rcldesign/ntp-server-stm32/docs/gnss_antenna_bias_supervisor.md

# GNSS Active-Antenna Feed, Current Limiter & Antenna Supervisor

**Design documentation — operation, control signals, and parameters**

| | |
|---|---|
| **Subsystem** | Active GNSS antenna feed (bias-T), current-limited supply, and antenna-fault supervisor |
| **Host receiver** | u-blox ZED-F9T-00B (multi-band timing receiver) |
| **Host MCU** | STM32H563ZIT6 (LQFP144, U12) |
| **Antenna rail** | 5 V, 150 mA maximum |
| **Logic domain** | 3V3_GPS (F9T VCC_IO); comparators powered from 5V_LDO |

---

## 1. Overview

This subsystem powers an active (LNA-equipped) GNSS antenna over the same coaxial line that carries the received RF, protects the system against antenna/cable faults, and reports antenna health to both the GNSS receiver and the host MCU.

It performs four functions on one signal path:

1. **RF/DC combining (bias-T):** delivers DC bias to the antenna while passing the received GNSS RF through to the receiver.
2. **Current-limited 5 V supply:** feeds the antenna LNA with a hard foldback current limit, protecting the rail and antenna against a short.
3. **Antenna supervision:** detects *open* (no antenna), *normal*, and *short* conditions and drives the ZED-F9T's antenna-supervisor inputs.
4. **Commanded shutdown:** allows the receiver (and, indirectly, firmware) to switch antenna power off.

The supervisor uses **two independent fault paths** for defense in depth: the analog supervisor described here drives the F9T's ANT_DETECT / ANT_SHORT_N pins (surfaced over UBX-MON-RF), while a separate antenna-rail INA228 read by the STM32 over I²C provides a precise, digital current measurement. Firmware fuses the two (§9).

---

## 2. System Block Diagram

```
                          GPS_RF_IN  ──►  ZED-F9T RF_IN (U21.2) + L10 ESD + J7 SMA
                              ▲
                              │  (RF received signal)
                             L1  47 nH  ← bias-T choke (DC pass / RF block); 47 nH intentional
                              │
   V_ANT ──FB4──┬──[ Q11 ]────┴───────────────►  node A ──► antenna (RF + 5 V DC)
   (5 V)        │   PNP pass        (antenna DC feed point / Q11 collector)
                ├──[ R77 ]───┐
                │   3.3 Ω    │  current-limit foldback:  Q12 (PNP) + R76
                │  (sense)   │
                │            └──► INA181 current sense ──► U25A ──► GPS_ANT_DETECT ──► F9T pin 4
                │                  (across R77)            comparator
                │
              node A ──► R80/R81 divider ──► U25B comparator ──► GPS_ANT_SHORT ──► F9T pin 6

   F9T ANT_OFF (pin 5) / GPS_ANT_OFF_MON ──► Q14 (NPN) ──► Q13 (PNP) ──► forces Q11 base to V_ANT (antenna off)
                                                  │
                                                  └──► observed by STM32 PD4 (EXTI4)
```

Two physical domains coexist on the line: a **DC path** (V_ANT → current limiter → node A → L1 → antenna) and an **RF path** (antenna → GPS_RF_IN → receiver). L1 and C52 separate them. There is **no series DC-block** between the bias node and `RF_IN` — see §3.1.

**RF-input ESD:** `GPS_RF_IN` at the SMA (J7) is protected by **L10 = PGB1010603MR** (PulseGuard polymer suppressor, Cj ≈ 0.05 pF, standoff ~20–24 V) to GND — the correct low-Cj / high-standoff class for a line carrying both 1.5 GHz RF (Cj ≤ ~0.3 pF) and 5 V DC bias (V_RWM ≥ ~6.5 V). Outdoor cable runs still need an external inline coaxial gas-discharge arrestor.

---

## 3. RF/DC Combining (Bias-T)

| Ref | Value | Function |
|-----|---|---|
| L1 | **47 nH (intentional)** | Bias-T choke. Passes DC bias to the antenna; presents high impedance to GNSS RF so the signal stays on the line to the receiver. |
| C52 | 1 µF | DC-feed-node bypass; provides an AC return so RF does not enter the bias network. |
| FB4 | 120 Ω @ 100 MHz | Conditions the incoming V_ANT rail (suppresses conducted noise). |
| C61 | 0.1 µF | V_ANT local decoupling. |

The choke is the only series element between the antenna DC feed (node A) and the receiver RF input. At the GPS L1 band (1.575 GHz) the choke presents:

```
Z(47 nH) = 2πfL ≈ 2π × 1.575e9 × 47e-9 ≈ 465 Ω   (as-built, intentional)
```

> **L1 = 47 nH.** At 465 Ω the choke passes the ≤182 mA foldback bias current (part rated
> ≥ 300 mA > 182 mA, with saturation margin) while the board relies on the active foldback
> limiter (§4) rather than a fixed series resistor for isolation. The 465 Ω isolation is an
> accepted deviation from the u-blox ">500 Ω" bias-T guideline for this design.

The choke's saturation rating must exceed the ~180 mA current limit, and its DCR adds only a fraction of a volt of drop at the limit current (this drop is downstream of node A, so it affects the voltage delivered to the antenna but not the supervisor thresholds).

### 3.1 No series DC-block on RF_IN — bias is injected directly, per the u-blox reference

The ~5 V antenna bias is injected by L1 straight onto `GPS_RF_IN`, which is the same node as the
ZED-F9T `RF_IN` (U21.2), the SMA centre (J7.1), and the L10 ESD suppressor. **There is no series
DC-block capacitor between the bias node and RF_IN, and none is required** — the u-blox ZED-F9T
active-antenna reference circuits (Integration Manual UBX-21040375) inject the bias on the RF trace
and rely on the receiver's **internal DC block**, including where the bias comes from an external
supply above VCC.

```
as-built:   node A ── L1 47 nH ──┬── J7 SMA (antenna, biased)
                                 ├── U21.2 RF_IN   (internal DC block)
                                 └── L10 ESD
```

> **History — a 47 pF part (`C204`) was briefly fitted here and has been removed.** It had been
> added on the strength of a claim, carried in this repo's own `CLAUDE.md` open-items list, that the
> u-blox reference "places a 47 pF C0G series DC-block between the bias-T node and RF_IN". **That
> attribution was wrong** — UBX-21040375 shows no such block, and this same section originally said
> the opposite (that u-blox injects directly and relies on the internal block). Worse, as drawn the
> part landed in the **bias** leg (`node A → L1 → C204 → GPS_RF_IN`), which would have DC-blocked the
> antenna itself and left the open/short supervisor reading permanent *open*. The part is deleted and
> the claim is retracted; do not re-introduce it.

---

## 4. Antenna Power Supply & Current Limiting

The antenna is fed from the 5 V rail through a high-side PNP pass transistor with a transistor-based foldback current limiter.

| Ref | Part | Value | Function |
|-----|---|---|---|
| Q11 | NSS40300MZ4T1G | PNP power | High-side pass element delivering 5 V to the antenna. V_CEO 40 V, I_C(max) 3 A, P_D(max) 2 W, V_CE(sat) ≤ 400 mV @ I_C = 3 A. |
| Q12 | BC857W | PNP | Current-limit sense transistor. |
| R77 | — | 3.3 Ω | Current-sense / limit resistor in series with the antenna current. |
| R76 | — | 220 Ω | Q12 base path. |
| R73 | — | 2.2 kΩ | Q11 base drive. |

### How the limit works

R77 carries the full antenna current and develops a voltage proportional to it. Q12's base–emitter junction sits across R77; when the current produces approximately one V_BE across R77, Q12 turns on, diverts Q11's base drive, and folds the pass current back to a fixed ceiling:

```
I_limit ≈ V_BE(Q12) / R77 ≈ 0.6 V / 3.3 Ω ≈ 180 mA
```

This is set ~20 % above the 150 mA antenna maximum, giving operating headroom while still clamping well below any level that would stress the rail or a shorted cable. **The limit point is defined solely by R77** — changing it requires re-checking the supervisor thresholds in §6 and §8, which reference the same resistor and feed node.

In normal operation Q11 stays in saturation, so the DC drop from V_ANT to the antenna is small (R77 + V_CE(sat) ≈ a few hundred mV at full load). At the ≤180 mA operating range Q11 runs far below its 3 A / 2 W ratings, so its actual V_CE(sat) is well under the 400 mV datasheet figure (specified at 3 A) and self-heating is negligible. On a short, the limiter holds the current at ~180 mA and Q11 comes out of saturation, collapsing the feed-node voltage — the signature the supervisor uses to flag a short (§6.2).

---

## 5. Antenna Supervisor — Detection Principle

The supervisor must distinguish three states: **open** (no antenna / no current), **normal**, and **short** (over-current). Because the supply uses an *active* foldback limiter rather than a large passive series resistor, the antenna feed-node voltage alone cannot separate open from normal:

- With Q11 saturated, the feed node (node A) sits near 5 V whether the antenna draws 0 mA (open) or only a few mA (light-normal).
- Therefore **open vs. present must be decided by measuring current**, while **short is decided by feed-node collapse**.

The supervisor is built as two independent legs accordingly:

| Leg | Senses | Drives | Decides |
|-----|---|---|---|
| DETECT | Antenna current via INA181 across R77 | GPS_ANT_DETECT (F9T pin 4, active-high = present) | Open vs. present |
| SHORT | Feed-node (node A) voltage via divider | GPS_ANT_SHORT (F9T pin 6, active-low = short) | Short vs. ok |

### State table

| Condition | I through R77 | Node A | INA181 out | GPS_ANT_DETECT | GPS_ANT_SHORT |
|---|---|---|---|---|---|
| **Open** | ~0 mA | ~5 V | ~0 V | **low** (absent) | high (ok) |
| **Normal** | 5–150 mA | 4.3–5 V | 0.33 V → rail | **high** (present) | high (ok) |
| **Short** | ~180 mA (clamped) | ~0 V | railed high | high (present) | **low** (short) |

In the short state the limiter holds ~180 mA, so the DETECT leg still reads "present." This is intentional and unambiguous: the SHORT leg's low output is the signal the receiver acts on, and open vs. short is fully captured by the SHORT leg.

---

## 6. Supervisor Circuit Detail

### 6.1 DETECT leg (current sense)

| Ref | Part | Value | Function |
|-----|---|---|---|
| U24 | INA181A1IDBVR | gain 20 | High-side current-sense amp across R77. V+ = 3V3_GPS; IN+ = V_ANT (upstream) side of R77; IN− = load side; REF = GND (unidirectional). |
| C28 | — | 0.1 µF | U24 decoupling. <!-- TODO verify designator: C28 — one of the three 3V3_GPS 0.1µF decouplers C54/C55/C56; flat netlist can't disambiguate role --> |
| U25A | ½ LMV393 | — | DETECT comparator: +in = U24 OUT, −in = reference. Open-collector output. |
| R85 / R86 | — | 100 k / 11 k | DETECT reference divider from 3V3_GPS → **0.327 V**. |
| C29 | — | 0.1 µF | Reference / supply decoupling. <!-- TODO verify designator: C29 — one of the three 3V3_GPS 0.1µF decouplers C54/C55/C56 --> |
| R87 | — | 10 kΩ | Open-collector pull-up to 3V3_GPS → GPS_ANT_DETECT. |

**Transfer function:** `V_out = gain × I × R77 = 20 × I × 3.3 = 66 V/A`.

- **Threshold:** 0.327 V ÷ 66 V/A ≈ **5 mA**. DETECT asserts (high) for any antenna drawing ≥ ~5 mA — above idle leakage, below any real active antenna's draw.
- **Linear range:** U24's output rails at ~3.0 V (≈ 45 mA); above this it simply stays high, which is fine because this leg only decides present/absent. Precision current is provided separately by the INA228 (§9).
- **Gain choice:** gain 20 (the INA181**A1**) keeps the threshold linear with margin; the gain-100 A3 variant would rail at ~9 mA, leaving no usable range.
- **Polarity:** present → U24 OUT > ref → output high-Z → R87 pulls to 3.3 V → DETECT high. Absent → output sinks → DETECT low. Matches the F9T (active-high = present).

### 6.2 SHORT leg (feed-node collapse)

| Ref | Part | Value | Function |
|-----|---|---|---|
| U25B | ½ LMV393 | — | SHORT comparator: +in = node A ÷ 2, −in = reference. Open-collector output. |
| R80 / R81 | — | 100 k / 100 k | Node-A divider → node A ÷ 2 (draws ~25 µA — negligible vs. antenna current). |
| R82 / R83 | — | 100 k / 30 k | SHORT reference divider from 3V3_GPS → **0.762 V**. |
| C30 | — | 0.1 µF | Reference / supply decoupling. <!-- TODO verify designator: C30 — one of the three 3V3_GPS 0.1µF decouplers C54/C55/C56 --> |
| R84 | — | 10 kΩ | Open-collector pull-up to 3V3_GPS → GPS_ANT_SHORT. |

**Threshold:** node A ÷ 2 is compared to 0.762 V, so SHORT asserts when **node A < ~1.52 V**. Normal node A is 4.3–5 V (÷2 = 2.1–2.5 V, above ref → released); a short pulls node A to ~0 V → asserted.

**Polarity:** +in = node A ÷ 2, −in = ref. Normal → +in > ref → high-Z → SHORT_N high (ok). Short → +in < ref → output sinks → SHORT_N low (fault). Matches the F9T (active-low = short).

### 6.3 Comparator supply & level shifting

| Ref | Part | Value | Function |
|-----|---|---|---|
| U25C | LMV393 (power-pin unit of the dual) | — | V+ = 5V_LDO, V− = GND. |
| C31 | — | 0.1 µF | LMV393 supply decoupling. <!-- TODO verify designator: C31 — one of the two 5V (U25C V+) 0.1µF decouplers C57/C58 --> |

The LMV393 is powered from **+5 V** (not 3.3 V) so its input common-mode range (0 to V+ − 1.5 V ≈ 0–3.5 V) spans every supervisor input: U24 OUT (0–3.0 V), node A ÷ 2 (0–2.5 V), and both references (≤0.76 V).

Both comparator outputs are **open-collector, pulled up to 3V3_GPS**. This pull-up is the level shift from the 5 V analog domain to the F9T 3.3 V logic domain. It is also inherently fail-safe: when 3V3_GPS is off, the lines are simply undriven, so the F9T's input pins are never back-driven from the 5 V side. This follows u-blox's guidance to use open-drain buffering whenever the antenna voltage (5 V) exceeds the receiver IO voltage (3.3 V).

---

## 7. Antenna-Disable Control (ANT_OFF)

The F9T's ANT_OFF pin (5) is an **output that goes high to command the antenna off**. Disabling a high-side PNP requires pulling Q11's base **up to V_ANT** (its emitter), so a two-stage inverting/high-side driver is used.

| Ref | Part | Value/role | Connection |
|-----|---|---|---|
| Q14 | BC847W (NPN) | Level shift / invert | E→GND; B← ANT_OFF via R79; C→ Q13 base via R75. |
| Q13 | BC857W (PNP) | High-side disable switch | E→V_ANT; C→ Q11 base node (where R73 lands); B← R75 and R74. |

> **Q13 orientation** (BC857W, SOT-323: 1=B, 2=E, 3=C): `Q13.2(E) → V_ANT`,
> `Q13.3(C) → Net-(Q11-B)`. On `ANT_OFF` high, Q14 pulls Q13's base low via R75 → the PNP
> (E = V_ANT) turns on → its collector sources into Q11's base, raising it to ~V_ANT → pass
> PNP Q11 turns off → antenna bias removed. Bench-verify: on assert of ANT_OFF, scope node A
> and confirm it collapses to ~0 V.
| R79 | 10 kΩ | ANT_OFF → Q14 base. |
| R75 | 4.7 kΩ | Q14 collector → Q13 base (drive limit). |
| R74 | 10 kΩ | Q13 base → V_ANT (holds Q13 off when Q14 is off). |
| R78 | 100 kΩ | Q14 base → GND — sets the default state when the ANT_OFF line is undriven (see below). |

**Behavior:**

- ANT_OFF **high** → Q14 on → Q13 base pulled low (~0.8 mA via R74) → Q13 on → Q11 base tied to V_ANT → **Q11 off, antenna unpowered.**
- ANT_OFF **low** → Q14 off → Q13 off (held by R74) → **Q11 runs normally.** Q13 easily overrides R73's 2.2 kΩ to hold Q11 off when commanded.
- ANT_OFF **undriven** (F9T unpowered / pin hi-Z) → R78 holds Q14 off → Q13 off → **antenna defaults on.** This matters because V_ANT can remain up while the F9T is power-cycled; defaulting the antenna *on* preserves a fast warm restart. (To default *off* instead, R78 would pull high — but that rail is also down during an F9T cycle, so the GND default is the practical choice.)

Because the only connection to the F9T pin is Q14's base through R79, the 5 V rail never reaches the receiver pin.

**Shared monitoring net:** the ANT_OFF line is also the `GPS_ANT_OFF_MON` net observed by the STM32 on **PD4 (EXTI4)**, letting firmware see when the antenna has been commanded off. PD4 is configured **input-only** (the F9T drives this net push-pull; an output on PD4 would contend with it).

---

## 8. Control & Status Signals + Operating Parameters

### 8.1 Signal interface

| Net | Direction | Domain | Meaning |
|-----|---|---|---|
| GPS_ANT_DETECT → F9T pin 4 | supervisor → F9T | 3.3 V, open-collector + pull-up | High = antenna present (I ≥ ~5 mA). |
| GPS_ANT_SHORT → F9T pin 6 | supervisor → F9T | 3.3 V, open-collector + pull-up | Low = antenna short (node A < ~1.5 V). |
| ANT_OFF / GPS_ANT_OFF_MON ← F9T pin 5 | F9T → supervisor; also → MCU PD4 | 3.3 V push-pull | High = command antenna off. |
| V_ANT | rail input | 5 V | Antenna supply rail. |
| GPS_RF_IN | RF | — | Combined RF to receiver. |

### 8.2 Operating parameters

| Parameter | Value | Set/limited by |
|---|---|---|
| Antenna supply voltage | 5 V | V_ANT rail |
| Antenna operating current (max) | 150 mA | Antenna spec |
| Current limit (foldback) | ~180 mA | R77 (3.3 Ω) + Q12 V_BE |
| DETECT (antenna-present) threshold | ~5 mA | R85/R86 → 0.327 V, ÷ 66 V/A |
| SHORT threshold | node A < ~1.5 V | R80/R81 ÷2 vs. R82/R83 → 0.762 V |
| Current-sense linear ceiling | ~45 mA | INA181A1 gain 20 on 3.3 V (present/absent only) |
| Bias-T choke impedance @ 1.575 GHz | ~465 Ω | L1 = 47 nH (intentional) |
| Supervisor logic level | 3.3 V | 3V3_GPS pull-ups |
| Comparator supply | 5 V | 5V_LDO |

Tolerance: the dividers are 1 % resistors feeding an LMV393 (few-mV offset) and an INA181A1 (low offset, ~±1 % gain error). The DETECT threshold (5 mA) has wide margin against any real antenna (≥ ~10 mA); the SHORT threshold (1.5 V) sits far from both normal (≥ 4.3 V) and fault (~0 V), so hysteresis is not required for clean switching.

---

## 9. ZED-F9T & STM32 Integration

### 9.1 Pin map

| F9T pin | Signal | Dir (F9T) | Net |
|---|---|---|-----|
| 4 | ANT_DETECT | input | GPS_ANT_DETECT (U25A) |
| 5 | ANT_OFF | output | ANT_OFF / GPS_ANT_OFF_MON |
| 6 | ANT_SHORT_N | input | GPS_ANT_SHORT (U25B) |

| STM32 pin | Net | Role |
|---|-----|---|
| PD4 (EXTI4) | GPS_ANT_OFF_MON | Observes LNA-disable / commanded-off state. Input-only. |
| PC9 | ANT_BIAS_EN | Antenna-bias enable (→ U27 RT9742 EN); dropped on persistent short. |
| PC8 | GPS_PWR_EN | Gates F9T VCC (→ U22 LT3045 EN). |
| PF15 | BKP_GPS_PG | Power-good of the GPS backup rail `GPS_VBAT` (U34 TPS61094 + supercap, feeds F9T V_BCKP). |
| I²C1 (PB8/PB9) | — | Antenna-rail INA228 **U26 @0x45** (precision V/I/P across **R89 150 mΩ**; ±273.1 mA FS, 520.833 nA/LSB). |

> **INA228 addresses:** the *antenna-bias* rail is monitored by **U26 @0x45** (precise
> antenna current, **R89 150 mΩ** shunt — the 182 mA foldback ceiling lands at 27.3 mV = 67 % of the
> ±40.96 mV ADCRANGE=1 full scale). The *GPS VCC* rail (3V3_GPS) is a **separate** INA228,
> **U23 @0x4A** (shunt across **R72 75 mΩ**). U23 is strapped 0x4A because **0x44 is owned by the
> SHT45 humidity sensor (U72)** on the same I²C1 bus; 0x4A avoids that collision.

### 9.2 Antenna-state fusion

Firmware determines antenna state by fusing three independent sources:

1. **UBX-MON-RF** from the F9T (driven by the analog supervisor in this document).
2. **GPS_ANT_OFF_MON (PD4)** — whether the antenna is currently commanded off.
3. **Antenna-rail INA228 U26 (0x45)** over I²C — precise current (**R89 150 mΩ**, 520.833 nA/LSB → ~0.3 % resolution at the 182 mA ceiling) → OK / open / short. Because the R77 foldback clamps at ≈182 mA *before* an over-current alert would be meaningful, use an INA228 **under**-current (`SUVL`) threshold to detect "open" and reserve `SOVL` (227 mA) as a foldback-failure backstop.

On a **persistent** short, firmware drops `ANT_BIAS_EN (PC9)` and raises an alarm (SNMP trap, log entry, GUI indication). The redundancy ensures a single-source transient does not by itself trigger a shutdown, and gives the operator a precise current reading for diagnostics.

### 9.3 Commanded-off fault masking (firmware requirement)

When ANT_OFF is asserted (by the F9T or by firmware via ANT_BIAS_EN), Q11 turns off, node A collapses, and antenna current goes to zero — so **the analog supervisor reports SHORT (low) and DETECT (absent) even though nothing is faulty.** The F9T masks its own internal flags while it holds ANT_OFF; the firmware fusion logic must likewise **gate the SHORT/OPEN flags on the commanded-off state (PD4 / ANT_BIAS_EN)** to avoid logging phantom shorts on every commanded antenna cycle.

### 9.4 Backup-domain interaction

V_BCKP (F9T pin 36) stays powered across GPS VCC power-cycles for warm start. V_ANT is on the STM32-gated antenna rail, independent of the F9T VCC switch, so the antenna can remain powered while the F9T is cycled — which is why the ANT_OFF stage defaults the antenna *on* when the receiver pin is undriven (§7).

---

## 10. Design Rationale & Constraints

**Why an active foldback limiter (Q12/Q11) rather than a passive series resistor.** Lower dropout and a well-defined current limit independent of antenna impedance. The trade-off is that the feed-node voltage no longer separates open from normal, which is why the DETECT decision is made by current sensing (§5).

**Why split detection (current for open, feed-node for short).** Each fault has a clean, well-separated signature in exactly one domain. A single window comparator on the feed node would fail to detect open, and a single current threshold cannot cleanly distinguish high-normal from the clamped short current.

**Why INA181A1 (gain 20).** It keeps the present/absent threshold in the amplifier's linear range with margin; the precise current measurement is delegated to the INA228, so this leg needs only coarse presence detection.

**Why open-collector outputs to 3.3 V.** A single-resistor level shift from the 5 V analog domain to F9T logic, inherently fail-safe (lines undriven when receiver IO is off), and aligned with u-blox's open-drain recommendation for antenna voltage > IO voltage.

**Why the LMV393 runs on 5 V.** To give input common-mode headroom across all supervisor signals; the open-collector outputs still serve the 3.3 V logic domain cleanly.

**Why a discrete ANT_OFF stage (BC847W + BC857W).** Keeps the F9T pin isolated from the 5 V rail, uses a small-signal transistor pair common across the board, and sets a defined default state with one resistor (R78).

**Why dual-path supervision (analog + INA228).** Defense in depth — no single glitch trips a shutdown — plus a precise digital current value for telemetry and diagnostics.

**Why the GPS-VCC INA228 (U23) is at 0x4A, not 0x44.** The SHT45 humidity sensor (U72)
occupies 0x44 on the same I²C1 bus; 0x4A keeps the GPS-VCC monitor collision-free.

### Engineering constraints to honor at layout/BOM

- **R77** dissipates ~130 mW at the ~180 mA limit; specify 0805, 1 %, ≥0.25 W.
- **INA181 input orientation** is critical: IN+ on the V_ANT/FB4 (upstream) side of R77, IN− on the load side, current flowing + → −. With REF = GND the device is unidirectional, so reversed inputs read zero.
- **PD4** must remain input-only in firmware (shared with the F9T's push-pull ANT_OFF driver).
- If a real short produces a slow node-A collapse, light hysteresis (a few-MΩ feedback resistor on U25B) can be added; with the limiter's fast action this is normally unnecessary.

---

## 11. Bill of Materials

**Bias-T & RF/DC combining**

| Ref | Part | Value |
|-----|---|---|
| L1 | RF choke | **47 nH (intentional — see §3); rated ≥ 300 mA > 182 mA foldback** |
| C52 | capacitor | 1 µF |
| FB4 | ferrite bead | 120 Ω @ 100 MHz |
| C61 | capacitor | 0.1 µF |
| L10 | PGB1010603MR | PulseGuard polymer ESD suppressor on `GPS_RF_IN` at J7 (low-Cj, high-standoff) |

**Antenna supply & current limit**

| Ref | Part | Value |
|-----|---|---|
| Q11 | NSS40300MZ4T1G | PNP power pass transistor (40 V, 3 A, 2 W) |
| Q12 | BC857W | PNP sense transistor |
| R77 | resistor | 3.3 Ω, 1 %, ≥0.25 W (0805) |
| R76 | resistor | 220 Ω |
| R73 | resistor | 2.2 kΩ |

**Supervisor**

| Ref | Part | Value |
|-----|---|---|
| U24 | INA181A1IDBVR | gain 20 current-sense amp |
| U25 | LMV393 | dual comparator (U25A DETECT, U25B SHORT, U25C power) |
| R85 / R86 | resistors | 100 k / 11 k (DETECT ref, 0.33 V) |
| R80 / R81 | resistors | 100 k / 100 k (node-A ÷2) |
| R82 / R83 | resistors | 100 k / 30 k (SHORT ref, 0.76 V) |
| R84 | resistor | 10 k (SHORT pull-up → 3V3_GPS) |
| R87 | resistor | 10 k (DETECT pull-up → 3V3_GPS) |
| C28–C31 | capacitors | 0.1 µF (decoupling) <!-- TODO verify designator: C28-C31 — bank is C54/C55/C56 on 3V3_GPS + C57/C58 on 5V (U25C V+); exact role-to-ref mapping not resolvable from flat netlist --> |

**Precision current monitoring (I²C)**

| Ref | Part | Value / note |
|-----|---|---|
| U26 | INA228 | Antenna-bias current/voltage monitor, **I²C1 @0x45**; shunt = R89. |
| R89 | resistor | **150 mΩ** antenna-current shunt, Vishay WSL1206R1500FEA 1 % 1206 (U26 IN+/IN−; **±273.1 mA FS**, 520.833 nA/LSB, 5.0 mW at foldback). |
| U23 | INA228 | GPS-VCC (3V3_GPS) monitor, **I²C1 @0x4A** (not 0x44 — SHT45 U72 owns 0x44); shunt = **R72 75 mΩ** (WSL1206R0750FEA), ±546.1 mA FS. |

**ANT_OFF disable stage**

| Ref | Part | Value |
|-----|---|---|
| Q14 | BC847W | NPN |
| Q13 | BC857W | PNP high-side disable (E=V_ANT, C=Q11 base node; see §7) |
| R79 | resistor | 10 k (ANT_OFF → Q14 base) |
| R75 | resistor | 4.7 k (Q14 collector → Q13 base) |
| R74 | resistor | 10 k (Q13 base → V_ANT) |
| R78 | resistor | 100 k (Q14 base → GND, default state) |
