rcldesign/ntp-server-stm32/docs/sts1000_layout_readiness_review.md

# STS1000 "Meridian" — Schematic-to-Layout Readiness Review

> ⚠️ **HISTORICAL SNAPSHOT (2026-06-21) — largely superseded.** This review predates the
> **STM32H563VIT6/LQFP100 → STM32H563ZIT6/LQFP144** migration, the 2026-07-05 overhaul, and the
> 2026-07-26 BOM/value pass. References here to U12 as VIT6/LQFP100, the MCP23017 expanders, GPS
> INA228 @0x44, 8× INA228, the board-wide INA228 SDA/SCL swap, and the BOOT0 1:1 divider describe
> the **June state** and are retained as a point-in-time record. **Do not "fix docs" against this
> file.**
>
> **Status of the 68 original blockers as of 2026-07-26:**
> - **RESOLVED:** board-wide INA228 SDA/SCL swap; U37/U44 address collision; BOOT0 (now a single
>   R50 10 k pull-down, no divider); GPS INA228 re-strapped to 0x4A; MCP23017 expanders deleted
>   (all aggregated inputs on direct GPIO); the ninth INA228 (U54, panel-LED @0x4C) added; **all
>   nine INA228 shunt values finalized**; every BOM line now carries an orderable manufacturer PN
>   *and* a DigiKey PN; capacitor package/dielectric selects closed (C98/C99/C101/C37 → C0G 1210,
>   C1/C42/C186 → 1812 2 kV, C125–C128 → 50 V); `3V0_RF_LDO_PG` pull-up R266 fitted; **footprints
>   *fields* populated board-wide — but with vendor package text, not land-pattern links (see below)**.
> - **STILL OPEN:** **`fp-lib-table` is missing** from the KiCad project (custom footprints in
>   `hardware/libraries/` are unreachable from the board editor — this still blocks opening the
>   PCB); and the **Footprint property is not a land-pattern link on most parts** — only 25 of 648
>   symbols carry a resolvable `library:footprint`, 587 hold vendor package text, 36 are empty.
> - **NEW since this review:** GPS RF DC-block **C204 is on the wrong side** (bias leg instead of
>   receiver leg); **R77** 0402/0.1 W dissipates 109 mW at the antenna foldback clamp; **R20/R2/R264**
>   0402 parts see 51–55 V against a 50 V element rating.
>
> For the current defect list see **`sts1000_schematic_design_review.md §1`**; for the current
> pin/net facts see **`ntp_server_peripheral_map.md`** and **`sts1000_firmware_hardware_interface.md`**;
> for shunt sizing and firmware constants see **`sts1000_hardware_design_reference.md §2.1`**.

_Multi-agent review. Goal: readiness for PCB layout handoff — NOT fabrication. Verify findings against datasheets/files before acting._

> Generated by 20 per-sheet agents + 5 cross-cutting agents. Confidence levels are per-finding; treat Low/Unknown items as requiring human confirmation.

## 1–2. Design intent & project inventory

## STS1000 "Meridian" — Design-Intent Summary & Project Inventory (pre-layout readiness, board-level)

Scope: whole-board design intent extracted from `/docs` + root/hardware `CLAUDE.md`, cross-checked against the KiCad project files present on disk. This is the orientation block for per-block reviews; it is NOT itself a netlist/datasheet verification of any part. Designators below are as the docs assign them; several still carry `<!-- TODO verify designator -->` markers in the docs (flagged).

---

### 1) Design-intent table

| Area | Intended behavior / requirement | Source doc | Evidence | Related blocks/nets | Status |
|---|---|---|---|---|---|
| Product purpose | GPS-disciplined Stratum-1 NTP/NTS/PTP grandmaster, single-board, PoE-powered | root `CLAUDE.md`; `software_spec §1` | "GPS-disciplined Stratum-1 NTP/NTS/PTP grandmaster clock" | whole board | PASS (intent) |
| Operating modes | Boot on OCXO (mux A); switch to Rb (mux B) only when EXTREF_MON in-band AND RB_LOCK asserted; revert fail-safe; holdover; warm-up gating before advertising S1 | `periph §2.1, §15.5`; `software_spec §3.4/§3.5` | "Switch OCXO→Rb only when both #2 and #3 hold"; firmware HSI-bridge + CSS | MUX_SEL PB6, EXTREF_MON PB14, RB_LOCK PB13, OSC_IN PH0 | PASS (intent) |
| Power input — PoE bt | 802.3bt-capable front end; classify Type 2 (at, ~25.5 W) min, Type 3 (bt) for margin; Rb is permanent and concurrent | `periph §6`; `hardware CLAUDE.md` | OCXO+Rb steady ~12–14 W, peak ~25–30 W; Class 3 (~13 W) insufficient | U7/U8 FDMQ8205A, U9 NCP1095, magjack J1 | PASS (intent); classification = config open item |
| Power rails | 3V3 main + 5V intermediate from bucks; OCXO fixed low-noise rail (always on); Rb adjustable buck (5–24 V, EN-gated); 5V_DISP gated; all housekeeping on always-on 3V3_STM (gated 3V3_P eliminated) | `periph §6`; `net_naming` | rename table; "3V3_P rail was removed" | U28/U29, U38/U39, U40A, U33, all I²C devices | PASS (intent) |
| Comms interfaces | Ethernet RMII (AF11) + 1588 HW timestamp; USART3 GPS; UART4 RTCM; UART7 Rb; SPI4 (NOR+TFT+digipot); I²C1 housekeeping; USB-FS CDC console | `periph §1,§3,§5,§10`; `software_spec §2` | pin tables per bus | U11, U21, U43/U62/TFT, I²C bus | PASS (intent) |
| Connectors | RJ45 magjack (J1), USB-FS (J5), DE-9 FE-5680A housekeeping (J6), 3× coax SMA (J7/J8/J9: 10 MHz-in, GPS-ant, 10 MHz bench-out), pin headers J2/J3/J4/J10/J11 | `bom §J`; BOM CSV L214–224 | CSV: J1 Bel 0826-1X1T, J5 USB4120-03-C, J6 DE9, J7/8/9 Conn_Coaxial | connectors.kicad_sch | WARNING — J2/J4/J7/8/9/J10/J11 footprints still generic/SELECT |
| Sensors | 8× INA228, 2× TMP117, IIS2MDC + LIS2DH12 e-compass, PIR (PaPIRs), FT6336U touch, fan tach | `periph §4,§8`; checklist §11–13 | INA map; e-compass note | I²C1 bus, U54/U55 | PASS (intent); LIS2DH12 SA0, PIR PN open |
| Timing ref — OCXO | OH300-61003CV-010.0M, 10 MHz, always on, DAC1_OUT1 (PA4)→loop filter→Vc center 1.65 V, Vc sense PA3; Vc caps C0G/film never X7R | `periph §2`; checklist §2 | "Vc must be biased to ~1.65 V"; "C0G/NP0 or film — never X7R" | Y3, U38/U39, R123 22Ω, U37 INA228#5 | PASS (intent) |
| Timing ref — Rb | External FE-5680A only (no onboard Rb); 10 MHz over coax→SMA front end; power/serial/lock/PPS on DE-9; adjustable buck, RB_PWR_EN gate | `periph §2.2,§15`; `vcc_rb_supply` | "There is no onboard Rb option"; "10 MHz does NOT enter this connector" | U40A, U43, U41A OV latch, J6, J7 SMA | PASS (intent); FE-5680A variant pinout open |
| Timing ref — GNSS | ZED-F9T-00B, USART3, TIMEPULSE→PA0/TIM2, TIMEPULSE2→PC6/TIM3, full reset/safeboot/dsel; V_BCKP held through VCC cycles | `periph §3`; checklist §6 | F9T pin table | U21, U22 LDO, U23 INA228#3 | PASS (intent) |
| Isolation / safety | Autonomous 26 V Rb OV latch (LMV393 + BJT, MCU-independent); POE_KILL board cold-cycle; external windowed WDT→POE_KILL; digital isolator on PoE status only-if isolated PD (open) | `periph §6,§9`; `vcc_rb_supply`; `external_wdt` | "trips at 26 V…no MCU action"; WDT→POE_KILL | U41A, U64 TPS3430, PE15 | PASS (intent); NCL/NCM/LCF isolation open |
| Environmental | −40/+85 °C MCU; consumer −40/+85 parts checked vs enclosure thermal; supercap ≤~75 °C placement; fan thermal loop fail-safe to full speed | root `CLAUDE.md`; `periph §8`; checklist §10 | "floating FAN_PWM defaults to maximum airflow" | DSF305Q3R0, TMP117 ×2, fan | PASS (intent); LIS2DH12/supercap thermal = layout-verify |
| Debug / programming / secure boot | SWD (PA13/14/PB3) + NRST; USB CDC-ACM driverless console + SMP recovery; STiRoT→MCUboot→app; ATECC608B (0x60) for keys/NTS | `periph §10`; `software_spec §1.1` | "STiRoT (immutable ST root)…ATECC608B" | U12, U60, J5 USB | PASS (intent) |
| Mechanical | Single board, enclosure deploy ("Observatory at Williams Manor"); e-compass at board edge/external puck; vertical display mount | root `CLAUDE.md`; `periph §4 note` | e-compass keep-out + mount note | IIS2MDC, MSP4030 | UNKNOWN — no mechanical/enclosure doc in /docs |
| Layout-sensitive circuits | OCXO Vc path, Rb FB node, IIS2MDC GND pour, GPS SMA ESD (RF+bias), source termination at driver, RF island | `hardware CLAUDE.md §Layout-critical` | full rule list | see §3 below | PASS (rules captured); execution = layout |
| Expected connector pinouts | FE-5680A DE-9 (J6) power/serial/lock/PPS only — varies by surplus variant, verify before layout; SMA = 10 MHz only | `periph §2.2,§14`; checklist §14 | "FE-5680A connector pinouts vary by variant" | J6, J7 | WARNING — variant pinout unresolved |
| Test points | ETH_PPS_OUT (PB5) scope tap; 10 MHz bench fanout SMA (J9); USB console | `periph §1,§2.1,§8`; checklist §16 | "PTP pulse output — verification/scope tap" | PB5, U53, J9 | PASS (intent) |
| Known risks | Back-power via I²C ESD clamps (fixed by 3V3_STM), glitch-free mux hang on dead Rb (fixed by selector+HSI bridge), Rb digipot in FB node, GPS SMA dual-duty ESD | root `CLAUDE.md §gotchas` | enumerated gotchas | I²C bus, U52, U43, GPS SMA | PASS (documented) |

---

### 2) Project inventory

#### ICs by subsystem (per checklist + hardware CLAUDE.md; designators as-doc, some TODO-flagged)

| Subsystem | Designators / parts |
|---|---|
| MCU & core | U12 STM32H563VIT6 (LQFP100); U64 TPS3430 window WDT; U13 LT3045 VDDA LDO; U14 MCP1502-33 ref; Y2 32.768 kHz LSE |
| OCXO + supply | Y3 OH300-61003CV-010.0M; U38 AP3441 buck; U39 TPS7A52 LDO; U36 OPA320 Vc buf; U37 INA228 #5 (0x46) |
| Clock mux | U52 74LVC1G157GW-Q100H; U53 74LVC1G34GW-Q100 buffer |
| RF front end | U49 TMUX1101; U50 LTC6752xS5 slicer; U51 LT3045 (3.0 V island) |
| Rb buck (VCC_RB) | U40A MIC28516; U43 MCP41U83T-503E/ST digipot; U42 OPA320; U45 MCP1502-40 (4.096 V); U41A LMV393 OV latch; U44 INA228 #6 (0x47) |
| FE-5680A serial | U46 SN65C3221E; K1 G6K-2F-Y DC3 relay; U48 APC-817C1 opto; U47 PESD15VL2BT |
| GNSS | U21 ZED-F9T-00B; U22 LT3045 GPS LDO; U23 INA228 #3 (0x44) |
| Antenna bias/supervisor | U24 INA181A1; U25 LMV393; Q11/Q12/Q14; U26 INA228 #4 (0x45) |
| Ethernet / PTP | U11 LAN8742AI-CZ-TR; Y1 25 MHz xtal; J1 magjack |
| PoE + power tree | U7/U8 FDMQ8205A bridge; U9 NCP1095 PD; U28 MIC28516 / U29 AP3441 (3V3); U10 INA228 #1 (0x40); U31 #2 (0x41); U30 #8 (0x43) |
| Supercap backup | U34/U35 TPS61094 ×2; DSF305Q3R0 supercaps |
| I²C housekeeping | U56 LTC4311ISC6; U57/U58 TMP117 ×2 (0x48/0x49); U60 ATECC608B (0x60); U61 IIS2MDC (0x1E); U59 LIS2DH12 (0x18/0x19) |
| Fault/UI aggregation | U55 MCP23017 (0x20, MIRROR=1); U54 MCP23017 (0x21, MIRROR=0) |
| Display/touch | LCDwiki MSP4030 (ST7796S + FT6336U 0x38); U33 RT9742; U63 PCA9306; U32 INA228 #7 (0x42); ESD: TPD4E05U06DQAR (U17/U18), TPD4E02B04 (U15/U16/U19/U20) |
| SPI4 | U62 SPI NOR (Macronix/Winbond/ISSI — NOT GigaDevice); ST7796 TFT; U43 digipot |

#### Connectors (BOM CSV L214–224)
J1 RJ45 PoE magjack (Bel 0826-1X1T-HS-F); J2 1×4 hdr (SELECT); J3 1×6 hdr (GCT BG055); J4 1×14 hdr (SELECT); J5 USB-FS (GCT USB4120-03-C); J6 DE-9 socket FE-5680A housekeeping (SELECT); J7/J8/J9 coaxial SMA — 10 MHz-in / GPS-ant / 10 MHz bench-out (SELECT); J10 1×2 (SELECT); J11 1×8 (SELECT).

#### Power rails (net_naming + periph §6)
3V3, 3V3_STM (always-on housekeeping), 3V3_STM_USB, 3V3_CLK, 3V3_GPS, 3V3_LAN, 3V0_RF (island), 5V (intermediate), 5V_DISP (gated, RT9742), VCC_RB (adjustable 5–24 V), V_ANT, V_POE, VDDA, VREF_4V096, GPS_VBAT, STM_VBAT, OCXO_V/OCXO_VC. Eliminated: 3V3_P.

#### Interfaces
RMII (AF11) + 1588; USART3 (GPS); UART4 (RTCM); UART7 (Rb, PB4/PE7); SPI4 (PE11–14 + PD2/PE9/PE10 CS/RST); I²C1 (PB8/PB9, 400 kHz, LTC4311); USB-FS CDC-ACM; SWD/SWO.

#### Critical nets
OSC_IN (PH0), OCXO_VC (PA4 DAC/PA3 sense), MUX_SEL (PB6), EXTREF_MON (PB14), RB_LOCK (PB13), RB_PWR_EN (PB7), GPS PPS (PA0/TIM2), TIMEPULSE2 (PC6/TIM3), ETH_PPS_OUT (PB5), INA_ALERT_INT_N (PC12), PG_INT_N (PA10), BTN_INT_N (PE0), EXP_RST_N (PC0), POE_KILL (PE15), RB_OV_DET (PE3)/RB_OV_RESET (PD3), 10MHz_RF_IN/RF_OUT.

#### Custom symbols (`hardware/libraries/*.kicad_sym`)
STM32H563VIT6, ZED-F9T-00B, LAN8742AI-CZ-TR, 74LVC1G157GW-Q100H, INA228AQDGSRQ1, INA181A1/A3IDBVR, IIS2MDCTR, LIS2DH12TR, LTC4311ISC6, OPA320AIDBVT, PCA9306DCTT, SN65C3221EPWR, TPD4E02B04DQAR, TPD4E05U06DQAR, TPS61094DSSR, TPS7A5201QRGRRQ1, AD5270/AD5292 (digipots — note doc says MCP41U83), ADCLK925BCPZ, ARJ-199, PGB1010603MR (new, untracked), ntp-server-stm32 (project sym).

#### Custom footprints (`hardware/libraries/*.kicad_mod`)
LQFP-100_STM, MODULE_ZED-F9T-00B, LGA-12_STM family (e-compass), QFN50P400X400X100-25N, VSSOP10_DGS_TEX (INA228), SC-74/SOT-6/DBV/DCT8/DQA0010A (small logic/ESD), CP_16_3_ADI / RM_10_ADI / RU-14_ADI (digipot/ADI), RGR20_TEX, SON50P/SOP65P, GCT_USB4120-03-C, ABRACON_ARJ-199, IND_PGB_0603_LTF family (new, untracked).

#### /docs files
ntp_server_peripheral_map.md (authoritative), ntp_server_software_spec.md (authoritative), sts1000_schematic_implementation_checklist.md, sts1000_net_naming.md, sts1000_bom.md, sts1000_clock_mux.md, ntp_server_rf_frontend.md, gnss_antenna_bias_supervisor.md, sts1000_vcc_rb_supply.md, rb_rs232_interface.md, sts1000_fault_aggregation.md, sts1000_3v3p_i2c_peripherals.md, sts1000_external_wdt.md, sts1000_poe_kill.md, sts1000_power_fail_input.md, sts1000_panel_switch_inputs.md, sts1000_panel_ui_inputs_esd.md, sts1000_rgb_indicator.md, usb_console_interface.md, sts1000_schematic_design_review.md, sts1000_product_page.html.

#### KiCad schematic sheets (21)
ntp-server-stm32 (root), stm32, ocxo, clock-mux, refclock-input, rb, rb-io, gps, gps-antenna, ethernet-input, ethernet-phy, PoE, 3v3-main-power, batt-supplies, i2c-buffer, i2c-gpio, i2c-peripherals, spi-peripherals, led, wdt, connectors.

---

### 3) Top layout-readiness risks (board-level)

1. **OCXO Vc / loop-filter path** — phase-noise-critical; Vc caps must be C0G/NP0 or film (X7R microphonics FM the carrier), keep DAC/digital noise off the high-impedance Vc node, R123 22 Ω source term at the OCXO output only. Highest single timing-quality risk.
2. **Rb adjustable-buck FB node (VCC_RB)** — digipot wiper/SPI noise on a high-Z FB node can destabilize/over-volt a multi-thousand-dollar Rb; fixed bounding resistors (not the digipot) must set absolute min/max for every wiper code incl. POR/mid-scale/SPI-fault; autonomous 26 V OV latch placement near the buck output. Highest part-damage risk.
3. **IIS2MDC e-compass placement/return path** — needs continuous current-free GND pour, max distance from Rb physics package / OCXO oven / bucks / PoE magnetics / fan motor / DC-rail currents (board edge or external puck). Likely the hardest placement constraint to satisfy on a dense single board.
4. **GPS SMA ESD/surge** — single coax carries 1.5 GHz RF (needs Cj ≤ 0.2–0.3 pF) AND 5 V antenna bias (needs V_RWM ≥ ~6.5 V); requires polymer suppressor + separate coaxial GDT for outdoor run. No single standard ESD part meets both.
5. **PoE / high-voltage power section** — FDMQ8205A bridge, NCP1095, MIC28516 bucks, VOUT_N primary return with HV caps (REVIEW-HV), 25–30 W peak; creepage/clearance, thermal copper, and shunt-current width must be sized before layout. INA228 shunt values still TBD per rail.
6. **RF island (3V0_RF) + clock-mux/fanout integrity** — controlled-impedance 10 MHz routing, island partition for U50 LTC6752xS5 slicer + U51 LDO, 50 Ω term switching (U49), source-match at U53 fanout; keep the ext-ref path isolated from RMII 50 MHz domain.
7. **Supercap thermal derating** — DSF305Q3R0 must sit ≤ ~75 °C (2.55 V peak at 2.5 V/85 °C rating); placement away from Rb/OCXO/buck heat.

#### Notable doc-vs-state mismatches to resolve before per-block review (not yet datasheet-verified here)
- **Digipot identity:** docs specify MCP41U83T-503E/ST (U43), but custom libs contain AD5270/AD5292 symbols and ADI footprints (CP_16/RM_10/RU-14) — confirm which symbol U43 actually uses.
- **Software spec §2.1/§2.2 is STALE vs peripheral map §2.2/§13:** it still lists `REF_SRC_SEL (PA10)` and `REF_SLICER_SEL (PC0)` and a DB9 clock source, all of which the pin map says were deleted (PA10→PG_INT_N, PC0→EXP_RST_N). Software spec also lists V_BCKP backup on PD2/PD3 — now SPI_DPOT_CS / RB_OV_RESET. Authority rule: pin map wins; software_spec needs propagation.
- **Standing KiCad actions unverified:** drop legacy R44 at PC12; rename `PG_IN_N`→`PG_INT_N`; confirm INT/EXP_RST_N land on PA10/PE0/PC12/PC0. Doc TODO comments suggest R44 may already be repurposed as a 49.9 Ω PHY term — must be checked in the actual schematic.
- **Many designators in checklist/hardware CLAUDE.md carry `<!-- TODO verify designator -->`** (C/D/Q/FB references on clock-mux, RF, antenna, Rb-RS232, display ESD sheets) — designator stability must be confirmed against the re-annotated schematic before any per-block sign-off.
- **Untracked new custom libs** (PGB1010603MR.kicad_sym, IND_PGB_0603_LTF*.kicad_mod) added on this branch but not yet referenced in the docs/checklist — confirm where the PGB1010603MR ESD/PTC part is used.
- **No enclosure/mechanical doc** exists in /docs; mechanical intent (mounting, panel cutouts, antenna/coax egress, vertical display mount) is only implied. Layout will need this.

## 3. Layout-readiness executive summary

- ICs reviewed (approx): **76**
- Footprints checked (approx): **136**
- BOM lines: **535** (see §7 per-subsystem + §8)
- Subsystems reviewed: **20/20**
- **Blockers: 68**
- **High-risk items: 59**

**Overall status: NEEDS SCHEMATIC/LIBRARY CORRECTIONS BEFORE LAYOUT**

Top layout-readiness risks:
- **[PoE front end + power tree input (sheet PoE.kicad_sch)] POE_KILL net / R21 / Q3 / KILL_N** — KILL_N net = {Q1.C(C_3), Q5.C(C_3), R22.2} only — it has NO pull-up. Canonical sts1000_poe_kill.md requires R21 100k from V_KBIAS to KILL_N so KILL_N defaults HIGH=RUN. As wired, R21.1=V_KBIAS, R21.2=Net-(Q3-C); R21 is in Q3's collector, not on KILL_N. Q3 (BC857W PNP) is also reversed vs doc: doc wants E=V_KBIAS, C=HOLD; as built E=HOLD node (C9/R25/R27), C=via R21 to V_KBIAS, B=via R22 to KILL_N. A PNP sustain switch with its emitter on the floating HOLD node and no KILL_N pull-up cannot implement the documented default-RUN / self-sustaining-kill behavior. The whole AUX kill actuator is non-functional / indeterminate at power-up.
- **[PoE front end + power tree input (sheet PoE.kicad_sch)] D1 / missing input TVS across VOUT_P-VOUT_N** — No high-voltage surge TVS clamps the rectified PD bus (VOUT_P->VOUT_N = NCP1095 VPP->VPN). Canonical doc mandates D1=SMBJ58A TVS VPP->VPN (doc lines 78,125). In the schematic D1 is a BAV70LT1G small-signal array used for GBR steering, and no SMBJ58A/SMAJ/1.5SMC part exists on VOUT_P. D2/D3 are only 6.8V SOT-363 arrays in the gate-drive net, not a bus clamp. PD input has no avalanche surge protection for IEEE 802.3bt / IEC 61000-4-5 transients; only bulk C10 10uF/100V + C8 0.1uF/100V are present.
- **[PoE front end + power tree input (sheet PoE.kicad_sch)] U10 (and all INA228) SDA/SCL swap** — Net 'I2C_SCL' (carries MCU PB8=I2C1_SCL clock, U12.95) lands on U10 pin4 = SDA; net 'I2C_SDA' (PB9, U12.96) lands on U10 pin5 = SCL. INA228 DGS pinout is pin4=SDA, pin5=SCL (TI datasheet, verified) and the embedded symbol is correct. So the bus is crossed: the I2C clock physically reaches the INA228 data pin and vice-versa. Same crossover appears on U10,U23,U26,U30,U31,U32,U37,U44 — board-wide; it surfaces on this sheet at U10 (#1, 0x40). I2C to all power monitors will not enumerate.
- **[5V/3V3 main power supply (sheet 3v3-main-power.kicad_sch)] U29 AP3441 (CM5IO:AP3441SHE-7B symbol)** — Custom symbol pin map is scrambled vs datasheet DS39754. Datasheet pins: 1=FB,2=PG,3=VIN,4=SGND,5=EN,6=LX,7=PGND,8=NC. Symbol has 4=PGND,5=nc,6=LX,7=EN,8=SGND. Net result as wired: the real EN pin (datasheet pin5) is tied to the symbol's no-connect -> the regulator can never be enabled; real PGND (pin7) is driven by 5V_PSU_PG (EN net) -> power ground forced to 5V; real SGND (pin4) goes to PGND net; real NC (pin8) goes to SGND net. Board-killing. Same wrong symbol is used for U38 (OCXO buck) elsewhere -> propagates.
- **[5V/3V3 main power supply (sheet 3v3-main-power.kicad_sch)] U30/U31/U32 INA228 (and ALL eight INA228 board-wide)** — I2C SDA/SCL swapped between master and every slave. STM32 PB8(pin95)->net I2C_SCL, PB9(pin96)->net I2C_SDA (correct: PB8=I2C1_SCL, PB9=I2C1_SDA on STM32H5). But every INA228 has SDA(pin4) on net I2C_SCL and SCL(pin5) on net I2C_SDA. Master clock line lands on slave data pins and vice-versa -> bus non-functional. Confirmed identical on U10/U23/U26/U37/U44 too.
- **[Supercap backup supplies (U34/U35 TPS61094 ×2 + DSF305Q3R0 3F supercaps)] C90 / C91 (DSF305Q3R0)** — Footprint is the placeholder string "Radial", not a real KiCad footprint. The DSF305Q3R0 is a specific radial can (3.5 mm pin pitch, defined diameter/height). Cannot be laid out as-is.
- **[Supercap backup supplies (U34/U35 TPS61094 ×2 + DSF305Q3R0 3F supercaps)] fp-lib-table (project)** — fp-lib-table is EMPTY, but U34/U35 reference footprint via library nickname "TPS61094DSSR:SON50P300X200X80-13N". The .kicad_mod exists in hardware/libraries/ as a loose file, not in a TPS61094DSSR.pretty library, so the nickname will not resolve at layout/PCB-update.
- **[Ethernet magnetics/input (sheet: ethernet-input.kicad_sch)] J1** — Magjack 0826-1X1T-HS-F has NO footprint assigned (Footprint field empty in symbol and netlist; fp-lib-table is empty; no in-repo land pattern). Cannot place/route this part — hard blocker for layout.
- **[Ethernet magnetics/input (sheet: ethernet-input.kicad_sch)] J1** — Symbol is instantiated from the `0826-1X1T-GH-F` library but Value/MPN/datasheet = `0826-1X1T-HS-F` (a different gigabit variant). Pin NAMES match the HS-F drawing, but the footprint/land pattern must be the HS-F's, not GH-F's.
- **[Ethernet magnetics/input (sheet: ethernet-input.kicad_sch)] U1** — TPD4EUSB30 footprint is the bare string "10-USON" with no library prefix and no fp-lib-table — unresolved, cannot place.
- **[MCU core (STM32H563VIT6, U12)] U12 pin94 BOOT0 (R49/R50)** — BOOT0 is tied to a resistive divider: R49 10k to 3V3 + R50 10k to GND, so BOOT0 idles at ~1.65 V. That is an indeterminate logic level for the boot-mode strap (must be a hard 0 or 1). With the project no-DNP policy both resistors are populated, so the part may boot to bootloader or flash unpredictably and is noise-sensitive.
- **[MCU core (STM32H563VIT6, U12)] U12 footprint assignment** — The placed U12 instance has Footprint = "100-LQFP" (no library prefix) which does NOT exist in the repo; only LQFP-100_STM.kicad_mod (+ -L/-M) exist, and the symbol's own default is "LQFP-100_STM" (also unprefixed). There is no fp-lib-table anywhere in the project. The footprint will not resolve for layout.

## 4. Blockers before layout

| # | Where | Ref | Issue | Recommended fix | Confidence |
|---|---|---|---|---|---|
| 1 | PoE front end + power tree input (sheet PoE.kicad_sch) | POE_KILL net / R21 / Q3 / KILL_N | KILL_N net = {Q1.C(C_3), Q5.C(C_3), R22.2} only — it has NO pull-up. Canonical sts1000_poe_kill.md requires R21 100k from V_KBIAS to KILL_N so KILL_N defaults HIGH=RUN. As wired, R21.1=V_KBIAS, R21.2=Net-(Q3-C); R21 is in Q3's collector, not on KILL_N. Q3 (BC857W PNP) is also reversed vs doc: doc wants E=V_KBIAS, C=HOLD; as built E=HOLD node (C9/R25/R27), C=via R21 to V_KBIAS, B=via R22 to KILL_N. A PNP sustain switch with its emitter on the floating HOLD node and no KILL_N pull-up cannot implement the documented default-RUN / self-sustaining-kill behavior. The whole AUX kill actuator is non-functional / indeterminate at power-up. | Rewire to doc: R21 100k pull-up KILL_N->V_KBIAS (default RUN). Q3 PNP: E=V_KBIAS, B=via R22 from KILL_N, C=HOLD node (C9\|\|R25 to VOUT_N, R27 divider top). Then HOLD->R27/R29->VAUX. Re-verify on netlist that KILL_N has exactly one pull-up and both Q1.C and Q5.C pull it low. | High |
| 2 | PoE front end + power tree input (sheet PoE.kicad_sch) | D1 / missing input TVS across VOUT_P-VOUT_N | No high-voltage surge TVS clamps the rectified PD bus (VOUT_P->VOUT_N = NCP1095 VPP->VPN). Canonical doc mandates D1=SMBJ58A TVS VPP->VPN (doc lines 78,125). In the schematic D1 is a BAV70LT1G small-signal array used for GBR steering, and no SMBJ58A/SMAJ/1.5SMC part exists on VOUT_P. D2/D3 are only 6.8V SOT-363 arrays in the gate-drive net, not a bus clamp. PD input has no avalanche surge protection for IEEE 802.3bt / IEC 61000-4-5 transients; only bulk C10 10uF/100V + C8 0.1uF/100V are present. | Add an SMBJ58A (or SMCJ58A for energy margin) TVS from VOUT_P to VOUT_N at the bridge output, placed at the PD input. Confirm standoff (>57V port) and clamp below NCP1095 VPP abs-max and FET VDS 100V. | High |
| 3 | PoE front end + power tree input (sheet PoE.kicad_sch) | U10 (and all INA228) SDA/SCL swap | Net 'I2C_SCL' (carries MCU PB8=I2C1_SCL clock, U12.95) lands on U10 pin4 = SDA; net 'I2C_SDA' (PB9, U12.96) lands on U10 pin5 = SCL. INA228 DGS pinout is pin4=SDA, pin5=SCL (TI datasheet, verified) and the embedded symbol is correct. So the bus is crossed: the I2C clock physically reaches the INA228 data pin and vice-versa. Same crossover appears on U10,U23,U26,U30,U31,U32,U37,U44 — board-wide; it surfaces on this sheet at U10 (#1, 0x40). I2C to all power monitors will not enumerate. | Swap the two net labels at the INA228 bank (or re-route): I2C_SCL must reach pin5(SCL), I2C_SDA must reach pin4(SDA). Re-run ERC/netlist and confirm PB8->pin5, PB9->pin4 on every INA228. | High |
| 4 | 5V/3V3 main power supply (sheet 3v3-main-power.kicad_sch) | U29 AP3441 (CM5IO:AP3441SHE-7B symbol) | Custom symbol pin map is scrambled vs datasheet DS39754. Datasheet pins: 1=FB,2=PG,3=VIN,4=SGND,5=EN,6=LX,7=PGND,8=NC. Symbol has 4=PGND,5=nc,6=LX,7=EN,8=SGND. Net result as wired: the real EN pin (datasheet pin5) is tied to the symbol's no-connect -> the regulator can never be enabled; real PGND (pin7) is driven by 5V_PSU_PG (EN net) -> power ground forced to 5V; real SGND (pin4) goes to PGND net; real NC (pin8) goes to SGND net. Board-killing. Same wrong symbol is used for U38 (OCXO buck) elsewhere -> propagates. | Re-author CM5IO:AP3441SHE-7B with datasheet pin order (1 FB,2 PG,3 VIN,4 SGND,5 EN,6 LX,7 PGND,8 NC,9/EP=PGND), verify the assigned 8-UFDFN footprint pad numbers match 1:1, then re-net. Re-verify U38 too. | High |
| 5 | 5V/3V3 main power supply (sheet 3v3-main-power.kicad_sch) | U30/U31/U32 INA228 (and ALL eight INA228 board-wide) | I2C SDA/SCL swapped between master and every slave. STM32 PB8(pin95)->net I2C_SCL, PB9(pin96)->net I2C_SDA (correct: PB8=I2C1_SCL, PB9=I2C1_SDA on STM32H5). But every INA228 has SDA(pin4) on net I2C_SCL and SCL(pin5) on net I2C_SDA. Master clock line lands on slave data pins and vice-versa -> bus non-functional. Confirmed identical on U10/U23/U26/U37/U44 too. | Swap the I2C_SDA/I2C_SCL connections at the INA228 pins (or globally fix whichever symbol/label introduced the swap). Address straps happen to resolve correctly only because the swap is consistent, but the physical bus will not communicate. | High |
| 6 | Supercap backup supplies (U34/U35 TPS61094 ×2 + DSF305Q3R0 3F supercaps) | C90 / C91 (DSF305Q3R0) | Footprint is the placeholder string "Radial", not a real KiCad footprint. The DSF305Q3R0 is a specific radial can (3.5 mm pin pitch, defined diameter/height). Cannot be laid out as-is. | Assign/create a proper through-hole radial footprint matching the DSF305Q3R0 mechanical drawing (3.5 mm lead spacing, can dia/height per CDE datasheet) and verify polarity pad-1. | High |
| 7 | Supercap backup supplies (U34/U35 TPS61094 ×2 + DSF305Q3R0 3F supercaps) | fp-lib-table (project) | fp-lib-table is EMPTY, but U34/U35 reference footprint via library nickname "TPS61094DSSR:SON50P300X200X80-13N". The .kicad_mod exists in hardware/libraries/ as a loose file, not in a TPS61094DSSR.pretty library, so the nickname will not resolve at layout/PCB-update. | Add an fp-lib-table entry (e.g. point a nickname at hardware/libraries as a .pretty, or re-home the .kicad_mod into a .pretty folder) so all referenced footprint nicknames resolve. | High |
| 8 | Ethernet magnetics/input (sheet: ethernet-input.kicad_sch) | J1 | Magjack 0826-1X1T-HS-F has NO footprint assigned (Footprint field empty in symbol and netlist; fp-lib-table is empty; no in-repo land pattern). Cannot place/route this part — hard blocker for layout. | Add the Bel 0826-1X1T-HS-F recommended PCB footprint (drawing pg 4: 16× Ø0.89mm sig + 4× Ø1.02mm + 2× Ø1.57 + 2× Ø3.25 mount holes) to an in-repo footprint library and assign it; add the lib to fp-lib-table. | High |
| 9 | Ethernet magnetics/input (sheet: ethernet-input.kicad_sch) | J1 | Symbol is instantiated from the `0826-1X1T-GH-F` library but Value/MPN/datasheet = `0826-1X1T-HS-F` (a different gigabit variant). Pin NAMES match the HS-F drawing, but the footprint/land pattern must be the HS-F's, not GH-F's. | Confirm HS-F mechanical/footprint vs GH-F; assign HS-F land pattern. If pinout differs, re-draw symbol from HS-F drawing. | High |
| 10 | Ethernet magnetics/input (sheet: ethernet-input.kicad_sch) | U1 | TPD4EUSB30 footprint is the bare string "10-USON" with no library prefix and no fp-lib-table — unresolved, cannot place. | Assign `Package_SON:USON-10_2.5x1.0mm_P0.5mm` (matches DQA package) or an in-repo equivalent. | High |
| 11 | MCU core (STM32H563VIT6, U12) | U12 pin94 BOOT0 (R49/R50) | BOOT0 is tied to a resistive divider: R49 10k to 3V3 + R50 10k to GND, so BOOT0 idles at ~1.65 V. That is an indeterminate logic level for the boot-mode strap (must be a hard 0 or 1). With the project no-DNP policy both resistors are populated, so the part may boot to bootloader or flash unpredictably and is noise-sensitive. | Drive BOOT0 to a defined level. For boot-from-flash, remove R49 (keep only R50 10k pull-down to GND), or change R49/R50 so the divider is unambiguous (e.g. BOOT0 hard low). If field-selectable boot is wanted, route BOOT0 to a GPIO/header with a single 10k pulldown, not a 1:1 divider. | High |
| 12 | MCU core (STM32H563VIT6, U12) | U12 footprint assignment | The placed U12 instance has Footprint = "100-LQFP" (no library prefix) which does NOT exist in the repo; only LQFP-100_STM.kicad_mod (+ -L/-M) exist, and the symbol's own default is "LQFP-100_STM" (also unprefixed). There is no fp-lib-table anywhere in the project. The footprint will not resolve for layout. | Create a project fp-lib-table pointing at hardware/libraries, then reassign U12 to the real footprint Lib:LQFP-100_STM (verified 14x14 mm, 0.5 mm pitch, 100 pads, pin1 top-left, no exposed pad - matches ST LQFP100). Confirm all schematic instances (3 found) use the same resolvable name. | High |
| 13 | GNSS receiver (ZED-F9T) — U21 ZED-F9T-00B, U22 LT3045 LDO, U23 INA228 @0x44 | U22 pin 6 (PGFB) / net Net-(U22-PGFB) | LT3045 PGFB (pin 6) is shorted to the LDO input: net Net-(U22-PGFB) contains U22 pin1(IN), pin2(IN), pin6(PGFB), FB3, C46, fed from 5V via FB3. PGFB is the power-good comparator feedback input (PG asserts when PGFB>0.3V, 7mV hyst). Tying it to VIN makes PG report 'good' off the 5V input regardless of whether VOUT(3.3V) is actually present, so the 3V3_GPS_LDO_PG flag to U55 GPA0 is meaningless. Datasheet requires an OUT->PGFB->GND resistor divider: V_PGtrip=0.3V*(1+Rpg2/Rpg1). | Break PGFB off the IN net. Add a divider from Net-(U22-OUT) to GND with the tap to U22 pin6; e.g. for PG trip ~3.0V use Rpg1=10k, Rpg2=90.9k (keep Rpg1<30k so IPGFB negligible). Keep IN(1,2)+FB3+C46 on the 5V input net only. | High |
| 14 | GNSS receiver (ZED-F9T) — U21 ZED-F9T-00B, U22 LT3045 LDO, U23 INA228 @0x44 | U22 pin 4 (PG) / net 3V3_GPS_LDO_PG | LT3045 PG is an open-collector/open-drain output. Net 3V3_GPS_LDO_PG connects only U22 pin4 to U55 (MCP23017) GPA0 with NO external pull-up. The pin can pull low but never high, so power-good can never read asserted at the expander unless the MCP23017 internal pull-up (GPPU) is enabled in firmware — which is fragile and not a hardware guarantee. | Add a pull-up (e.g. 100k-1M to 3V3_STM, the always-on expander rail) on 3V3_GPS_LDO_PG. Do not pull to 3V3_GPS (that rail is the very thing being monitored). | High |
| 15 | GNSS antenna bias + supervisor (gps-antenna.kicad_sch) | U27 | BOM MPN RT9742VGJ5 (M/V-variant) does not match the schematic symbol pinout. Symbol used is the standard RT9742GGJ5 (pin1=OUT,2=GND,3=nFLG,4=EN,5=IN). Per Richtek DS9742-10, the M/V variant uses the 'For RT9742M/V only' pinout (pin5=EN,4=VOUT,3=VIN,2=GND) and HAS NO FLG PIN — yet the schematic wires pin3=nFLG to V_ANT_EN_FAULT→U55.25. Pins will land on the wrong silicon functions. | Decide the part: (a) order RT9742GGJ5 (1A, std pinout, has FLG) to match the existing symbol — but verify 1A limit covers 180mA load + cap inrush; or (b) keep RT9742VGJ5 (2A, active-high EN) and rebuild a correct symbol + custom .kicad_mod for the M/V pinout, and delete the nFLG/V_ANT_EN_FAULT connection (no FLG exists). Also note no custom footprint exists for U27 — assign/verify the TSOT-23-5 land pattern. | High |
| 16 | OCXO + steering supply (Y3 OH300, U39 TPS7A52 LDO, U38 AP3441 buck, U36 OPA320 Vc buffer, U37 INA228 #5) | U37 (INA228 OCXO) | Address straps wired A1=VS(3V3), A0=I2C_SCL which per TI INA228 Table 7-2 decodes to 0x47 (1000111), not the required 0x46. 0x47 is already assigned to the Rb-rail INA228 (U44) -> I2C address collision; OCXO power monitor unreachable. | Move U37 pin2 (A0) from net I2C_SCL to net I2C_SDA (A1=VS,A0=SDA = 0x46). Note INA228 ds requires +100ns MSB hold when an address pin ties to SDA. | High |
| 17 | OCXO + steering supply (Y3 OH300, U39 TPS7A52 LDO, U38 AP3441 buck, U36 OPA320 Vc buffer, U37 INA228 #5) | U38 (AP3441 buck) PG / U39 EN chain | AP3441 PG (U38.2, open-drain) sits on Net-(U38-PG) with NO pull-up to any rail. Its only path is R125(6.81k) -> OCXO_PSU_PG -> R124(10k) -> GND, which also drives U39 (TPS7A52 LDO) EN pin (U39.14). An open-drain output with no pull-up cannot present a valid logic-high, so OCXO_PSU_PG cannot reach the LDO EN threshold -> OCXO LDO never enables -> OCXO unpowered. | Add a pull-up (e.g. 10k to 3V3) on Net-(U38-PG); re-derive R124/R125 so OCXO_PSU_PG >= TPS7A52 EN VIH. Resolve only after confirming AP3441 PG is open-drain and on the correct pin. | Medium |
| 18 | OCXO + steering supply (Y3 OH300, U39 TPS7A52 LDO, U38 AP3441 buck, U36 OPA320 Vc buffer, U37 INA228 #5) | U38 (AP3441SHE-7B) | Custom CM5IO schematic symbol pinout (FB=1,PG=2,VIN=3,PGND=4,NC=5,LX=6,EN=7,SGND=8,PAD=9) cannot be reconciled with the LCSC-published pin table (EN=1,FB=2,GND=3,LX=4/5,VIN=6,PG=7,NC=8,EP=PGND). Official Diodes PDF could not be fetched to adjudicate. If the symbol is wrong, EN/PG/VIN/LX are mis-mapped -> buck non-functional / shorted at power-up. | Obtain the official AP3441SHE-7B (AP3441-L DS39754) package drawing; correct the custom symbol and verify the DFN-8-1EP_2x2 footprint pad-to-pin map and EP size before layout. | Low |
| 19 | Clock mux (OCXO/ext-ref -> PH0) | U52 | Footprint mismatch. MPN 74LVC1G157GW-Q100H is the GW suffix = SOT363-2 / TSSOP6 (body width 1.25 mm, 0.65 mm lead pitch, per Nexperia DS 74LVC1G157_Q100 Rev.6 2025-09-09, ordering/package section). Assigned footprint SC-74_TSOP6_SOT457_NEX is SOT457 / SC-74 / TSOP6 (0.95 mm pitch, pads at x=+/-1.35255, y=-0.95/0/+0.95 in the .kicad_mod). That is the GS-suffix package, not GW. Footprint will not solder to the ordered part. | Either assign a correct SOT363-2/TSSOP6 (0.65 mm pitch) footprint, or change the MPN to the SOT457 variant (74LVC1G157GS-Q100) so MPN and footprint agree. Pick one per the intended package, then re-verify pin1 orientation. | High |
| 20 | Clock mux (OCXO/ext-ref -> PH0) | U53 | No footprint assigned. Symbol Footprint property is empty (clock-mux.kicad_sch), BOM footprint column blank (sts1000_bom.csv line 522), and netlist comp has no footprint. Cannot be placed/routed. | Assign the SOT353-1 (TSSOP5) footprint matching the ordered 74LVC1G34GW-Q100 (5-lead, 0.65 mm pitch). Verify pad numbering against pinout 1=NC,2=A,3=GND,4=Y,5=VCC. | High |
| 21 | External 10 MHz RF front end (refclock-input.kicad_sch) | U51 PGFB (pin 6) | PGFB is tied to VIN (net Net-(U51-PGFB) = U51.1/IN, U51.2/IN, U51.6/PGFB, FB9.1, C154.1) instead of to a resistor divider OUT(3V0_RF)->PGFB->GND. LT3045 PG asserts when PGFB>300 mV (datasheet: PG=0.3V*(1+RPG2/RPG1)); with PGFB at ~5 V it is permanently above threshold, so PG (pin4) always reads GOOD regardless of whether the 3.0 V island is actually in regulation. PG is wired to MCP23017 U55 GPA2 (net 3V0_RF_LDO_PG) and consumed as a fault/status input, so firmware will see a false always-good. Power-good monitoring of the RF island is non-functional. | Add a divider from OUT(3V0_RF) to GND with the tap to PGFB. For ~90% threshold on a 3.0 V rail: e.g. RPG1=10k (PGFB->GND), RPG2=90.9k (OUT->PGFB) -> PG trips at ~0.3*(1+9.09)=3.03 V. Keep RPG1<30k so IPGFB is negligible. Remove the PGFB-to-VIN connection. | High |
| 22 | External 10 MHz RF front end (refclock-input.kicad_sch) | D20, D21 (3V3 zeners) | Both island/VCC clamp diodes are generic Device:D_Zener valued '3V3' with NO footprint assigned and NO MPN (BOM Status=SELECT, Footprint/Mfr/MPN all blank). Cannot be placed in layout (no footprint) and cannot be ordered. D20 = doc's D13 island shunt clamp (doc wants TVS >=1 W); D21 = doc's D14 VCC abs-max guard (doc wants >=0.5 W). | Commit MPNs and footprints. Per peripheral_map line 403, STN061033B101 (3.3 V) is conditionally accepted; pick a defined SOD-323/SOD-523 TVS for D20 (>=1 W) and a 0.5 W TVS/zener for D21, assign footprints, set V_RWM>=3.0 V and clamp <=4.5 V. | High |
| 23 | External 10 MHz RF front end (refclock-input.kicad_sch) | REF_VMID node (Net-(U50--)) | Missing 0.1 uF bypass on REF_VMID. The -IN/VMID node = R179(10k->3V0_RF), R180(10k->GND), R182(100k), U50.4(-IN) only -- no capacitor. Doc §4.6/§9 require '0.1 uF bypass' on REF_VMID and §5.4 settling math assumes 5k*0.1uF=0.5 ms. Without it the comparator threshold reference is unbypassed (noisy threshold -> jitter, false edges) and the documented settling budget is invalid. | Add a 0.1 uF C0G/X7R 0402 from REF_VMID (U50 -IN node) to GND, placed close to U50. | High |
| 24 | External 10 MHz RF front end (refclock-input.kicad_sch) | U49 VDD (pin 5) | Missing local 0.1 uF decoupling on the TMUX1101 VDD. U49.5 is on 3V0_RF, whose only nearby cap is C156 (10 uF Cout at the LDO). Doc §4.4 and BOM line ('— 0.1 uF U49 VDD decoupling') require a dedicated 0.1 uF at U49 VDD. Absent in schematic and BOM. | Add 0.1 uF C0G/X7R 0402 from U49 pin5 (3V0_RF) to GND adjacent to U49. | High |
| 25 | Rb buck supply (VCC_RB) | U44 (INA228) pins 4/5 | I2C bus SWAPPED: pin4 SDA -> net I2C_SCL, pin5 SCL -> net I2C_SDA. INA228 will not communicate. | Swap so U44.4(SDA)->I2C_SDA and U44.5(SCL)->I2C_SCL. | High |
| 26 | Rb buck supply (VCC_RB) | U44 (INA228) pins 1/2 address straps | A1->VS(3V3), A0->I2C_SDA yields 0x46, which COLLIDES with the OCXO INA228 (#5 = 0x46). Peripheral map requires Rb INA228 = 0x47. | Strap for 0x47: A1=VS, A0=SCL (A0 to the SCL line). Re-verify after the bus-swap fix so A0 lands on real SCL. | High |
| 27 | Rb buck supply (VCC_RB) | C126/C127/C128 (COUT 47uF 16V X6S) | Output bulk caps on VCC_RB rated only 16V, but VCC_RB DC max = 24.35V and TVS clamp ~45V. Caps will fail short. Canonical doc itself specifies >=63V. | Change to >=63V (preferably 100V) X7R/X7T; recompute effective C after DC-bias derating at 24V for loop stability. | High |
| 28 | Rb buck supply (VCC_RB) | U43 (MCP41U83) VDD vs P0B | VDD pin1 = 3V3 but terminal P0B pin8 = VREF_4V096 (4.096V). Pot terminal exceeds VDD by ~0.8V -> internal switch/ESD diode conducts, clamps/corrupts VREF and can damage the part. (When buck enabled, VREF is live.) | Either raise U43 VDD to +5V (then address 3V3 SPI VIH=0.7*VDD=3.5V margin) OR lower VREF below VDD and rescale Rctrl/divider. Resolve the VDD/terminal/SPI-level tradeoff before layout. | High |
| 29 | Rb buck supply (VCC_RB) | L7 | No footprint assigned (fp=NONE) -> cannot lay out. Also value/MPN conflict: schematic+doc say 40uH; BOM MPN SRP1265A-6R8M is 6.8uH/11.5A. Inductance drives ripple/stability/Isat. | Decide true L (recompute for MIC28516 adaptive-on-time at 5-24V/1.5A), pick matching MPN, and assign a footprint. | High |
| 30 | Rb buck supply (VCC_RB) | U41 (LMV393) | No footprint assigned (fp=NONE) and BOM MPN unresolved (status MPN-FROM-VALUE, generic 'LMV393'). Blocks layout. | Commit a specific LMV393 MPN (open-drain, AEC-Q100 if required) and assign SOIC-8/VSSOP-8 footprint. | High |
| 31 | Rb buck supply (VCC_RB) | C182 | VREF_4V096 reference output cap C182 (1uF 0402) is in the schematic/netlist but has NO BOM line -> BOM incomplete; part won't be ordered. | Add C182 to BOM. Reconcile with doc which lists the VREF cap as C115 2.2uF (wrong designator/value). | High |
| 32 | FE-5680A RS-232 interface (rb-io sheet) | (project) fp-lib-table | No fp-lib-table exists in the project. Custom-library footprint references in this block (U46 'SN65C3221EPWR:SOP65P640X120-16N', U47 'SOT23_NXP') cannot resolve in the PCB editor. The SOP65P640X120-16N.kicad_mod exists only as a loose file in hardware/libraries with no library nickname registered. | Create hardware/.../fp-lib-table registering the custom footprint libraries (and convert loose .kicad_mod files into a .pretty dir or register them), then re-point U46/U47 footprints to resolvable nicknames. | High |
| 33 | FE-5680A RS-232 interface (rb-io sheet) | K1 | G6K-2F-Y DC3 relay has NO footprint assigned in either the schematic or the BOM. Cannot place/route the mode-select relay. | Assign the Omron G6K-2F-Y SMD footprint (verify coil pins 1/8 and the DPDT throw pads 2/3/4/5/6/7 against Omron terminal-arrangement bottom view). | High |
| 34 | FE-5680A RS-232 interface (rb-io sheet) | L8, L9 | 600Ω@100MHz line ferrites have NO footprint assigned (BOM/sym empty). MPN Fair-Rite 2508056017Y2 is an 0805 body. | Assign an 0805 ferrite-bead footprint (e.g. L_0805_2012Metric) to L8/L9. | High |
| 35 | FE-5680A RS-232 interface (rb-io sheet) | D16 | Lock-input 3V3 zener has NO footprint and NO MPN (BOM status SELECT, value just '3V3'). | Pick a specific 3.3V zener MPN (e.g. BZT52C3V3 SOD-123) and assign its footprint; verify the zener's V_Z/I_Z over the residual current D16 sinks (~0.4mA at 24V). | High |
| 36 | FE-5680A RS-232 interface (rb-io sheet) | U48 | APC-817C1 footprint field is the placeholder string '4-SMD', not a valid library:footprint, so it will not resolve for layout. | Assign a real 4-pin SMD optocoupler footprint matching the APC-817C1-SL (SL = surface-mount lead form); verify pad 1=Anode,2=Cathode,3=Emitter,4=Collector. | High |
| 37 | SPI peripherals (NOR flash, U62) | U62 (MX25L25645GM2I-08G) | VCC pin in the custom symbol ntp-server-stm32:MX25L25645GM2I-08G has NO pin number (pin ""). Netlist shows VCC on 3V3_STM via pin "", so it will not map to footprint pad 8 — VCC pad floats in PCB with no ERC/DRC catch. Board would be unpowered. | Edit the symbol: assign the VCC pin number 8 (8-SOP serial-NOR pinout: 1=CS#,2=SO,3=WP#,4=GND,5=SI,6=SCLK,7=RESET#,8=VCC). Re-export netlist and confirm U62 pin 8 lands on 3V3_STM. | High |
| 38 | SPI peripherals (NOR flash, U62) | U62 (MX25L25645GM2I-08G) | No footprint assigned (Footprint field empty in schematic, netlist, and BOM). Cannot be placed/routed. | Assign an 8-SOP 208mil footprint (e.g. KiCad Package_SO:SOIC-8 / SO8-208mil) verified against the Macronix SOP body dimensions; populate BOM Footprint/Package/Datasheet fields. | High |
| 39 | I2C peripherals + display power | U33 pin3 (nFLG) / R105 | RT9742 FLG is an open-drain active-low fault output but R105 (10k) is wired as a pull-DOWN to GND (R105.1→GND, R105.2→V_DISP_EN_FAULT). An OD output with a pull-down sits permanently LOW; U55 GPB1 cannot distinguish fault from no-fault, and the open-drain transistor fights the pull-down with no defined high level. | Re-tie R105 to 3V3_STM so it pulls the FLG line high (idle = no fault); RT9742 sinks it low on fault. Keep value ~10k-100k. | High |
| 40 | I2C peripherals + display power | U63 (PCA9306) SCL2/SDA2 — nets I2C_DISP_SCL / I2C_DISP_SDA | No pull-up resistors on the 5V_DISP (VREF2/high-voltage) side of the PCA9306. The PCA9306 only provides a weak gate-bias device; per TI/NXP datasheet each side of the translator MUST have its own bus pull-ups. The low side has R202/R203 (4.7k to 3V3_STM), but the display side has none in the schematic. | Add 2 pull-ups (2.2k-4.7k) from SCL2 and SDA2 to 5V_DISP, OR positively confirm the LCDwiki MSP4030 module populates touch-bus pull-ups and document that dependency. | High |
| 41 | Fault/UI aggregation (MCP23017 ×2: U55 @0x20, U54 @0x21) | U54 GPA7 (pin 24) = DISP_TOUCH_INT | Input signal mapped to MCP23017 GPA7, which Microchip (DS20001952 Rev D, June 2022, and the article cited in this part's own symbol Description) states must NOT be used as an input on the I2C MCP23017: an input transition coincident with an I2C read can corrupt SDA and hang the bus. This is the shared housekeeping I2C bus (~21 nodes incl. all 8 INA228, TMP117, ATECC608B), so a hang takes down all power/thermal monitoring. | Reassign DISP_TOUCH_INT off GPA7 to any GPA0-6 / GPB0-6 pin (U54 is 16/16 full, so move one of the other inputs to U55's spare GPB2-7, or route DISP_TOUCH_INT directly to a spare MCU EXTI). Keep GPA7/GPB7 as outputs or NC only. | High |
| 42 | Fault/UI aggregation (MCP23017 ×2: U55 @0x20, U54 @0x21) | U54 GPB7 (pin 4) = INA_ALERT_VCC_RB | Input on GPB7 (output-only restricted pin) — same SDA-corruption/bus-hang hazard. This carries the Rb-rail INA228 #6 ALERT. | Move INA_ALERT_VCC_RB to a non-bit-7 GPIO (rebalance U54/U55 bit map; U55 GPB2-7 are spare). | High |
| 43 | Fault/UI aggregation (MCP23017 ×2: U55 @0x20, U54 @0x21) | U55 GPA7 (pin 24) = POE_PG | Input on GPA7 (output-only restricted pin) — same hazard. Carries PoE power-good. | Move POE_PG to one of U55's spare GPB2-7 inputs (GPB7 must stay output/NC). | High |
| 44 | Connectors, USB-C console, panel UI, display IF (connectors.kicad_sch) | D7 | TVS on VCC_RB is an uncommitted placeholder value '1.5SMCxxA'. VCC_RB spans 5-24 V with an autonomous 26 V OV latch; an unselected standoff voltage is a hard pre-layout/BOM gap and a safety-coordination item. | Commit to 1.5SMCJ28A (VRWM 28 V) per sts1000_vcc_rb_supply.md so standoff sits above the 26 V OV latch and below the FE-5680A abs-max. Update BOM line and value field. | High |
| 45 | Connectors, USB-C console, panel UI, display IF (connectors.kicad_sch) | D8, D9 | SZESD7410MXWT5G (10 MHz ref IN/OUT ESD) have NO footprint assigned in the schematic/netlist. | Assign the onsemi X2DFNW2 footprint to D8 and D9 before layout. | High |
| 46 | Connectors, USB-C console, panel UI, display IF (connectors.kicad_sch) | J2,J4,J6,J7,J8,J9,J10,J11 | Eight connectors have empty Footprint fields (fan, display flex, FE-5680A DE9, GPS SMA, 2x 10 MHz SMA, tamper, 7-button header). Cannot lay out without footprints. | Assign correct footprints: 1x04 (J2), MSP4030 1x14 flex (J4), DE9 socket (J6), edge/PCB SMA (J7/J8/J9), 1x02 (J10), 1x08 (J11). | High |
| 47 | Connectors, USB-C console, panel UI, display IF (connectors.kicad_sch) | TP1 | Test point on ETH_PPS_OUT has footprint DQA0010A (a 10-pad USON ESD land) — a gross footprint mismatch that would place 10 pads for a single test node. | Reassign a single-pad TestPoint footprint. | High |
| 48 | Connectors, USB-C console, panel UI, display IF (connectors.kicad_sch) | J4 pin 11 | J4.11 is tied to DISP_RST (LCD controller reset), but on the MSP4030/LCDwiki 14-pin module pin 11 is CTP_RST (capacitive-touch-panel reset), not LCD_RST (pin 4). As drawn the touch-panel reset and display reset are commoned, OR the touch reset is misrouted. | Confirm the as-ordered MSP4030 pinout. If sharing LCD_RST and CTP_RST onto DISP_RST is intended, document it (both reset together affects touch bring-up sequencing); otherwise route J4.11 to a dedicated CTP_RST control or leave per module spec. | High |
| 49 | RGB status indicator (D5) | D5 | Assigned footprint 'Library:LED_IN-P55TATRGB' does not exist: there is no fp-lib-table in the project at all, and no matching .kicad_mod in hardware/libraries. The symbol's default footprint is the KiCad-standard 'LED_SMD:LED_Inolux_IN-P55TATRGB_PLCC6_5.0x5.5mm_P1.8mm', but the D5 instance overrides it to a non-resolvable library. Layout cannot place D5 and the symbol-pin to footprint-pad mapping (load-bearing for correct R/G/B color routing) cannot be verified. | Either (a) revert D5's Footprint to the symbol default LED_SMD:LED_Inolux_IN-P55TATRGB_PLCC6_5.0x5.5mm_P1.8mm and verify its pad numbering equals 1=CathB,2=CathR,3=CathG,4=AnG,5=AnR,6=AnB against the IN-P55TATRGB datasheet, or (b) add a custom IN-P55TATRGB .kicad_mod to hardware/libraries with a 'Library' fp-lib-table entry. Then confirm pad#=pin# mapping and pin-1 orientation. | High |
| 50 | netlist | INA228 group (U10,U23,U26,U30,U31,U32,U37,U44) pins 4 & 5 | Board-wide SDA/SCL pin swap: every INA228 wires pin 4 (SDA per TI datasheet) to net I2C_SCL and pin 5 (SCL) to net I2C_SDA. Symbol pinfunctions are correct and the MCU/MCP23017/TMP117/ATECC are all wired correctly, so the INA228 wiring is the defect. All 8 power monitors would be non-functional (clock on the data pin), breaking the entire monitoring and fault-aggregation subsystem. | Rework the INA228 sub-sheet wiring so pin 4 -> I2C_SDA and pin 5 -> I2C_SCL on all eight parts. | High |
| 51 | netlist | INA_ALERT_3V3, _3V3_GPS, _3V3_STM, _5V_DISP, _OCXO, _VCC_RB, _V_ANT, _V_POE | All 8 INA228 ALERT pins (pin 3, open-drain per datasheet) drive MCP23017 U54 Port B with no external pull-up. Without a pull-up (or firmware enabling MCP23017 GPPU), the de-asserted ALERT line floats and cannot be read. | Fit 8x ~10k pull-ups to 3V3_STM on the ALERT nets, OR mandate and document MCP23017 U54 GPPU=1 on GPB0-7 in the software spec. | High |
| 52 | library | U43 MCP41U83 symbol (hardware/libraries/ntp-server-stm32.kicad_sym, symbol "MCP41U83", pins 1-7) | Symbol pin-number-to-function map disagrees with Microchip DS20007000 TSSOP-14 pinout for pins 1-7. Symbol: 1=VDD,2=SDO/A1,3=SCK/SCL,4=SDI/SDA,5=nCS/A0,6=SPI2C,7=DGND. Datasheet order: 1=CS/A0,2=SDI/SDA,3=DGND,4=SPI2C,5=VDD,6=SDO/A1,7=SCK/SCL. Wrong pad mapping mis-wires VDD/VSS/SPI/wiper-config on the part that sets VCC_RB; risks driving the Rb out of its safe rail. | Re-draw the MCP41U83 symbol pin numbers to match the datasheet Pin Function Table figure (verify CS/A0=1, SDI/SDA=2, DGND=3, SPI2C/CFG=4, VDD=5, SDO/A1=6, SCK/SCL=7, P0B=8, P0W=9, P0A=10, VSS=11, NC=12-14). Then re-net U43 and re-run ERC. | High |
| 53 | library | U62 MX25L25645GM2I-08G symbol (hardware/libraries/ntp-server-stm32.kicad_sym) | VCC pin is defined with an empty pin number (number ""). A pin with no number will not map to any footprint pad; U62 also has no footprint assigned in sts1000_bom.csv. | Assign the correct VCC pad number per the chosen MX25L25645 package (8-SOP/WSON-8: VCC=pin 8) and assign a footprint. | High |
| 54 | library | U59 LIS2DH12 (LGA-12_STM) and U61 IIS2MDC (LGA-12_2X2X0P7_STM) footprints | Pad numbering is internally self-consistent (1-4 left, 5-6 bottom, 7-10 right, 11-12 top) and matches the symbols, but pin-1 corner orientation and exact pad x/y vs the ST recommended land pattern were not confirmed against the datasheet package figure (datasheet PDFs could not be machine-read in this environment). The pin-1 silk marker location appears inconsistent with pad-1 placement in LGA-12_STM. | Open both footprints over the ST datasheet land-pattern figure; confirm pin-1 corner, pad pitch/size, and silk pin-1 marker before placement. Commit LIS2DH12 SA0 (0x18/0x19) per the standing open item. | Medium |
| 55 | power | L7 (Rb buck inductor, Rb Power sheet / sts1000_bom.csv) | Value column says 40uH but assigned MPN is SRP1265A-6R8M which is a 6.8uH part (identical MPN to L2). MIC28516 adaptive-on-time Rb buck stepping VOUT_P (37-57V) down to ~15V at 6-10W needs a deliberately chosen inductor; 6.8uH vs 40uH changes ripple/saturation/CCM by ~6x. | Recompute the Rb buck inductor for the actual VCC_RB set-point, ripple and peak current, then assign a real MPN whose inductance matches the Value (and satisfies Isat at the 15-20W warm-up surge). Update docs §5 and BOM together. | High |
| 56 | power | R106 + 3V3_STM net | 3V3_STM (the 'always-on housekeeping' rail powering STM32 VDD x5 and all I2C peripherals) is connected to 3V3 ONLY through R106 = 0.5 ohm sense shunt (INA228 U31 0x41 across it). It is NOT a separately-regulated rail, so it cannot be 'always-on independent of the main 3V3'; both collapse together. A 0.5 ohm shunt on the full STM rail also drops ~250mV at 0.5A into the STM32 VDD and burns ~125mW. | Resize the shunt to ~10-25 mohm (matching the rail current for the chosen INA228 ADCRANGE). Separately, correct the docs: 3V3_STM is downstream of 3V3, not independent. If genuine always-on independence (survive 3V3 gating) is required, add a dedicated LDO. The back-power-safety argument in peripheral_map only holds because 3V3 itself is always-on (U29), not because 3V3_STM is separate. | High |
| 57 | power | D7 (VCC_RB TVS, Connectors/Rb) | TVS on the Rb rail is a placeholder MPN '1.5SMCxxA' with no chosen clamp/standoff voltage. The Rb buck has an autonomous 26V OV latch and VCC_RB can be set 5-24V; the TVS standoff must sit above max VCC_RB but below the 26V trip and the FE-5680A abs-max. | Select the 1.5SMCJ series standoff (e.g. relative to +15V/+24V Rb variants and the 26V latch) and assign the concrete PN. This is the autonomous clamp backstop so it cannot stay TBD. | High |
| 58 | interfaces | B1: I2C1 / LTC4311 U56 EN + PA9 | U56 ENABLE (pin 3) is hard-tied to 3V3_STM (always enabled). PA9 — which the peripheral map §4/§8 designates as I2C_BUF_EN to drive the accelerator EN for firmware bus-recovery — is instead wired to WDT_EN (U64.SET1). Net 'WDT_EN' = U12.68(PA9), U64.6, R213. Result: the documented firmware I2C stuck-bus recovery via the accelerator is not implementable, and docs disagree with the schematic. | Decide intent: (a) accept PA9=WDT_EN and update peripheral_map §4/§8 to drop I2C_BUF_EN (LTC4311 permanently on is electrically valid per datasheet), or (b) reclaim a GPIO for I2C_BUF_EN→U56.EN. Update docs either way. | High |
| 59 | interfaces | B2: RMII / LAN8742 U11 config straps | U11 MODE0 (pin8), MODE1 (pin7), MODE2 (pin11=CRS_DV), PHYAD0/RXER (pin10) have NO pull resistor at the PHY pin — they connect only through R31-34 (100 ohm) to the MCU RMII pins, which are high-Z at power-on reset. The PHY's RMII-vs-MII mode, 10/100 advertisement, and PHY address are therefore undefined at reset. nINTSEL (pin2) / REGOFF (pin3) strap via LED resistors R39/R38 must also be confirmed to latch nINTSEL low for REF_CLK-OUT mode. | Add dedicated strap pulls (typ. 1k-10k to VDD/GND per the Microchip LAN8742A checklist) at U11 pins 7/8/10/11 to set RMII + auto-neg + PHYAD; verify the LED-shared nINTSEL/REGOFF straps resolve to REF_CLK-OUT mode at reset. | High |
| 60 | interfaces | B3: Missing footprints on connectors and NOR | J1 (magjack 0826-1X1T-HS-F), J5 USB-C has a footprint but J7/J8/J9 (SMA coax, generic 'Conn_Coaxial'), J6 (FE-5680A housekeeping) and U62 (MX25L25645G NOR) have no assigned footprint. Layout cannot proceed without them. | Assign verified footprints: real SMA PNs for J7/J8/J9, the Halo magjack land pattern for J1, NOR SOP-8 (208mil) for U62, and a connector for J6 matching the chosen FE-5680A variant pinout. | High |
| 61 | interfaces | B5: GPS SMA surge protection | GPS_RF_IN (J7) has a polymer ESD suppressor (L10 = PGB1010603MR, Cj~0.3pF) and bias-T (L1 47nH), but no on-board coaxial gas-discharge arrestor. The peripheral map / CLAUDE.md require a polymer ESD + separate coaxial GDT for outdoor antenna runs (RF needs Cj<=0.3pF AND 5V bias needs V_RWM>=6.5V). | Confirm the GDT is provided inline at the antenna entry (off-board is acceptable) and document it; verify PGB1010603MR V_RWM tolerates the 5V active-antenna bias. | Medium |
| 62 | interfaces | B6: Net-name / doc drift (non-blocking but fix before layout-freeze) | PB14 net is 'CLK_OUT'-style misnamed '10MHz_CLK_OUT' though it is the EXTREF_MON capture of mux input B; PH0 net is named 'CLK_OUT' for an oscillator input; PE4 net 'RB_RS232_CMOS_SW' vs doc 'RB_SER_MODE'. Connectivity is correct in all three; only names drift from the canonical peripheral-map names, which hardware/CLAUDE.md treats as a defect. | Rename to EXT_REF_IN/EXTREF_MON, OSC_IN, RB_SER_MODE respectively to match the peripheral map. | High |
| 63 | constraints | PoE_HV / PoE_ISO net classes | HV clearance/creepage and magjack isolation gap cannot be finalized without knowing the PD-side voltage class and whether the NCP1095 PD front end is isolated (digital isolator on NCL/NCM/LCF). peripheral_map §14 leaves this open. | Decide isolated vs non-isolated PD front end; set creepage per the resulting voltage class (≥0.5 mm air, ≥1.0 mm to SELV as a starting point) and the magjack isolation barrier. | High |
| 64 | constraints | All impedance + current-width rules | Stackup and copper weight are TBD, so every Z target (50 Ω RF, 90 Ω USB, 100 Ω MDI) and every current-driven width (PoE_HV, buck SW/rails) is a placeholder. | Commit a layer stackup, run a field-solver / board-house impedance calc, and an IPC-2152 width calc at the chosen Cu weight and 10–20 °C rise. | High |
| 65 | constraints | L1 bias-T choke value | antenna_supervisor §3 body uses 56 nH (gives the cited 554 Ω @ 1.575 GHz); checklist §7 and hardware/CLAUDE.md say 47 nH. The two values give different RF isolation. | Resolve to one value against the schematic and the >500 Ω @ GNSS-band requirement before the RF region is laid out. | High |
| 66 | constraints | INA228 / INA181 shunt values | All sense-shunt values are still SHUNT-REVIEW (TBD) in sts1000_bom.md — Kelvin routing constraints are defined but the resistor footprints/power ratings are not finalized. | Fix per-rail full-scale current and ADCRANGE per INA228, choose 0.5% 0805 (or 4-terminal) shunts, then the Kelvin pad geometry can be locked. | High |
| 67 | constraints | INA_ALERT_N dangling net | net_naming.md flags INA_ALERT_N as a 1-pin dangling net on the MCU — a missing connection, not just a naming issue. | Merge INA_ALERT_N into INA_ALERT_INT_N (PC12) and re-net before layout. | Medium |
| 68 | constraints | OCXO source-term designator (R98 vs R123) | clock_mux.md references R98 (and R123) for the OCXO 22 Ω source term; checklist/hardware CLAUDE say R123. Unresolved refdes. | Confirm the actual refdes in the OCXO sheet so the source-term resistor is placed at the driver, not duplicated. | Medium |

### High-risk items (layout may begin only if accepted as risk)

| # | Where | Ref | Issue | Fix | Confidence |
|---|---|---|---|---|---|
| 1 | PoE front end + power tree input (sheet PoE.kicad_sch) | C6,C7,C9,C11 (PoE HV caps) | BOM marks C6 (1nF), C7 (1uF), C9 (1uF), C11 (47pF) as '100V?' with status REVIEW-HV and no MPN. C7/C9 are 0603 X7R 1uF rated only '100V?'; these sit on V_KBIAS/HOLD (VOUT_N+12V) so 100V is likely fine, but C6 is on COSC (NCP1095 osc, low V) yet marked 100V?. Voltage ratings and dielectrics are unconfirmed and parts unsourced. | Pin exact MPN+voltage: COSC C6 can be 16-50V C0G; AUX filter C11 47pF needs >=50V C0G; bias C7/C9 1uF >=50V (16V if truly on +12V bias is marginal-use 50V). Resolve REVIEW-HV before layout. | Medium |
| 2 | PoE front end + power tree input (sheet PoE.kicad_sch) | C8 reference (VPP decouple) | Doc specifies C8 100nF VPP->VPN. Netlist has C8.1=VOUT_P, C8.2=GND(=RTN). RTN!=VPN in the pass-switch-off state (RTN rises to VPP). For the NCP1095 VPP local decouple the RTN(GND) reference is acceptable, but it differs from the documented VPP->VPN. Minor, but confirm intended reference for the input decoupling vs surge return. | Confirm C8 reference: VPP->RTN is the conventional decouple; update doc if RTN is intended, else move to VPN. | Medium |
| 3 | PoE front end + power tree input (sheet PoE.kicad_sch) | R16 / R30 shunts (25m, 150m) | R16 (RSNS 25m, NCP1095 PSNS overcurrent sense) and R30 (150m, INA228 #1 V_POE shunt) are BOM status SHUNT-REVIEW with no MPN and '0.5% per rail TBD'. R16 footprint listed 1206 in BOM but doc/RSNS practice expects a tight-tolerance sense part; R16 value sets NCP1095 ILIM (VOC 1.2V/IOC 6.4A). 25m -> hard-limit ~48A, soft ~6.4A: confirm R16 actually targets the intended current limit for ~30W cold-start. | Select R16 with math: VOC 1.2V/R16 = hard ILIM; size for cold-start inrush+Rb. Select R30 for INA228 full-scale at max PoE input current (Class6 ~1.1A @48V). Assign sense-grade MPN + footprint (2010/1206 Kelvin). | Medium |
| 4 | PoE front end + power tree input (sheet PoE.kicad_sch) | GBR / FDMQ8205A body-diode reversion (doc open item 1) | NCP1095 GBR(11) drives only D1(BAV70 common-cathode), whose anodes steer the U3-U6 N-FET gate-drive bias (via D2/D3). During AUX kill, GBR low must force the FDMQ8205A array (U7/U8) to body-diode rectification so VOUT_P (and V_KBIAS) survives. This is an unverified dynamic behavior of a custom discrete ideal-diode gate-drive; if GBR-low instead collapses the active gates incorrectly it could oscillate offline<->reset. FDMQ8205A is a passive quad-MOSFET array (2x P-ch + 2x N-ch), so correct external gate commutation is essential and must be bench-validated. | Bench-verify GBR-low reverts U7/U8 to body-diode mode with VOUT_P maintained; confirm U3-U6 (BC846BPDW) drive polarity and D2/D3 clamp on the N-FET gates. Document the ideal-diode gate-drive theory of operation. | Low |
| 5 | PoE front end + power tree input (sheet PoE.kicad_sch) | D4 Zener (12V) unsourced | D4 sets V_KBIAS = VOUT_N+12V (bias rail for the kill driver). BOM status SELECT, no MPN, no footprint, value just '12V'. Power dissipation ~ (VOUT_P-12V)/R18 * 12V; at 57V port, ~1.8mA*12V=22mW - OK in SOD-123 but part must be chosen. | Assign a 12V Zener MPN (e.g. SOD-123, >=200mW, +/-5%) and footprint; verify R18 >=1/4W (doc open item 6). | Medium |
| 6 | PoE front end + power tree input (sheet PoE.kicad_sch) | R18 power rating | R18 24.9k drops ~38V at ~1.8mA -> ~81mW at 57V port (doc). BOM assigns R18 = ERJ-2RKF2492X, an 0402 rated 1/10W (100mW). Headroom is only ~1.2x at max port voltage and worse under surge; doc explicitly flags 'R18 rated >=1/4W' as an open item. | Use a 1/4W (0805/1206) 24.9k for R18, or split into two series 0402. Re-verify dissipation incl. surge. | High |
| 7 | PoE front end + power tree input (sheet PoE.kicad_sch) | Q2 FDMC8622 pass FET — Net-(Q2-S) multi-pad | PSNS(U9.9) and R16 top tie to Q2 pins 1,2,3 (S_1,2,3) and PGATE(U9.10) to Q2 pin4(G); Q2 pins5,6,7,8 (D) to GND/RTN. This matches an 8-PowerWDFN where source is pins1-3 and drain is the pad/pins5-8. Confirm the FDMC8622 footprint pin-1/source mapping matches the symbol (custom/generic '8-PowerWDFN'); a source/drain swap here is catastrophic (pass FET in backwards). | Verify FDMC8622 datasheet pinout vs assigned footprint pads: S=1/2/3, G=4, D=5/6/7/8+pad. Confirm orientation and Kelvin sense to R16. | Medium |
| 8 | 5V/3V3 main power supply (sheet 3v3-main-power.kicad_sch) | U29 PG / net 3V3_PSU_PG (R94 2.2k, R92 10k) | 3V3 buck Power-Good is unreadable: U29 PG (open-drain, pin2) -> R94 (2.2k) -> 3V3_PSU_PG node -> R92 (10k) -> GND, with MCP23017 U55 GPA4 sensing the node. There is NO pull-up to any rail. The node can only ever sit near GND, so PG always reads 'fail/low'. Contrast U28 5V_PSU_PG which has R95 properly pulled to 5V. | Make R94 (or R92) a pull-up to 3V3 or 3V3_STM on the open-drain PG net so the expander can read a real high. Pick one pull-up resistor to a rail; remove the GND series/pull-down that kills the high state. | High |
| 9 | 5V/3V3 main power supply (sheet 3v3-main-power.kicad_sch) | R96 (24.9k) + C67 (0.1uF) from U28 SW node to FB (Net-(U28A-FB)) | A series R96-C67 couples the U28 switch node (Net-(C68-Pad2)) directly into the FB pin. If intended as Hyper-Speed-Control ripple injection it may be legitimate, but the values/topology are unverified and as drawn this injects large switching ripple into the high-impedance FB node. Net-(C67-Pad1) is an internal 2-node net (R96<->C67) only. | Confirm against MIC28516 datasheet ripple-injection / external-ripple guidance (all-ceramic Cout case). If not required, delete R96/C67. If required, verify R/C values per datasheet equation and keep the injection trace short at the IC. | Medium |
| 10 | 5V/3V3 main power supply (sheet 3v3-main-power.kicad_sch) | L2 (SRP1265A-6R8M) / L3 (DR73-2R2-R) | Both inductors have NO footprint assigned in the netlist/schematic (empty footprint field) even though MPNs and current ratings exist in the BOM (L2 6.8uH 11.5A, L3 2.2uH 4.15A). Cannot lay out without footprints. Also verify saturation/Irms margin vs the per-rail current estimates below. | Assign correct footprints (Bourns SRP1265A 12.5x12.5mm; Eaton DR73). Verify Isat > peak inductor current incl. ripple and cold-start surge. | High |
| 11 | Supercap backup supplies (U34/U35 TPS61094 ×2 + DSF305Q3R0 3F supercaps) | PA6 (BKP_GPS_SOC_V) / PB1 (BKP_STM_SOC_V) | peripheral_map §lines 265-266 specify a /2 divider on each SOC sense; the schematic connects PA6/PB1 directly to the SUP node with no divider. If firmware applies the documented /2 scale it will report 2x the true supercap voltage. | Reconcile doc and schematic: direct sense is electrically fine (VCHG=2.5V < 3.3V VREF), so update peripheral_map to remove the /2 divider and set ADC scale = 1:1; or add the divider if headroom margin is wanted. | High |
| 12 | Supercap backup supplies (U34/U35 TPS61094 ×2 + DSF305Q3R0 3F supercaps) | U34/U35 VOUT (C92/C94/C96 and C93/C95/C97) | 3x22uF = 66uF nominal on each VOUT vs TI recommended COUT 20-30uF effective (NOM 20, MAX 30). Even after X7R DC-bias derate (~45-50uF eff) this exceeds the recommended max; over-capacitance can lengthen boost soft-start and reduce loop margin. | Reduce VOUT ceramic to ~22-33uF effective per converter (e.g. 1-2x22uF), or validate the 66uF case with TI's reference/loop tools before committing. | Medium |
| 13 | Supercap backup supplies (U34/U35 TPS61094 ×2 + DSF305Q3R0 3F supercaps) | L4 / L5 | Inductor value 2.2uH is correct per datasheet but the BOM line has no MPN, no footprint, no saturation/DCR selection (status SELECT). | Select a 2.2uH inductor from TI's recommended list (e.g. Coilcraft XGL4020-222, Cyntec VCHA042A-2R2) with Isat >> peak (>0.5A is trivial here), assign footprint. | High |
| 14 | Supercap backup supplies (U34/U35 TPS61094 ×2 + DSF305Q3R0 3F supercaps) | U34/U35 EN, MODE | EN and MODE are pulled high to VOUT (100k) rather than to VIN. At cold start VOUT=0 -> EN=MODE=low -> Forced bypass (VOUT=VIN via bypass FET) -> VOUT rises -> EN/MODE pull up -> Auto buck/boost. Self-bootstrapping works, but pulling enable from the rail the part is generating is non-obvious and depends on the bypass-mode cold-start path; also 100k vs the internal 800k pulldown gives only ~0.89xVOUT at the pin. | Verify VIH against the cold-start sequence in SPICE/bench; consider referencing EN/MODE pull-ups to VIN (3V3, always present when board is powered) for an unambiguous enable, or confirm TI's recommended autonomous strap. Confirm 100k meets >800k pull-strength requirement (it does) and VIH at 0.89xVOUT. | Medium |
| 15 | Ethernet magnetics/input (sheet: ethernet-input.kicad_sch) | C1 | SHIELD-to-digital-GND chassis-coupling cap is rated only 16V (4.7nF X7R 0402). This node bridges chassis/cable-shield to board ground and will see ESD/surge/common-mode HV in field use; 16V is grossly under-rated. | Use a high-voltage cap (≥1kV, preferably 2kV like the LAN8742 checklist Cmagterm) in a larger case; keep R1 1M bleed. | High |
| 16 | Ethernet magnetics/input (sheet: ethernet-input.kicad_sch) | U1 | TPD4EUSB30 is a USB-3.0-targeted ESD array (not Ethernet/MDI-qualified, not AEC-Q101). Project policy requires AEC-Q100/Q101 where available. Working voltage 5.5V and 0.7pF are electrically adequate for 3.3V-biased 100M MDI, but the part class is mismatched to an industrial PoE product. | Consider an AEC-Q101 MDI/Ethernet ESD array (e.g. TPD4E1U06/equivalent) qualified for the bias and surge; confirm Cio compatible with 100M. | Medium |
| 17 | Ethernet magnetics/input (sheet: ethernet-input.kicad_sch) | ETH_LEDY / ETH_LEDG | Magjack LED anode/cathode orientation (Bel table: PIN17=−,PIN18=+ yellow; PIN19/20 green/orange bi-color) must agree with LAN8742 LED-pin strap polarity (the same pins set REGOFF/nINTSEL straps). A polarity/strap conflict can either invert the LEDs or mis-strap REGOFF/nINTSEL at POR. | Cross-verify Bel LED polarity table vs LAN8742 checklist Fig 7/8 strap resistors (332Ω series, 10k strap) on the PHY sheet; confirm nINTSEL strap = correct level for chosen 50MHz/REFCLK clocking mode. | Medium |
| 18 | Ethernet PHY (LAN8742AI-CZ-TR) — sheet ethernet-phy.kicad_sch | Y1 | 25 MHz crystal has NO footprint assigned in the schematic (Footprint field empty) — layout cannot place it. BOM specifies CTS 445I23E25M00000 (25.000 MHz, CL=20 pF SMD), so a footprint (CTS 445I 3.2x2.5 mm 4-pad SMD) must be assigned and reconciled with the BOM line. | Assign the CTS 445I 4-pad SMD crystal footprint to Y1 and verify pad-1 orientation; confirm against the committed CTS 445I23E25M00000 package drawing. | High |
| 19 | Ethernet PHY (LAN8742AI-CZ-TR) — sheet ethernet-phy.kicad_sch | J1 | Magjack (Bel Fuse 0826-1X1T-HS-F integrated-magnetics RJ45) has NO footprint assigned in the schematic — layout blocker. Also BOM 'Spec' column lists 0826-1X1T-GH-F while MPN is 0826-1X1T-HS-F (suffix mismatch). | Assign the Bel Fuse 0826 series PCB footprint, verify the 1G ICM pinout (TRD1/2/3/4, center taps, LED pins 18/20) against the datasheet, and resolve the GH-F vs HS-F suffix. | High |
| 20 | Ethernet PHY (LAN8742AI-CZ-TR) — sheet ethernet-phy.kicad_sch | U1 | TPD4EUSB30 ESD array sits on the PHY-side MDI (U11 pins 20-23, between PHY and magjack J1), i.e. on the transformer-isolated side. ESD/surge from the RJ45 cable enters on the CABLE side; protection placed PHY-side of the magnetics provides little real surge/ESD benefit. Pinout itself is correct (D1+=1,D1-=2,GND=3/8,D2+=4,D2-=5; NC 6,7,9,10 tied to lines harmlessly). | Either delete U1 (rely on the magjack's internal cable-side protection) or move equivalent ESD/surge protection to the RJ45 cable side. If kept PHY-side, document it as intentional; it is electrically benign (VRWM 5.5 V > 4.3 V worst-case MDI peak, 0.8 pF OK for 100 M). | Medium |
| 21 | Ethernet PHY (LAN8742AI-CZ-TR) — sheet ethernet-phy.kicad_sch | J1 | A GIGABIT (1000BASE-T, 4-pair) integrated-magnetics jack is used with a 10/100 (2-pair) PHY. Only TRD1/TRD2 are driven; pairs 3 & 4 (and their center taps) are unused and must be properly terminated (Bob-Smith/75R + 1nF to chassis) to avoid radiated emissions / floating windings. | Confirm the 0826 internal termination of unused pairs, or add external 75 R + 1 nF/2 kV chassis termination on the unused pair pins; otherwise consider a 10/100 2-pair jack. | Medium |
| 22 | MCU core (STM32H563VIT6, U12) | U12 pin14 NRST | NRST connects only to the SWD header J3.5. No external reset capacitor (ST AN5711 recommends ~100 nF NRST->GND for noise/reset-glitch immunity) and no external pull-up (relies on internal ~40k). For a grandmaster that must not glitch-reset, the missing NRST cap is a reliability gap. | Add 100 nF (0402) from NRST to GND close to the pin. Internal pull-up is adequate; do not add a strong external pull-up that fights the SWD debugger reset. | High |
| 23 | MCU core (STM32H563VIT6, U12) | U12 pin21 VREF+ / U14 MCP1502T-33 / R48 / C37 / C38 | VREF+ decoupling at the MCU pin is only C37 1nF; the 2.2 uF reservoir C38 sits on the far side of series R48 50 ohm (on the MCP1502 OUT). ST recommends 1 uF + 100 nF directly at VREF+. The MCP1502 has a small max direct CL, so the 50 ohm + 2.2 uF is the reference-stability network - but it isolates the bulk charge from the pin. During ADC SAR sampling VREF+ will droop/settle through 50 ohm into 1 nF, degrading ADC accuracy (this MCU steers the OCXO via ADC-sensed Vc, so VREF integrity is timing-critical). | Put the SAR charge-reservoir AT the VREF+ pin: e.g. reference OUT -> small cap -> series R -> 1 uF + 100 nF at VREF+/pin21. Re-verify the network against MCP1502 datasheet 5.1.2 (Load Capacitor) max-CL/series-R rule. Confirm firmware keeps the internal VREFBUF disabled when driving VREF+ externally. | Medium |
| 24 | External watchdog (U64 TPS3430, WDT sheet) | WDT_KICK / U64 pin 7 (WDI) | No external pull resistor on the WDI net. TI SBVS366 pin-function (p.5): 'If the watchdog is disabled, then WDI cannot be left unconnected and must be driven to either VDD or GND.' WDI has no internal pull. PB2 is push-pull so WDI is driven once GPIO is configured, but during the pre-config boot instant PB2 is Hi-Z and WDI floats. The doc's claimed pulldown R169 is actually a 10k resistor in the Rb-IO circuit (pin2 on Net-(Q21-B)), not on WDT_KICK. | Add a 100k (10k-100k acceptable) pulldown from WDT_KICK to GND placed near U64 pin 7, with a NEW unused refdes (R169 is occupied). Update doc §3/§5/§10 to the real designator/value. | High |
| 25 | GNSS receiver (ZED-F9T) — U21 ZED-F9T-00B, U22 LT3045 LDO, U23 INA228 @0x44 | U23 pin 1 (A1) | INA228 address pin A1 is strapped to bare net '3V3', but the device VS/VBUS (pins 6,8) are on '3V3_GPS'. A0 (pin2)=GND. A1=VS/A0=GND decodes to 0x44 (correct per doc), but the strap references a DIFFERENT rail than the part's own supply. If 3V3 and 3V3_GPS sequence differently, the address pin level is momentarily ambiguous relative to VS. | Tie A1 (pin1) to 3V3_GPS (same rail as U23 VS) rather than the global 3V3 net. | High |
| 26 | GNSS receiver (ZED-F9T) — U21 ZED-F9T-00B, U22 LT3045 LDO, U23 INA228 @0x44 | U21 pin 47 (D_SEL) / GPS_DSEL = PD7 | D_SEL (interface select: high/open=UART+I2C, low=SPI) is driven only by STM32 PD7. At POR the MCU GPIO is high-Z until firmware configures it; the module latches D_SEL at boot. F9 series has an internal pull-up on D_SEL (defaults to UART/I2C) so this is likely safe, but there is no board-level guarantee of the POR level. | Confirm ZED-F9T-00B internal D_SEL pull-up in the integration manual; if relying on UART, optionally add a weak external pull-up to 3V3_GPS so the power-up interface is deterministic before PD7 is driven. | Medium |
| 27 | GNSS receiver (ZED-F9T) — U21 ZED-F9T-00B, U22 LT3045 LDO, U23 INA228 @0x44 | L1 bias-T inductor (gps-antenna sheet, feeds GPS_RF_IN) | Cross-sheet: the antenna bias is injected onto GPS_RF_IN via L1. CLAUDE.md lists L1=47nH, but the ZED-F9T integration manual recommends a multi-band bias-T inductor of ~120nH (Murata) for L1/L2/L5 coverage; 47nH may not present adequate RF isolation across all bands and can load the L5/L2 RF. | Verify L1 value against u-blox ZED-F9T integration manual antenna bias section (multi-band requires ~120nH per the recommended Murata part); confirm series current-limit resistor (R77 3.3R) protects the bias-T inductor on antenna short. | Medium |
| 28 | GNSS antenna bias + supervisor (gps-antenna.kicad_sch) | L1 | Schematic/BOM value is 47nH (LQG15HS47NJ02D) but the canonical doc §3/§8/§11 state 56nH. At 47nH the bias-T choke impedance at 1.575GHz is ~465Ω, which is BELOW u-blox's >500Ω guideline the doc relies on (56nH gives 554Ω). | Resolve the value: if 47nH is intended, update the doc and re-justify the <500Ω choke impedance (or add a second series choke/larger value); if 56nH is intended, change the BOM/schematic part. | High |
| 29 | GNSS antenna bias + supervisor (gps-antenna.kicad_sch) | U26.3 (INA_ALERT_V_ANT) | INA228 ALERT is open-drain and has no discrete pull-up; net only connects U26.3 to MCP23017 U54.2. Valid high relies on MCP23017 internal ~100k weak pull-up (firmware-enabled, GPPU). | Add a ~10k pull-up to 3V3 on INA_ALERT_V_ANT, matching the other INA228 ALERT nets, so the line is defined independent of firmware. | High |
| 30 | GNSS antenna bias + supervisor (gps-antenna.kicad_sch) | U27 EN / ANT_BIAS_EN / R88 | R88 10k pulls U27 EN low; RT9742 V-variant EN is active-high, so V_ANT defaults OFF at power-up. This contradicts doc §7's stated intent that the antenna default ON (via Q14/R78) for fast warm restart when the F9T pin is undriven — the upstream U27 now overrides that. | Decide intended POR antenna state with U27 present. If default-on is required, change EN default (and document); if default-off is intended, update doc §7/§9.4 to reflect that firmware must assert PC9 to power the antenna. | High |
| 31 | GNSS antenna bias + supervisor (gps-antenna.kicad_sch) | R89 | BOM value field reads '100m' (0.1Ω) but the assigned MPN KDV08DR150ET is 0.15Ω. The INA228 shunt-cal and overflow range depend on the true value. | Correct the value field to match the part (0.15Ω) or change the part to a true 0.1Ω, and set INA228 SHUNT_CAL/ADCRANGE accordingly. | High |
| 32 | OCXO + steering supply (Y3 OH300, U39 TPS7A52 LDO, U38 AP3441 buck, U36 OPA320 Vc buffer, U37 INA228 #5) | C98, C99, C101 | All three Vc-path / loop-filter capacitors are GRM155R71C104KA88J = X7R dielectric. The Vc node is FM-sensitive; X7R microphonics/piezoelectric effect modulate the carrier. Direct violation of project hard rule 'OCXO Vc-path caps: C0G/NP0 or film, NEVER X7R'. C101 (0.1uF directly on OCXO Vcontrol) is the worst offender. | Change C98/C99/C101 (and any cap on OCXO_V / U36 +IN / C99 filter node) to C0G/NP0 (or film). 0.1uF C0G in 0402 is unavailable; expect to up-size footprint (0805/1206) or re-scale the filter to a C0G-realizable value. | High |
| 33 | OCXO + steering supply (Y3 OH300, U39 TPS7A52 LDO, U38 AP3441 buck, U36 OPA320 Vc buffer, U37 INA228 #5) | Loop filter (R120/R121/R118/R119/C98/C99 + U36) | OPA320 is a unity-gain buffer, so Vc = +IN voltage = essentially full DAC 0-3.3V range (R121 10M bias contributes ~1%). No attenuator implements the peripheral_map target of scaling DAC 0-3.3V to +/-0.4 ppm; OCXO sees full pulling range, degrading steering resolution and disciplining/holdover stability. | Confirm intended APR window; if +/-0.4 ppm is required, add gain<1 / divider so Vc spans only the needed Vcontrol sub-range centered at 1.65V. Currently flagged open in peripheral_map §14 but unaddressed in schematic. | Medium |
| 34 | Clock mux (OCXO/ext-ref -> PH0) | U53 | MPN/grade not pinned. Symbol Value=74LVC1G34 (generic) with TI datasheet link (sn74lvc1g34.pdf); BOM MPN=74LVC1G34, flagged MPN-FROM-VALUE. Canonical doc (sts1000_clock_mux.md sec5/A) requires Nexperia 74LVC1G34GW-Q100 (AEC-Q100 Grade 1, -40/+125 C) to match U52 grade. As-entered, no automotive grade is enforced and vendor is ambiguous. | Set MPN to 74LVC1G34GW-Q100H (or chosen vendor equivalent), update datasheet link, confirm AEC-Q100 per project automotive-grade rule. | High |
| 35 | Clock mux (OCXO/ext-ref -> PH0) | U52 | MPN entered via MPN-FROM-VALUE (BOM line 521); MANUFACTURER field blank. Vendor/orderable PN not pinned, and the package descriptor in the footprint name is self-contradictory (SC-74 + TSOP6 + SOT457 are three different package families). | Pin manufacturer + orderable MPN; resolve package naming once the footprint blocker is fixed. | High |
| 36 | External 10 MHz RF front end (refclock-input.kicad_sch) | U51 PG (pin 4) / net 3V0_RF_LDO_PG | PG is open-collector (datasheet) and the net has only U51.4 and U55(MCP23017) GPA2 -- no external pull-up. It relies entirely on the MCP23017 internal weak pull-up (GPPU) being enabled by firmware; if GPPU is off the line floats and the status read is indeterminate. | Add an explicit ~100k pull-up on 3V0_RF_LDO_PG to 3V3_STM (the MCP23017 rail) or document a firmware MUST-enable-GPPU contract. (Also fix the PGFB blocker first, else PG is meaningless.) | High |
| 37 | External 10 MHz RF front end (refclock-input.kicad_sch) | U49 / U50 / U51 MPN | Placeholder MPNs not orderable and ambiguous on grade: U49='TMUX1101DCK' (needs reel suffix, e.g. DCKR), U50='LTC6752xS5' (the 'x' is a temp-grade placeholder: must commit LTC6752IS5 or HS5, base/non-latching -- NOT -2/-3 which are 5.25 V separate-supply), U51='LT3045xDD' (must commit E/I/H/MP grade). Project rule requires AEC/automotive -40/+85 where available -> choose I or H grades. BOM Status=MPN-FROM-VALUE, no Mfr/Digikey. | Commit exact ordering PNs and confirm temp grade meets enclosure environment; for U50 confirm S5 base single-supply (3.5 V op / ~3.6 V abs-max) which the R183+D21 guard depends on. | High |
| 38 | External 10 MHz RF front end (refclock-input.kicad_sch) | U50 VCC margin (R183 33R + D21) | VCC guard holds U50 VCC at ~2.85 V nominal (3.0 V island - Iq*33R, Iq~4.5 mA). LTC6752 S5 single-supply min operating ~2.45 V. With island tolerance (LDO set by 1%-grade R186) + D21 leakage + Iq spread, the 2.85 V sits ~0.4 V above min -- adequate but not generous, and a 3.3 V zener (soft knee) on D21 can leak near 3.0-3.3 V. | Per doc open item 3, verify VCC>2.45 V over temp/Iq; prefer a precise low-leakage 3.3 V TVS for D21; if marginal reduce R183. Confirmed against datasheet operating range. | Medium |
| 39 | Rb buck supply (VCC_RB) | U45 (MCP1502) nSHDN pin4 | Reference is GATED by RB_PWR_EN (nSHDN <- Net-(Q19-C) via Q19/Q20), not always-on. VREF_4V096 feeds BOTH the digipot terminal AND the OV-latch comparator reference. On RB_PWR_EN assertion, VREF ramps from 0 concurrently with the buck soft-start (SS cap C119=10nF, fast) -> startup race: FB injection setpoint and OV trip threshold are briefly undefined; rail could overshoot or OV could false-trip before VREF settles. | Sequence: ensure VREF (MCP1502 enable + settle) is established before/with buck SS; consider slowing SS or gating EN until VREF good. Confirm MCP1502 turn-on time vs SS ramp. (Note: doc says ref is 'always-on' - see docMismatch.) | Medium |
| 40 | Rb buck supply (VCC_RB) | U40 (MIC28516) SVIN/PVIN on VOUT_P | VOUT_P is the PoE/PD bridge rail, up to ~57V (per poe_kill doc, R18 sized at VOUT_P=57V). MIC28516 abs-max VIN=70V -> only ~13V headroom; surge/ringing on a 57V PoE rail could approach the limit. | Confirm worst-case VOUT_P (transients/PD turn-on) stays well under 70V; add input snubber/clamp if needed. Verify SVIN R162 2.2ohm + C135 1uF RC filter adequate. | Medium |
| 41 | Rb buck supply (VCC_RB) | R159 (shunt) | Shunt value unresolved (BOM status SHUNT-REVIEW, 20m placeholder). Doc notes 100m drops 150mV/225mW at 1.5A (too large); ~20m with ADCRANGE=1 gives +/-2A FS. Affects INA228 scaling and power dissipation. | Finalize shunt value+rating (>=0.5W if 20m at 1.5A=45mW ok; verify) and set INA228 ADCRANGE/CAL accordingly. | Medium |
| 42 | Rb buck supply (VCC_RB) | D7 (1.5SMCxxA TVS) | MPN unfinalized (value '1.5SMCxxA', BOM status SELECT). Doc requires 28V standoff (1.5SMCJ28A): 24.35V max < 28V standoff < ~31V VBR < ~45V clamp. Must be 28V variant to not clip normal operation yet protect below TVS. | Commit 1.5SMCJ28A (or eqv 28V uni TVS); confirm clamp <= COUT rating. | High |
| 43 | Rb buck supply (VCC_RB) | R144 (RINJ 10.7k) | Ripple-injection value is a bench-trim starting point; FB AC load R2\|\|Rctrl ~505 ohm attenuates injected ripple. Adaptive-on-time MIC28516 needs adequate FB ripple for stable operation across 5-24V. | Bench-trim R144 for 20-100mV pp at FB across the full output range before fixing for layout; budget a 0402 you can re-stuff. | Medium |
| 44 | FE-5680A RS-232 interface (rb-io sheet) | K1 | 3 VDC coil (G6K-2F-Y DC3, 91Ω) driven from the 3.3 V rail = 110% rated coil voltage → ~36 mA, ~120 mW vs 100 mW nominal. Within the relay's continuous-voltage limit at 23°C but runs hot; at an 85°C enclosure the coil temperature-rise margin should be checked. | Confirm G6K DC3 max continuous coil voltage at expected ambient; if tight, add a small series coil resistor or choose a 3.6V/5V-coil variant. Otherwise document as acceptable. | Medium |
| 45 | FE-5680A RS-232 interface (rb-io sheet) | U47 | Footprint inconsistency: schematic symbol default FP = 'SOT23_NXP' (custom) but BOM FP = 'TO-236AB'. Combined with the missing fp-lib-table, the PESD15VL2BT footprint is unresolved. | Pick one resolvable SOT-23 footprint for U47 and register it; confirm pad order 1=I/O,2=I/O,3=GND. | High |
| 46 | FE-5680A RS-232 interface (rb-io sheet) | K1 throws | Relay NC/NO throw assignment (pins 2/3/4/5/6/7) is correct in the netlist topology but the de-energized=NC=RS-232 default must be confirmed against the Omron terminal-arrangement diagram once a footprint is assigned (pad-to-throw mapping). | Cross-check pad numbers vs Omron G6K bottom-view terminal map; confirm de-energized contacts select the RS-232 path. | Medium |
| 47 | SPI peripherals (NOR flash, U62) | U62 VCC decoupling | Because the VCC pin is unmapped, presence/placement of a dedicated 100 nF bypass cap on U62 pin 8 cannot be verified. 3V3_STM has many bulk/bypass caps but none provably adjacent to U62. | After fixing the VCC pin number, add/confirm a 100 nF MLCC tied between U62 pin 8 and GND, placed within ~1–2 mm at layout. | Medium |
| 48 | I2C peripherals + display power | sts1000_3v3p_i2c_peripherals.md (canonical doc) | Doc still specifies a gated 3V3_P / PERIPH_EN=PC11 rail with PCA9517/TCA4311 back-power-isolation buffer for these peripherals, but the schematic + root CLAUDE.md have eliminated 3V3_P and put all peripherals on always-on 3V3_STM. The doc's entire bus-topology section (§2/D7) and rail enumeration (§6) are stale. | Rewrite the canonical doc to reflect always-on 3V3_STM (no PERIPH_EN gating, no segmenting buffer needed); propagate to peripheral_map §4/§6. | High |
| 49 | I2C peripherals + display power | U63 pin8 (EN) / DISP_EN | PCA9306 EN is driven by a 3V3 push-pull GPIO (via R104). Datasheet wants EN biased to the high side (VREF2=5V) and >=1V above VREF1 for best translation; here EN(high)=3V3=VREF1, giving zero headroom over VREF1. | Pull EN to VREF2 (5V_DISP) via ~200k (GPIO can still sink to disable), or verify VIH(EN) is met at 3V3 against the specific PCA9306DCTT spec and document the deviation. | Medium |
| 50 | I2C peripherals + display power | U33 RT9742VGJ5 current-limit tier vs display inrush + R107 0.1Ohm drop | RT9742 'V' suffix selects one ILIM tier (family is 0.5/1/1.5/2/2.5/3A). Open item: confirm the V-tier ILIM exceeds the LCD module backlight-full + Cin inrush, and that the 0.1Ohm series shunt (R107) plus switch RDS(on) leave enough rail headroom at 5V. | Pull exact ILIM(min) for the V option from DS9742-10 ordering table; measure/estimate module inrush and steady backlight current; verify ILIM>peak and 5V - I*(RDSon+0.1) within module Vmin. | Medium |
| 51 | Fault/UI aggregation (MCP23017 ×2: U55 @0x20, U54 @0x21) | U54/U55 footprint EP | Assigned KiCad std-lib footprint QFN-28-1EP_6x6mm_P0.65mm_EP4.25x4.25mm specifies a 4.25x4.25mm exposed pad; Microchip MCP23017 ML package drawing nominal EP is ~4.45mm. Body 6x6 and 0.65mm pitch are correct, but EP land should be confirmed against the exact /ML package drawing before layout. | At layout, verify EP land + paste mask against DS20001952 ML package drawing; adjust if Microchip EP nominal differs. | Medium |
| 52 | Fault/UI aggregation (MCP23017 ×2: U55 @0x20, U54 @0x21) | U55 GPB2-7 (pins 27,28,3,4) spare inputs | Six spare expander I/O left unconnected/floating. Floating CMOS inputs raise quiescent current and can produce spurious INT/INTCAP reads. | In firmware enable internal pull-ups (GPPU) on unused bits or configure them as outputs driven low; document in the init sequence. | High |
| 53 | I2C1 bus + rise-time accelerator (U56 LTC4311) | I2C_SCL / I2C_SDA bus | A single 4.7k pull-up pair (R202/R203) serves an I2C1 bus carrying ~16 device loads (U10,U12,U23,U26,U30,U31,U32,U37,U44,U54,U55,U56,U57,U58,U59,U60,U61,U63) routed across ~10 schematic sheets. The LTC4311 (U56) is present precisely because bus capacitance is high, but C_bus is not yet budgeted against the LTC4311's supported load or the target SCL frequency. If total C_bus or rise time is out of range the bus is marginal even with the accelerator. | Before layout, sum all device SDA/SCL pin capacitances + estimated trace capacitance; confirm total C_bus is within LTC4311 capability at the target SCL (e.g. 100/400 kHz). Keep R202/R203 = 4.7k as the static pull-up (good: ~0.7 mA sink, comfortably within I2C 3 mA). Plan U56 placement at the high-C end of the bus, not at the MCU. Confirm target I2C clock rate in software_spec. | Medium |
| 54 | Connectors, USB-C console, panel UI, display IF (connectors.kicad_sch) | D6 | SMF5V0A (VRWM 5.0 V) sits on the 5V_DISP rail. A 5.0 V standoff on a nominal 5 V rail leaves ~0 V margin; at the rail's upper tolerance (e.g. 5.25 V) the TVS leaks/clamps, causing standby current and possible nuisance regulation interaction. | Confirm 5V_DISP regulation window. If it can exceed ~5.0 V, move to SMF5.5A/SMF6.0A (VRWM 5.5/6.0 V). | High |
| 55 | Connectors, USB-C console, panel UI, display IF (connectors.kicad_sch) | RTC_TAMPER / C44 / TAMP | Tamper relies on the STM32 TAMP internal precharge pull-up (no external PU) with C44=1 nF. Correctness depends on RM0481 TAMP config (TAMPPRCH/TAMPFLT) and the actual internal R_PU charging 1 nF inside the precharge window; unverified against datasheet. | Confirm STM32H563 TAMP internal pull-up value and set TAMPPRCH so 1 nF reaches VIH; this is firmware-config but gates the no-external-PU choice. | Medium |
| 56 | Connectors, USB-C console, panel UI, display IF (connectors.kicad_sch) | L10 (GPS SMA ESD) | Single polymer suppressor (PGB, 0.06 pF, 150 V) protects the GPS SMA. Capacitance and bias-voltage requirements are met, but per project rule an outdoor antenna run also needs a separate coaxial gas-discharge arrestor — not present on-board. | For outdoor deployments, add an inline coax GDT at the bulkhead (deployment/mechanical, not necessarily on this PCB). Document the in-vs-outdoor boundary. | High |
| 57 | Connectors, USB-C console, panel UI, display IF (connectors.kicad_sch) | D8/D9 SZESD7410 | Distributor listing flags SZESD7410MXWT5G as 'Active Obsolete' at one source — possible lifecycle/sourcing risk for a long-life instrument. | Verify lifecycle status with onsemi/authorized distis; identify a pin/spec-compatible second source (ultra-low-C bidir ESD ~1 pF) before fab. | Low |
| 58 | RGB status indicator (D5) | R59/R60/R61 | Ballast resistors are 0402 in the schematic, but doc §4 and §10 explicitly require 0603 ('do not use 0402 on red/blue'). Dissipations (B 37 mW, R 48 mW, G 16 mW) are within a 0402's ~63-100 mW rating, so this is not an immediate thermal failure, but it directly contradicts the canonical design and removes the intended margin. | Decide and reconcile: either change R59/R60/R61 footprints to 0603 to match the doc, or update doc §4/§10 to ratify 0402 with the derating math. Keep schematic and doc consistent. | High |
| 59 | RGB status indicator (D5) | D5 | Blue design point is 24.8 mA = the 25 C absolute-max DC forward current; I_F derates to 0 at 80 C T_OP. If the front-panel local ambient is warm, the blue die is over-driven. Doc §7 flags this but it is unverified. | Bench-confirm LED local ambient under worst-case enclosure load; if warm, drop I_blue to ~20 mA and re-derive R59/R60/R61 via the 3:2:1 ratio. | Medium |

## 5. Board-wide netlist findings

## Board-wide Netlist Review — STS1000 "Meridian"

Source: `hardware/ntp-server-stm32/ntp-server-stm32.net` (442 nets, Eeschema 10.0.1 export 2026-06-21T16:28:44). Parsed programmatically (regex extraction of every `(node …)`); no net was skipped. Cross-checked against `docs/ntp_server_peripheral_map.md`, `docs/sts1000_net_naming.md`, `CLAUDE.md` INA map, and TI INA228 datasheet (SLYS178/SBOS… Table 7-2, pinout table).

### Headline result
The four standing actions are essentially DONE/verified, the back-powering hazard is genuinely resolved, **but two real wiring defects survive**: (1) a board-wide INA228 SDA/SCL pin swap (8 parts), and (2) eight INA228 open-drain ALERT lines with no pull-up. Plus three doc-vs-as-built mismatches that will mislead firmware (INA228 address map, U55 Port-B map, missing PIR proximity-wake).

### Standing-action verification
| Action | Result | Evidence |
|---|---|---|
| Drop legacy **R44** at PC12 | DONE — R44 is now a LAN PHY term (3V3_LAN↔TRD0_N), not on PC12. `INA_ALERT_INT_N` has a single pull-up **R199→3V3_STM** on U12.80 (PC12). | netlist R44, R199 |
| **`PG_IN_N`→`PG_INT_N`** rename | DONE — no `PG_IN_N` net exists; `PG_INT_N` = R200.2, U12.69(PA10), U55.15/16. | netlist search |
| INT nets + EXP_RST_N on PA10/PE0/PC12/PC0 | VERIFIED all four: PG_INT_N→**U12.69 PA10**; BTN_INT_N→**U12.97 PE0**; INA_ALERT_INT_N→**U12.80 PC12**; EXP_RST_N→**U12.15 PC0**. | netlist |
| Stale `INA_ALERT_N` 1-pin defect (naming doc §55) | GONE. | netlist search |

### Net-findings table
| Net | Connected pins | Expected | Observed issue | Risk | Fix | Status |
|---|---|---|---|---|---|---|
| `I2C_SCL` / `I2C_SDA` (INA228 group) | **All 8 INA228** wire pin 4 (=SDA per datasheet) → `I2C_SCL` and pin 5 (=SCL) → `I2C_SDA`. e.g. U10.4 SDA→I2C_SCL, U10.5 SCL→I2C_SDA; same on U23/U26/U30/U31/U32/U37/U44 | INA228 pin4=SDA→I2C_SDA, pin5=SCL→I2C_SCL (TI datasheet pinout) | **SDA/SCL crossed on every INA228** (symbol pinfunctions are correct, so wiring is wrong). MCU PB9=SDA→I2C_SDA, PB8=SCL→I2C_SCL and MCP23017/TMP117/ATECC are all correct → only the INAs are flipped | **BLOCKER** — all 8 power monitors non-responsive (clock on data pin); breaks the entire monitoring/fault-tree subsystem | Swap the two pins on the INA228 symbol's wiring (or rebuild the INA228 sub-sheet) so pin4→I2C_SDA, pin5→I2C_SCL | FAIL |
| `INA_ALERT_<rail>` ×8 | INA228 pin3 ALERT (open-drain, per datasheet) → MCP23017 U54 Port B only; **no pull-up resistor on any of the 8** | Open-drain ALERT needs a pull-up to be readable | Lines float when de-asserted unless MCP23017 GPPU weak (~100k) pull-ups are enabled in firmware | **WARNING** — works only if firmware sets U54 GPPU on GPB0–7; weak 100k is adequate for static latched flags but undocumented dependency, and ERC-fragile | Either fit 8× ~10k pull-ups to 3V3_STM, or document the mandatory GPPU=1 config in software_spec | WARNING |
| INA228 address straps | U10=GND,GND(0x40) U31=GND,VS(0x41) **U30=GND,SDA(0x42) U32=GND,SCL(0x43)** U23=VS,GND(0x44) U26=VS,VS(0x45) **U37=VS,SCL(0x47) U44=VS,SDA(0x46)** | Doc/CLAUDE map: U30=0x43, U32=0x42, U37=0x46, U44=0x47 | **4 of 8 addresses disagree with docs** (U30↔U32 and U37↔U44 swapped). All 16 unique → no bus collision | **WARNING (doc/FW)** — firmware using the doc map reads 5V_DISP when it expects main-3V3, and OCXO↔Rb swapped | Re-decode against TI Table 7-2; fix either straps or the doc/firmware map so they agree | WARNING |
| `unconnected-(U55-GPB2-Pad27)` | U55.27 GPB2, pintype `bidirectional`, **no `no_connect` flag** (unlike GPB3–7 which carry the flag) | Spare pin should carry a no-connect flag | Inconsistent ERC handling; will throw "input not driven" ERC | **LOW** | Add a no-connect flag on U55 GPB2 | WARNING |
| `INA_ALERT_VCC_RB` | U44.3 ALERT (OD) + **U54.4 GPB7 typed `output`** | MCP23017 GPB7 read as input | Symbol pintype `output` (other ALERT bits are `bidirectional`); KiCad sees two drivers | **LOW** (cosmetic; firmware sets DDR=input) | Set GPB7 symbol pin to bidirectional/input | WARNING |
| `POE_PG` | U9.14 PGO (OD, NCP1095) + U28.24 EN + U55.24 GPA7 (`output`) + **R20 pull-up** | PGO gates buck EN + read by expander | GPA7 typed `output` (cosmetic). PGO pulls buck EN — verify R20 rail/value gives valid EN high | **LOW** | Confirm R20 → correct rail/value; set GPA7 symbol to input | PASS* |
| `3V3` ↔ `3V3_STM` (back-power check) | **R106 is the sense shunt: pin1=`3V3`, pin2=`3V3_STM`**; U31 (INA #2, 0x41) Kelvin-senses across it | All I2C devices on one always-on domain | `3V3_STM` is derived from `3V3` through R106 only — **same always-on rail, not independently gated.** I2C pull-ups (R202/R203) on 3V3_STM; INA228 VS on 3V3 → no gated/always-on split → **no back-power path** | none — claim holds | I2C pull-ups, MCP23017/TMP117/ATECC/e-compass/ADC/NOR/WDT all VDD=3V3_STM; INAs VS=3V3 | PASS |
| Single-pin nets | All 100 single-pin nets are KiCad `unconnected-(…)` no-connect flags; **zero named one-pin-net defects** | No dangling named nets | None | none | — | PASS |
| Exposed pads | EPAD/EP detected: U39.21, U54.29, U55.29 → all **GND**. Bucks U28/U40 use pin33 PGND→GND as pad | EP→GND/thermal | OK at netlist level; physical EP presence on U28/U40 (MIC28516) is a footprint-review item | none | verify EP pads in footprints | PASS |
| Outputs shorted | `VOUT_P`/`VOUT_N` (U7/U8 parallel FDMQ8205A bridges), `GPS_VBAT`/`STM_VBAT` (U34/U35 dual VOUT pins) — all intentional parallels | — | No genuine output-output conflicts | none | — | PASS |

\*PASS pending R20 rail/value confirmation.

### Design-intent mismatches
| Ref | Doc says | Schematic says | Severity |
|---|---|---|---|
| peripheral_map §159 (U55 PortB) | [0]V_ANT_EN_FAULT, [1]freed, [2]V_DISP_EN_FAULT, [3]**PROX_WAKE (PIR)**, [4–7] spare | GPB0=V_ANT_EN_FAULT, **GPB1=V_DISP_EN_FAULT** (doc says [1] freed/[2] V_DISP), GPB2=unconnected, **GPB3=unconnected** | Medium — bit map shifted; firmware bit definitions wrong |
| peripheral_map §159/§411, §287 | PIR **proximity wake** on U55 PortB[3] = secondary wake source | **No PROX_WAKE / PIR / WAKE net exists anywhere**; GPB3 unconnected | Medium — documented feature not implemented in schematic |
| CLAUDE INA map / peripheral_map §157 | U30=0x43 main3V3, U32=0x42 5V_DISP, U37=0x46 OCXO, U44=0x47 Rb | straps decode U30=0x42, U32=0x43, U37=0x47, U44=0x46 | Medium — FW addresses wrong rail |

### Items confirmed clean (no action)
- No `3V3_P` rail remnant (only `3V3_PSU_PG`, a power-good signal name — fine).
- Net naming consistent with `sts1000_net_naming.md`: `INA_ALERT_<rail>` intentionally has no `_N` (doc §18); `MCU_NRST` intentionally ST-named (§15); `GPS_EXTINT` is active-high so no `_N`.
- ATECC608B U56 BUS1=SCL→I2C_SCL, BUS2=SDA→I2C_SDA (correct). MCP23017 U54/U55 SCK→I2C_SCL, SDA→I2C_SDA (correct). TMP117 U57/U58 correct. The INA228 group is the *only* device family with swapped I2C.
- INA228 addresses, even after the swaps, are all unique (0x40,0x41,0x42,0x43,0x44,0x45,0x46,0x47) — no bus collision.

### Open verification I could not close from the netlist
- TI INA228 **Table 7-2** address decode confirmed by family convention (base 0x40; A1/A0 ∈ GND/VS/SDA/SCL) but the PDF table could not be rendered in this environment (no `pdftoppm`). The 0x40/0x41/0x44/0x45 rows match both straps and doc, anchoring the decode; the 0x42/0x43/0x46/0x47 swap conclusion follows. Confirm against datasheet page 19 before edits.
- R20 value/rail on `POE_PG` (EN pull-up for buck U28) not value-verified here.

Sources: [TI INA228 datasheet](https://www.ti.com/lit/ds/symlink/ina228.pdf) (pinout: pin4=SDA, pin5=SCL, pin3=ALERT open-drain; Table 7-2 address map).

## 6. Design-intent mismatches (schematic vs /docs)

| Where | Ref | Doc says | Schematic says | Severity |
|---|---|---|---|---|
| PoE front end + power tree input (sheet PoE.kicad_sch) | D1 | D1 = SMBJ58A TVS, VPP->VPN (bus surge clamp) | D1 = BAV70LT1G small-signal common-cathode array on GBR; no SMBJ58A anywhere | High |
| PoE front end + power tree input (sheet PoE.kicad_sch) | R21 / KILL_N | R21 100k pull-up from V_KBIAS to KILL_N (KILL_N high = RUN) | R21 connects V_KBIAS to Q3 collector; KILL_N has no pull-up | High |
| PoE front end + power tree input (sheet PoE.kicad_sch) | Q3 | Q3 BC857W: E=V_KBIAS, B=via R22, C=HOLD | Q3: E=HOLD node (C9/R25/R27), C=via R21 to V_KBIAS, B=via R22 | High |
| PoE front end + power tree input (sheet PoE.kicad_sch) | GBR routing | GBR -> FDMQ8205A GDC (GreenBridge gate-drive control) | GBR -> D1 BAV70 -> steers D2/D3 + U3-U6 discrete N-FET gate bias | Medium |
| PoE front end + power tree input (sheet PoE.kicad_sch) | C8 | C8 100nF VPP->VPN | C8 100nF VPP->GND(RTN) | Low |
| PoE front end + power tree input (sheet PoE.kicad_sch) | INA228 #1 (U10) I2C | INA228 on I2C1 (PB8=SCL, PB9=SDA) | I2C_SCL net (PB8) lands on U10 SDA pin4; I2C_SDA (PB9) on SCL pin5 (crossed) | High |
| 5V/3V3 main power supply (sheet 3v3-main-power.kicad_sch) | INA228 #8 0x43 (U30) vs #2 0x41 (U31) | peripheral_map: #8/0x43 = main/general 3.3V (3V3_STM); #2/0x41 = STM32 3.3V rail | U30 (0x43) senses across R102 75m at the general 3V3 buck output (3V3 rail); U31 (0x41) senses across R106 500m on the 3V3->3V3_STM segment. Which INA watches '3V3_STM' vs 'general 3V3' is inverted/ambiguous vs the doc wording. | Low |
| 5V/3V3 main power supply (sheet 3v3-main-power.kicad_sch) | U33 / U27 RT9742 variant | checklist/CLAUDE.md: RT9742 (generic) load switch | BOM+instance Value = RT9742VGJ5 (2A) but embedded symbol = CM5IO:RT9742GGJ5 (1A). Pinout identical so electrically harmless, but symbol/value/MPN disagree. | Low |
| 5V/3V3 main power supply (sheet 3v3-main-power.kicad_sch) | 3V3_PSU_PG availability | peripheral_map: MCP23017 PortA = 8x PG, expects readable PG for each rail | 3V3 buck PG net has no pull-up (see high-risk) so PortA bit reads stuck-low | Medium |
| Supercap backup supplies (U34/U35 TPS61094 ×2 + DSF305Q3R0 3F supercaps) | PA6 / PB1 | peripheral_map lines 265-266: GPS/STM supercap voltage via /2 divider | PA6/PB1 wired directly to SUP node (no divider) | Medium |
| Supercap backup supplies (U34/U35 TPS61094 ×2 + DSF305Q3R0 3F supercaps) | TPS61094 EN/MODE behavior | peripheral_map §14 open item: MODE/EN truth table & auto-backup behavior to be verified | EN=MODE=high (to VOUT) -> Auto buck/boost; verified against DS Table 7-4 (close the open item) | Low |
| Supercap backup supplies (U34/U35 TPS61094 ×2 + DSF305Q3R0 3F supercaps) | Backup output voltage | masters describe TPS61094 backup generically (no explicit OSEL value) | OSEL=3.09k -> VOUT_REG = 3.0 V (3.3 V via bypass when 3V3 present) | Low |
| Ethernet magnetics/input (sheet: ethernet-input.kicad_sch) | J1 | hardware checklist / prompt: "ARJ-199 integrated magjack" | Bel Fuse 0826-1X1T-HS-F | Low |
| Ethernet magnetics/input (sheet: ethernet-input.kicad_sch) | C1 | chassis HV coupling (implied 1nF/2kV class per LAN8742 checklist) | 4.7nF 16V X7R 0402 | Medium |
| Ethernet magnetics/input (sheet: ethernet-input.kicad_sch) | 3V3_LAN | net-naming doc mandates plain `3V3` rail names | `3V3_LAN` (separate ferrite-isolated PHY analog rail) | Low |
| Ethernet magnetics/input (sheet: ethernet-input.kicad_sch) | J1 symbol | part = 0826-1X1T-HS-F | symbol body sourced from 0826-1X1T-GH-F library | Low |
| Ethernet magnetics/input (sheet: ethernet-input.kicad_sch) | Bob-Smith termination | prompt lists external Bob-Smith + 75R/1nF-2kV as a verify item | termination is INTERNAL to the magjack (4×75Ω+1000pF/2kV); none external — correct, risk cleared | Info |
| Ethernet PHY (LAN8742AI-CZ-TR) — sheet ethernet-phy.kicad_sch | Y1 | BOM sts1000_bom.csv: Y1 = CTS 445I23E25M00000, 25.0000 MHz, 20 pF, SMD with package/datasheet | Y1 symbol Value='25MHz', Footprint empty, no MPN property | Medium |
| Ethernet PHY (LAN8742AI-CZ-TR) — sheet ethernet-phy.kicad_sch | J1 | BOM MPN 0826-1X1T-HS-F; Spec field 0826-1X1T-GH-F | J1 Value='0826-1X1T-HS-F', no footprint | Low |
| Ethernet PHY (LAN8742AI-CZ-TR) — sheet ethernet-phy.kicad_sch | R36/PA2 | peripheral_map §1: ETH_MDIO 1.5 kOhm pull-up to VDDIO | R36 1.5k pulls MDIO to 3V3_LAN (filtered analog rail), while VDDIO (U11 pin9) is on the main 3V3 net — pull-up rail differs from VDDIO rail (same 3.3 V nominal, electrically OK) | Low |
| Ethernet PHY (LAN8742AI-CZ-TR) — sheet ethernet-phy.kicad_sch | nINTSEL strap | peripheral_map §1: 'strap LAN8742 nINTSEL low at reset' for REF_CLK-Out mode; CLAUDE open item 'LAN8742 nINTSEL/REGOFF straps + LED polarity' | nINTSEL (pin2) is pulled low via R39 330R -> LED node -> R41 4.75k to GND, against the ~66k internal pull-up: Vpin ~0.24 V < VIL, so nINTSEL=0 (REF_CLK Out) latches correctly. Datasheet Fig 3.15 shows the pull-down directly on the pin; here it is after the 330R LED resistor — works, but deviates from the reference figure. | Low |
| MCU core (STM32H563VIT6, U12) | U12 symbol Datasheet property | Part is STM32H563VIT6 | Datasheet URL points to stm32h562ag.pdf (H562, not H563) | Low |
| MCU core (STM32H563VIT6, U12) | PH0 net name (U12 pin12) | peripheral_map canonical net OSC_IN (PH0 HSE-bypass from clock mux) | net labelled CLK_OUT (PH0-OSC_IN -> R187 22ohm -> mux U52.4/U53.2) | Low |
| MCU core (STM32H563VIT6, U12) | U12 footprint name | hardware/CLAUDE.md expects in-repo custom LQFP-100_STM | instance uses bare "100-LQFP" (nonexistent / unresolved) | High |
| External watchdog (U64 TPS3430, WDT sheet) | R169 (WDI pulldown) | R169 = 100 k�014 pulldown on WDT_KICK/WDI | R169 = 10k, in Rb-IO block; pin1 on R161/R164 divider net, pin2 on Net-(Q21-B); WDT_KICK has no pulldown | High |
| External watchdog (U64 TPS3430, WDT sheet) | U64 MPN | orderable TPS3430WDRCR (tape/reel) | value/MPN TPS3430WDRC, MANUFACTURER blank, flag MPN-FROM-VALUE | Low |
| External watchdog (U64 TPS3430, WDT sheet) | Fallback U62/D17/C145 | fallback inverter U62 74LVC1G04, OR-diode D17 BAT54, bypass C145 | U62=MX25L25645 SPI-NOR, D17=BAT54J (Rb IO), C145 not a WDT part | Low |
| GNSS receiver (ZED-F9T) — U21 ZED-F9T-00B, U22 LT3045 LDO, U23 INA228 @0x44 | GPS UART | peripheral_map L137: 'Firmware upgrade path: UART1 (PD8/PD9)' | PD8/PD9 = USART3 (peripheral_map L123/124 and CLAUDE.md both say USART3); STM32H5 PD8/PD9 are USART3_TX/RX | Low (doc-internal typo; schematic net mapping is correct) |
| GNSS receiver (ZED-F9T) — U21 ZED-F9T-00B, U22 LT3045 LDO, U23 INA228 @0x44 | U21 pin 19 GEOFENCE_STAT | PD5 = GPS_TXRDY / GEOFENCE_STAT (uses pin as TX_READY) | Net named GPS_TXRDY on symbol pin 19 whose default function is GEOFENCE_STAT; TX_READY on pin 19 requires UBX PIO reconfiguration in firmware | Low (intent matches; note firmware must remap PIO19 to TX_READY) |
| GNSS receiver (ZED-F9T) — U21 ZED-F9T-00B, U22 LT3045 LDO, U23 INA228 @0x44 | GPS SMA ESD | CLAUDE.md layout note: polymer ESD suppressor PLUS a separate coaxial gas-discharge arrestor for outdoor antenna runs | L10 = PGB1010603MR polymer ESD suppressor present on GPS_RF_IN; no coaxial GDT arrestor in the netlist | Medium (GDT is an outdoor-run/BOM open item, not on-board) |
| GNSS antenna bias + supervisor (gps-antenna.kicad_sch) | U27 | No load switch on the antenna feed; V_ANT goes directly to the Q11/Q12 foldback limiter | RT9742 load switch U27 gates V_ANT upstream (5V→U27→R89/U26→V_ANT→limiter) | High |
| GNSS antenna bias + supervisor (gps-antenna.kicad_sch) | L1 | 56 nH, Z≈554Ω @1.575GHz | 47 nH (LQG15HS47NJ02D), Z≈465Ω | Medium |
| GNSS antenna bias + supervisor (gps-antenna.kicad_sch) | R89/U26 | antenna-rail INA228 #4 measures V/I/P; current limit set by R77 only | second shunt R89 0.15Ω on U27 output feeds U26 INA228; adds an upstream sense point not in doc | Medium |
| GNSS antenna bias + supervisor (gps-antenna.kicad_sch) | Antenna POR state | antenna defaults ON when F9T ANT_OFF pin undriven (R78/Q14 path) | U27 EN pulled low (R88) → antenna defaults OFF until PC9 driven high | Medium |
| GNSS antenna bias + supervisor (gps-antenna.kicad_sch) | U25 footprint | LMV393 dual comparator | no footprint assigned to U25 in symbol/netlist | Medium |
| GNSS antenna bias + supervisor (gps-antenna.kicad_sch) | FB5/FB6/Q13/R74/R75/R88 | not all enumerated in §11 BOM | present (FB5 U25 5V, FB6 V_ANT, Q13 disable PNP, R88 EN pull-down) | Low |
| OCXO + steering supply (Y3 OH300, U39 TPS7A52 LDO, U38 AP3441 buck, U36 OPA320 Vc buffer, U37 INA228 #5) | U37 INA228 address | OCXO INA228 = 0x46 | Strapped to 0x47 (A1=VS, A0=SCL); collides with Rb U44 | High |
| OCXO + steering supply (Y3 OH300, U39 TPS7A52 LDO, U38 AP3441 buck, U36 OPA320 Vc buffer, U37 INA228 #5) | Vc-path capacitor dielectric | C0G/NP0 or film only, never X7R | C98/C99/C101 are X7R (GRM155R71C104) | High |
| OCXO + steering supply (Y3 OH300, U39 TPS7A52 LDO, U38 AP3441 buck, U36 OPA320 Vc buffer, U37 INA228 #5) | OCXO loop-filter scaling | scale DAC 0-3.3V to +/-0.4 ppm, set loop tau | unity buffer, Vc = full 0-3.3V, no scaling network | Medium |
| OCXO + steering supply (Y3 OH300, U39 TPS7A52 LDO, U38 AP3441 buck, U36 OPA320 Vc buffer, U37 INA228 #5) | Y3 symbol datasheet/description | OH300-61003CV-010.0M, 10 MHz, 3.3V CMOS | Symbol Datasheet=cx282.pdf, Description='100MHz Sinewave OCXO' | Low |
| Clock mux (OCXO/ext-ref -> PH0) | U52 | TSSOP6 (SOT363-2) package (sec 3.1, 5, A) | Footprint SC-74_TSOP6_SOT457_NEX = SOT457/SC-74 (0.95 mm pitch) | High |
| Clock mux (OCXO/ext-ref -> PH0) | FB10 | ferrite ~600 ohm @100 MHz, 0603 (sec 3.5, 5) | Footprint 1206; MPN Murata BLM31KN601SN1L (1206) | Low |
| Clock mux (OCXO/ext-ref -> PH0) | C160 | 100 nF C0G/X7R, 50 V (sec 3.3, 5) | 0.1uF X7R 16V (GRM155R71C104KA88J, 0402) | Low |
| Clock mux (OCXO/ext-ref -> PH0) | U53 | 74LVC1G34GW-Q100, Q100 grade, Nexperia (sec 5, A) | Value 74LVC1G34, TI datasheet, no grade, no footprint | Medium |
| External 10 MHz RF front end (refclock-input.kicad_sch) | U49 package | TMUX1101DCK SPST, SC70-6 (doc §4.4, §8, §2.1, and 'U49 pin 2' framing) | DCK = 5-pin SC70 (footprint SOT-353_SC-70-5). Verified TI pinout: 1=D,2=S,3=GND,4=SEL,5=VDD. Symbol+footprint are CORRECT (5-lead); the DOC's 'SC70-6' is wrong. | Low (doc error; hardware correct) |
| External 10 MHz RF front end (refclock-input.kicad_sch) | U51 PG (pin 4) | rf_frontend.md §4.7: 'PG (4) float; unused.' | PG is wired to MCP23017 U55 GPA2 via net 3V0_RF_LDO_PG (used as status). Doc is internally contradictory (same §4.7 also says 'PGFB connected to set the PG threshold'). Hardware intends PG used -> update doc and fix PGFB divider. | Medium |
| External 10 MHz RF front end (refclock-input.kicad_sch) | R177 (50 ohm termination) | 49.9 ohm 0.1% thin-film (RL>30 dB target) | BOM = ERJ-2RKF49R9X, 49.9 ohm 1% thick-film | Low (1% ~ 0.5 ohm error; RL still high, but grade/tech differs from doc) |
| External 10 MHz RF front end (refclock-input.kicad_sch) | R186 (LT3045 SET) | 30.1 kohm 0.1% (sets Vout=3.01 V; tight tolerance for Voh match + VCC-guard margin) | BOM = ERJ-2RKF3012X, 30.1 kohm 1% thick-film | Low-Medium (1% -> +/-30 mV on 3.0 V; affects U50 VCC margin slightly) |
| External 10 MHz RF front end (refclock-input.kicad_sch) | Designator renames vs doc body | Doc body still uses old refs D11/D12/D13/D14/D15, R134/R135/R140-R147, C133-C137 in places (TODO block at top acknowledges) | As-built: D8(SMA ESD), D18(=D15 switch clamp), D19(=D12 N2 clamp), D20(=D13 island), D21(=D14 VCC); R174/R175(N1 bias), R179/R180(VMID), R182(+IN bias), R183(VCC iso), R184(out damp), R176(term pull-up); C150(term blk), C151(AC-couple), C152/C153(VCC byp), C154/C156(Cin/Cout), C155(Cset) | Low (traceability; finish the doc re-annotation) |
| External 10 MHz RF front end (refclock-input.kicad_sch) | 3V0_RF / 5V power-symbol graphics | 3V0_RF is a 3.0 V island; 5V is the island input | Both nets use the power:+3.3V symbol GRAPHIC with overridden Value text ('3V0_RF', '5V'). Net names are correct; only the schematic glyph is misleading. | Low (cosmetic) |
| Rb buck supply (VCC_RB) | U43 VDD | sts1000_vcc_rb_supply.md §3: VDD -> +5V (C121 bypass) | U43.1 VDD -> 3V3 (C121 on 3V3) | High |
| Rb buck supply (VCC_RB) | U45 nSHDN | §3: 'shutdown pin tied for always-on' | U45.4 nSHDN -> Net-(Q19-C), gated by RB_PWR_EN via Q19/Q20 | High |
| Rb buck supply (VCC_RB) | VREF cap | §2: C115 = 2.2uF reference output cap on VREF_4V096 | Actual cap on VREF_4V096 is C182 = 1uF 0402 (C115 is a 10uF cap on the OCXO sheet); C182 missing from BOM | Medium |
| Rb buck supply (VCC_RB) | L7 value | §2: 40uH, Isat>=3A | BOM MPN SRP1265A-6R8M = 6.8uH/11.5A (Value field still '40uH'); footprint unassigned | High |
| Rb buck supply (VCC_RB) | C126/127/128 rating | §2/§6: COUT >=63V X7R | 47uF 16V X6S 1210 | High |
| Rb buck supply (VCC_RB) | INA228 #6 address | peripheral_map §4: Rb INA228 = 0x47 | Strap A1=VS,A0=SDA -> 0x46 (collides with OCXO 0x46); plus SDA/SCL swapped | High |
| Rb buck supply (VCC_RB) | FB reference | §5: V_FB = 0.600V | Consistent with MIC28516 datasheet FB=0.6V; transfer-function math verified (24.35V max, 4.46V min) - OK | Low |
| FE-5680A RS-232 interface (rb-io sheet) | RB_RS232_CMOS_SW / RB_SER_MODE | peripheral_map names the PE4 relay-mode net 'RB_SER_MODE'; subsystem doc names it 'RB_RS232_CMOS_SW' | net 'RB_RS232_CMOS_SW' on PE4 (U12 pin 3) | Medium |
| FE-5680A RS-232 interface (rb-io sheet) | U48 CTR | APC-817C1 CTR = 200–400% | part APC-817C1-SL; datasheet C1 = 200–260% (200–400% is C1+D1) | Medium |
| FE-5680A RS-232 interface (rb-io sheet) | R171 rating | R171 = 4.7k, 0.25W (0805/1206), ~91mW worst case at 24V | BOM R171 = 0402 (1/10W = 0.1W) | Medium |
| FE-5680A RS-232 interface (rb-io sheet) | Board connector ref | FE port pins referenced as J1-3/J1-8/J1-9 | board connector designator is J6 (J6-3/8/9) | Low |
| FE-5680A RS-232 interface (rb-io sheet) | D12 description | BAT54S (SOT-23 dual series) | FP SOT-23 correct, but Description text reads 'SOT-323' | Low |
| SPI peripherals (NOR flash, U62) | U62 footprint | Datasheet-verified, layout-ready parts | Footprint field empty in schematic/netlist/BOM | High |
| SPI peripherals (NOR flash, U62) | U62 VCC pin | NOR powered from always-on 3V3_STM | VCC pin has no pin number; not mappable to a pad | High |
| SPI peripherals (NOR flash, U62) | NOR WP net | Net names must match canonical naming (_N for active-low, e.g. NOR_RST_N) | Auto-named Net-(U62-nWP{slash}SIO2) | Low |
| I2C peripherals + display power | I²C peripheral rail | Gated 3V3_P (PERIPH_EN=PC11); back-power via PCA9517/TCA4311 buffer with far-side pull-ups on 3V3_P | All on always-on 3V3_STM; no gating, no buffer | High |
| I2C peripherals + display power | IIS2MDC C1 capacitor | 100nF on Vdd/Vdd_IO + 10µF bulk near supply | C176=220nF on C1 pin; no dedicated 10µF at U61 | Medium |
| I2C peripherals + display power | LIS2DH12 SA0 address | Open item: commit 0x18 vs 0x19 | Committed 0x19 (SA0→3V3_STM) | Low |
| I2C peripherals + display power | TMP117 designator-to-address | #1(osc)=0x48 ADD0→GND, #2(ambient)=0x49 ADD0→V+ | U57 ADD0→V+ (0x49), U58 ADD0→GND (0x48) | Low |
| Fault/UI aggregation (MCP23017 ×2: U55 @0x20, U54 @0x21) | GPA7/GPB7 input restriction (U54 GPA7, U54 GPB7, U55 GPA7) | sts1000_fault_aggregation.md maps DISP_TOUCH_INT, INA_ALERT_VCC_RB, POE_PG as readable inputs on bit-7 pins and nowhere notes the MCP23017 GPA7/GPB7 input prohibition | Same bit-7 input mapping in the netlist — violates the Microchip restriction the part's own symbol Description cites | High |
| Fault/UI aggregation (MCP23017 ×2: U55 @0x20, U54 @0x21) | R44 / INA_ALERT_INT_N pull-up | Open item §10/CLAUDE.md: 'Drop legacy R44 at PC12 (else 10k\|\|10k=5k)' | R44 is 3V3_LAN<->TRD0_N (Ethernet PHY 49.9-ohm-class term), NOT on INA_ALERT_INT_N; only R199 pulls up the net (single 10k) | Low |
| Fault/UI aggregation (MCP23017 ×2: U55 @0x20, U54 @0x21) | U55 GPB2-7 spare | §1 lists GPB2-7 as '6 spare (NC)' | Pins 27,28,3,4 unconnected (floating, no GPPU strap) | Low |
| I2C1 bus + rise-time accelerator (U56 LTC4311) | I2C1 net naming | I2C1 (PB8/PB9) per peripheral_map; naming convention doc implies bus-indexed names | Global labels I2C_SCL / I2C_SDA (no bus index) | Low |
| I2C1 bus + rise-time accelerator (U56 LTC4311) | U56 BOM line 525 | BOM standardization expects populated Footprint / package / pinout-match fields | Footprint column blank; status MPN-FROM-VALUE | Low |
| Connectors, USB-C console, panel UI, display IF (connectors.kicad_sch) | U65 / USB CC | usb_console_interface.md §6.1: CC1/CC2 are unprotected | U65 (TPD4E05U06DQAR) protects both CC1 and CC2 | Low |
| Connectors, USB-C console, panel UI, display IF (connectors.kicad_sch) | R67 | usb_console_interface.md §8.1 TODO: netlist wires R67 USB_VBUS->GND (suspected bug) | R67 is USB_VBUS_SENSE->GND (correct divider bottom leg) | Low |
| Connectors, USB-C console, panel UI, display IF (connectors.kicad_sch) | J4 pin 11 | display reset on PA8/DISP_RST; module pin 11 (per LCDwiki MSP4030) = CTP_RST | J4.11 connected to DISP_RST (LCD reset) | High |
| Connectors, USB-C console, panel UI, display IF (connectors.kicad_sch) | D7 | sts1000_vcc_rb_supply.md: 1.5SMCJ28A TVS on VCC_RB | D7 = 1.5SMCxxA (placeholder) | High |
| Connectors, USB-C console, panel UI, display IF (connectors.kicad_sch) | RTC net name | RTC_TAMP | RTC_TAMPER | Low |
| Connectors, USB-C console, panel UI, display IF (connectors.kicad_sch) | PG_INT_N | checklist open item: fix PG_IN_N -> PG_INT_N | net already named PG_INT_N (fix applied) | Low |
| RGB status indicator (D5) | D5 | Footprint = symbol default LED_SMD:...PLCC6_5.0x5.5mm_P1.8mm; verify pin#-to-pad# vs PLCC-6 datasheet (1 CathB/2 CathR/3 CathG/4 AnG/5 AnR/6 AnB) | Footprint overridden to 'Library:LED_IN-P55TATRGB' which does not exist (no fp-lib-table, no .kicad_mod) | Blocker |
| RGB status indicator (D5) | R59/R60/R61 | 0603 (100 mW) on all ballasts; do not use 0402 on red/blue | all three ballasts are R_0402_1005Metric | Medium |
| RGB status indicator (D5) | 5V rail | 5V = MIC28516 5 V intermediate (CLAUDE.md) | net '5V' sourced by U29 (AP3441) per netlist; still always-on and gates 5V_DISP via U33 RT9742 | Low |

## 7. IC-by-IC review (grouped by subsystem)

### PoE front end + power tree input (sheet PoE.kicad_sch)  —  _verdict: Blocked_

## PoE Front End + Power Tree Input — Pre-Layout Review (sheet `PoE.kicad_sch`)

**Verdict: BLOCKED.** Three blockers: (1) the documented POE_KILL self-sustaining kill network is miswired — `KILL_N` has no pull-up and Q3/R21 are connected differently from the canonical design, so default-RUN and the AUX-actuated cold-cycle are indeterminate; (2) the mandated input surge TVS (SMBJ58A across VPP→VPN) is absent — D1 is a BAV70 used for GBR steering, not the bus clamp; (3) the INA228 I2C bus is crossed (clock on SDA pin, data on SCL pin) on U10 and every other INA228.

Architecture confirmed correct in principle: FDMQ8205A (U7/U8) is a **passive quad-MOSFET array** (2× P-ch + 2× N-ch), so the discrete ideal-diode gate-drive (U3–U6 BC846BPDW + D2/D3 6.8V arrays) is legitimate; NCP1095 (U9) drives an **external** pass FET (Q2 FDMC8622) via PGATE/PSNS; RDET 26.1k (R15) and Class 6 (RCLASSA 232 R13 / RCLASSB 909 R14) match the datasheet-cited doc and satisfy the "Type 2 min / Type 3 margin" requirement.

#### IC / active-device-by-IC
| RefDes | MPN | Function | Datasheet | Package | Symbol pinout verified | Footprint verified | Power/Gnd pins | Strap/EN/RST pins | Required passives | Layout-critical notes | Status | Conf |
|---|---|---|---|---|---|---|---|---|---|---|---|---|
| U7 | FDMQ8205A | Ideal-diode bridge #1 (pairs VC1/VC2) | onsemi fdmq8205a-d | 12-MLP (16-pad array; embedded sym `FDMQ8205A_1`) | Yes — INPUT1=13/14, INPUT2=15/16, OUTP=5-8, OUTN=2/3/10/11, G1=1,G2=4,G3=9,G4=12 | Footprint prop="12-MLP" (generic string, not a lib path) — must confirm exact onsemi 12-MLP land + exposed pad | OUTP→VOUT_P, OUTN→VOUT_N | Gates externally driven (U3/U4) | U3,U4 (BC846 drivers), TR0/TR1 taps | High AC current; place at magjack; gate-drive loops short; 100V VDS | WARNING | High |
| U8 | FDMQ8205A | Ideal-diode bridge #2 (pairs VC3/VC4) | same | 12-MLP | Yes (same as U7) | Same caveat as U7 | OUTP→VOUT_P, OUTN→VOUT_N | Gates ext (U5/U6) | U5,U6, TR2/TR3 taps | Same | WARNING | High |
| U9 | NCP1095DBR2 | 802.3bt PD interface controller, external FET | onsemi ncp1095-d (Rev2) | 16-TSSOP | Yes — VPP1,CLA2,CLB3,AUX4,COSC5,ACS6,DET7,VPN8,PSNS9,PGATE10,GBR11,RTN12,LCF13,PGO14,NCM15,NCL16 (matches web) | TSSOP-16 generic — confirm | VPP→VOUT_P, VPN/RTN | AUX(kill), PGO(buck EN), ACS→VPN (autoclass off) | R13/R14/R15, Q2, R16, C6 | RTN floats to VPP off-state; keep PSNS Kelvin to R16 | WARNING (kill net miswire upstream) | High |
| U10 | INA228AQDGSRQ1 | PoE-input power monitor #1 (0x40) | TI ina228-q1 | VSSOP-10 DGS (lib `INA228AQDGSRQ1`) | Yes — A1=1,A0=2,ALERT=3,SDA=4,SCL=5,VS=6,GND=7,VBUS=8,IN-=9,IN+=10 | DGS-10 | VS→3V3, GND→GND | A0,A1→GND (=0x40); ALERT→GPB0 | R30 shunt (VOUT_P→V_POE) | I2C crossed (see below); shunt Kelvin | FAIL (SDA/SCL swap) | High |

#### Netlist findings
| Net | Connected pins | Expected | Observed issue | Risk | Fix | Status |
|---|---|---|---|---|---|---|
| KILL_N | Q1.C, Q5.C, R22.2 | Pull-up (R21→V_KBIAS) + Q3 base drive; default HIGH=RUN | No pull-up at all; R21 not here; only open-collector pulldowns + R22 base series | Kill logic floating/indeterminate; default-RUN broken | Add R21 100k KILL_N→V_KBIAS; route Q3.B from KILL_N via R22 | FAIL |
| Net-(Q3-C) / Net-(Q3-E) | R21.2+Q3.C ; Q3.E+C9.2+R25.1+R27.1 | Q3 E=V_KBIAS, C=HOLD | Q3 reversed: E=HOLD, C→R21→V_KBIAS | Sustain switch non-functional | Swap Q3 E/C per doc | FAIL |
| VOUT_P | C8,C10,C75/77/80/133/134/136, R18/R20/R30/R2/R90/R101/R132/R162, U7/U8 OUTP, U9 VPP, U28/U40 PVIN, U10 IN+ | Bridge DC+; bulk + TVS clamp | No TVS to VOUT_N | Unclamped PD surge | Add SMBJ58A VPP→VPN | FAIL |
| GBR | U9.11, D1.3 (K) | GreenBridge disable to bridge gate-drive | Goes only to BAV70 D1 (steers D2/D3, U3-U6 N-FET bias) — body-diode reversion unverified | Possible offline↔reset oscillation if reversion fails | Bench-verify VOUT_P survives GBR-low | WARNING |
| I2C_SCL / I2C_SDA | I2C_SCL→PB8 & U10.4(SDA)…; I2C_SDA→PB9 & U10.5(SCL)… | SCL→pin5, SDA→pin4 | Crossed at every INA228 | I2C bus dead | Swap labels at INA228 bank | FAIL |
| Net-(U9-DET)/COSC | DET7→R15→COSC5→C6 | RDET 26.1k DET-COSC + Cosc | Correct (R15=26.1k) | — | — | PASS |
| Net-(U9-CLA)/CLB | CLA2→R13(232)→VPN; CLB3→R14(909)→VPN | Class 6 | Correct | — | — | PASS |
| POE_PG | PGO14, R20→VOUT_P, U28.EN, GPA7 | PGO open-drain gates buck EN, pull-up to VPP | Correct (resolves doc open item 4) | — | — | PASS |
| VAUX | AUX4, R27.2, R29.1, C11.2 | HOLD÷(R27/R29) filtered by C11 | Correct divider/filter | depends on HOLD fix | fix Q3 first | WARNING |
| Net-(Q2-S) | PSNS9, R16.1side, Q2 S(1/2/3) | RSNS Kelvin | Correct topology | confirm FET footprint | verify FDMC8622 pads | WARNING |

#### BOM validation (PoE sheet, selected)
| RefDes | MPN | Datasheet found | Package | Footprint | Pkg-FP match | Pinout match | Rating match | Status | Notes |
|---|---|---|---|---|---|---|---|---|---|
| U7/U8 | FDMQ8205A | Yes | 12-MLP array | "12-MLP" string | Verify | Yes | 100V VDS OK | WARNING | Footprint is a bare string, not lib path |
| U9 | NCP1095DBR2 | Yes | TSSOP-16 | 16-TSSOP | OK | Yes | OK | PASS | — |
| U10 | INA228AQDGSRQ1 | Yes | VSSOP-10 DGS | DGS lib | OK | Yes (sym), but bus crossed | 85V OK | FAIL | I2C swap |
| U3-U6 | BC846BPDW1T1G | Yes | SOT-363 | SOT-363 | OK | n/a | 65V | PASS | gate drivers |
| D1 | BAV70LT1G | Yes | SOT-23-3 | SOT-23-3 | OK | Yes | 100V | WARNING | Doc expected SMBJ58A TVS here — role mismatch |
| D2/D3 | DF6A6.8FUT1G | Yes | SOT-363 | SOT-363 | OK | Yes | 6.8V WM | WARNING | BOM value string "DFA6A6.8FUT" malformed |
| D4 | 12V Zener | No (SELECT) | — | none | — | — | TBD | FAIL | unsourced |
| Q2 | FDMC8622 | Yes | 8-PowerWDFN | 8-PowerWDFN | Verify | Verify S/G/D | 100V/40mΩ | WARNING | confirm pad map |
| R13/R14/R15 | 232/909/26.1k | Yes | 0402/0402/0402 | OK | OK | n/a | OK | PASS | Class6+RDET |
| R16 | 25m sense | No MPN | 1206 | 1206 | — | n/a | TBD | WARNING | SHUNT-REVIEW; sets ILIM |
| R30 | 150m sense | No MPN | 0805 | 0805 | — | n/a | TBD | WARNING | INA228 #1 shunt |
| R18 | 24.9k ERJ-2RKF2492X | Yes | 0402 1/10W | 0402 | OK | n/a | ~81mW vs 100mW | WARNING | uprate to ≥1/4W |
| C6/C7/C9/C11 | unsourced | partial | 0402/0603 | OK | — | n/a | "100V?" | WARNING | REVIEW-HV |
| C8 | 0.1µF 100V | partial | 0402 | OK | OK | n/a | 100V OK | WARNING | ref VPP→RTN vs doc VPP→VPN |
| C10 | 10µF 100V | partial | 0805 | OK | OK | n/a | 100V | PASS | this is CPD bulk (resolves doc open item 3) |

#### Symbol / footprint
| RefDes | MPN | Datasheet package | Symbol pin#s match | Assigned footprint | Pad#s match | Pin-1/orientation | Status |
|---|---|---|---|---|---|---|---|
| U7/U8 | FDMQ8205A | 12-MLP 16-pad | Yes (embedded) | "12-MLP" (string only) | Unverified — no lib_mod found in /libraries | Unverified | WARNING |
| U9 | NCP1095 | 16-TSSOP | Yes | 16-TSSOP | Likely std | Std | PASS |
| U10 | INA228 | DGS-10 | Yes | DGS | Std | Std | PASS |
| Q2 | FDMC8622 | 8-PowerWDFN | n/a generic | 8-PowerWDFN | Verify S=1-3/G=4/D=5-8+pad | Verify | WARNING |

#### Layout-critical constraints
| Net/class | Current est | Width/impedance | Placement / return path | Evidence |
|---|---|---|---|---|
| VOUT_P/VOUT_N bus | ~1.1A @48V (Class6 51W) | Wide pour, short loop bridge→Q2→bulk | TVS+bulk at PD input; tie surge return to RTN | doc; netlist |
| RSNS R16 (PSNS) | full load + inrush | Kelvin sense to PSNS/PGATE | sense traces away from power loop | netlist Net-(Q2-S) |
| Magjack taps TR0-3 | per-pair | balanced; bridge near connector | minimize tap-to-bridge length | TR*_TAP nets |
| 3V3 / I2C | mA | std | INA228 pull-ups on 3V3 | nets 3V3,I2C |
| V_KBIAS / R18 | ~1.8mA, 81mW | n/a | R18 ≥1/4W package | doc line 145 |

### 5V/3V3 main power supply (sheet 3v3-main-power.kicad_sch)  —  _verdict: Blocked_

## 5V / 3V3 Main Power Supply — Pre-Layout Review

Sheet: `hardware/ntp-server-stm32/3v3-main-power.kicad_sch`. Two switchers: **U28 MIC28516T-E/PHA** (PoE/VOUT_P → 5V, 8A) and **U29 AP3441SHE-7B** (5V → 3V3, 3A). Three **INA228** rail monitors (U30/U31/U32) and one **RT9742** display load switch (U33). FB output-voltage math is **correct** (MIC28516/AP3441 Vref = 0.6 V, verified). Two board-killing defects block layout: a scrambled AP3441 symbol pin map and a board-wide I²C SDA/SCL swap.

### IC-by-IC

| RefDes | MPN | Function | Datasheet | Package | Symbol pinout verified | Footprint verified | Power/Gnd pins | Strap/EN/RST pins | Required passives | Layout-critical notes | Status | Conf |
|---|---|---|---|---|---|---|---|---|---|---|---|---|
| U28 | MIC28516T-E/PHA | 70V/8A sync buck → 5V | DS20006315 | 32-VQFN 6×6 EP | Yes (1:1 vs ds) | name `32-PowerVQFN` (verify EP/pad map) | PVIN 5-11=VOUT_P; PGND 2,16-19,22,29,33+EP=GND; AGND 28=GND; VDD30,PVDD21,SVIN31,EXTVDD23 | EN24=POE_PG; FREQ25=R90/R91; ILIM1=R93→SW; SS26=C63; PG32=5V_PSU_PG | BST C68 0.1µF; R101 2.2Ω SVIN; R103 2.2Ω PVDD; C79/C81/C82 bias; FB R97 15k/R98 2.05k; C69 4.7nF ff | High di/dt SW node (C68-Pad2); EP thermal; keep FB/ILIM short; EXTVDD→GND | WARNING | High |
| U29 | AP3441SHE-7B | 2.7-5.5V/3A sync buck → 3V3 | DS39754 | DFN2020-8 EP | **NO — pins 4/5/7/8 scrambled** | `8-UFDFN (Exposed Pad)` (must re-verify) | VIN3=5V; PGND7(ds)/SGND4(ds); EP=PGND | EN5(ds)=stranded on symbol nc → **never enables**; PG2 | FB R99 10k/R100 2.2k; C70 4.7nF ff; Cin C71/C72; Cout on U30-IN+ | Symbol fix mandatory before any layout | FAIL | High |
| U30 | INA228AQDGSRQ1 | Rail monitor #8 0x43 (general 3V3) | TI INA228-Q1 | VSSOP-10 DGS | Yes (pin fn match ds) | `VSSOP10_DGS_TEX` | VS6=3V3, VBUS8=3V3, GND7 | A1=GND, A0=I2C_SDA-net | shunt R102 75mΩ; C73/74/76/78 Cout; C83/86/87 | **SDA/SCL swapped** (see netlist) | FAIL | High |
| U31 | INA228AQDGSRQ1 | Rail monitor #2 0x41 (STM 3V3) | TI INA228-Q1 | VSSOP-10 DGS | Yes | `VSSOP10_DGS_TEX` | VS6=3V3, VBUS8=3V3_STM, GND7 | A1=GND, A0=3V3(VS)→0x41 ✓ | shunt R106 500mΩ (3V3↔3V3_STM) | **SDA/SCL swapped** | FAIL | High |
| U32 | INA228AQDGSRQ1 | Rail monitor #7 0x42 (5V_DISP) | TI INA228-Q1 | VSSOP-10 DGS | Yes | `VSSOP10_DGS_TEX` | VS6=3V3, VBUS8=U32-IN-, GND7 | A1=GND, A0=I2C_SCL-net→0x42 ✓ | shunt R107 100mΩ; C85 | **SDA/SCL swapped**; senses RT9742 output side | FAIL | High |
| U33 | RT9742VGJ5 (sym says GGJ5) | 5V→5V_DISP load switch | RT9742 DS9742 | TSOT-23-5 | Yes | `TSOT-23-5` | IN5=5V, GND2 | EN4=DISP_EN (PC11); nFLG3=V_DISP_EN_FAULT | R104 10k EN pulldown; R105 10k nFLG pull-up to 3V3_STM; C84 Cin | Variant VGJ5(2A) vs symbol GGJ5(1A): pinout same | WARNING | High |

### Netlist findings

| Net | Connected pins | Expected | Observed issue | Risk | Fix | Status |
|---|---|---|---|---|---|---|
| I2C_SCL / I2C_SDA | U12 PB8(95)→I2C_SCL, PB9(96)→I2C_SDA; all INA228 SDA(p4)→I2C_SCL, SCL(p5)→I2C_SDA | Slave SDA↔master SDA, SCL↔SCL | **Clock/data swapped at every slave** | Bus dead | Swap SDA/SCL at INA228 pins (global) | FAIL |
| AP3441 EN (ds pin5) | wired to symbol "nc" pin5 | EN ← 5V_PSU_PG | Real EN stranded; PGND(ds7) driven to 5V | Buck never runs | Fix symbol pin order | FAIL |
| 3V3_PSU_PG | U29 PG(OD) –R94 2.2k– node –R92 10k– GND, U55 GPA4 | OD PG with pull-up to rail | **No pull-up; reads stuck low** | PG unusable | Pull-up R94/R92 to 3V3(_STM) | FAIL |
| Net-(C67-Pad1) | C67p1, R96p2 (R96p1 on SW) | (ripple-inject?) | SW coupled into FB via R96+C67 | FB noise / unverified | Verify vs ds ripple-injection or delete | WARNING |
| 5V_PSU_PG | U28 PG(OD)+R95→5V; →EN of U29/U38/U13/U51; U55 GPA3 | OD PG w/ pull-up, sequences downstream | OK; EN=5V within AP3441 limit | — | — | PASS |
| Net-(U28A-BST) | C68p1, U28 BST(4) | BST cap to SW | OK (C68 BST↔SW) | — | — | PASS |
| L2/L3 footprints | empty | assigned FP | No footprint on either inductor | Cannot route | Assign SRP1265A / DR73 FPs | FAIL |

### FB / output-voltage math (verified)

| Rail | IC | Vref | Top R | Bot R | Computed Vout | Target | Status |
|---|---|---|---|---|---|---|---|
| 5V | U28 MIC28516 | 0.6 V | R97 15k | R98 2.05k | 0.6×(1+15/2.05)=**4.99 V** | 5.0 V | PASS |
| 3V3 | U29 AP3441 | 0.6 V | R99 10k | R100 2.2k | 0.6×(1+10/2.2)=**3.33 V** | 3.3 V | PASS |

### BOM validation (key lines)

| RefDes | MPN | DS found | Package | Footprint | Pkg-FP match | Pinout match | Rating match | Status | Notes |
|---|---|---|---|---|---|---|---|---|---|
| U28 | MIC28516T-E/PHA | Yes | VQFN-32 EP | 32-PowerVQFN | Yes | Yes | 70V/8A ≫ 5V load | PASS | EXTVDD→GND, verify EP |
| U29 | AP3441SHE-7B | Yes | DFN2020-8 EP | 8-UFDFN(EP) | needs check | **No (symbol scrambled)** | 5.5V/3A ≥ 3V3 load | FAIL | symbol fix |
| U30/31/32 | INA228AQDGSRQ1 | Yes | VSSOP-10 | VSSOP10_DGS_TEX | Yes | Yes | 85V/AEC-Q100 | WARNING | bus swap (wiring) |
| U33 | RT9742VGJ5 | Yes | TSOT-23-5 | TSOT-23-5 | Yes | Yes | 2A | WARNING | symbol=GGJ5 (1A) mismatch |
| L2 | SRP1265A-6R8M | Yes | 12.5×12.5 | **(none)** | — | — | 6.8µH/11.5A | FAIL | assign FP |
| L3 | DR73-2R2-R | Yes | DR73 | **(none)** | — | — | 2.2µH/4.15A | FAIL | assign FP + verify Isat |

### Symbol / footprint

| RefDes | MPN | DS package | Symbol pin#s match | Assigned footprint | Pad#s match | Pin-1/orient verified | Status |
|---|---|---|---|---|---|---|---|
| U29/U38 | AP3441SHE-7B | DFN2020-8 (1FB 2PG 3VIN 4SGND 5EN 6LX 7PGND 8NC) | **No (4,5,7,8 wrong)** | 8-UFDFN(EP) | unknown — re-verify after symbol fix | No | FAIL |
| U28/U40 | MIC28516 | VQFN-32 EP | Yes | 32-PowerVQFN | likely (re-verify EP=PGND) | — | WARNING |
| U30/31/32 | INA228 | VSSOP-10 DGS | Yes | VSSOP10_DGS_TEX | Yes | — | PASS |
| U33 | RT9742VGJ5 | TSOT-23-5 | Yes (symbol labeled GGJ5) | TSOT-23-5 | Yes | — | WARNING |

### Layout-critical constraints for this block

| Net/class | Current est. | Width/impedance | Placement / return path | Evidence |
|---|---|---|---|---|
| VOUT_P (PoE/PD bus → U28 PVIN, also U40 Rb buck) | up to ~5-6A peak (5V buck input + Rb cold-start share) | wide pour/plane; tight Cin (C64/65/66/71/72) loop | Cin caps hugging U28 PVIN/PGND; minimize hot loop | peripheral_map §6 (~25-30W cold-start) |
| 5V rail (U28 out, L2 → 5V) | ~1.5-2.5A (3V3 buck draw ÷η + 5V_DISP ~0.5A) | plane/wide trace; Cout C64/65/66 near L2 | L2 close to SW; SW node (C68-Pad2) small/quiet | INA228 #8/#2 loads, display |
| SW node U28 (Net-(C68-Pad2)) | switched, high di/dt | minimal copper area, keep BST C68 + ILIM R93 adjacent | shield from FB & FREQ | MIC28516 ds |
| 3V3 rail (U29 out, L3 → 3V3 → 3V3_STM) | ~1.5-2.5A (MCU+PHY+all housekeeping + GPS share) | plane; Cout C73/74/76/78 at L3; star to 3V3_STM via R106 | L3 close to U29 LX; SGND/PGND split per ds | peripheral_map §6 |
| INA228 shunts R102(75mΩ)/R106(500mΩ)/R107(100mΩ) | Kelvin sense | 4-wire/Kelvin to IN+/IN−; symmetric | sense traces routed as differential pair from pads | INA228 ds (Kelvin) |
| Thermal | U28 EP (8A class) + L2 | large EP pad + vias to inner GND | EP thermal vias array; keep from OCXO/Rb | ds thermal |

### Design-intent mismatches

| Ref | Doc says | Schematic says | Severity |
|---|---|---|---|
| INA228 0x43 vs 0x41 | #8/0x43=3V3_STM, #2/0x41=STM 3.3V | U30/0x43 senses general 3V3 output; U31/0x41 senses 3V3→3V3_STM segment (inverted vs wording) | Low |
| RT9742 variant | RT9742 generic | Value/BOM=VGJ5(2A), symbol=GGJ5(1A) | Low |
| 3V3 PG readable | PortA = 8× PG (all readable) | 3V3_PSU_PG has no pull-up → stuck low | Medium |

**Sources:** MIC28516 DS20006315 (Microchip; FB 0.6V, EXTVDD/PVDD/SVIN/FREQ/ILIM pin functions); MIC28516/517 training (Microchip, 0.6V ref confirmed); AP3441 DS39754 (Diodes; pinout 1FB-2PG-3VIN-4SGND-5EN-6LX-7PGND-8NC, FB 0.6V, EN>1.5V, Vin 2.7-5.5V, 3A, 1MHz); INA228/INA228-Q1 (TI SLYS228; DGS pinout, addr table); RT9742 DS9742-10 (Richtek; VGJ5=2A vs GGJ5=1A); netlist `ntp-server-stm32.net`; sheet `3v3-main-power.kicad_sch`; `docs/ntp_server_peripheral_map.md`.

### Supercap backup supplies (U34/U35 TPS61094 ×2 + DSF305Q3R0 3F supercaps)  —  _verdict: Needs corrections_

## Supercap backup supplies — pre-layout review

Two independent TPS61094 bi-directional buck/boost supercap managers: **U34** backs up the ZED-F9T `V_BCKP` (GPS ephemeris/RTC), **U35** backs up the STM32H563 `VBAT`. Each is fed from main **3V3** (VIN), charges a **3F DSF305Q3R0** supercap on its SUP pin through a 2.2 µH inductor, and holds its VOUT during a 3V3 loss. Config is fully strapped/autonomous (no MCU control lines), exactly as the masters intend. The topology is sound and self-bootstrapping, but several items must be fixed before layout.

Datasheet: TI **TPS61094** SLVSFH6C (Dec 2021), https://www.ti.com/lit/ds/symlink/tps61094.pdf. Supercap: Cornell Dubilier **DSF305Q3R0**, 3 F / **3.0 V**, radial, 3.5 mm pin pitch, https://www.cde.com/resources/catalogs/DSF.pdf.

#### Strap decode (verified vs datasheet Tables 7-1/7-2/7-3/7-4)
| Pin | Strap (U34 / U35) | Net | Decode | Result | Status |
|---|---|---|---|---|---|
| OSEL (1) | R116 / R117 = 3.09 k → GND | Net-(U34/35-OSEL) | Table 7-1: 3.09 k | **VOUT_REG = 3.0 V** | PASS |
| VCHG (12) | R112 / R113 = 6.65 k → GND | Net-(U34/35-VCHG) | Table 7-2: 6.65 k | **Charge term = 2.5 V** | PASS (safe for 3.0 V cap) |
| ICHG (11) | R114 / R115 = 9.53 k → GND | Net-(U34/35-ICHG) | Table 7-3: 9.53 k | **Charge I = 25 mA** | PASS |
| EN (3) | R108 / R109 = 100 k → **VOUT** | Net-(U34/35-EN) | high | enabled | WARNING (see note) |
| MODE (2) | R110 / R111 = 100 k → **VOUT** | Net-(U34/35-MODE) | high | Auto buck/boost | WARNING (see note) |

EN/MODE both high ⇒ **Auto buck/boost** (Table 7-4): when VIN(3.3 V) > VOUT_target(3.0 V)+100 mV the buck charges the supercap and VOUT≈VIN via bypass; when VIN fails the boost holds VOUT=3.0 V from the supercap. Normal `V_BCKP`/`VBAT` ≈ 3.3 V (bypass), backup ≈ 3.0 V — inside STM32H5 VBAT (1.65–3.6 V) and ZED-F9T V_BCKP (1.4–3.6 V) ranges.

#### IC-by-IC
| RefDes | MPN | Function | Datasheet | Package | Symbol pinout | Footprint | Pwr/Gnd | Strap/EN/RST | Required passives | Layout-critical | Status | Conf |
|---|---|---|---|---|---|---|---|---|---|---|---|---|
| U34 | TPS61094DSSR | GPS V_BCKP supercap mgr | SLVSFH6C | WSON-12 DSS 3.0×2.0×0.8 + EP | PASS (1 OSEL…13 EP match Table 5-1) | `SON50P300X200X80-13N` in libraries/ — **fp-lib-table empty, nickname won't resolve** | VIN=3V3(4); PGND7/AGND8/EP13=GND ✓ | EN/MODE→VOUT 100k; OSEL/VCHG/ICHG 1% to GND ✓ | L4 2.2µH (SW–SUP); C90 3F (SUP); C92/C94/C96 3×22µF VOUT | EP thermal vias; keep SW loop tight; supercap thermal ≤75 °C | WARNING | High |
| U35 | TPS61094DSSR | STM32 VBAT supercap mgr | SLVSFH6C | same | PASS | same fp issue | VIN=3V3(4); GND ✓ | EN/MODE→VOUT 100k; OSEL/VCHG/ICHG 1% to GND ✓ | L5 2.2µH; C91 3F; C93/C95/C97 3×22µF VOUT | same | WARNING | High |

#### Passive / value validation vs datasheet recommended operating conditions
| Item | Schematic | DS requirement | Verdict |
|---|---|---|---|
| Inductor L4/L5 | 2.2 µH | 1 or 2.2 µH (eff 0.7–2.86 µH) | Value PASS; **no MPN/footprint selected** (BOM "SELECT") |
| COUT (VOUT) | 3×22 µF X7R 0805 = 66 µF nom | **20–30 µF effective (NOM 20, MAX 30)** | **WARNING: exceeds recommended max even after DC-bias derate (~45–50 µF eff)** |
| CIN (VIN) | none local; shares 3V3 plane bulk | ≥2.2 µF effective at VIN pin | WARNING: add local VIN cap at each IC for layout |
| CSUP | DSF305Q3R0 3 F (the supercap) | ≥2.2 µF | PASS (supercap is the SUP cap) |
| Config R accuracy | ERJ-2RKF = 1% | 1% required, <10 pF parasitic | PASS |

#### Netlist findings
| Net | Connected pins | Expected | Observed issue | Risk | Fix | Status |
|---|---|---|---|---|---|---|
| BKP_GPS_SOC_V | C90.1, L4.2, U12 PA6, U34 SUP(6) | SUP = supercap + inductor + SOC sense | PA6 senses SUP **directly, no /2 divider** (doc says /2) | Firmware mis-scales SOC ×2 if it assumes divider | Reconcile: remove "/2" from doc OR add divider; VCHG=2.5V<3.3V so direct sense is fine | WARNING |
| BKP_STM_SOC_V | C91.1, L5.2, U12 PB1, U35 SUP(6) | same | same — no divider | same | same | WARNING |
| code60 (U34 VOUT) | U34 VOUT9/10, U21 V_BCKP(36), R108.1, R110.1, C92/C94/C96 | boosted backup rail | 66 µF > DS COUT max 30 µF | possible slow soft-start / loop margin | reduce to ~22–33 µF eff or confirm via TI sim | WARNING |
| code309 (U35 VOUT) | U35 VOUT9/10, U12 VBAT(6), R109.1, R111.1, C93/C95/C97 | backup VBAT rail | same | same | same | WARNING |
| Net-(U34-EN/MODE/OSEL/VCHG/ICHG) etc. | strap R + IC pin (2-node) | named per convention | auto-named; not canonical | cosmetic | name nets per sts1000_net_naming | INFO |

#### Symbol / footprint
| RefDes | MPN | DS package | Symbol pin#s | Footprint | Pad#s | Pin-1/orient | Status |
|---|---|---|---|---|---|---|---|
| U34/U35 | TPS61094DSSR | WSON-12 0.5 mm, 3.0×2.0 mm + EP | 13 pins, 1=OSEL…12=VCHG,13=EP — matches Table 5-1 | SON50P300X200X80-13N | 12 perimeter (0.5 mm pitch) + pad13 EP (1.0×2.65) | pin-1 circle at pad1 ✓ | PASS (lib-table resolution must be fixed) |
| C90/C91 | DSF305Q3R0 | radial can, 3.5 mm pitch | n/a (Device:C_Polarized? uses Device:C) | **"Radial" (placeholder, not a real footprint)** | — | — | FAIL |

#### Layout-critical constraints
| Net/class | Current est | Width/notes | Placement / return | Evidence |
|---|---|---|---|---|
| SW (U34/35 ↔ L4/L5) | peak ~0.3–0.5 A (pre-charge 300 mA) | short, wide; minimize loop area | keep SW–L–SUP–IC loop tight; EP thermal vias | DS §10 layout, §7.3.2 |
| Supercap (SUP, C90/C91) | 25 mA charge, backup boost current | radial can, 3.5 mm pitch | **place ≤75 °C** away from OCXO oven/Rb/bucks/PoE mag | CLAUDE.md; DSF datasheet 3.0V/65–85°C life |
| VOUT → V_BCKP / VBAT | µA backup, ~mA charge bypass | moderate | local 22–33µF near IC | DS COUT 20–30µF |
| VIN (3V3) | shared plane | add local ≥2.2µF | — | DS CIN 2.2µF |

#### Design-intent mismatches
| Ref | Doc says | Schematic says | Severity |
|---|---|---|---|
| PA6 / PB1 SOC sense | peripheral_map §lines 265–266: "/2 divider" on both | Direct connection to SUP node, **no divider** | Medium (firmware scaling) |
| peripheral_map §14 open item L398 | "TPS61094 MODE/EN truth table & auto-backup behavior (TI datasheet)" — unverified | Verified: EN/MODE→VOUT = Auto buck/boost, self-bootstrapping | Low (close the open item) |
| Backup output level | CLAUDE.md elsewhere frames TPS61094 generically; this block gives 3.0 V boost target / 3.3 V bypass | OSEL=3.0 V confirmed | Low (document the 3.0 V value) |

#### Backup hold-time vs ephemeris window (requested)
Usable energy per 3 F cap from 2.5 V (VCHG) to ~1.4 V (F9T V_BCKP floor): E≈½·3·(2.5²−1.4²)=**6.4 J**. At V_BCKP ~45 µA (25 °C) → hold ≈ tens of hours; even with temperature-elevated leakage and the 3.0 V boost floor, well beyond the ZED-F9T **~4 h ephemeris validity**. **Hold time is adequate** (supercap is, if anything, generously sized). Confidence Medium (V_BCKP current at max enclosure temp still an open datasheet item per CLAUDE.md).

#### Balancing / charge
Single cell per converter (not a series stack) → **no cell balancing required**; VCHG=2.5 V is the hard charge ceiling and is below the 3.0 V cap rating. Charge current 25 mA → 0→2.5 V on 3 F ≈ 5–6 min after the pre-charge phase. OK.

### Ethernet magnetics/input (sheet: ethernet-input.kicad_sch)  —  _verdict: Needs corrections_

## Ethernet magnetics / input — pre-layout review

Sheet `ethernet-input.kicad_sch`. Devices of significance: **J1** Bel 0826-1X1T-HS-F integrated MagJack, **U1** TI TPD4EUSB30 4-ch ESD array, plus passives R1/C1/C2. (R42–R45 49.9Ω MDI pull-ups, FB1, and U11 LAN8742 itself live on the *Ethernet PHY* sheet but terminate on this sheet's nets, so they are cross-checked here.)

### Headline result
The MDI termination topology is **correct** and matches the Microchip LAN8742A schematic checklist (SC471240) Figures 1/2 and the integrated-magnetics notes. The chosen magjack (0826-1X1T-HS-F) has the **Bob-Smith termination built in** (internal 4×75Ω + 1000pF/2kV to SHIELD — confirmed on the Bel drawing schematic page), so no external 75Ω/1nF-2kV network is needed and its absence on this sheet is *not* a defect. The real blockers are **missing footprints** (J1, U1) and a **symbol-library-variant mismatch** for J1, plus an ESD-part-suitability and a chassis-cap-rating concern.

### IC / active-device-by-IC
| RefDes | MPN | Function | Datasheet | Package | Symbol pinout verified | Footprint verified | Power/Gnd pins | Strap/EN/RST | Required passives | Layout-critical notes | Status | Confidence |
|---|---|---|---|---|---|---|---|---|---|---|---|---|
| J1 | Bel **0826-1X1T-HS-F** (gigabit MagJack, PoEp/100W, ext-temp) | Integrated RJ45 + 4× 1CT:1CT magnetics + internal Bob-Smith (4×75Ω + 1000pF/2kV) + 2 LEDs | Bel dr-mag-0826-1x1t-hs-f.pdf (PN 08261X1THS-F, schematic pg "PAGE 2") | THT magjack, 20 sig pins + S1/S2 shield (drawing pg 4 footprint) | YES — symbol pin **names** match datasheet (TRD1±/TRCT1 …, VC1–4, LEDs 17–20, SHIELD S1/S2) | **NO — Footprint field is empty** (symbol default `0826-1X1T-GH-F:BEL_0826-1X1T-GH-F` is overridden blank; no fp-lib-table entry) | Pin 6/12 TRCT1/2→3V3_LAN; pin13–16 VC1–4 = PoE taps | none (auto-MDIX magjack) | internal term; ext R1/C1 chassis-couple, C2 0.022µF CT bypass | Place at board edge; chassis (S1/S2) to chassis-GND island; route MDI 100Ω diff under the part with plane clear-out ~half-way through magnetics; HIPOT 2250VDC isolation barrier keep-out under part | **FAIL** (no footprint) | High |
| U1 | TI **TPD4EUSB30DQAR** | 4-channel ESD diode array on MDI (TRD0±, TRD1±) | ti.com/lit/gpn/tpd4eusb30 | **USON-10 DQA 2.5×1.0mm 0.5mm** | YES — pin1 D1+, 2 D1-, 3 GND, 4 D2+, 5 D2-, 8 GND, 6/7/9/10 NC; D1↔TRD0, D2↔TRD1, pin3+8→GND | **NO — Footprint = bare "10-USON"** (no lib prefix; not resolvable). Symbol default is `Package_SON:USON-10_2.5x1.0mm_P0.5mm` | pin3, pin8 = GND (both tied) | none | none | Place ESD diodes between magjack chip-side and PHY, short ground return to chassis/0V; keep stubs <2mm off MDI | **WARNING** (footprint unresolved; part is USB3-targeted, not AEC-Q101 / not MDI-qualified) | Med |

### Netlist findings
| Net | Connected pins | Expected | Observed issue | Risk | Fix | Status |
|---|---|---|---|---|---|---|
| TRD0_P / TRD0_N | J1-11/10, U1-1/U1-10 & U1-2/U1-9, R45/R44-pin2, U11-21(TXP)/20(TXN) | TX pair: magjack CT-side ↔ 49.9Ω→VDDA ↔ ESD ↔ PHY | OK — matches LAN8742 Fig 1 | none | — | PASS |
| TRD1_P / TRD1_N | J1-4/5, U1-4/U1-7 & U1-5/U1-6, R43/R42-pin2, U11-23(RXP)/22(RXN) | RX pair per Fig 2 | OK | none | — | PASS |
| 3V3_LAN | J1-6,J1-12 (TRCT1/2), R42–R45-pin1, C2-pin1, FB1-pin1, C13/C19/C20, U11-1/19 (VDD1A/2A) | CT→VDDA + 49.9Ω pull-ups + 0.022µF CT bypass + ferrite-isolated analog 3V3 | Topology correct (Fig 2, Magnetics §2). **Net name `3V3_LAN` deviates from canonical `3V3` naming** | low (cosmetic/traceability) | Confirm intentional separate ferrite-isolated PHY analog rail; document name in net-naming doc | WARNING |
| Net-(J1-SHIELD) | J1-S1, J1-S2, C1-1 (4.7nF/**16V**), R1-1 (1M) | Chassis tie: R1 1M bleed + C1 HV cap to digital GND (checklist §17.5: 0Ω / HV-cap / ferrite option) | **C1 rated 16V** — a chassis-to-signal-GND coupling cap can see ESD/surge/common-mode HV; 16V part is under-rated | Med (cap failure / no isolation under surge) | Use ≥2kV (≥1kV min) HV cap for C1; keep 1M R1 | WARNING |
| TR0/1/2/3_TAP | J1-13/14/15/16 (VC1–4) → U7/U8 (FDMQ8205A) + U3–U6 (BC846BPDW) | PoE Mode A+B center-tap extraction (all 4 pairs) | OK — matches peripheral_map §6 | none | (verify on PoE sheet) | PASS |
| J1 pins 1,2,3 (TRP3 CT/±), 7,8,9 (TRP4 CT/±) | unconnected | chip-side of the two PoE-only pairs | Left floating | none (internal Bob-Smith terminates RJ45 side; chip-side unused on 10/100) | acceptable; KiCad shows `unconnected-` (no DRC error) | PASS |
| ETH_LEDY / ETH_LEDG | J1-18 / J1-20 + R39/R38 (PHY LED) + R41/R40 | bi-color/yellow LED drive from PHY LED1/LED2 with strap pull-downs | LED anodes (J1-17 yellow-anode, J1-19 green/orange common) tied to **GND**, cathode side driven — implies **active-high** LED drive; LAN8742 LED polarity is set by the strap on the same LED pin | Med — verify LED polarity strap vs magjack LED anode/cathode orientation (J1 LED1 PIN17=−/PIN18=+ per Bel table) | Cross-check Bel LED-polarity table (PIN17 −, PIN18 + = yellow) against PHY LED strap & series-R placement | WARNING |

### BOM validation
| RefDes | MPN | Datasheet found | Package | Footprint | Pkg-FP match | Pinout match | Rating match | Status | Notes |
|---|---|---|---|---|---|---|---|---|---|
| J1 | 0826-1X1T-HS-F | YES (Bel) | THT magjack 20+2 | **(blank)** | N/A | YES (names) | 57VDC line, 2250VDC HIPOT, −40/+85, 1A/pair — OK for 802.3bt | **FAIL** | No footprint; **symbol drawn from `0826-1X1T-GH-F` library while Value/MPN = HS-F** — confirm HS-F footprint/pinout identical and assign HS-F land pattern |
| U1 | TPD4EUSB30DQAR | YES (TI) | USON-10 DQA 2.5×1.0 | "10-USON" | unresolved | YES | VRWM 5.5V ≥ 3.3V MDI bias OK; ~0.7pF/ch OK for 100M | **WARNING** | Assign real lib footprint; consider AEC-Q101 MDI-rated ESD array for industrial/PoE product |
| C1 | (no MPN) 4.7nF 16V X7R 0402 | n/a | 0402 | C_0402 | OK | n/a | **16V under-rated for chassis-couple** | **WARNING** | Spec ≥1–2kV HV cap |
| C2 | 0.022µF 50V X7R 0402 | Murata | 0402 | C_0402 | OK | n/a | OK (CT bypass, Fig 2 value exact) | PASS | matches checklist 0.022µF |
| R1 | ERJ-2RKF1004X 1M 0402 | Panasonic | 0402 | R_0402 | OK | n/a | OK | PASS | chassis bleed |
| R42–R45 | ERJ-2RKF49R9X 49.9 1% 0402 | Panasonic | 0402 | R_0402 | OK | n/a | 1% per checklist (49.9Ω) | PASS | on PHY sheet; MDI pull-ups to VDDA — correct |

### Symbol / footprint
| RefDes | MPN | Datasheet package | Symbol pin#s match | Assigned footprint | Pad#s match | Pin-1/orientation verified | Status |
|---|---|---|---|---|---|---|---|
| J1 | 0826-1X1T-HS-F | 20 sig + S1/S2 | YES (1–20,S1,S2) | none | — | NO | FAIL |
| U1 | TPD4EUSB30DQAR | USON-10 (pads 1–10 + thermal) | YES | "10-USON" (unresolved) | UNKNOWN | UNKNOWN | WARNING |

### Layout-critical constraints
| Net/class | Current est | Width/impedance | Placement / return path | Evidence |
|---|---|---|---|---|
| MDI TRD0/TRD1 (diff) | signal | **100Ω differential**, length-matched intra-pair, short | Route J1↔U1↔R-term↔U11 tight; plane clear-out ~½ into magnetics; no GND under isolated/RJ45 side | LAN8742 checklist pg 3 (Figs 1/2), Bel isolation barrier |
| PoE center-tap TR0–3_TAP | up to ~1A/pair (802.3bt) | wide power traces to U7/U8 bridges | treat as power; J1 VC1–4 carry PoE | peripheral_map §6; Bel "1A max @57VDC continuous" |
| SHIELD / chassis | ESD/surge | HV creepage to digital GND across C1/R1 | chassis-GND island under RJ45 shell; S1/S2 to chassis; single HV-cap couple | LAN8742 checklist pg 5 §3 / pg 17 §5 |
| LED ETH_LEDY/G | mA | n/a | route to front-panel light pipe | Bel LED table |

### Design-intent mismatches
| Ref | Doc says | Schematic says | Severity |
|---|---|---|---|
| J1 | hardware/CLAUDE.md & checklist call this "magjack" / "ARJ-199 integrated magjack" (prompt) | Part is **Bel 0826-1X1T-HS-F** (not Amphenol ARJ-199) | Low — both are integrated gigabit magjacks; update docs to as-built MPN |
| C1 (SHIELD) | net-naming/checklist imply HV chassis coupling | 4.7nF **16V** | Med — under-rated |
| 3V3_LAN | net-naming doc mandates plain `3V3` rails | `3V3_LAN` separate rail name | Low — legitimate ferrite-isolated PHY rail; add to naming doc |
| J1 symbol src | should be HS-F | symbol body = `0826-1X1T-GH-F` library | Low/Med — verify land pattern is HS-F |
| Bob-Smith term | prompt flagged "Bob-Smith + 75R/1nF-2kV" as a risk area to verify | **Internal to magjack** (4×75Ω+1000pF/2kV) — none external (correct) | Info — no action; risk cleared

### Ethernet PHY (LAN8742AI-CZ-TR) — sheet ethernet-phy.kicad_sch  —  _verdict: Needs corrections_

## Ethernet PHY (U11 LAN8742AI-CZ-TR) — Pre-Layout Review

**Verdict: Needs corrections.** Core RMII wiring, strap configuration (REF_CLK-Out mode), supply split, terminations, and decoupling are all correct and datasheet-verified. Two layout blockers (Y1 and J1 have no footprint), one questionable ESD placement (U1), and minor doc/rail nits. No electrical blockers.

#### IC-by-IC

| RefDes | MPN | Function | Datasheet | Package | Symbol pinout verified | Footprint verified | Power/Gnd pins | Strap/EN/RST pins | Required passives | Layout-critical notes | Status | Conf |
|---|---|---|---|---|---|---|---|---|---|---|---|---|
| U11 | LAN8742AI-CZ-TR | RMII 10/100 PHY | Microchip DS Rev 1.1 (8742a.pdf) | 24-SQFN 4×4 mm, 0.5 mm, EP=VSS | Yes — all 25 pins match (pin14 nINT/REFCLKO, 24 RBIAS, 25 EP=VSS) | Yes — QFN50P400X400X100-25N.kicad_mod: 24 pads + 2.5×2.5 EP, pin-1 marker at lower-left | VDD1A=19, VDD2A=1 → 3V3_LAN; VDDIO=9 → 3V3; VDDCR=6 (int reg out); VSS=25(EP) → GND | nINTSEL(2), REGOFF(3), MODE0(8)/MODE1(7)/MODE2(11), PHYAD0(10), nRST(15) | RBIAS 12.1k 1% (R37); VDDCR 1µF+470pF (C18/C17); VDDIO 0.1µF (C15); VDD1A/2A 0.1µF (C19/C20)+4.7µF (C13); FB1 600Ω isolating 3V3_LAN | XTAL traces short/guarded; 3V3_LAN island under PHY; MDI pairs length-matched 100Ω diff; RBIAS away from noise | PASS | High |
| U1 | TPD4EUSB30DQAR | 4-ch ESD array on MDI pairs | TI SLVSAC2G | USON-10 (DQA) 2.5×1.0 | Yes — D1±=1/2, D2±=4/5, GND=3/8, NC=6,7,9,10 | BOM fp "10-USON" (verify exact DQA land) | GND=3,8 | n/a | none | On PHY side of magnetics — limited real ESD/surge benefit; electrically benign (VRWM 5.5V, 0.8pF) | WARNING | Medium |

#### Netlist findings

| Net | Connected pins | Expected | Observed issue | Risk | Fix | Status |
|---|---|---|---|---|---|---|
| RMII_REF_CLK | U11.14 (REFCLKO), U12.24 (PA1) | 50 MHz REFCLKO → MCU RMII REF_CLK (PA1) | OK — REF_CLK-Out mode | none | — | PASS |
| Net-(U11-LED2/nINTSEL) | U11.2, R39(330)→ETH_LEDY→{J1.18, R41 4.75k→GND} | nINTSEL pulled LOW for REF_CLK-Out | Pull-down is at LED node (after 330R), not directly on pin (datasheet Fig 3.15) | Low — Vpin≈0.24 V < VIL with ~66k int PU; latches 0 with margin | Document; optionally move 10k pulldown directly to pin 2 | PASS |
| Net-(U11-LED1/REGOFF) | U11.3, R38(330)→ETH_LEDG→{J1.20, R40 4.75k→GND} | REGOFF LOW → internal reg ON | OK (reinforces internal PD) | none | — | PASS |
| MODE0/1/2 + PHYAD0 | U11.8/7/11/10 via R31-R34 (100R) → MCU RMII | Internal PU(MODE)/PD(PHYAD) set MODE=111 (all-cap autoneg), PHYAD=0; 100R isolates MCU load | Straps rely on internal pulls; 100R series = required strap-augment R | none | — | PASS |
| LAN_RST_N | U11.15, R35 10k→GND, U12.57 (PD10) | nRST default-asserted, MCU-released | No RC; firmware must hold ≥100µs (trstia) & meet tcss 200ns | Low | Firmware reset sequencing | PASS |
| Net-(U11-RBIAS) | U11.24, R37 12.1k→GND | 12.1k 1% to GND | OK | none | — | PASS |
| Net-(U11-VDDCR) | U11.6, C17 470pF, C18 1µF | int-reg 1.2V output decouple | OK | none | — | PASS |
| XTAL1/XTAL2 | U11.5/4, Y1.2/.1, C16/C14 27pF→GND | 25 MHz parallel, CL=20pF | 27pF gives CL≈19pF (slightly low) | Low | Fine-trim after Y1 stray known | PASS |
| TRD0_P/N, TRD1_P/N | U11.20-23, J1 TRD pairs, R42-45 49.9→3V3_LAN, U1 ESD | MDI to integrated magjack, single-supply term | Direct PHY→jack (1G jack on 100M PHY) | Med — unused pairs term | Verify jack internal term | WARNING |
| MDIO | U11.12, U12.25(PA2), R36 1.5k→3V3_LAN | pull-up to VDDIO | Pulled to 3V3_LAN, VDDIO on 3V3 (same V) | Low | accept or move to 3V3 | PASS |

#### Symbol / footprint

| RefDes | MPN | Datasheet package | Symbol pin#s match | Assigned footprint | Pad#s match | Pin-1/orientation | Status |
|---|---|---|---|---|---|---|---|
| U11 | LAN8742AI-CZ-TR | 24-SQFN 4×4/0.5, EP | Yes (25 incl EP) | QFN50P400X400X100-25N (in-repo) | Yes (24+EP, EP=pad25=VSS) | Pin-1 marker present (-2.985,-1.25) | PASS |
| U1 | TPD4EUSB30DQAR | USON-10 DQA 2.5×1.0 | Yes | "10-USON" (BOM) | Verify exact DQA | Verify | UNKNOWN |
| Y1 | CTS 445I23E25M00000 | SMD 3.2×2.5 4-pad | n/a (Device:Crystal 2-pin) | **EMPTY** | — | — | FAIL |
| J1 | Bel 0826-1X1T-HS-F | RJ45 ICM (1G, PoE) | per symbol | **EMPTY** | — | — | FAIL |

#### Layout-critical constraints

| Net/class | Current est | Width/impedance | Placement/return | Evidence |
|---|---|---|---|---|
| TRD0/TRD1 MDI pairs | signal | 100Ω diff, length-matched, intra-pair skew min | PHY pins 20-23 close to J1; solid ref under pairs; minimize stubs at R42-45/U1 | LAN8742 DS §MDI; 100BASE-TX |
| XTAL1/XTAL2 (25 MHz) | signal | short, symmetric, guard | C14/C16 tight to Y1; ground guard ring; keep RMII/MDI clear | DS §5.7 Table 5.16 (CL 20pF, ±50ppm) |
| 3V3_LAN island | VDD1A+VDD2A (~part of ~0.3W PHY) | local pour, single-point tie via FB1 | FB1 600Ω + C13 4.7µF bulk at entry; C19/C20 at pins 1/19 | DS power; FB1 BLM31KN601 |
| RBIAS (R37) | ~1mW | high-impedance, keep short | R37 adjacent pin 24, away from clocks/MDI | DS: 12.1k 1% nominal 1.2V |
| REFCLKO→PA1 | 50 MHz | controlled length to MCU; matched-ish to RMII data | route as RMII clock; ref plane | DS REF_CLK-Out |

#### Design-intent mismatches
See docMismatches array — Y1/J1 BOM-vs-schematic footprint gaps, MDIO pull-up rail (3V3_LAN vs VDDIO/3V3), and the nINTSEL pulldown topology deviation from datasheet Fig 3.15 (functionally correct).

**Sources:** [LAN8742A DS Rev 1.1](https://ww1.microchip.com/downloads/en/DeviceDoc/8742a.pdf) (pin tables p.10-13, straps §3.7 p.35-38, MODE[2:0] Table 3.4, LED/nINTSEL polarity Fig 3.15 p.46, nRST timing Table 5.11 p.121, Crystal Table 5.16 p.127); [TPD4EUSB30 DS SLVSAC2G](https://www.ti.com/lit/ds/symlink/tpd4eusb30.pdf) (pinout Table 5-1); [Bel 0826 ICM brochure](https://www.belfuse.com/resources/brochures/magneticsolutions/br-mag-1g_2gbase-t-100w-poe-icms.pdf); in-repo: QFN50P400X400X100-25N.kicad_mod, LAN8742AI-CZ-TR.kicad_sym, ntp-server-stm32.net, sts1000_bom.csv, docs/ntp_server_peripheral_map.md §1.

### MCU core (STM32H563VIT6, U12)  —  _verdict: Needs corrections_

## MCU Core Review — U12 STM32H563VIT6 (LQFP-100), sheet `stm32.kicad_sch`

Connectivity verified from the netlist (`ntp-server-stm32.net`), values/footprints from the netlist + `sts1000_bom.csv`, symbol/footprint from `hardware/libraries/STM32H563VIT6.kicad_sym` and `LQFP-100_STM.kicad_mod`. External truth from ST AN5711 / STM32H562/563 datasheet.

**Verdict: Needs corrections.** Power architecture, decoupling, oscillator, VCAP, and all documented signal-pin mappings are correct. Two layout-blocking items (BOOT0 divider, unresolved footprint) and two reliability items (no NRST cap, weak VREF+ reservoir) must be fixed.

#### IC-by-IC

| RefDes | MPN | Function | Datasheet | Package | Symbol pinout verified | Footprint verified | Power/Gnd pins | Strap/EN/RST pins | Required passives | Layout-critical notes | Status | Conf |
|---|---|---|---|---|---|---|---|---|---|---|---|---|
| U12 | STM32H563VIT6 | Cortex-M33 MCU | ST DS (sym links H562 in error) | LQFP-100 14×14 0.5mm, no EP | Yes — 100 pins, no PE1/PB11 (correctly absent) | Footprint geometry OK but **instance name "100-LQFP" does not resolve** | VDD ×5 (11/28/50/75/100)→3V3_STM; VSS ×5 (10/27/49/74/99)+VSSA(19)+VREF-(20)→GND; VDDA(22)←U13 LDO; VREF+(21)←U14; VBAT(6)←backup; VDDUSB(73)←3V3_STM_USB; VCAP(48,98) | NRST(14), BOOT0(94), no other straps | VCAP 2.2µF×2 (C34/C36) ✓; VDDA 10µF+0.1µF (C32/C100) ✓; per-VDD 0.1µF ×12 (C168-C181) + 220nF C176 + 1µF C182 ✓; OSC32 12pF×2 ✓; BOOT0 R49/R50 ✗; VREF+ C37 1nF ⚠; NRST cap missing ⚠ | Place decoupling at pins; VCAP caps must be ceramic w/ correct ESR; VREF+ low-Z to pin | **WARNING** | High |
| U14 | MCP1502T-33E/CHY | 3.3 V series VREF for ADC | Microchip DS20006593 | SOT-23-6 | OUT1/GND2/GND3/EN4/GND5/VDD6 per BOM | SOT-23-6 (KiCad std) | VDD(6)←5V, GND(2/3/5) | EN(4)←Q6 collector (enabled by 5V_PSU good) | OUT→C37/R48/C38; in-path R48 50Ω + C38 2.2µF | Max direct CL limited; series-R reservoir rule (DS §5.1.2) — reservoir is on wrong side of R48 | WARNING | Medium |
| U13 | LT3045 (VDDA LDO) | Low-noise VDDA supply | ADI 3045fa | DFN-10 1EP | (own block) | — | IN/OUT/GND | EN/UV | C27, FB2, C32/C100 at MCU | VDDA noise floor sets ADC/DAC perf for OCXO steering | N/A (cross-block) | Medium |

#### Power / decoupling validation (U12)

| Pin(s) | Rail | Caps observed | ST recommendation | Status |
|---|---|---|---|---|
| 11/28/50/75/100 VDD | 3V3_STM | 12×0.1µF (C168-C181) + 220nF (C176) + 1µF (C182) | 1×0.1µF per VDD + bulk | PASS |
| 22 VDDA | VDDA (U13) | 10µF (C32) + 0.1µF (C100) | 1µF + 10nF (+10µF if shared) | PASS |
| 21 VREF+ | U14 3.3V ref | 1nF (C37) local; 2.2µF (C38) behind R48 50Ω | 1µF + 100nF **at the pin** | **WARNING** |
| 48 & 98 VCAP | internal LDO | 2.2µF each (C34/C36) | 2.2µF each for 2-VCAP pkg | PASS |
| 6 VBAT | backup (U35 TPS61094) | 100nF+bulk (C33/C35/C93/C95/C97) | 100nF | PASS (confirm topology) |
| 73 VDDUSB | 3V3_STM_USB | 0.1µF (C26) + 1µF (C28) | 1µF + 100nF | PASS |
| 14 NRST | internal pull-up | **none** | ~100nF to GND recommended | **WARNING** |
| 94 BOOT0 | — | 10k↑(R49)+10k↓(R50) divider → ~1.65V | hard 0/1 | **FAIL** |
| 12/13 PH0/PH1 | HSE bypass | PH0←R187 22Ω from mux; PH1 NC | OSC_IN only in bypass | PASS |
| 8/9 OSC32 | 32.768kHz Y2 | 12pF (C29/C31) | per crystal CL | PASS |

#### Netlist findings

| Net | Connected pins | Expected | Observed issue | Risk | Fix | Status |
|---|---|---|---|---|---|---|
| Net-(U12B-BOOT0) | U12.94, R49.2(→3V3), R50.1(→GND) | hard strap | 1:1 divider → indeterminate ~1.65V | Random boot mode / glitch | Single pulldown or header | FAIL |
| MCU_NRST | U12.14, J3.5 | NRST + 100nF | no reset cap | Reset glitch | Add 100nF | WARNING |
| Net-(U12C-VREF+) | U12.21, U14.1, C37(1nF), R48(50Ω)→C38(2.2µF) | 1µF+100nF at pin | reservoir behind 50Ω | ADC droop | Move reservoir to pin | WARNING |
| PG_INT_N | U12.69(PA10), U55.15/16, R200 10k↑ | PA10 (doc) | matches doc | — | — | PASS |
| BTN_INT_N | U12.97(PE0), U54.16, R201 10k↑ | PE0 (doc) | matches | — | — | PASS |
| INA_ALERT_INT_N | U12.80(PC12), U54.15, R199 10k↑ | PC12; R44 removed | only R199 present (no R44) | — | standing action satisfied | PASS |
| EXP_RST_N | U12.15(PC0), U54.14, U55.14, R198 10k↑ | PC0 (doc) | matches | — | — | PASS |
| unconnected PH1-OSC_OUT | U12.13 only | NC in HSE-bypass | intentional | none | — | PASS |
| I2C_SCL/SDA | PB8/PB9 + 4.7k↑ (R202/R203) to 3V3_STM | always-on rail | correct (back-power fix) | — | — | PASS |

#### Symbol / footprint

| RefDes | MPN | DS package | Symbol pin#s match | Assigned footprint | Pad#s match | Pin-1/orientation | Status |
|---|---|---|---|---|---|---|---|
| U12 | STM32H563VIT6 | LQFP-100 14×14 0.5mm | Yes (100 pins, PE1/PB11 absent — correct, not bonded) | instance="100-LQFP" (unresolved); should be LQFP-100_STM | LQFP-100_STM has 100 pads ✓ pin1 −7.72,−6.0 ✓ 0.5mm pitch ✓ | Verified on real footprint; instance link broken | FAIL (link), symbol/fp PASS |

#### Layout-critical constraints

| Net/class | Est | Constraint | Evidence |
|---|---|---|---|
| VDD decoupling | dynamic | 0.1µF per VDD pin within ~2mm; bulk (C182 1µF) close | AN5711 |
| VDDA / VREF+ | ADC ref | low-Z, star to VSSA; reference & reservoir near pin21; keep digital noise off | AN5711, MCP1502 DS |
| VCAP (48,98) | LDO loop | 2.2µF each, minimal loop to nearest VSS | AN5711 |
| PH0 (HSE bypass) | 10MHz | R187 22Ω source term at mux driver (not at MCU); controlled-Z short run | clock_mux doc |
| OSC32 (Y2) | 32.768kHz | guard ring, short, away from switchers | std |
| SWD (PA13/14/PB3→J3) | — | standard; no issue | netlist |
| NRST | — | 100nF at pin (to add) | AN5711 |

#### Design-intent mismatches

| Ref | Doc says | Schematic says | Severity |
|---|---|---|---|
| U12 footprint | custom LQFP-100_STM in-repo | bare "100-LQFP" (no lib, nonexistent); no fp-lib-table | High |
| U12 datasheet prop | STM32H563VIT6 | links stm32h562ag.pdf | Low |
| PH0 net | OSC_IN (peripheral_map) | CLK_OUT | Low |

### External watchdog (U64 TPS3430, WDT sheet)  —  _verdict: Needs corrections_

## External Watchdog — Pre-Layout Review (U64 TPS3430WDRC)

Schematic sheet: `hardware/ntp-server-stm32/wdt.kicad_sch`. Canonical doc: `docs/sts1000_external_wdt.md`. Datasheet: TI TPS3430 SBVS366 (extracted full text from `ti.com/lit/ds/symlink/tps3430.pdf`).

**Headline:** Core watchdog wiring is correct and matches the datasheet (pinout, VDD1=VDD2 tie, SET0 high, SET1=WDT_EN with R213 boot-disable pulldown, WDO open-drain with R23 10k pull-up, CWD/CRST floated for the 920–1360 ms factory window, tRST 200 ms). Two real defects: (1) **WDI/WDT_KICK has no external pull resistor** — the datasheet explicitly forbids floating WDI in the disabled state; the doc's claimed pulldown "R169" belongs to a different circuit (Rb IO transistor base) and has the wrong value. (2) Several doc designator claims (R169 WDI pulldown; fallback U62/D17/C145) are stale and contradict the netlist. No layout blockers; the WDI pulldown should be added before layout so a pad exists.

#### IC-by-IC

| RefDes | MPN | Function | Datasheet | Package | Symbol pinout verified | Footprint verified | Power/Gnd pins | Strap/EN/RST pins | Required passives | Layout-critical notes | Status | Confidence |
|---|---|---|---|---|---|---|---|---|---|---|---|---|
| U64 | TPS3430WDRC (orderable TPS3430WDRCR) | Standalone window watchdog → POE_KILL cold-cycle | TI SBVS366 | VSON-10 DRC 3×3 mm, EP internally GND | YES — symbol pins 1..11 = VDD1/CWD/SET0/CRST/GND/SET1/WDI/WDO/NC/VDD2/GND match DS §Pin Functions (p.5, lines 135–208) | Footprint `Package_SON:VSON-10-1EP_3x3mm_P0.5mm_EP1.65x2.4mm` = standard KiCad lib; DRC EP nominal ~1.65×2.4 mm matches DS land pattern | VDD1(1)+VDD2(10)→3V3_STM (net code 9, with C180/C181); GND(5)+GND(11)/EP→GND | SET0(3)=3V3_STM tied high; SET1(6)=WDT_EN(PA9) + R213 100k pulldown; CWD(2)=NC float; CRST(4)=NC float; NC(9)=no_connect | C180/C181 0.1µF VDD bypass; R23 10k WDO pull-up; R213 100k SET1 pulldown; **MISSING WDI pulldown** | EP to large GND plane (DS p.6); no copper fill under CWD/CRST (preset eval); R23 close to pin 8; C180 close to VDD1 | WARNING | High |

#### Netlist findings

| Net | Connected pins | Expected | Observed issue | Risk | Fix | Status |
|---|---|---|---|---|---|---|
| WDT_KICK (code 339) | U12 PB2(37), U64 WDI(7) | WDI driven + defined-level pull (doc §3/§5: R169 100k pulldown) | **No pull resistor present.** WDI relies solely on PB2. DS pin-fn (line 195): "If the watchdog is disabled, then WDI cannot be left unconnected and must be driven to either VDD or GND." No internal pull on WDI. | Low–Med: during the pre-GPIO-config boot instant PB2 is Hi-Z → WDI floats. WDT is also disabled then (SET1 low via R213), and DS says WDI is ignored while disabled, so functional risk is small — but it violates DS guidance and leaves an undefined node. | Add a pulldown (100k per doc, or any 10k–100k) from WDT_KICK to GND near U64 pin 7. Assign it a real refdes (NOT R169 — that's taken). | FAIL |
| WDT_EN (code 338) | U12 PA9(68), U64 SET1(6), R213 pin1 (pin2→GND) | PA9 push-pull + 100k pulldown → boots disabled | None — correct | — | — | PASS |
| WDO_N (code 337) | U64 WDO(8), R23 pin1 (pin2→3V3) + thermal/OV-latch wire-OR | open-drain + pull-up to 3V3 | None — R23 10k in DS 1k–100k range (line 197/278). Verify the other two open-collector sources actually land on this net on their sheets (out of scope here). | — | Confirm thermal-cutoff + Rb-OV-latch O-C outputs join WDO_N (doc §6) | PASS |
| 3V3_STM (code 9) | U64 VDD1(1), VDD2(10), SET0(3) + many | VDD1=VDD2 tied; SET0 high | None — DS line 205/604: VDD1/VDD2 not internally connected, must be tied; both on 3V3_STM. SET0 high = correct for enable mode. | — | — | PASS |
| unconnected-(U64-CWD-Pad2) (code 434) | U64 CWD(2) | NC float → factory window | Correct (float). | — | Keep-out, no fill under pin 2 | PASS |
| unconnected-(U64-CRST-Pad4) (code 433) | U64 CRST(4) | NC float → tRST 200 ms | Correct (float). | — | Keep-out, no fill under pin 4 | PASS |
| unconnected-(U64-NC-Pad9) (code 435) | U64 NC(9) | float | Correct (DS line 203: must float). | — | — | PASS |

#### Window/timing verification vs datasheet

| Param | Doc §4 | DS (CWD=NC, SET0=1, SET1=1) | Match |
|---|---|---|---|
| tWDL (min/typ/max) | 680/800/920 ms | 680/800/920 ms (DS line 398) | YES |
| tWDU (min/typ/max) | 1360/1600/1840 ms | 1360/1600/1840 ms (DS line 414) | YES |
| tRST (CRST=NC) | 170/200/230 ms | 170/200/230 ms (DS line 380) | YES |
| Valid kick window | 920–1360 ms | derived = (tWDL max, tWDU min) | YES |
| Disable strap | SET0=1, SET1=0 | "Watchdog disabled" (DS lines 396/412/419) | YES |

#### BOM validation

| RefDes | MPN | Datasheet found | Package | Footprint | Pkg-FP match | Pinout match | Rating match | Status | Notes |
|---|---|---|---|---|---|---|---|---|---|
| U64 | TPS3430WDRC | YES (SBVS366) | VSON-10 DRC | VSON-10-1EP_3x3mm | YES | YES | VDD 1.6–6.5 V ✓ (3V3 in range) | WARNING | MPN is the value-derived `TPS3430WDRC`, not the orderable tape-reel `TPS3430WDRCR` (doc §10). MANUFACTURER field blank. BOM status flag `MPN-FROM-VALUE` = not curated. Fix MPN→TPS3430WDRCR, mfr=Texas Instruments. |
| C180 | GRM155R71C104KA88J 0.1µF 16V X7R 0402 | YES | 0402 | C_0402 | YES | n/a | 16V ≫ 3.3V ✓ | PASS | VDD1 bypass. |
| C181 | GRM155R71C104KA88J 0.1µF 16V X7R 0402 | YES | 0402 | C_0402 | YES | n/a | ✓ | PASS | VDD2 bypass. |
| R23 | ERJ-2RKF1002X 10k 0402 | YES | 0402 | R_0402 | YES | n/a | ✓ | PASS | WDO_N pull-up; BOM block-tagged "PoE" but net is WDO_N (cosmetic tag only). |
| R213 | ERJ-2RKF1003X 100k 0402 | YES | 0402 | R_0402 | YES | n/a | ✓ | PASS | SET1 boot-disable pulldown. |
| R169 | ERJ-2RKF1002X 10k 0402 | YES | 0402 | R_0402 | YES | n/a | ✓ | FAIL (mis-cited) | Doc §3/§5/§10 claims R169 = WDT_KICK/WDI 100k pulldown. Netlist: R169 pin1 on a divider net (w/ R161/R164), pin2 on `Net-(Q21-B)` — it is an **Rb-IO transistor-base resistor, 10k**, unrelated to the WDT. The WDI pulldown does not exist. |

#### Symbol/footprint

| RefDes | MPN | Datasheet package | Symbol pin#s match | Assigned footprint | Pad#s match | Pin-1/orientation verified | Status |
|---|---|---|---|---|---|---|---|
| U64 | TPS3430WDRC | VSON-10 DRC, EP=pin 11 | YES (1–10 signals, 11=GND/EP) | Package_SON:VSON-10-1EP_3x3mm_P0.5mm_EP1.65x2.4mm | Symbol exposes pin 11 as GND; standard footprint maps EP→pad 11 — consistent | Pin 1 = VDD1 (DS p.5 pinout, top-left); WDO pin 8 typed `open_collector` (correct) | PASS (verify EP↔pad-11 mapping in footprint editor during layout) |

#### Layout-critical constraints for this block

| Net/class | Current est | Width/impedance | Placement / return path | Evidence |
|---|---|---|---|---|
| VDD1/VDD2 (3V3_STM) | IDD ~10 µA + caps | std signal | C180 at pin1, C181 at pin10, short low-Z to rail | DS p.5 pin-fn (bypass 0.1µF); doc §9 |
| CWD(2), CRST(4) | high-Z preset-detect (ICWD ~0.8 nA, ICRST ~375 nA) | minimize parasitic C | NO plane fill under pins, short stubs — parasitic C corrupts the float/cap auto-detect (tINIT 381 µs state machine) | DS lines 615–618, 862; doc §9 |
| WDO/WDO_N | sink to GND when asserted | std | R23 close to pin 8; wire-OR node kept short | DS line 197; doc §9 |
| EP / thermal pad | — | large GND copper | EP→ground plane vias; internally GND | DS p.6 line 208; doc §9 |
| WDI (WDT_KICK) | edge input | std | add pulldown near pin 7 | DS line 195 |

#### Design-intent mismatches (doc vs schematic/netlist)

| Ref | Doc says | Schematic/netlist says | Severity |
|---|---|---|---|
| WDI pulldown | §3/§5/§10: "R169 = 100 kΩ pulldown on WDT_KICK/WDI for a defined level" (already flagged with inline TODO) | No pulldown on WDT_KICK net. R169 = 10k, in Rb-IO circuit (pin2 → Net-(Q21-B)). | High (real missing part + wrong designator + wrong value) |
| U64 MPN | §10: orderable TPS3430WDRCR | BOM/netlist value `TPS3430WDRC`, mfr blank, `MPN-FROM-VALUE` | Low (procurement) |
| Fallback parts U62/D17/C145 | §6/§10 reference fallback inverter U62 (74LVC1G04), OR-diode D17 (BAT54), bypass C145 | U62 = MX25L25645 SPI-NOR; D17 = BAT54J in Rb IO; C145 not a WDT part (doc already TODO-flags these) | Low (doc hygiene — italic/conditional rows; clarify they have no refdes) |
| R23 / R213 / C180 / C181 / U64 designators | §11 asks to reconcile | All present and correctly wired in netlist | Resolved — doc open-item §11 can be checked off for these five |

### GNSS receiver (ZED-F9T) — U21 ZED-F9T-00B, U22 LT3045 LDO, U23 INA228 @0x44  —  _verdict: Needs corrections_

## GNSS Receiver (ZED-F9T) — Pre-Layout Review

Scope: `gps.kicad_sch` (U21 ZED-F9T-00B, U22 LT3045 GPS LDO, U23 INA228 @0x44) + cross-sheet RF/backup nets. Connectivity taken from `ntp-server-stm32.net`; values/footprints from the sheet; pins/nets cross-checked against `docs/ntp_server_peripheral_map.md`.

**Verdict: Needs corrections.** Two blockers on the U22 LT3045 power-good circuit; one high-risk INA228 address-strap rail mismatch; pin mapping to the STM32 is otherwise correct and matches the peripheral map.

#### IC-by-IC

| RefDes | MPN | Function | Datasheet | Package | Symbol pinout verified | Footprint verified | Power/Gnd pins | Strap/EN/RST pins | Required passives | Layout-critical notes | Status | Confidence |
|---|---|---|---|---|---|---|---|---|---|---|---|---|
| U21 | ZED-F9T-00B | GNSS timing receiver | u-blox ZED-F9T-00B IntMan UBX-19005590 / DS UBX-18053713 | LGA module (custom) | Yes — 102-pin symbol, pins 1-54 signal, 55-102 GND, RF_IN=2, VCC=33/34, V_BCKP=36, TIMEPULSE=53, TIMEPULSE2=54, RST=49, SAFEBOOT=50, EXTINT=51, D_SEL=47, TXD=42/RXD=43, RXD2/TXD2=26/27, GEOFENCE=19 | Yes — `MODULE_ZED-F9T-00B.kicad_mod` has 102 pads (1-102) matching symbol; pin-1/orientation not yet visually checked | VCC 33/34 (3V3_GPS); ~48 GND pads → GND; V_BCKP 36 → GPS_VBAT | RESET_N 49 (int. pull-up, driven by PD11); SAFEBOOT_N 50 (PD15, host I/O — OK); D_SEL 47 (PD7, POR level TBD); EXTINT 51 (PD6) | C45 1u + C47 1u on VCC (3V3_GPS); V_BCKP: C48 0.1u + C92/94/96 22u (=66.1u, >2u rec); no ferrite on VCC (correct) | VCC must be low-Z LDO, NO ferrite/inductor between LDO and VCC (satisfied — FB3 is on LDO input only). RF_IN internally DC-blocked; external bias-T via L1. Keep magnetometer far from module. | WARNING | High |
| U22 | LT3045 (LT3045xDD) | Ultralow-noise LDO, 5V→3V3_GPS | AD LT3045 Rev D (3045fa.pdf) | DFN-10 3x3 EP | Yes (Regulator_Linear:LT3045xDD) | Yes — DFN-10-1EP_3x3mm_P0.5mm_EP1.65x2.38mm | IN 1/2 (5V via FB3); GND 8/11(EP) | EN/UV 3 = GPS_PWR_EN (PC8) with R69 100k; **PGFB 6 mis-wired**; **PG 4 no pull-up** | SET: R71 33.2k→3.32V ✓, C49 0.47u; ILIM: R70 374R→401mA ✓; OUT: C50 10u + R72 0.5R shunt | EP to GND copper for thermal; ~1.7V headroom at 5V→3.3V OK; output cap 10u OK | FAIL | High |
| U23 | INA228AQDGSRQ1 | Current/voltage monitor, GPS rail | TI INA228-Q1 | VSSOP-10 (DGS) | Yes (custom INA228AQDGSRQ1 sym) | Yes — VSSOP10_DGS_TEX | VS 6 (3V3_GPS), VBUS 8 (3V3_GPS), GND 2/7 | A1 1=**3V3 (wrong rail)**, A0 2=GND → 0x44 ✓; ALERT 3 = INA_ALERT_3V3_GPS | C51 0.1u decoupling; shunt R72 0.5R across IN+/IN- | Kelvin-sense across R72; place at LDO output | WARNING | High |

#### Netlist findings

| Net | Connected pins | Expected | Observed issue | Risk | Fix | Status |
|---|---|---|---|---|---|---|
| Net-(U22-PGFB) | U22 1(IN),2(IN),6(PGFB), FB3.1, C46.1 (←5V) | PGFB driven by OUT→PGFB→GND divider; IN on input rail only | PGFB shorted to VIN; PG monitors 5V input, not 3.3V output | PG/LDO power-good is false-positive; firmware can't detect GPS-rail loss via this flag | Separate PGFB from IN; add OUT divider to pin 6 | FAIL |
| 3V3_GPS_LDO_PG | U22 4(PG, open-drain), U55 GPA0 | Open-drain PG + pull-up to logic rail | No pull-up; PG can only pull low | Power-good never reads high (HW); depends on MCP23017 GPPU firmware | Add pull-up (100k–1M) to 3V3_STM | FAIL |
| 3V3_GPS | U21 33/34, U23 6/8/9, U24 6, caps, R72.2 | Module VCC + INA sense, no ferrite | OK (no ferrite on VCC — meets u-blox rule) | — | — | PASS |
| Net-(U22-OUT) | U22 9(OUTS)/10(OUT), C50, R72.1, U23 10(IN+) | OUT→shunt→3V3_GPS, OUTS sensed at OUT | OK (OUTS tied at OUT/shunt-high side) | Low | — | PASS |
| GPS_RF_IN | U21 2, J7.1(SMA), L1.1(bias-T), L10.1(ESD) | RF in + bias-T + ESD on antenna node | L10="PGB1010603MR" polymer ESD suppressor (mislabeled as inductor L); bias via L1 from Q11. RF_IN internally DC-blocked → OK | Low (RF) | Rename L10→ESD designator (cosmetic); confirm L1 value | PASS |
| GPS_VBAT (V_BCKP) | U21 36, U34 9/10 (TPS61094 OUT), C48 0.1u, C92/94/96 22u, R108/R110 | Backup supply, ≥2u cap | 66.1u total, fed from supercap backup — OK | Low | Verify V_BCKP current @ max temp vs hold time | PASS |
| GPS_PWR_EN | U22 3 (EN/UV), U12 65 (PC8), R69 100k | MCU-gated LDO enable | OK (R69 to GND = default-off) | Low | — | PASS |
| U21 pin 7 (VCC_RF) | unconnected | NC when external antenna bias used | OK — external bias-T topology | Low | — | PASS |
| U21 pin 52 (EXTINT2) | unconnected | NC acceptable | OK | Low | — | PASS |

#### Design-intent mismatches

| Ref | Doc says | Schematic says | Severity |
|---|---|---|---|
| GPS UART | peripheral_map L137 "UART1 (PD8/PD9)" | PD8/PD9 = USART3 (L123/124, CLAUDE.md) — STM32H5 PD8/9 are USART3 | Low (doc typo; schematic correct) |
| U21 pin 19 | PD5 = GPS_TXRDY/GEOFENCE_STAT | Net GPS_TXRDY on pin whose default fn is GEOFENCE_STAT (TX_READY needs UBX PIO config) | Low |
| GPS SMA ESD | polymer suppressor + separate coaxial GDT arrestor (outdoor) | L10 polymer suppressor present; no GDT | Medium (outdoor/BOM item) |

#### STM32 pin mapping (all verified vs peripheral_map §3)

| Signal | STM32 | F9T pin | Match |
|---|---|---|---|
| USART3_TX→RXD | PD8 (U12.55) | 43 | ✓ |
| USART3_RX←TXD | PD9 (U12.56) | 42 | ✓ |
| TIMEPULSE(PPS) | PA0/TIM2 (U12.23) | 53 | ✓ |
| TIMEPULSE2 | PC6/TIM3 (U12.63) | 54 | ✓ |
| RESET_N | PD11 (U12.58) | 49 | ✓ |
| SAFEBOOT_N | PD15 (U12.62) | 50 | ✓ |
| EXTINT | PD6 (U12.87) | 51 | ✓ |
| D_SEL | PD7 (U12.88) | 47 | ✓ |
| TXRDY/GEOFENCE | PD5 (U12.86) | 19 | ✓ |
| ANT_OFF_MON | PD4 (U12.85) | 5 | ✓ |
| RXD2/TXD2 | PD1/PD0 | 26/27 | ✓ |

#### Layout-critical constraints for this block

| Net/class | Est. | Width/impedance | Placement / return path | Evidence |
|---|---|---|---|---|
| GPS_RF_IN (1.2/1.5 GHz) | RF | 50Ω CPWG/microstrip | Short SMA→bias-T(L1)→U21 pin2; ESD L10 shunt at connector; continuous GND under trace; bias-T inductor + series current-limit R near injection | u-blox IntMan antenna bias; CLAUDE.md RF notes |
| 3V3_GPS to U21 VCC | ~70–120 mA | wide, low-Z | NO ferrite between LDO and VCC; bulk+0.1u close to pins 33/34 | u-blox: "no inductors/ferrite from LDO to VCC" |
| U22 EP / DFN-10 | thermal | EP via field | EP to GND plane vias; LDO drop (5→3.3)×~0.1A≈0.17W | LT3045 DS |
| V_BCKP | µA-class | thin OK | Cap ≥2u (have 66u); from supercap node | u-blox V_BCKP |
| R72 shunt sense | 70–120 mA | Kelvin | INA228 IN+/IN- as differential pair to shunt pads | INA228 DS |

Sources: [LT3045 datasheet](https://www.analog.com/media/en/technical-documentation/data-sheets/lt3045.pdf), [ZED-F9T Integration Manual](https://www.mouser.com/pdfDocs/ZED-F9T-00B_IntegrationManual_UBX-19005590.pdf), [ZED-F9T-00B Data sheet](https://content.u-blox.com/sites/default/files/ZED-F9T-00B_DataSheet_UBX-18053713.pdf).

### GNSS antenna bias + supervisor (gps-antenna.kicad_sch)  —  _verdict: Needs corrections_

## GNSS Antenna Bias + Supervisor — Pre-Layout Review

Scope: `gps-antenna.kicad_sch` (sheet `/GPS Antenna/`, UUID c4e88dde…). Verified against netlist `ntp-server-stm32.net`, doc `gnss_antenna_bias_supervisor.md`, masters, and external datasheets. Reference-by-designator/pin throughout.

### Headline findings
1. **U27 RT9742 load switch is undocumented and the ordered MPN (RT9742VGJ5) does NOT match the schematic symbol pinout** — the canonical doc describes no such device; the symbol is the standard-pinout `RT9742GGJ5` but the BOM part is the M/V-variant which has a different pin map and **no FLG pin**. This is a layout blocker.
2. **L1 value disagreement:** schematic/BOM = **47 nH** (LQG15HS47NJ02D); doc body §3/§8 say **56 nH**. CLAUDE.md says 47 nH. Affects bias-T choke impedance math.
3. **R89 shunt value/MPN mismatch:** value field `100m` vs MPN `KDV08DR150ET` = **0.15 Ω**.
4. **U26 INA228 ALERT (INA_ALERT_V_ANT) has no discrete pull-up** — relies on MCP23017 weak internal pull-up.
5. **Default-state conflict:** new U27 EN (ANT_BIAS_EN, R88 10k pull-down) defaults the antenna **OFF** at power-up, contradicting doc §7's "antenna defaults ON when F9T pin undriven" rationale (which only governs the downstream Q13/Q14 stage).

### Actual as-built topology (from netlist)
`5V → U27 (RT9742 load switch, EN=ANT_BIAS_EN/PC9) → R89 0.15Ω shunt (sensed by U26 INA228 #4 @0x45) → FB6 → V_ANT rail`. V_ANT then feeds: (a) FB4 → R77 3.3Ω → Q11 E→C (PNP pass + Q12 foldback) → L1 → node A → antenna; (b) the Q13/Q14 ANT_OFF disable stage. INA181 U24 senses across R77 (DETECT leg, U25A); node-A÷2 divider → U25B (SHORT leg). This is materially different from the doc, which shows V_ANT going straight into the Q11/Q12 limiter with no upstream load switch or second shunt.

#### IC-by-IC
| RefDes | MPN | Function | Datasheet | Package | Symbol pinout verified | Footprint verified | Power/Gnd | Strap/EN/RST | Required passives | Layout-critical | Status | Conf |
|---|---|---|---|---|---|---|---|---|---|---|---|---|
| U24 | INA181A1IDBVR | Current-sense amp, gain 20 (DETECT) | TI INA181 | SOT-23-6 (DBV0006A_N) | YES — 1=OUT,2=GND,3=IN+,4=IN−,5=REF,6=V+ matches DS | YES — custom DBV0006A_N pads 1-6 = SOT-23-6 | V+(6)=3V3_GPS, GND(2)=GND, REF(5)=GND | none | C53/C54-56 0.1µF decouple; gain fixed | IN+ (pin3) on V_ANT/FB4 side of R77, IN− (pin4) on Q11.E side — verified correct orientation; Vcm 5V on 3.3V VS OK (Vcm range −0.2…+26V) | PASS | High |
| U25 | LMV393 | Dual comparator (A=DETECT, B=SHORT, C=power unit) | TI/ST LMV393 | SOIC/TSSOP/VSSOP-8 (footprint UNSET) | YES — A:1/2/3, B:5/6/7, V+8/V−4 | **NO — no footprint assigned in symbol/netlist** | V+(8)=5V via FB5 (+C57 1µF/C58 0.1µF), V−(4)=GND | OC outputs pull up to 3V3_GPS (R87,R84) | R85/R86, R80-R83 dividers; pull-ups | V+=5V gives Vicr 0…~4.2V (DS: V−−0.1 to V+−0.8), spans all inputs (max ~3V). OC level-shift to 3V3 is fail-safe | WARNING | High |
| U26 | INA228AQDGSRQ1 | Precision V/I/P on V_ANT rail (#4 @0x45) | TI INA228-Q1 | VSSOP-10 (VSSOP10_DGS_TEX) | YES — 10-pin map matches DS | YES — custom pads 1-10 | VS(6)=3V3, GND(7)=GND, VBUS(8)=V_ANT(IN−) | A1(1)=3V3,A0(2)=3V3 → 0x45 (matches map) | R89 shunt; ALERT pull-up MISSING | ALERT(3) open-drain, no discrete pull-up on INA_ALERT_V_ANT | WARNING | High |
| U27 | RT9742VGJ5 (sym=RT9742GGJ5) | High-side load switch gating V_ANT, EN=ANT_BIAS_EN | Richtek DS9742-10 | TSOT-23-5 | **NO — symbol is std-variant (1=OUT,2=GND,3=nFLG,4=EN,5=IN); ordered V-variant has M/V-only pinout 5=EN,4=VOUT,3=VIN,2=GND, NO FLG** | **NO custom .kicad_mod; footprint string "TSOT-23-5" + pinout wrong** | IN(5)=5V, GND(2)=GND | EN(4)=ANT_BIAS_EN (active-high for V variant, 2A limit) | C? input/output caps; nFLG pull-up | nFLG(3)→V_ANT_EN_FAULT→U55.25, but **V variant has no FLG** | FAIL | High |

#### Netlist findings
| Net | Connected pins | Expected | Observed issue | Risk | Fix | Status |
|---|---|---|---|---|---|---|
| Net-(U26-IN+) / V_ANT_EN_FAULT / U27 EN | U27.1/2/4/5, R89.1, C59.1, U26.10; U27.3→U55.25; U27.4=ANT_BIAS_EN+R88 | Load switch wired per RT9742 pinout | Symbol = std-variant pinout; ordered RT9742**V**GJ5 uses M/V pin map (no FLG, VIN/VOUT/GND/EN reordered). Pins land on wrong silicon function | Antenna rail never enables / IC mis-wired; nFLG net is a dead pin | Either order RT9742GGJ5 (matches symbol, 1A, has FLG) or rebuild symbol+footprint for the V pinout and delete V_ANT_EN_FAULT(nFLG) usage. Confirm 1A vs 2A limit suits 180mA load+inrush | FAIL |
| INA_ALERT_V_ANT | U26.3 (ALERT, OD), U54.2 (MCP23017) | OD ALERT with pull-up to 3V3 | No discrete pull-up resistor; only MCP23017 internal weak (~100k) pull-up if GPPU set | ALERT may not reach valid high; depends on firmware enabling internal PU | Add ~10k pull-up to 3V3 on INA_ALERT_V_ANT (consistent with other INA ALERT nets) | WARNING |
| GPS_ANT_DETECT | U25.1 (OC), R87.1 (10k→3V3_GPS), U21.4 (F9T) | OC + pull-up to F9T | OK | low | none | PASS |
| GPS_ANT_SHORT | U25.7 (OC), R84.1 (10k→3V3_GPS), U21.6 (F9T) | OC + pull-up | OK | low | none | PASS |
| GPS_ANT_OFF_MON | U21.5 (F9T ANT_OFF, push-pull), R79.1, U12.85=PD4 | F9T→Q14 + MCU observe, input-only | OK; PD4 must be input-only (FW). R78 100k→GND default | contention if PD4 set output | Keep PD4 input-only per doc §7 | PASS |
| ANT_BIAS_EN | U12.66=PC9, U27.4 (EN), R88.1 (10k→GND) | MCU enable for bias | OK wiring; but default-OFF (pull-down) vs doc "default-on" intent for the antenna | warm-restart antenna stays off until FW drives PC9 | Reconcile doc §7 with U27 default-off; decide intended POR behavior | WARNING |
| Net-(Q11-E) | Q11.3(E), Q12.1(E), R77.1, U24.4(IN−) | Sense node | OK; Q11 SOT-223 pin3=E verified (NSS40300) | low | none | PASS |
| Net-(Q11-C) | Q11.2(C/tab), L1.2, C52.1, R80.1 | Node A (antenna feed) | OK; tab=collector=node A (thermal OK) | low | none | PASS |
| GPS_RF_IN | J7.1(SMA), L1.1, L10.1, U21.2 (F9T RF_IN) | RF + bias-T junction | No on-sheet RF/bias ESD device (no polymer ESD + coax GDT here) | ESD/surge on antenna line | Confirm SMA ESD scheme (polymer Cj≤0.3pF + coax GDT) is on the connector sheet | WARNING |

#### BOM validation (key lines)
| RefDes | MPN | DS found | Package | Footprint | Pkg-FP match | Pinout match | Rating match | Status | Notes |
|---|---|---|---|---|---|---|---|---|---|
| U27 | RT9742VGJ5 | Yes (DS9742-10) | TSOT-23-5 | "TSOT-23-5" (no custom mod) | unverified | NO | 2A limit, EN act-high (V variant) | FAIL | MPN↔symbol pinout mismatch; V variant has no FLG; 2A limit >> 180mA load |
| U24 | INA181A1IDBVR | Yes | SOT-23-6 | DBV0006A_N | Yes | Yes | Vcm 26V, VS 2.7-5.5V | PASS | gain 20 correct for ~5mA threshold |
| U26 | INA228AQDGSRQ1 | Yes | VSSOP-10 | VSSOP10_DGS_TEX | Yes | Yes | AEC-Q100 | PASS | 0x45 straps correct |
| U25 | LMV393 | Yes | SOIC-8 (default) | UNSET | n/a | Yes | 2.7-5.5V | WARNING | assign explicit footprint before layout |
| Q11 | NSS40300MZ4T1G | Yes (onsemi) | SOT-223 | SOT-223-3_TabPin2 | Yes | Yes (1=B,2=C,3=E,tab=C) | 40V/3A/2W vs 5V/180mA | PASS | symbol=BCP51 (same B/C/E order) |
| Q12,Q13 | BC857W | Yes | SOT-323 | SOT-323_SC-70 | Yes | 1=B,2=E,3=C | 45V/100mA | PASS | doc Q12 OK; Q13 added (disable PNP) |
| Q14 | BC847W | Yes | SOT-323 | SOT-323_SC-70 | Yes | NPN | 45V/100mA | PASS | — |
| L1 | LQG15HS47NJ02D | Yes | 0402 | 0402 | Yes | 2-term | **47nH** (doc says 56nH) | WARNING | doc mismatch; Z@1.575GHz=465Ω (>u-blox 500Ω guide is now marginal) |
| R77 | 3.3 1% 0.25W | n/a | 0805 (per doc) | (value-only, FP TBD) | — | — | 130mW @180mA | WARNING | confirm 0805 ≥0.25W footprint assigned |
| R89 | KDV08DR150ET | Yes | 0805 | "0805" | Yes | 2-term | 0.15Ω | WARNING | value field "100m" ≠ part 150mΩ |
| FB4 | BLM15HB121SH1D | Yes | 0402 | 0402 | Yes | — | 120Ω@100MHz | PASS | doc-listed |
| FB5/FB6 | BLM31KN601SN1L | Yes | 1206 | 1206 | Yes | — | 600Ω | WARNING | FB5(U25 5V) & FB6(V_ANT to INA228 IN−) not in doc BOM |
| R73-R88 | ERJ-2RKF… | std | 0402 | R_0402 | Yes | — | values match doc | PASS | R88 (10k EN pull-down) not in doc |

#### Symbol / footprint
| RefDes | MPN | DS package | Symbol pin#s match | Assigned FP | Pad#s match | Pin-1/orient verified | Status |
|---|---|---|---|---|---|---|---|
| U27 | RT9742VGJ5 | TSOT-23-5 (M/V map) | NO | TSOT-23-5 | unknown source lib | NO | FAIL |
| U24 | INA181A1 | SOT-23-6 | YES | DBV0006A_N (custom) | YES (1-6) | rect, pin1 top-L | PASS |
| U26 | INA228 | VSSOP-10 | YES | VSSOP10_DGS_TEX (custom) | YES (1-10) | YES | PASS |
| U25 | LMV393 | SOIC-8 | YES | none | n/a | n/a | WARNING |
| Q11 | NSS40300MZ4 | SOT-223 | YES (B/C/E) | SOT-223-3_TabPin2 | tab=pin2=C | YES | PASS |

#### Layout-critical constraints for this block
| Net/class | Current est | Width/impedance | Placement/return | Evidence |
|---|---|---|---|---|
| GPS_RF_IN (antenna RF) | RF only | 50Ω controlled, short to F9T RF_IN(pin2) | bias-T (L1/C52) at antenna node; keep stub short | u-blox >500Ω choke guide; L1=47nH→Z≈465Ω @1.575GHz (was 554Ω @56nH) |
| V_ANT feed (5V→U27→R89→FB6→FB4→R77→Q11→L1) | ≤180 mA, ~25-30mA inrush | wide DC trace; Kelvin sense at R89 and R77 | R89/U26 and R77/U24 Kelvin pairs; Q11 SOT-223 tab=collector heatsink copper | INA181/INA228 Kelvin requirement; R77 130mW |
| R77 3.3Ω | 180 mA | 0805 ≥0.25W | adjacent to Q11.E and U24 IN+/IN− | doc §10 |
| SMA ESD (RF+5V bias) | — | Cj≤0.2-0.3pF AND V_RWM≥6.5V | polymer ESD + coax GDT at connector | CLAUDE.md / doc; not on this sheet — verify connector sheet |
| 3V3_GPS pull-ups (R84/R87) | µA | — | near F9T | fail-safe when 3V3_GPS off |

#### Design-intent mismatches
| Ref | Doc says | Schematic says | Severity |
|---|---|---|---|
| U27 | (absent) | RT9742VGJ5 load switch gates V_ANT upstream of limiter, EN=PC9, nFLG→U55 | High |
| L1 | 56 nH (§3,§8,§11) | 47 nH (LQG15HS47NJ02D) | Medium |
| Topology | V_ANT direct to Q11/Q12 limiter | 5V→U27→R89/U26→V_ANT→limiter (extra switch + 2nd shunt) | High |
| R89 / U26 second shunt | not described in current-limit section | 0.15Ω shunt + INA228 on switch output | Medium |
| INA228 # | doc table "#4 @0x45"; hardware/CLAUDE.md "U26 @0x45"; master "INA228 #4 @0x45" | U26 @0x45 ✓ | Low (consistent) |
| Q13/R74/R78 default | antenna defaults ON when F9T pin undriven (§7) | U27 EN default-OFF via R88 overrides → antenna OFF at POR | Medium |
| FB5/FB6/R88/Q13 | partially/not in doc §11 BOM | present | Low |

#### Notes / verified-OK
- Q11 (NSS40300MZ4) SOT-223 pin order **1=B,2=C,3=E,tab=C** confirmed (onsemi DS) and matches the BCP51 symbol used + netlist; tab on collector (node A) is acceptable thermally.
- INA181 input orientation correct (IN+ on V_ANT/upstream side of R77), REF=GND unidirectional.
- LMV393 on 5V gives Vicr 0…~4.2V — spans all supervisor inputs; OC outputs to 3V3_GPS are fail-safe.
- I²C SCL/SDA, address straps, supervisor pull-ups, PD4/PC9 mapping all verified against masters.

### OCXO + steering supply (Y3 OH300, U39 TPS7A52 LDO, U38 AP3441 buck, U36 OPA320 Vc buffer, U37 INA228 #5)  —  _verdict: Blocked_

## OCXO + Steering Supply — Pre-Layout Review

Signal chain reconstructed from netlist: **5V → U38 AP3441 buck (≈3.70 V, Net-(D10-K)) → D10 BAT54J → U39 TPS7A52 LDO (≈3.33 V, Net-(D10-A)) → R126 25 mΩ shunt (U37 INA228 high-side) → Y3 OH300 VCC (3.3 V)**. Steering: **PA4/DAC1_OUT1 (OCXO_VC) → R120 100k → U36 OPA320 +IN (loop filter w/ C98, R121 10M, R118/R119/C99 1.65 V bias) → unity buffer → R122 1k → C101 → Y3 Vcontrol (OCXO_V) → PA3 sense (U12.26)**. OCXO output Y3.4 → R123 22Ω → OCXO_CLK_OUT → U52.3 (clock mux I0).

Two functional blockers found (INA228 wrong address strap; AP3441 PG enable chain with no pull-up), plus a project-rule violation (every Vc-path cap is X7R, not C0G/NP0) and an unverifiable custom AP3441 symbol pinout.

#### IC-by-IC

| RefDes | MPN | Function | Datasheet | Package | Symbol pinout verified | Footprint verified | Power/Gnd pins | Strap/EN/RST pins | Required passives | Layout-critical notes | Status | Confidence |
|---|---|---|---|---|---|---|---|---|---|---|---|---|
| Y3 | OH300-61003CV-010.0M | 10 MHz 3.3 V CMOS VCOCXO | conwin cx210 (symbol points to wrong cx282/100 MHz sine) | 7-pad SMD (Oscillator_SMD_OCXO_ConnorWinfield_OH300) | Yes — p1 Vcontrol, p3 VCC, p4 OUT, p7 GND; p2/5/6 NC | Lib FP name matches; pad map not opened | VCC=p3 (Net-(U37-IN-)), GND=p7 | n/a | C105 10µF+C106 10nF on VCC; C101 0.1µF on Vc | Oven draws high warmup current; place INA shunt R126 in VCC; keep Vc trace short/guarded | WARNING | Medium |
| U36 | OPA320AIDBVT | Vc unity buffer (RRIO) | ti.com/lit/ds/symlink/opa320.pdf | SOT-23-5 (DBV) | Yes — 1=OUT,2=V-,3=+IN,4=-IN,5=V+ (matches TI DBV) | FP SOT95P280X145-5N = 5-pad 0.95mm, name OK; .kicad_mod pads not opened | V+=p5→VDDA, V-=p2→GND | n/a (config: OUT tied -IN via R122) | C100 0.1µF on VDDA | Single 3.3 V supply, RRIO within 10 mV of rails — OK for 0–3.3 V Vc; keep on quiet VDDA island | PASS | High |
| U37 | INA228AQDGSRQ1 | OCXO-rail power monitor (target 0x46) | ti.com/lit/ds/symlink/ina228.pdf | VSSOP-10 (DGS) | Yes — p1 A1, p2 A0, p6 VS, p8 VBUS, p9 IN-, p10 IN+ | VSSOP10_DGS_TEX custom; pads not opened | VS=p6→3V3, GND=p7 | **A1=VS, A0=SCL → decodes 0x47, NOT 0x46** | R126 25mΩ shunt; C107 0.1µF on VS | High-side sense: IN+ on LDO out, IN-/VBUS on OCXO side — correct | **FAIL** | High |
| U38 | AP3441SHE-7B | 5 V→~3.70 V pre-reg buck | diodes.com/assets/Datasheets/AP3441-L.pdf | U-DFN2020-8 +EP | **No — custom CM5IO symbol pinout conflicts with LCSC pin table (EN/PG/VIN/LX positions differ); official PDF unfetchable** | DFN-8-1EP_2x2_P0.5_EP1.05x1.75 std KiCad; EP size unverified vs datasheet | VIN=p3→5V, PGND=p4/p8/p9→GND, EP | EN(p7)←5V_PSU_PG; PG(p2)→Net-(U38-PG) **open-drain, no pull-up** | L6 2.2µH, C111/112/114 10µF out, C108 4.7nF FF, R127/R128 FB | Hot loop VIN→LX→L→Cout; CM5IO sym not in sym-lib-table (embedded) | **FAIL** | Low |
| U39 | TPS7A5201QRGRRQ1 | Low-noise LDO ~3.33 V OCXO VCC | ti.com/lit/ds/symlink/tps7a52.pdf | VQFN-20 (RGR) | Yes — FB=3, EN=14, IN=15-17, OUT=19/20, NR/SS=13, BIAS=12, GND=8/18/21(EP) | RGR20_2P05X2P05_TEX custom; pads not opened | IN=p15-17, GND=p8/18/EP21 | EN(p14)←OCXO_PSU_PG (driven from U38 PG chain — see blocker) | C116 10nF NR/SS, R129/R130 0.1% FB, C113/115/117/118 out | 65 mV dropout; 3.70→3.33 has margin; NR/SS sets noise/softstart | WARNING | High |

#### Netlist findings

| Net | Connected pins | Expected | Observed issue | Risk | Fix | Status |
|---|---|---|---|---|---|---|
| U37 A0/A1 straps | U37.1=3V3(VS), U37.2=I2C_SCL | A1=VS, A0=SDA → 0x46 (OCXO) | A1=VS, A0=SCL → **0x47** (collides with Rb U44=0x47) | Two devices at 0x47; OCXO monitor unreachable / bus conflict | Move U37.2 (A0) from I2C_SCL to **I2C_SDA** (datasheet: add 100 ns MSB hold for SDA-strap) | FAIL |
| Net-(U38-PG) | U38.2 (AP3441 PG, open-drain), R125.1 | Open-drain PG + pull-up to logic rail | **No pull-up anywhere**; node + OCXO_PSU_PG only see R125(6.81k)→R124(10k)→GND | PG can only pull low/float → OCXO_PSU_PG never reaches valid high → **U39 LDO EN never asserts → OCXO unpowered** | Add pull-up (e.g. 10k to 3V3) on Net-(U38-PG); re-evaluate R124/R125 divider (also blocked on confirming AP3441 PG structure/pinout) | FAIL |
| OCXO_V (Vc) | Y3.1, C101, R122(→U36 buffer), U12.26(PA3) | Vc buffered, defined, never floating | OK — OPA320 drives via R122; 1.65 V via R118/R119/R121(10M) holds +IN if PA4 hi-Z; C101 0.1µF post-filter | Low (but cap dielectric — see below) | None (topology sound) | PASS |
| OCXO_VC (DAC) | U12.29(PA4), R120(100k→+IN) | DAC drives loop filter | OK | Low | None | PASS |
| OCXO_CLK_OUT | Y3.4→R123(22Ω)→U52.3 | Source term at OCXO driver into mux | Correct — series R at driver, no receiver-end dup | Low | None | PASS |
| Net-(U37-IN-) | U37.8(VBUS),U37.9(IN-),R126.1,C105,C106,Y3.3 | OCXO VCC = INA low side, VBUS senses it | Correct high-side shunt orientation | Low | None | PASS |

#### BOM validation (key lines)

| RefDes | MPN | Datasheet found | Package | Footprint | Pkg-FP match | Pinout match | Rating match | Status | Notes |
|---|---|---|---|---|---|---|---|---|---|
| Y3 | OH300-61003CV-010.0M | Yes (cx210) | 7-SMD | Oscillator_SMD_OCXO_ConnorWinfield_OH300 | Yes | Yes | 3.3 V 10 MHz CMOS | PASS | Symbol Datasheet prop = cx282/100 MHz sine — WRONG link; fix to cx210 |
| U36 | OPA320AIDBVT | Yes | SOT-23-5 | SOT95P280X145-5N | Yes | Yes | 1.8–5.5 V | PASS | — |
| U37 | INA228AQDGSRQ1 | Yes | VSSOP-10 | VSSOP10_DGS_TEX | Yes | Yes | 85 V | PASS (part) | Address strap wrong (see netlist) |
| U38 | AP3441SHE-7B | PDF 403; LCSC partial | DFN2020-8-EP | DFN-8-1EP_2x2mm_P0.5mm_EP1.05x1.75mm | Unverified (EP) | **Conflict** | 2.7–5.5 Vin/3A | FAIL | Custom CM5IO symbol; verify pinout + EP vs official drawing |
| U39 | TPS7A5201QRGRRQ1 | Yes | VQFN-20 RGR | RGR20_2P05X2P05_TEX | Yes | Yes | 1.1–6.5 Vin, 2A | PASS | — |
| R126 | (TBD) 25mΩ | Ohmite KDV | 0805 | 0805 | Yes | n/a | SHUNT-REVIEW | WARNING | Value TBD per OCXO oven current (open item) |
| R129/R130 | RQ73C 12.1k/3.83k 0.1% | Yes (TE) | 0603 | 0603 | Yes | n/a | 0.1% | PASS | Sets LDO 3.328 V |
| R127/R128 | 12.4k/2.4k 1% | Yes | 0402 | R_0402 | Yes | n/a | 1% | PASS | Sets buck 3.70 V |
| C98/C99/C101 | GRM155R71C104 (X7R) | Yes | 0402 | C_0402 | Yes | n/a | **X7R on Vc path** | FAIL | Must be C0G/NP0 or film (project hard rule) |
| C109/C117 | 22µF (no MPN) | partial | 0805 | C_0805 | — | n/a | SELECT OCXO-C0G? | WARNING | On buck-out rail, not Vc; status open in BOM |

#### Symbol / footprint

| RefDes | MPN | Datasheet package | Symbol pin#s match | Assigned footprint | Pad#s match | Pin-1/orientation verified | Status |
|---|---|---|---|---|---|---|---|
| U36 | OPA320AIDBVT | SOT-23-5 DBV | Yes (1 OUT…5 V+) | OPA320AIDBVT:SOT95P280X145-5N | Implied 5; .kicad_mod not opened | Not opened | WARNING |
| U37 | INA228 | VSSOP-10 DGS | Yes | VSSOP10_DGS_TEX | Not opened | Not opened | WARNING |
| U38 | AP3441SHE-7B | DFN2020-8 EP | **No (conflict)** | DFN-8-1EP_2x2mm_P0.5mm_EP1.05x1.75mm | Unverified | Unverified | FAIL |
| U39 | TPS7A52 | VQFN-20 RGR | Yes | RGR20_2P05X2P05_TEX | Not opened | Not opened | WARNING |
| Y3 | OH300 | 7-pad OCXO | Yes | Oscillator_SMD_OCXO_ConnorWinfield_OH300 | Not opened | Not opened | WARNING |

#### Layout-critical constraints for this block

| Net/class | Current est | Width/impedance | Placement/return-path | Evidence |
|---|---|---|---|---|
| OCXO VCC (Net-(D10-A)/U37-IN-/Y3.3) | OCXO oven warmup high (OH300 warmup ~ up to ~1 A region, steady hundreds mA) | Wide pour; Kelvin across R126 shunt | INA228 R126 directly in series; keep shunt-sense traces Kelvin/differential | OH300 oven, INA228 datasheet sense layout |
| Vc / OCXO_V (Y3.1) | µA | High-Z node; guard ring | Short trace OPA320→R122→Y3.1; keep away from switching nodes; C0G/film caps only | CLAUDE.md hard rule; OPA320 ds |
| U38 buck hot loop VIN-LX-L6-Cout | ≤3 A pulsed | Minimize loop area; star PGND to EP | C102-104 in at U38; L6/Cout tight; switching noise away from Vc/OCXO | AP3441 ds layout |
| OCXO_CLK_OUT (Y3.4→R123→U52.3) | CMOS 10 MHz | 50Ω-ish controlled; R123 at driver | Series term at OCXO; route to mux as quiet clock; reference GND | sts1000_clock_mux.md |
| EP thermals U38/U39 | — | Multiple thermal vias under EP | U39 LDO dissipates (3.70−3.33)×I; U38 buck losses | TPS7A52 / AP3441 ds |

#### Design-intent mismatches

| Ref | Doc says | Schematic says | Severity |
|---|---|---|---|
| U37 INA228 | OCXO INA228 = 0x46 (peripheral_map, CLAUDE.md INA map) | Strapped A1=VS/A0=SCL = 0x47 (= Rb U44) | High (blocker) |
| Vc-path caps | "C0G/NP0 or film — NEVER X7R" (CLAUDE.md, hardware/CLAUDE.md) | C98, C99, C101 all GRM155R71C104 = X7R | High |
| Loop-filter scaling | "scale DAC 0–3.3 V to ±0.4 ppm, set loop τ" (peripheral_map §14) | Unity buffer → Vc = full 0–3.3 V (R121 10M bias negligible); no ±0.4 ppm attenuator | Medium (open item, but resolution/holdover impact) |
| Y3 symbol datasheet | OH300-61003CV 10 MHz CMOS (cx210) | Symbol Datasheet = cx282.pdf / "100 MHz Sinewave OCXO"; Description says 100 MHz sine | Low (doc hygiene; BOM/MPN correct) |
| AP3441 symbol | (no doc pinout) | Custom CM5IO pinout conflicts with LCSC pin table | High (must verify before layout) |

### Clock mux (OCXO/ext-ref -> PH0)  —  _verdict: Needs corrections_

## Clock mux (OCXO/ext-ref -> PH0) - Pre-layout review

Scope: `clock-mux.kicad_sch` (U52 74LVC1G157GW-Q100H selector, U53 74LVC1G34 fanout buffer, R187/R188/R189, C157/C158/C159/C160, FB10). Connectivity verified against `ntp-server-stm32.net`; values/PNs against `sts1000_bom.csv`; intent against `sts1000_clock_mux.md`.

**Bottom line:** Electrical design and connectivity are correct and match the canonical doc (select polarity, R188 default-OCXO pulldown, source-termination at drivers only, Y-node fanout tap before R187, per-pin decoupling, GND on U52 pin 2 only, U53 NC properly unconnected). **Two hard blockers stop layout:** U52 footprint is the wrong package for the GW MPN, and U53 has no footprint at all. Plus several MPN/grade/doc deltas.

#### IC-by-IC

| RefDes | MPN | Function | Datasheet | Package (DS) | Symbol pinout verified | Footprint verified | Power/Gnd | Strap/EN/RST | Required passives | Layout-critical notes | Status | Conf |
|---|---|---|---|---|---|---|---|---|---|---|---|---|
| U52 | 74LVC1G157GW-Q100H | 2:1 clock selector (Schmitt in, IOFF, AEC-Q100) | Nexperia 74LVC1G157_Q100 Rev.6 2025-09-09 | **SOT363-2 / TSSOP6, 1.25 mm body, 0.65 mm pitch** | YES: 1=I1,2=GND,3=I0,4=Y,5=VCC,6=S matches DS | **FAIL - SOT457 fp (0.95 mm pitch) on a SOT363 part** | VCC=5 (3V3_CLK), GND=2 | S=6 (MUX_SEL/PB6), R188 100k pulldown -> default I0/OCXO | C158 0.1uF at pin5; series R187 22R at Y | Place adjacent to PH0; keep Y->R187->CLK_OUT short over continuous GND | **FAIL** | High |
| U53 | 74LVC1G34 (doc: 74LVC1G34GW-Q100) | Bench-fanout buffer (non-inverting) | TI sn74lvc1g34 (symbol) / Nexperia 74LVC1G34_Q100 (doc) | SOT353-1 / TSSOP5, 0.65 mm pitch | YES: 1=NC,2=A,3=GND,4=Y,5=VCC = std 1G34 | **FAIL - no footprint assigned** | VCC=5 (3V3_CLK), GND=3 | none | C159 0.1uF at pin5; R189 22R + C160 at Y | Place next to U52; input (pin2) taps Y node before R187 | **FAIL** | High |

#### Netlist findings

| Net | Connected pins | Expected | Observed | Risk | Fix | Status |
|---|---|---|---|---|---|---|
| OCXO_CLK_OUT | R123.2, U52.3 (I0) | OCXO buf (src-term R123 22R upstream) -> I0, no rx-end R | Exactly that; no receiver series R | none | - | PASS |
| 10MHz_CLK_OUT | R184.1, U12.53 (PB14), U52.1 (I1) | ext-ref (src-term R184 33R) -> I1, also EXTREF_MON | Exactly that | none | - | PASS |
| Net-(U52-Y) | U52.4 (Y), R187.2, U53.2 (A) | Y -> R187 -> PH0, fanout tap at Y before R187 | Exactly that | none | - | PASS |
| CLK_OUT | R187.1, PH0 (other sheet) | R187 -> PH0 OSC_IN | Present | none | keep short/over GND | PASS |
| MUX_SEL | U52.6 (S), R188.1, PB6 (other sheet) | S with 100k pulldown to GND | R188.1 on net, R188.2 to GND, S=PB6 | none | - | PASS |
| 3V3_CLK | FB10.1, C157.1, C158.1, C159.1, U52.5, U53.5 | FB10 out feeds both VCC + 3 caps | Exactly that | none | C157 bulk at FB10, C158/C159 at pins | PASS |
| 10MHz_RF_OUT | C160.2 -> SMA/D16 (off-page) | U53.Y -> R189 -> C160 -> SMA, ESD at connector | C160.2 = RF_OUT; D16 off-page on Connectors sheet | verify D16 ref exists | confirm D16 placed at SMA | PASS (off-page ESD unverified here) |
| unconnected-(U53-NC-Pad1) | U53.1 (NC) | NC, no-connect flagged | Flagged unconnected | none | - | PASS |
| GND | U52.2, U53.3, R188.2, caps.2 | single GND on U52 pin2 only | Confirmed (no I0/GND tie) | none | - | PASS |

#### BOM validation

| RefDes | MPN | DS found | Package | Footprint | Pkg-FP match | Pinout match | Rating | Status | Notes |
|---|---|---|---|---|---|---|---|---|---|
| U52 | 74LVC1G157GW-Q100H | Yes | SOT363-2/TSSOP6 | SC-74_TSOP6_SOT457_NEX (SOT457) | **NO** | Yes | VCC 1.65-5.5 V, Q100, ok | **FAIL** | GW pitch 0.65 vs fp 0.95; MANUFACTURER blank, MPN-FROM-VALUE |
| U53 | 74LVC1G34 | TI generic | SOT353-1 (doc) | **(blank)** | **N/A** | Yes (std) | grade not pinned | **FAIL** | No footprint; doc wants Nexperia GW-Q100 |
| R187 | ERJ-2RKF22R0X 22R 0402 | Yes | 0402 | R_0402_1005Metric | Yes | n/a | 1% 1/10W ok | PASS | Y->PH0 damp |
| R188 | ERJ-2RKF1003X 100k 0402 | Yes | 0402 | R_0402_1005Metric | Yes | n/a | ok | PASS | SEL default pulldown |
| R189 | ERJ-2RKF22R0X 22R 0402 | Yes | 0402 | R_0402_1005Metric | Yes | n/a | ok | PASS | fanout src-match (trim 22-33) |
| C157 | C2012X7R1E475K 1uF 25V 0603 | Yes | 0603 | C_0603_1608Metric | Yes | n/a | 25V X7R ok | PASS | 3V3_CLK bulk |
| C158 | GRM155R71C104KA88J 0.1uF 16V 0402 | Yes | 0402 | C_0402_1005Metric | Yes | n/a | 16V ok | PASS | U52 VCC decap |
| C159 | GRM155R71C104KA88J 0.1uF 16V 0402 | Yes | 0402 | C_0402_1005Metric | Yes | n/a | 16V ok | PASS | U53 VCC decap |
| C160 | GRM155R71C104KA88J 0.1uF 16V 0402 | Yes | 0402 | C_0402_1005Metric | Yes | n/a | **16V (doc says 50V)** | WARNING | fanout DC block; X7R ok here, rating below doc |
| FB10 | BLM31KN601SN1L 600R 1206 | Yes | 1206 | 1206 | Yes | n/a | ok | WARNING | doc says 0603 |

#### Symbol/footprint

| RefDes | MPN | DS package | Symbol pin#s match | Assigned footprint | Pad#s match | Pin-1/orient verified | Status |
|---|---|---|---|---|---|---|---|
| U52 | 74LVC1G157GW-Q100H | SOT363-2 (0.65 mm) | Yes (1/2/3/4/5/6 = I1/GND/I0/Y/VCC/S) | SOT457 0.95 mm pitch | pad count ok, **pitch/body wrong** | n/a until fp fixed | **FAIL** |
| U53 | 74LVC1G34GW-Q100 | SOT353-1 (0.65 mm) | Yes (1/2/3/4/5 = NC/A/GND/Y/VCC) | **none** | **N/A** | **N/A** | **FAIL** |

#### Layout-critical constraints

| Net/class | Est | Width/Z | Placement / return | Evidence |
|---|---|---|---|---|
| CLK_OUT (Y->R187->PH0) | 10 MHz CMOS, ~3.3 Vpp | short, controlled, continuous GND ref | U52 adjacent to PH0; do not exceed VDD at PH0 (abs-max VDD+0.3) | doc sec 0/3.2/7; on-sheet note "keep trace short over continuous ground to STM32" |
| OCXO_CLK_OUT / 10MHz_CLK_OUT input stubs | 10 MHz CMOS | short stubs, src-term at driver (R123 22R, R184 33R) | continuous GND under both | doc sec 7; netlist confirms no rx-end R |
| 10MHz_RF_OUT | 10 MHz, ~1.6 Vpp into 50 ohm | 50 ohm controlled, AC-coupled (C160), ESD (D16) at SMA | steer away from PH0, return on same plane | doc sec 3.3/7 |
| 3V3_CLK rail | low mA | FB10 (600R@100MHz) + C157 1uF at entry; C158/C159 at each VCC pin | VDD-domain (<= VDD so PH0 not over-driven) | doc sec 0/3.5; netlist net 4 |

#### Design-intent mismatches
See docMismatches array: U52 package (High), U53 vendor/grade/footprint (Medium), FB10 0603-vs-1206 (Low), C160 50V-vs-16V (Low). Electrical intent otherwise matches doc.

### External 10 MHz RF front end (refclock-input.kicad_sch)  —  _verdict: Needs corrections_

## External 10 MHz RF Front End — Pre-Layout Review (`refclock-input.kicad_sch`)

Reviewed against `docs/ntp_server_rf_frontend.md`, `peripheral_map`, netlist `ntp-server-stm32.net`, and `sts1000_bom.csv`. Topology, symbol pinouts, and footprints for the three ICs are correct; the blockers are **a mis-wired LT3045 PGFB (PG non-functional), two unselected clamp diodes (no footprint/MPN), and two missing bypass/decoupling caps required by the doc.**

**Designator map (doc → as-built):** D11→D8(SMA ESD), D12→D19(N2 clamp), D13→D20(island), D14→D21(VCC), D15→D18(switch clamp); R134/R135→R174/R175, R140/R141→R179/R180, R142→R182, R143→R183, R144→R184, R147→R176, R177/R178/R181/R185/R186 unchanged; C133→C150, C134/C137→C154/C156, C135→C155, C136→C151, +VCC byp C152(1µF)/C153(0.1µF); FB9, U49/U50/U51 unchanged.

#### IC-by-IC
| RefDes | MPN (as-built) | Function | Datasheet | Package | Symbol pinout verified | Footprint verified | Power/Gnd pins | Strap/EN/RST pins | Required passives | Layout-critical notes | Status | Conf |
|---|---|---|---|---|---|---|---|---|---|---|---|---|
| U49 | TMUX1101DCK (placeholder) | Switched 50 Ω term (SEL=REF_TERM_EN, active-high=ON) | ti.com/lit/ds/symlink/tmux1101.pdf | SC70-5 (DCK) | YES — 1=D,2=S,3=GND,4=SEL,5=VDD matches symbol | YES — SOT-353_SC-70-5 = DCK 5-lead | GND=3, VDD=5 (3V0_RF) | SEL(4)=PC10, fail-safe/OV-tolerant; default-term via R176 100k→3V3 | **0.1 µF VDD decoupler MISSING**; D18 pin-2 clamp present | VDD+GND+term return kept in island/analog GND; grounded-end placement | WARNING | High |
| U50 | LTC6752xS5 (commit I/H, base) | 10 MHz comparator/squarer | analog.com/.../6752fc.pdf | TSOT-23-5 | YES — 1=Q,2=VEE,3=+IN,4=−IN,5=VCC matches symbol | YES — TSOT-23-5 | VEE=2(GND), VCC=5 (via R183, D21 clamp, 0.1+1µF) | none (S5 has no LE/HYST) | **REF_VMID 0.1 µF MISSING**; R181 1k +IN limiter, R182 100k self-bias, C151 10nF AC-couple, R184 33Ω out | S5 single-supply abs-max ~3.6 V → R183+D21 hold VCC≈2.85 V; tight VMID/VCC bypass | WARNING | High |
| U51 | LT3045xDD (commit grade) | 3.0 V ultralow-noise island LDO | analog.com/.../lt3045.pdf | DFN-10 3×3 (EP) | YES — 1/2=IN,3=EN/UV,4=PG,5=ILIM,6=PGFB,7=SET,8/11=GND,9=OUTS,10=OUT matches symbol | YES — DFN-10-1EP_3x3 | IN=1/2(5V via FB9), GND=8/11(EP) | EN/UV(3)=5V_PSU_PG | R186 30.1k SET, R185 1.5k ILIM, C154/C156 10µF, C155 10nF Cset, FB9 600Ω | EP→GND; Kelvin SET/ILIM grounds to pin8; **PGFB mis-wired to VIN** | FAIL | High |

#### Netlist findings
| Net | Connected pins | Expected | Observed issue | Risk | Fix | Status |
|---|---|---|---|---|---|---|
| Net-(U51-PGFB) | U51.1/2(IN), U51.6(PGFB), FB9.1, C154.1 | PGFB on OUT→PGFB→GND divider | PGFB tied to VIN → PG always "good" | High (false power-good to U55 GPA2) | Add OUT/GND divider to PGFB; remove PGFB-VIN tie | FAIL |
| 3V0_RF_LDO_PG | U51.4(PG), U55.19(GPA2) | OC PG with pull-up | No external pull-up (relies on MCP23017 GPPU) | Med | Add ~100k pull-up to 3V3_STM or doc GPPU contract | WARNING |
| Net-(U50--) (REF_VMID) | R179.1,R180.2,R182.1,U50.4 | + 0.1 µF to GND | No bypass cap | High (noisy threshold/jitter; §5.4 math void) | Add 0.1 µF to GND at U50 −IN | FAIL |
| 3V0_RF (U49 VDD) | U49.5 + island (only C156 nearby) | local 0.1 µF at U49 | No dedicated decoupler | Low-Med | Add 0.1 µF at U49 pin5 | WARNING |
| Net-(C149-Pad2)=N1 | C149.2,R174.1,R175.2,R177.2,R178.2 | 1.5 V bias, no clamp/bypass | OK (matches doc) | — | — | PASS |
| Net-(D19-COM)=N2 | R178.1,D19.COM,C151.1 | clamped via D19 to island, R178 limit | OK | — | — | PASS |
| Net-(D21-K)=U50 VCC | R183.1,D21.K,C152.1,C153.1,U50.5 | VCC guard node | OK (R183 33Ω + D21 + 0.1+1µF) | — | — | PASS |
| 10MHz_CLK_OUT | R184.1,U12.PB14,U52.I1 | Q→33Ω→{mux B, EXTREF_MON} | Branched net off single series R | Low | Keep PB14 a short stub | PASS |
| REF_TERM_EN | R176.1,U12.PC10,U49.4 | SEL + 100k→3V3 pull-up | OK (default terminated) | — | — | PASS |

#### BOM validation (selected)
| RefDes | MPN | Datasheet found | Pkg | Footprint | Pkg-FP match | Pinout match | Rating match | Status | Notes |
|---|---|---|---|---|---|---|---|---|---|
| U49 | TMUX1101DCK | Yes | SC70-5 | SOT-353_SC-70-5 | Yes | Yes | 1.08–5.5 V VDD ok @3.0 V | WARNING | Needs orderable PN (DCKR); doc says SC70-6 (wrong) |
| U50 | LTC6752xS5 | Yes | TSOT-23-5 | TSOT-23-5 | Yes | Yes | base S5 3.5 V op / ~3.6 V abs-max → guarded | WARNING | Commit I/HS5 (temp grade); confirm NOT −2/−3 |
| U51 | LT3045xDD | Yes | DFN-10 | DFN-10-1EP_3x3 | Yes | Yes | 20 V in, 5 V in ok | WARNING | Commit E/I/H/MP grade |
| D18,D19 | BAT54S | Yes | SOT-23 | SOT-23 (3-lead) | Yes | Yes (A/K/COM) | 30 V/200 mA ok | PASS | symbol desc wrongly says "SOT-323" but FP=SOT-23 |
| D20,D21 | (none) "3V3" zener | No | — | **none** | — | — | unselected | FAIL | No footprint, no MPN — blocker |
| R177 | ERJ-2RKF49R9X | Yes | 0402 | 0402 | Yes | n/a | 49.9 Ω **1%** | WARNING | doc wants 0.1% thin-film |
| R186 | ERJ-2RKF3012X | Yes | 0402 | 0402 | Yes | n/a | 30.1 kΩ **1%** | WARNING | doc wants 0.1% (±30 mV on Vout) |
| C152 | (none) 1µF | partial | 0603 | 0603 | Yes | n/a | 16 V X7R | WARNING | Status SELECT, commit MPN |
| C149/150/151/153/154/155/156, R174/175/176/178–185, FB9 | Murata/Panasonic | Yes | 0402/0603/0805/1206 | matched | Yes | n/a | ok | PASS | values match doc |
| (missing) REF_VMID 0.1µF | — | — | — | — | — | — | — | FAIL | required by doc, absent |
| (missing) U49 VDD 0.1µF | — | — | — | — | — | — | — | FAIL | required by doc, absent |

#### Symbol/footprint
| RefDes | Datasheet package | Symbol pin#s match | Assigned footprint | Pad#s match | Pin-1/orientation | Status |
|---|---|---|---|---|---|---|
| U49 | SC70-5 DCK (1=D,2=S,3=GND,4=SEL,5=VDD) | Yes | SOT-353_SC-70-5 | Yes (5) | std SC70 pin1 | PASS |
| U50 | TSOT-23-5 (1=Q,2=VEE,3=+IN,4=−IN,5=VCC) | Yes | TSOT-23-5 | Yes (5) | std | PASS |
| U51 | DFN-10 3×3 1EP | Yes | DFN-10-1EP_3x3mm_P0.5mm | Yes (10+EP) | std | PASS |
| D20,D21 | TBD (TVS/zener SOD) | n/a | none | — | — | FAIL (assign) |

#### Layout-critical constraints for this block
| Net/class | Current est | Width/impedance | Placement/return-path | Evidence |
|---|---|---|---|---|
| 10MHz_RF_IN (SMA→N1) | mW-level RF | 50 Ω controlled-Z, continuous GND under trace | D8 at SMA pads, C149 immediately after, R177 close to N1; no plane split, stitch vias along trace | doc §7; sheet text "50-ohm trace all the way through" |
| 3V0_RF island | ≈5 mA + clamp surges (≤~27 mA @ +20 dBm) | wide pour, LDO out caps tight | FB9+LT3045 isolate on supply, NOT on return; common continuous GND | doc §2, §6.2, §7 |
| U51 SET/ILIM grounds | µA Kelvin | thin Kelvin traces | route R185/R186 grounds directly to U51 pin8 on same plane | doc §7; LT3045 datasheet Kelvin req |
| U50 VCC / +IN / VMID | switching transients | short, low-loop | R183+D21+0.1+1µF tight to pin5; R181+C151 tight to +IN; (add) VMID 0.1µF close to −IN | doc §7 |
| 10MHz_CLK_OUT | CMOS edge ~1.2 ns | series-at-driver R184; short PB14 stub | route as ordinary signal over same plane, away from RF node | doc §7, §13 |
| ESD/over-power | ±8 kV / +20 dBm cont. | — | D8 at connector; D19/D18 clamps with minimal loop to plane; D20 adjacent U51 out | doc §3, §6 |

#### Design-intent mismatches
See docMismatches array: U49 package (doc SC70-6 vs actual SC70-5), U51 PG (doc "float/unused" vs wired to U55 GPA2), R177/R186 precision grade (0.1% doc vs 1% BOM), incomplete designator re-annotation in doc body, and cosmetic +3.3V power-symbol glyphs on 3V0_RF/5V nets.

### Rb buck supply (VCC_RB)  —  _verdict: Blocked_

## Rb buck supply (VCC_RB) — pre-layout review

Status: **Blocked.** Core regulation topology, the fixed-resistor safety bound, and the autonomous OV latch are sound and math-verified, but there are multiple hard defects that prevent layout/operation: an INA228 I2C bus swap + address collision, undersized output caps, a digipot VDD-vs-terminal abs-max violation, and two parts with no footprint (L7, U41).

### Verified-correct highlights
- **Fixed-resistor safety bound (critical requirement) PASSES.** FB=0.6V, R147=20k, R148=576, R134(Rctrl)=4.12k. VOUT = 0.6·(1+R1/R2+R1/Rctrl) − (R1/Rctrl)·VCTRL = 24.35 − 4.854·VCTRL. With VCTRL hard-limited 0…VREF(4.096V), VOUT is bounded **4.46V (D=0, wiper at B) … 24.35V (D=1023, wiper at A)** for *every* possible wiper code (POR/mid-scale/SPI-fault). No code exits the bound. Confirmed by independent calc.
- **Autonomous 26V OV latch PASSES (firmware-independent).** Sense R138(120k)/R139(10k)=0.0769 → 26.0V trips. Ref R136(10.5k)/R137(10k) off VREF → 1.998V. Regenerative Q16(NPN)/Q17(PNP) hold via R151(4.7k) off always-on +5V; Q18 clamps RB_PSU_PWR_EN < 0.6V; D11 isolates the comparator so a VCC_RB collapse cannot re-arm. Latches off (not hiccup). Reset via Q15 from RB_OV_RESET (PD3). RB_OV_DET → PE3 (polled). Trip ladder 24.35 < 26 < 28 (TVS standoff) < ~31 (VBR) < ~45 (clamp) is consistent — latch fires before the TVS conducts. (Caveat: OV reference is gated with the buck — see High Risk.)
- **MIC28516 (U40) bias network PASSES.** SVIN←VOUT_P via R162 2.2Ω + C135 1µF; VDD (internal LDO out) bypass C138 2.2µF; PVDD←VDD via R163 2.2Ω + C137 4.7µF; EXTVDD→GND (unused, allowed). Matches Microchip datasheet recommended connection. EN=RB_PSU_PWR_EN, FB net, SS=C119 10nF, ILIM=R140 2.21k, FREQ=R132/R133 divider, BST=C124 0.1µF, PG=RB_PSU_PG (R143 10k→3V3, also to U55).
- **OPA320 (U42)** unity follower correct: +IN←U43 wiper, −IN↔OUT, OUT→R134; V+ = 5V (C122), V−=GND. Pinout matches TI SOT-23-5.
- **MCP1502 (U45)** pinout correct (1=OUT,2/3/5=GND,4=nSHDN,6=VDD=5V).

#### IC-by-IC
| RefDes | MPN | Function | Datasheet | Package | Symbol pinout verified | Footprint verified | Power/Gnd | Strap/EN/RST | Required passives | Layout-critical | Status | Conf |
|---|---|---|---|---|---|---|---|---|---|---|---|---|
| U40 | MIC28516T-E/PHA | 70V/8A sync buck (VCC_RB) | DS20006315 | 32-PowerVQFN (33 incl. EP) | Yes | Yes (32-PowerVQFN) | PVIN×7→VOUT_P, PGND/EP→GND, SVIN/VDD/PVDD biased | EN=RB_PSU_PWR_EN, PG=RB_PSU_PG | C119 SS,C124 BST,R140 ILIM,R132/3 FREQ,R162/3 2.2Ω,C135/7/8 | EP thermal; SW node loop; FB Kelvin; VIN headroom to 70V | WARNING | High |
| U43 | MCP41U83T-503E/ST | 10-bit SPI digipot (FB setpoint) | DS20007000 | TSSOP-14 | Medium (functions self-consistent; PDF not OCR-able) | Yes (TSSOP-14) | VDD=3V3(!), VSS/DGND=GND | SPI2C→GND (SPI mode); CS=PD2; A0/A1 are CS/SDO in SPI | C121 0.1µF | **VDD<P0B(4.096V) abs-max violation**; keep wiper/pot trace short | FAIL | High |
| U44 | INA228AQDGSRQ1 | V/I monitor (0x47 target) | INA228-Q1 | VSSOP-10 DGS | Yes (TI table) | Yes (VSSOP10_DGS) | VS=3V3, GND | A1=VS,A0=SDA→**0x46 collision**; **SDA/SCL swapped** | C131 0.1µF | Kelvin across R159; bus swap | FAIL | High |
| U45 | MCP1502T-40E/CHY | 4.096V series ref (VREF_4V096) | DS20006593 | SOT-23-6 | Yes | Yes (SOT-23-6) | VDD=5V, GND | nSHDN **gated by RB_PWR_EN** (doc says always-on) | C182 1µF (missing from BOM) | ref noise; settle vs SS | WARNING | High |
| U42 | OPA320AIDBVT | Wiper buffer → VCTRL | OPA320 | SOT-23-5 | Yes | Yes | V+=5V, V−=GND | — | C122 0.1µF | — | PASS | High |
| U41 | LMV393 (½) | 26V OV comparator | LMV393 (TI) | SOIC/VSSOP-8 | Yes (TI pinout) | **NONE assigned** | V+=5V via FB8, V−=GND; unused half +5V/GND | open-drain OUT, R142 47k pull-up | R136-139, R141 hyst | assign footprint | FAIL | High |

#### Netlist findings
| Net | Connected pins | Expected | Observed issue | Risk | Fix | Status |
|---|---|---|---|---|---|---|
| I2C_SCL / I2C_SDA at U44 | U44.4(SDA)→I2C_SCL, U44.5(SCL)→I2C_SDA | SDA→SDA, SCL→SCL | **Swapped** | No comms | Swap nets | FAIL |
| U44 addr | A1→VS(3V3), A0→I2C_SDA → 0x46 | 0x47 | Collides with OCXO INA (0x46) | Bus address conflict | A1=VS, A0=SCL → 0x47 | FAIL |
| Net-(U44-IN+) (=VCC_RB out) | C126/127/128 47µF **16V**, L7.2, R147, R159 | COUT ≥63V | 16V caps on 24.35V/45V-clamp rail | Cap short failure | ≥63V X7R/X7T | FAIL |
| U43 P0B vs VDD | P0B=VREF 4.096V, VDD=3V3 | terminal ≤ VDD | abs-max violation | Clamp/damage | Raise VDD to 5V or lower VREF | FAIL |
| L7 | fp=NONE; val 40µH vs MPN 6.8µH | defined L + footprint | unassigned/conflict | Layout blocked | Resolve L, assign FP | FAIL |
| VREF_4V096 | U45.1, U43.8(P0B), R136, C182 | ref + bypass | C182 not in BOM | Not ordered | Add to BOM | FAIL |
| Net-(Q19-C) | U45.nSHDN, Q19.C, R157→5V | nSHDN always high | gated by RB_PWR_EN | startup race / doc mismatch | sequence or tie always-on | WARNING |
| RB_PSU_PWR_EN | U40.EN, R156(→PB7), Q18.C | EN drive + OV clamp | OK | — | — | PASS |
| Net-(U40A-FB) | R147,R148,R134,C123,C125,U40.27 | 5-way FB node | OK (matches doc) | — | — | PASS |
| D11.2 | unconnected-(D11-NC-Pad2) | NC | OK (SOT-323 center is NC on BAS16W) | none | — | PASS |
| U43.12-14 | NC | NC pins | OK left open | none | — | PASS |

#### BOM validation (key lines)
| RefDes | MPN | DS found | Package | Footprint | Pkg-FP match | Pinout match | Rating match | Status | Notes |
|---|---|---|---|---|---|---|---|---|---|
| U40 | MIC28516T-E/PHA | Yes | 32-PowerVQFN | 32-PowerVQFN | Yes | Yes | 70V VIN ok | PASS | — |
| U41 | LMV393 (generic) | Yes | SOIC/VSSOP-8 | NONE | — | Yes | — | FAIL | commit MPN+FP |
| U43 | MCP41U83T-503E/ST | Yes | TSSOP-14 | TSSOP-14 | Yes | Medium | term>VDD | FAIL | VDD/VREF conflict |
| U44 | INA228AQDGSRQ1 | Yes | VSSOP-10 | VSSOP10_DGS | Yes | Yes | ok | WARNING | addr/bus fix |
| U45 | MCP1502T-40E/CHY | Yes (note BOM desc wrongly says 3.3V; -40 = 4.096V) | SOT-23-6 | SOT-23-6 | Yes | Yes | ok | PASS | fix BOM desc text |
| L7 | SRP1265A-6R8M | Yes | SMD power ind | NONE | — | n/a | 6.8µH≠40µH | FAIL | value+FP |
| C126/127/128 | 47µF 16V X6S 1210 | Yes | 1210 | C_1210 | Yes | n/a | **16V « 24.35V** | FAIL | ≥63V |
| C133/134/136 | 2.2µF 100V X7T 0805 | Yes | 0805 | C_0805 | Yes | n/a | 100V vs 57V ok | PASS | input caps |
| C182 | 1µF (VREF cap) | — | 0402 | C_0402 | — | n/a | — | FAIL | missing BOM line |
| D7 | 1.5SMCxxA (→J28A) | Yes | SMC | D_SMC | Yes | n/a | 28V standoff ok | WARNING | finalize MPN |
| R159 | 20mΩ shunt (TBD) | Yes | 0805 | — | — | n/a | TBD | WARNING | size for load |

#### Symbol/footprint
| RefDes | MPN | DS package | Sym pin#s match | Footprint | Pad#s match | Pin-1/orient verified | Status |
|---|---|---|---|---|---|---|---|
| U40 | MIC28516 | 32-VQFN+EP | Yes | 32-PowerVQFN | Yes (33-pin incl EP) | n/v | PASS |
| U43 | MCP41U83 | TSSOP-14 | Medium | TSSOP-14_4.4x5 | n/v | n/v | WARNING |
| U44 | INA228 | VSSOP-10 DGS | Yes | VSSOP10_DGS_TEX | n/v | n/v | PASS |
| U42 | OPA320 | SOT-23-5 | Yes | SOT95P280X145-5N | n/v | n/v | PASS |
| U45 | MCP1502 | SOT-23-6 | Yes | SOT-23-6 | n/v | n/v | PASS |
| U41 | LMV393 | SOIC/VSSOP-8 | Yes | NONE | — | — | FAIL |
| L7 | SRP1265A | SMD | n/a | NONE | — | — | FAIL |
| Q15-20 | BC847/857W | SOT-323 | Yes | SOT-323_SC-70 | Yes | n/v | PASS |
| D11 | BAS16W | SOT-323 | Yes | SOT-323_SC-70 | Yes (pin2 NC) | n/v | PASS |

#### Layout-critical constraints
| Net/class | Current est | Width/impedance | Placement / return path | Evidence |
|---|---|---|---|---|
| VOUT_P→PVIN, SW, PGND (power loop) | up to ~3A pk (1.5A DC) | wide pour, minimize SW-node area | input caps C133/134/136 tight to PVIN/PGND; EP = primary thermal+GND; short hot loop | MIC28516 DS layout sec |
| L7 / VCC_RB | 1.5A nom | wide; keep SW–L–COUT compact | COUT bank (≥63V) close to load; INA228 Kelvin sense across R159 | DS; doc §2 |
| FB node (U40.27) | µA | short, shielded from SW | 5-way node (R147/R148/R134/C123/C125) kept tight; route away from SW; Cff C125 across R147 | doc §5 |
| R159 shunt sense | 1.5A | Kelvin (4-wire) to U44 IN+/IN− | symmetric short traces; matched | INA228 DS |
| VREF_4V096 | ~82µA string | quiet | C182 close to U45; keep off SW return | doc §6 |
| OV sense R138/R139 | µA | — | tap VCC_RB at cap bank; latch on +5V island | doc §4 |
| D7 TVS | surge | short, wide to connector + GND | at J6/clock connector, lowest-inductance to GND | doc §6 |
| Thermal | R162/R163 2.2Ω dissipate little; U40 EP main | — | EP vias to internal GND/plane; 57V→24V drop at 1.5A ≈ 50W throughput buck, manage U40 temp | DS |

#### Design-intent mismatches
| Ref | Doc says | Schematic says | Severity |
|---|---|---|---|
| U43 VDD | +5V | 3V3 | High |
| U45 nSHDN | always-on | gated by RB_PWR_EN | High |
| VREF cap | C115 2.2µF | C182 1µF (no BOM line) | Medium |
| L7 | 40µH | 6.8µH MPN, no FP | High |
| COUT | ≥63V | 16V | High |
| INA228 addr | 0x47 | 0x46 + bus swap | High |

### FE-5680A RS-232 interface (rb-io sheet)  —  _verdict: Needs corrections_

## FE-5680A RS-232 / Control Interface — Pre-Layout Review (`rb-io.kicad_sch`)

Net-level connectivity is clean and matches the canonical `rb_rs232_interface.md` design intent almost exactly: the SN65C3221E strapping, charge-pump/reservoir cap topology, dual-mode DPDT routing, the opto lock chain, and the DB9 ESD front end all wire as documented. The transceiver symbol pinout is datasheet-correct. The blockers are **layout-infrastructure**: several devices in this block have **no footprint assigned** (K1, L8, L9, D16) and there is **no `fp-lib-table` in the project**, so the custom-lib footprints (U46, U47) will not resolve in the PCB editor. A handful of doc/BOM accuracy items round out the list.

#### IC / active-device-by-IC

| RefDes | MPN | Function | Datasheet | Package | Symbol pinout verified | Footprint verified | Power/Gnd pins | Strap/EN/RST pins | Required passives | Layout-critical notes | Status | Conf |
|---|---|---|---|---|---|---|---|---|---|---|---|---|
| U46 | SN65C3221EPWR | 1-ch RS-232 xcvr, ±15kV IEC ESD | TI SN65C3221E | TSSOP-16 (PW) | YES — custom sym 1=EN̄,16=FORCEOFF̄,11=DIN,13=DOUT,8=RIN,9=ROUT,12=FORCEON,10=INVALID̄,3=V+,7=V−,15=VCC,14=GND,2/4=C1±,5/6=C2± = TI PW pinout | FP string `SN65C3221EPWR:SOP65P640X120-16N`; `.kicad_mod` exists as loose file but **no fp-lib-table** → nickname won't resolve | 15=VCC→+3V3 (C143 1µF+C145), 14=GND→GND | EN̄(1)→GND ✓, FORCEOFF̄(16)→RB_PWR_EN w/R164 100k pulldown ✓, FORCEON(12)→+3V3 ✓ (auto-pwrdn off), INVALID̄(10)=NC ✓ | C139/C140 0.1µF flying; C144 V−, C145 V+ (V+ reaches rail only via C145 ✓); **C143 1µF on VCC mandatory for PW IEC-ESD** ✓ | Keep flying/reservoir caps tight to pins; line pins (DOUT/RIN) toward connector | WARNING (FP lib unresolved) | High |
| U47 | PESD15VL2BT,215 | 2-line bidir ESD array, transceiver side | Nexperia PESD15VL2BT | SOT-23 (TO-236AB) | YES — pin1/2 = protected I/O, pin3 = GND | Sym FP=`SOT23_NXP` (custom); BOM FP=`TO-236AB`; **mismatch + no fp-lib-table** | pin3→GND ✓ | n/a | n/a | Place at transceiver-side line node; pin1=TX_P, pin2=RX_P | WARNING | High |
| U48 | APC-817C1-SL | Opto-isolated lock-status input | American Bright APC-817 | SOP-4 SMD (4-SMD) | YES — 1=Anode,2=Cathode,3=Emitter,4=Collector (DS confirmed) | FP string `4-SMD` is **not a valid lib:fp** | LED_C(2)→GND, E(3)→GND ✓ | n/a | R172 470Ω LED series, D17 BAT54J LED reverse catch (V_R=6V → required ✓), R173 22k pull-up, C148 10nF | Galvanic break — keep isolation gap under body; C(4)→RB_LOCK/PB13 | WARNING (FP) | High |
| K1 | G6K-2F-Y DC3 | DPDT RS-232/CMOS mode relay | Omron G6K | SMD DPDT | Symbol throws map to design (see netlist table) | **FOOTPRINT EMPTY** in both schematic and BOM | coil pin1→+3V3, pin8→Q21 C / D15 A | driven by Q21; D15 flyback | Q21 BC847W, R169 10k base pulldown, R170 470Ω base series, D15 BAT54J flyback | **3V coil on 3.3V rail = 110% rated** (91Ω→36mA, 120mW vs 100mW); verify coil temp at 85°C enclosure | FAIL (no FP) | High |
| Q21 | BC847W | Relay coil driver NPN | Infineon BC847 | SOT-323 | Generic NPN sym | `Package_TO_SOT_SMD:SOT-323_SC-70` ✓ | E(2)→GND ✓ | B(1)←R169/R170 | R169/R170 | Ic≈36mA ≪ 100mA max — OK | PASS | High |
| D12 | BAT54S | PE7/RB_TX rail clamp | Diodes ds11005 | SOT-23 | YES — A(1)→GND, K(2)→+3V3, COM(3)→RB_TX | `Package_TO_SOT_SMD:SOT-23` ✓ (desc text wrongly says SOT-323) | — | — | — | Clamp at the MCU pin; short to PE7 | PASS | High |
| D13,D14 | SMAJ15CA | Primary line TVS at DB9 | Littelfuse/Würth SMAJ | DO-214AC (SMA) | YES — A1(1)→GND, A2(2)→line | `DO-214AC` ✓ | A1→GND | — | — | At connector; 15V standoff passes ±5.4V RS-232 ✓ | PASS | High |
| D15 | BAT54J | Relay coil flyback | Nexperia BAT54J | SOD-323F | YES — K(1)→+3V3, A(2)→coil/Q21 C | `Diode_SMD:D_SOD-323F` ✓ | — | — | — | Across coil, cathode to rail ✓ | PASS | High |
| D16 | 3V3 Zener | Lock-input clamp | (unspecified MPN) | — | Generic D_Zener; A(2)→GND, K(1)→R171/R172 node | **FOOTPRINT EMPTY**; MPN unspecified (BOM `SELECT`) | — | — | — | Clamp node ≤~1.3mW worst case | FAIL (no FP/MPN) | High |
| D17 | BAT54J | Lock LED reverse protect | Nexperia BAT54J | SOD-323F | YES — A(2)→GND, K(1)→LED_A | `Diode_SMD:D_SOD-323F` ✓ | — | — | — | APC-817 V_R=6V confirmed → D17 mandatory ✓ | PASS | High |
| L8,L9 | 600Ω@100MHz (Fair-Rite 2508056017Y2) | Line EMI ferrite | Fair-Rite | 0805 | Generic L | **FOOTPRINT EMPTY** (BOM desc says 0805) | — | — | — | In line between connector-side and transceiver-side filter | FAIL (no FP) | High |

#### Netlist findings

| Net | Connected pins | Expected | Observed issue | Risk | Fix | Status |
|---|---|---|---|---|---|---|
| +3V3 | U46-15(VCC),U46-12(FORCEON),K1-1(coil),D12-2(K),D15-1(K),R173-1 | all on always-on 3V3 | none | — | — | PASS |
| GND | U46-1(EN̄),U46-14,U47-3,U48-2,U48-3,D12-1,D13/14-1,D16-2,D17-2,Q21-2,R169-1 | clean ground | none | — | — | PASS |
| RB_PWR_EN | U12-PB7(93), U46-16(FORCEOFF̄), R156, R160, R164(100k pulldown) | EN gates rail + xcvr; default-off | none — xcvr only powered with Rb rail (doc §7.4) ✓ | — | — | PASS |
| Net-(U46-V+) | C145-1, U46-3 only | V+ to rail only thru cap | correct (never shorted to VCC) | — | — | PASS |
| unconnected-(U46-INVALID-Pad10) | U46-10 only | NC | correctly flagged no_connect | — | — | PASS |
| DOUT | U46-13, K1-2 | Pole A:NC = RS-232 driver→FE | matches doc | — | — | PASS |
| ROUT | U46-9, K1-7 | Pole B:NC = receiver→MCU | matches doc | — | — | PASS |
| RB_RX | U12-PB4(90), U46-11(DIN), R167-2 | MCU TX→DIN + CMOS branch | matches doc | — | — | PASS |
| RB_TX | U12-PE7(38), K1-6(PoleB COM), D12-3(COM) | MCU RX, clamped, no series R | matches doc §5.3 | — | — | PASS |
| RB_RS232_RX_P | U47-2, K1-3(PoleA COM), R166-1, C142-1 | FE-input drive node | matches doc | — | — | PASS |
| RB_RS232_TX_P | U46-8(RIN), U47-1, R165-1, R168-2, C141-1 | FE-output receive node | matches doc | — | — | PASS |
| RB_RS232_CMOS_SW | U12-PE4(3), R170-1 | relay mode-select (PE4) | pin OK; **net name ≠ canonical `RB_SER_MODE`** (peripheral_map) | doc/code net drift | rename net `RB_RS232_CMOS_SW`→`RB_SER_MODE` OR fix peripheral_map | WARNING |
| RB_LOCK | U12-PB13(52), U48-4(C), R173-2, C148-1 | EXTI13 lock status | matches doc | — | — | PASS |
| RB_LOCK_IN | J6-3, R171-2 | FE J1-3 lock line | board connector is **J6** (doc text says "J1-3", FE-relative) | cosmetic | note J6 = board ref | PASS |
| RB_RS232_TX / _RX | J6-8 / J6-9 | FE J1-8 (out) / J1-9 (in) | DOUT→J1-9, RIN←J1-8 direction as doc §3 | — | bench-verify per unit | PASS |
| K1 coil | pin1→+3V3, pin8→Q21-C/D15-A | single 3V coil | OK; relay throws: 2=DOUT,3=RX_P(A-COM),4=R167(A-NO),5=R168(B-NO),6=RB_TX(B-COM),7=ROUT(B-NC) | confirm NC/NO vs Omron terminal map at FP assignment | confirm de-energized=RS-232 throws | WARNING |

#### BOM validation

| RefDes | MPN | DS found | Package | Footprint | Pkg-FP match | Pinout match | Rating match | Status | Notes |
|---|---|---|---|---|---|---|---|---|---|
| U46 | SN65C3221EPWR | Yes | TSSOP-16 | SOP65P640X120-16N (loose .kicad_mod) | YES | YES | 3.3V, 1Mb/s, ±15kV IEC | WARNING | no fp-lib-table nickname |
| U47 | PESD15VL2BT,215 | Yes | SOT-23 | TO-236AB (BOM) / SOT23_NXP (sym) | mismatch text | YES | 15V standoff, 44V clamp | WARNING | reconcile FP, add fp-lib-table |
| U48 | APC-817C1-SL | Yes | SOP-4 SMD | `4-SMD` (invalid lib:fp) | NO | YES | V_R=6V, VCEO=35V, CTR rank C1 | WARNING | assign real 4-pin SMD opto FP |
| K1 | G6K-2F-Y DC3 | Yes | DPDT SMD | EMPTY | NO | n/a | 3VDC/91Ω coil, 1A contacts | FAIL | assign G6K SMD FP |
| Q21 | BC847W | Yes | SOT-323 | SOT-323_SC-70 | YES | YES | 45V/100mA | PASS | — |
| D12 | BAT54S | Yes | SOT-23 | SOT-23 | YES | YES | 30V/200mA | PASS | desc text says SOT-323 (wrong) |
| D13,D14 | SMAJ15CA | Yes | DO-214AC | DO-214AC | YES | YES | 15Vwm/400W | PASS | — |
| D15,D17 | BAT54J | Yes | SOD-323F | SOD-323F | YES | YES | 30V/200mA | PASS | — |
| D16 | 3V3 zener | No (no MPN) | — | EMPTY | NO | n/a | 3.3V zener | FAIL | pick MPN (e.g. BZT52C3V3) + FP |
| L8,L9 | 2508056017Y2 | Yes | 0805 | EMPTY | NO | n/a | 600Ω@100MHz | FAIL | assign 0805 ferrite FP |
| R164–R173 | Panasonic ERJ-2RKF | Yes | 0402 | R_0402_1005Metric | YES | n/a | values match doc §9 | PASS | R171 spec 0.25W but 0402=1/10W (see risk) |
| C139–C148 | Murata | Yes | 0402/0603 | matches | YES | n/a | C141/142/146/147 are C0G ✓, C143=1µF | PASS | C141/2/6/7 still `SELECT` (no MPN) |

#### Symbol / footprint

| RefDes | DS package | Symbol pin#s match | Assigned footprint | Pad#s match | Pin-1/orient verified | Status |
|---|---|---|---|---|---|---|
| U46 | TSSOP-16 | YES (matches TI PW) | SOP65P640X120-16N | needs PCB check (16 pads) | unverified (no fp-lib-table to load) | WARNING |
| U47 | SOT-23 3-lead | YES | SOT23_NXP / TO-236AB | likely 1-2-3 | unverified | WARNING |
| U48 | SOP-4 | YES | `4-SMD` (placeholder) | unverified | unverified | WARNING |
| K1 | G6K SMD | symbol throws OK | none | n/a | n/a | FAIL |

#### Layout-critical constraints for this block

| Net/class | Current est | Width/impedance | Placement / return path | Evidence |
|---|---|---|---|---|
| Serial GND single bond (J6-5 → U46-14 → board GND) | signal | wide/short | **single galvanic bond** between Rb domain and board GND; keep Rb high-current return off this path | doc §6 |
| K1 coil drive (+3V3→K1→Q21) | ~36 mA | std | flyback D15 close to coil; coil at 110% rated → keep relay away from hot zones | Omron G6K DC3 91Ω; §5.5 |
| DB9 ESD front end (D13/D14, C146/147, R165/166, L8/9, U47, C141/142) | ESD/surge | — | TVS + shunts AT connector; ferrite between stages; secondary clamp at xcvr; 47pF C0G to preserve edges | doc §6 |
| RS-232 line pins (DOUT/RIN) | ≤1Mb/s | CL≤250pF @1Mb/s | route line pins toward DB9; keep cap+TVS junction C bounded | TI §7.8 |
| Opto isolation (U48) | DC | — | maintain creepage/clearance under body; lock line off the single-bond ground (opto = the break) | doc §6A |
| Charge-pump caps (C139/140/144/145) | — | short | tight to U46 C1±/C2±/V±; 1µF C143 at VCC for IEC-ESD | TI §7.3 |

#### Design-intent mismatches

| Ref | Doc says | Schematic says | Severity |
|---|---|---|---|
| RB_RS232_CMOS_SW (PE4) | peripheral_map: net `RB_SER_MODE`; subsystem doc: `RB_RS232_CMOS_SW` | net `RB_RS232_CMOS_SW` (PE4 ✓) | Medium (two docs disagree; schematic follows subsystem doc; pin correct) |
| U48 APC-817C1 CTR | doc §6A/§9: "C1 = 200–400%" | part = APC-817C1-SL | Medium — datasheet: **C1 = 200–260%**; 200–400% conflates C1+D1. 200% min still satisfies the design margin, but the doc figure is wrong. |
| Board connector | doc text "J1-3 / J1-8 / J1-9" (FE-relative) | board ref = **J6** | Low (cosmetic; FE-relative naming intended) |
| D12 description | "Dual schottky in series" | value BAT54S, FP SOT-23 | Low — desc field says SOT-323, FP is SOT-23 (BAT54S is SOT-23); cosmetic text |
| R171 power rating | doc §6A: spec 0.25W (91mW@24V) | BOM 0402 = 1/10W (0.1W) | Low/Medium — 0.1W barely covers 91mW worst case; doc explicitly wants 0.25W (0805/1206). Re-spec R171 body. |

### SPI peripherals (NOR flash, U62)  —  _verdict: Needs corrections_

## SPI Peripherals — NOR Flash (U62) — Pre-Layout Review

Scope: the SPI-NOR boot/log flash on `spi-peripherals.kicad_sch`. (The sheet also physically carries display/touch ESD/level-shift parts — PCA9306 U63, R210/R211, etc. — but those belong to the display/touch subsystem and are out of scope here except where they share the SPI4 bus.)

**Headline:** the part choice (Macronix MX25L25645GM2I-08G, 256 Mbit / 32 MB, 8-SOP 208mil, industrial) is correct and sourcing-compliant. But the NOR is **not layout-ready**: its symbol has an **unnumbered VCC pin** (so VCC is not mapped to a footprint pad) and **no footprint is assigned**. Decoupling on the VCC pad cannot be confirmed because the pad is unmapped. SPI bus topology, CS/RST/WP pull-ups, and rail are otherwise correct.

#### IC-by-IC

| RefDes | MPN | Function | Datasheet | Package | Symbol pinout verified | Footprint verified | Power/Gnd pins | Strap/EN/RST pins | Required passives | Layout-critical notes | Status | Confidence |
|---|---|---|---|---|---|---|---|---|---|---|---|---|
| U62 | MX25L25645GM2I-08G | 256 Mbit (32 MB) SPI NOR flash; MCUboot/secure-boot store, logs, web assets, FW staging | Macronix MX25L25645G 3V 256Mb Rev 2.0 (PM2075) | 8-SOP 208mil (SO8) | Pins 1–7 match JEDEC SO8 serial-NOR pinout; **VCC pin has NO pin number (must be pin 8)** | **No** — Footprint field empty | VCC=pin8 (unmapped!), GND=pin4 (OK, on GND) | nCS=pin1 (SPI_NSS/PE11), nRESET/SIO3=pin7 (NOR_RST_N/PE10, R205 pull-up), nWP/SIO2=pin3 (R207 pull-up, no MCU drive) | VCC decoupling 0.1 µF + bulk on pin8 (cannot confirm — pad unmapped); R205/R207/R212 pull-ups present | Place 100 nF within ~1–2 mm of pin8; keep SCK return tight | FAIL | High |

#### Netlist findings

| Net | Connected pins | Expected | Observed issue | Risk | Fix | Status |
|---|---|---|---|---|---|---|
| 3V3_STM (U62 VCC) | `U62 pin ""` (+ rail) | U62 VCC = pin 8 on 3V3_STM | VCC mapped to **empty pin number** (`pin ""`); KiCad cannot connect this to footprint pad 8 → VCC pad floats in layout/DRC | Part unpowered / no ERC-DRC catch → dead board | Edit symbol `ntp-server-stm32:MX25L25645GM2I-08G`: assign VCC pin number "8" | FAIL |
| SPI_NSS | U12 PE11(42), R212(pull-up→3V3_STM), U62 nCS(1) | NOR CS with idle-high pull-up | Correct. Hardware NSS PE11, pulled high so NOR deselected during MCU reset/Hi-Z | OK | None | PASS |
| SPI_SCK | U12 PE12(43), U62 SCLK(6), U43 SCK(3), R211(22 Ω series→display) | SPI4 clock shared NOR+digipot(+display via R211) | Multi-drop SCK (NOR + MCP41U83 digipot + display branch). Acceptable; CS-selected | Medium (stub/reflection at >50 MHz) | Keep NOR + digipot stubs short; series R at branch to display already present | PASS |
| SPI_MOSI | U12 PE14(45), U62 SI/SIO0(5), U43 SDI(4), R210(22 Ω series→display) | SPI4 MOSI shared | Correct multi-drop | Low | Same routing care as SCK | PASS |
| SPI_MISO | U12 PE13(44), U62 SO/SIO1(2), U43 SDO(2) | SPI4 MISO shared (NOR + digipot) | Correct; both are tri-state, CS-arbitrated | Low | None | PASS |
| NOR_RST_N | U12 PE10(41), R205(pull-up→3V3_STM), U62 nRESET/SIO3(7) | Firmware reset, default-high | Correct: actively driven + pulled high | OK | None | PASS |
| Net-(U62-nWP{slash}SIO2) | R207(pull-up→3V3_STM), U62 nWP/SIO2(3) | WP# tied high (write-protect disabled) | Functionally OK (single-SPI). Net is **auto-named** (`Net-(U62-…)`) — violates naming convention | Cosmetic/maintainability | Name net `NOR_WP_N` | WARNING |

#### BOM validation

| RefDes | MPN | Datasheet found | Package | Footprint | Pkg-FP match | Pinout match | Rating match | Status | Notes |
|---|---|---|---|---|---|---|---|---|---|
| U62 | MX25L25645GM2I-08G | Yes (Macronix Rev 2.0) | 8-SOP 208mil, industrial −40/+85 °C, VCC 2.7–3.6 V | **EMPTY** (BOM + netlist + schematic all blank) | N/A | Pins 1–7 yes; VCC pin# missing | 3.3 V rail in range; 256 Mb=32 MB ample for MCUboot/logs/assets | FAIL | BOM line marked `MPN-FROM-VALUE`; Datasheet/Footprint/Package fields blank — needs sourcing fields populated |
| R205 | ERJ-2RKF (per sheet style) | n/a (passive) | 0402 | R_0402_1005Metric | Yes | n/a | NOR_RST_N pull-up to 3V3_STM | PASS | Value not separately verified here; confirm 10k–100k |
| R207 | — | n/a | 0402 | R_0402_1005Metric | Yes | n/a | WP# pull-up to 3V3_STM | PASS | Confirm value |
| R212 | — | n/a | 0402 | R_0402_1005Metric | Yes | n/a | nCS pull-up to 3V3_STM | PASS | Confirm value |

#### Symbol / footprint

| RefDes | MPN | Datasheet package | Symbol pin#s match | Assigned footprint | Pad#s match | Pin-1/orientation verified | Status |
|---|---|---|---|---|---|---|---|
| U62 | MX25L25645GM2I-08G | 8-SOP 208mil | Pins 1–7 yes; **pin 8 (VCC) missing** | None | Cannot check (no FP) | Cannot check | FAIL |

No custom `.kicad_mod` exists for this part in `hardware/libraries/` — a footprint must be assigned (standard `SOIC-8_5.23x5.23mm` / SO8-208mil from KiCad's `Package_SO`, verified against datasheet body dims, is appropriate but must be confirmed).

#### Layout-critical constraints for this block

| Net/class | Current est | Width/impedance | Placement / return path | Evidence |
|---|---|---|---|---|
| 3V3_STM → U62 VCC | ≤ ~25–40 mA active read | Standard power trace; 100 nF MLCC at pin 8 | Decoupling cap on pin-8 side; short via to GND plane | Macronix DS recommends bypass at VCC |
| SPI4 SCK/MOSI/MISO | signal | ~50 Ω SE; ≤20–40 MHz NOR / display reconfig | Multi-drop bus: keep NOR + digipot (U43) stubs short; the 22 Ω series R210/R211 isolate the display branch only — NOR/digipot see the un-series-terminated trunk | sheet note "Place resistors where traces branch toward connector"; peripheral_map §5 |
| CS/RST | signal | standard | route with bus | — |

#### Design-intent mismatches

| Ref | Doc says | Schematic says | Severity |
|---|---|---|---|
| U62 footprint | Datasheet-verified parts, layout-ready | Footprint field empty everywhere | High |
| U62 VCC | Powered from always-on 3V3_STM | VCC pin has no pin number → not actually mappable to pad | High (blocker) |
| WP net name | Net names must match convention (`sts1000_net_naming.md`) | Auto-named `Net-(U62-nWP{slash}SIO2)` | Low |
| Recovery path (peripheral_map §, line "NOR on always-on 3V3_STM … recovery via NOR_RST_N only") | open item to confirm acceptable | As-built: NOR_RST_N (PE10) wired, no rail-cycle | Info — consistent; confirm MX25L25645G `RESET#` semantics are adequate (it is a hardware reset pin, OK) |

**Sources:** [Macronix MX25L25645G 3V 256Mb Rev 2.0 datasheet](https://www.macronix.com/Lists/Datasheet/Attachments/8906/MX25L25645G,%203V,%20256Mb,%20v2.0.pdf), [DigiKey MX25L25645GM2I-08G (8-SOP, 256Mbit, 120MHz)](https://www.digikey.com/en/products/detail/macronix/MX25L25645GM2I-08G/7914972), [Mouser MX25L25645GM2I-08G-TR](https://www.mouser.com/ProductDetail/Macronix/MX25L25645GM2I-08G-TR?qs=mELouGlnn3ePrySf7raZ7g%3D%3D).

### I2C peripherals + display power  —  _verdict: Needs corrections_

## I2C Peripherals + Display Power — Pre-Layout Review

**Scope note:** The named sheet is `i2c-peripherals.kicad_sch` (the `i2c-peripherals.kicad_sch` path you gave). The I²C housekeeping/sensor group (U57/U58 TMP117, U59 LIS2DH12, U60 ATECC608B, U61 IIS2MDC) lives in this sheet. The **display-power** parts in the FOCUS list (U33 RT9742, U32 INA228, U63 PCA9306) are actually on `3v3-main-power.kicad_sch` / `spi-peripherals.kicad_sch`, and the display ESD arrays U17/U18 (TPD4E05U06) on `connectors.kicad_sch`. I reviewed all of them via the netlist (`ntp-server-stm32.net`) since they form the display-power chain. **All I²C peripherals are on always-on `3V3_STM`** (confirmed in netlist), consistent with the 3V3_P-elimination decision in root `CLAUDE.md` but **contradicting the canonical doc `sts1000_3v3p_i2c_peripherals.md`, which still describes a gated 3V3_P / PERIPH_EN rail** (see Design-intent mismatches).

#### IC-by-IC

| RefDes | MPN | Function | Datasheet | Package | Sym pinout verified | FP verified | Power/Gnd | Strap/EN/RST | Required passives | Layout-critical | Status | Conf |
|---|---|---|---|---|---|---|---|---|---|---|---|---|
| U57 | TMP117xxDRV | Temp sensor (OCXO temp) | ti.com/lit/ds/symlink/tmp117.pdf | WSON-6-1EP 2x2 | Yes | Yes (WSON-6-1EP_2x2_P0.65 EP1x1.6) | V+ p5→3V3_STM; GND p2→GND | ADD0 p4→**3V3_STM(V+) ⇒ addr 0x49** | 1×0.1µF (C171) | EP→GND; place opposite OCXO, thermal coupling pour | PASS | High |
| U58 | TMP117xxDRV | Temp sensor (ambient) | same | WSON-6-1EP 2x2 | Yes | Yes | V+ p5→3V3_STM; GND p2→GND | ADD0 p4→**GND ⇒ addr 0x48** | 1×0.1µF (C172) | EP→GND | PASS | High |
| U59 | LIS2DH12TR | Accelerometer (e-compass) | st.com/.../lis2dh12.pdf | LGA-12 2x2x1 | Yes | Yes (LGA-12_STM, 12 pads, no EP) | VDD p9 + VDD_IO p10 →3V3_STM; GND p6/7/8→GND | CS p2→3V3_STM (I²C); **SA0 p3→3V3_STM ⇒ 0x19** (committed); RES p5→GND | 0.1µF on VDD & VDD_IO | INT1/INT2 (p11/12) NC | PASS | High |
| U60 | ATECC608B-SSHDA | Secure element | DS40002239B | SOIC-8 | Yes | Yes (SOIC-8_3.9x4.9 P1.27) | VCC p8→3V3_STM; GND p4→GND | none (addr in config zone, 0x60 default) | 1×0.1µF (C175) | pins 1/2/3/7 NC | PASS | High |
| U61 | IIS2MDCTR | Magnetometer (e-compass) | st.com/.../iis2mdc.pdf; AN5080 | LGA-12 2x2x0.7 | Yes | Yes (LGA-12_2X2X0P7_STM, 12 pads) | VDD p9 + VDD_IO p10→3V3_STM; GND p6/8→GND | CS p3→3V3_STM (I²C); addr 0x1E fixed | C1 p5 cap; 0.1µF VDD/VDD_IO; **+10µF bulk (AN5080)** | INT/DRDY p7 NC; current-free GND pour keep-out | WARNING | High |
| U32 | INA228AQDGSRQ1 | Current/V monitor 5V_DISP (#7, 0x42) | ti.com/.../ina228.pdf | VSSOP-10 DGS | Yes | Yes (VSSOP10_DGS_TEX) | VS p6→3V3; GND p1/7→GND | A0 p2→I2C_SCL, A1 p1→GND ⇒ 0x42 (verify combo) | R107 0.1Ω shunt; 0.1µF | shunt Kelvin; ADCRANGE=1 for 0.1Ω (confirm in FW) | WARNING | Medium |
| U33 | RT9742VGJ5 | Display load switch (5V_DISP) | richtek DS9742-10 | TSOT-23-5 | Yes | Yes (TSOT-23-5) | VIN p5→5V; GND p2→GND | EN p4→DISP_EN (active-high, R104 10k pull-down=default OFF, OK) | Cin/Cout; **FLG pull-UP** | inrush vs ILIM + 0.1Ω shunt headroom | FAIL | High |
| U63 | PCA9306DCTT | I²C level shifter 3V3↔5V_DISP | ti.com/.../pca9306.pdf; nxp PCA9306 | SOT-8 DCT | Yes (1GND,2VREF1,3SCL1,4SDA1,5SDA2,6SCL2,7VREF2,8EN) | Yes (DCT8) | VREF1 p2→3V3_STM; VREF2 p7→5V_DISP; GND p1 | EN p8→DISP_EN | **pull-ups required BOTH sides**; EN pull-up to VREF2 | FAIL | High |
| U17 | TPD4E05U06DQAR | ESD array, display I²C+touch | ti.com/.../tpd4e05u06.pdf | USON-10 DQA | Symbol mislabels pins 6/7/9/10 "NC" (actually flow-through ch pads) | Yes (DQA0010A, 10 pads) | GND p3/8→GND | n/a | n/a (ESD only) | place at display connector J4 | WARNING | Medium |
| U18 | TPD4E05U06DQAR | ESD array (USB on connectors sheet) | same | USON-10 DQA | same | Yes | GND p3/8→GND | n/a | n/a | at USB connector | WARNING | Medium |

#### Netlist findings

| Net | Connected pins | Expected | Observed issue | Risk | Fix | Status |
|---|---|---|---|---|---|---|
| V_DISP_EN_FAULT | U33.3/nFLG (open-drain, active-low), R105.2, U55.26/GPB1; R105.1→GND | open-drain FLG with **pull-UP** to 3V3_STM | **R105 (10k) is a pull-DOWN to GND** on an open-drain fault output → line sits LOW always; fault vs no-fault indistinguishable; GPB1 reads asserted permanently | High — display fault telemetry dead | Re-tie R105 to 3V3_STM (pull-up). MCP23017 input is 3V3_STM, FLG sinks to GND — pull-up correct | FAIL |
| I2C_DISP_SCL / I2C_DISP_SDA | U63.6/SCL2, U63.5/SDA2, U17.1/2 (+10/9), J4.10/12 | each high-side line pulled up to 5V_DISP (VREF2) | **No pull-up resistors on the 5V_DISP (high) side** of PCA9306. PCA9306 only has a weak internal device; both sides need real pull-ups | High — display I²C/touch bus won't pull high reliably unless module provides them | Add 2× pull-ups (e.g. 2.2–4.7k) to 5V_DISP on SCL2/SDA2, OR confirm the LCDwiki module populates touch-bus pull-ups (verify per module) | FAIL |
| DISP_EN→U63.8/EN | R104, U12.79/PC11, U33.4, U63.8 | PCA9306 EN ≥ VREF1+1V for best translation (datasheet) | EN driven by 3V3 push-pull GPIO; VREF1=3V3 ⇒ EN(high)=VREF1, **not ≥1V above**; also EN ideally pulled to VREF2 (5V) through R | Medium — translator may operate at reduced margin/turn-on threshold | Pull EN to VREF2 (5V_DISP) via ~200k and let GPIO sink, or accept TI note that EN=VREF1 still functions (verify Vih); document | WARNING |
| Net-(U61-C1) | C176 (220nF), U61.5/C1 | **100 nF** on C1 per IIS2MDC datasheet/AN5080 | C176 is **220 nF**, not the specified 100 nF | Low — value deviation; charge-pump reservoir; likely tolerant but not per datasheet | Change C176 to 100 nF (X7R/X5R) and place tight to pins 5/6 | WARNING |
| U61 VDD (p9) | C177/C178 0.1µF only on 3V3_STM | 100 nF + **10 µF** bulk near pin 9 (AN5080) | No dedicated 10 µF bulk at IIS2MDC supply | Low — rail bulk exists elsewhere, but app note calls it out for the mag charge pump | Add 10 µF near U61 pin 9 | WARNING |
| U59 INT1/INT2 (p11/p12) | unconnected | NC acceptable (e-compass static, polled) | Both accel interrupts unused | Low — fine for fixed install; no wake from accel | Confirm FW polls; OK to leave NC | PASS |
| U61 INT/DRDY (p7) | unconnected | NC acceptable (mag polled) | DRDY unused | Low | OK | PASS |
| U57/U58 ALERT (p3) | unconnected (open-collector) | NC OK if temp ALERT unused | TMP117 ALERT not wired | Low — temp thresholds polled in FW | Confirm intentional | PASS |
| U60 ATECC608B p1/2/3/7 | NC | NC per datasheet | correct | — | none | PASS |

#### BOM validation

| RefDes | MPN | DS found | Package | Footprint | Pkg-FP match | Pinout match | Rating match | Status | Notes |
|---|---|---|---|---|---|---|---|---|---|
| U57/U58 | TMP117xxDRV | Yes | WSON-6 | WSON-6-1EP_2x2_P0.65 | Yes | Yes | ±0.3°C, -55/+150°C | PASS | EP→GND |
| U59 | LIS2DH12TR | Yes | LGA-12 2x2x1 | LGA-12_STM | Yes | Yes | -40/+85°C consumer | PASS | verify enclosure temp (doc open item) |
| U60 | ATECC608B-SSHDA | Yes | SOIC-8 | SOIC-8_3.9x4.9 | Yes | Yes | -40/+85°C | PASS | I²C variant |
| U61 | IIS2MDCTR | Yes | LGA-12 2x2x0.7 | LGA-12_2X2X0P7_STM | Yes | Yes | -40/+85°C industrial | PASS | C1=220nF should be 100nF |
| U32 | INA228AQDGSRQ1 | Yes | VSSOP-10 | VSSOP10_DGS_TEX | Yes | Yes | AEC-Q100 | PASS | confirm shunt/ADCRANGE |
| U33 | RT9742VGJ5 | Yes | TSOT-23-5 | TSOT-23-5 | Yes | Yes | "V" suffix = one of 0.5–3A ILIM tiers — **confirm exact ILIM** | WARNING | ILIM tier vs backlight inrush |
| U63 | PCA9306DCTT | Yes | SOT-8 (DCT) | DCT8 | Yes | Yes | — | PASS | needs both-side pull-ups |
| U17/U18 | TPD4E05U06DQAR | Yes | USON-10 DQA | DQA0010A | Yes | flow-through (symbol "NC" labels misleading) | 0.5pF, 5.5V, ±12kV | WARNING | symbol pin-name fix |
| C176 | 220nF | n/a | 0402 | C_0402 | — | — | — | WARNING | should be 100nF (IIS2MDC C1) |
| R105 | 10k | n/a | 0402 | R_0402 | — | — | — | FAIL | wrong polarity (pull-down on OD FLG) |
| R202/R203 | 4.7k | n/a | 0402 | R_0402 | — | — | — | PASS | I²C1 main pull-ups to 3V3_STM |

#### Symbol / footprint

| RefDes | MPN | DS package | Symbol pin#s match | Footprint | Pad#s match | Pin-1/orient verified | Status |
|---|---|---|---|---|---|---|---|
| U59 | LIS2DH12TR | LGA-12 | Yes | LGA-12_STM | 12 pads, no EP | Verify pad-1 corner vs ST drawing | PASS (verify pin-1 mark at layout) |
| U61 | IIS2MDCTR | LGA-12 2x2x0.7 | Yes | LGA-12_2X2X0P7_STM | 12 pads | Verify pad-1 corner | PASS |
| U17/U18 | TPD4E05U06 | USON-10 DQA | I/O on flow-through pairs (1&10,2&9,4&7,5&6; GND 3&8) — symbol labels 6/7/9/10 "NC" | DQA0010A | 10 pads | Yes | WARNING (mislabel only; nets correct) |
| U63 | PCA9306 | SOT-8 DCT | Yes | DCT8 | 8 | Yes | PASS |
| U32 | INA228 | VSSOP-10 | Yes | VSSOP10_DGS_TEX | 10 | Yes | PASS |

#### Layout-critical constraints for this block

| Net/class | Current est | Width/impedance | Placement/return-path | Evidence |
|---|---|---|---|---|
| IIS2MDC sense region | n/a (field-sensitive) | — | **Continuous current-free GND pour under U61**; no plane split/neck routing current under footprint; keep ≥mm from buck/relay/OCXO/Rb/PoE magnetics; balanced go+return power pairs (1/r²) | doc §5; sheet text notes "Keep higher power traces 5mm+ away / no routing under / away from magnetics & PSU" |
| IIS2MDC C1 (C176) | high-current pulses | short/wide | Place C176 immediately at pins 5/6 (AN5080: very high current pulses, minimize inductance) | AN5080 |
| TMP117 U57 (OCXO temp) | n/a | — | Place opposite side of PCB from OCXO; thermal-couple via GND fill (sheet text) | sheet text |
| 5V_DISP shunt R107 (0.1Ω) | ~0.3–0.6A backlight | Kelvin sense to U32 IN+/IN− | INA228 Kelvin; R107 between RT9742 OUT and FB7; VBUS tied to IN− | netlist |
| Display I²C (post-shifter) | low | — | ESD arrays U17 at J4 connector; keep touch INT short | netlist |

#### Design-intent mismatches

| Ref | Doc says | Schematic says | Severity |
|---|---|---|---|
| Rail of all I²C peripherals | `sts1000_3v3p_i2c_peripherals.md` §1/§2/§6: TMP117/ATECC/e-compass on gated **3V3_P (PERIPH_EN=PC11)**; back-power resolution via PCA9517/TCA4311 buffer | All on always-on **3V3_STM**; no PERIPH_EN gating; no segmenting buffer | High (doc stale; CLAUDE.md confirms 3V3_P eliminated — update the doc) |
| TMP117 #1/#2 address↔strap | §1: #1=0x48 ADD0→GND, #2=0x49 ADD0→V+ | U58 ADD0→GND=0x48, U57 ADD0→V+=0x49 (designator assignment differs but addresses match) | Low (no collision; confirm which physical sensor is osc-temp) |
| LIS2DH12 SA0 | §0/§8 open item "commit 0x18 vs 0x19" | Committed: SA0→3V3_STM ⇒ **0x19** | Resolved — close the doc open item |
| PIR / proximity wake | doc §3 lengthy PaPIRs PIR on U55 GPB2–7 | Not in this sheet (verify on fault-aggregation sheet) | Info — out of this sheet's scope |
| IIS2MDC C1 cap | §4: 100nF on Vdd/Vdd_IO + 10µF bulk | C176=220nF on C1; no 10µF bulk at U61 | Medium |

### Fault/UI aggregation (MCP23017 ×2: U55 @0x20, U54 @0x21)  —  _verdict: Needs corrections_

## Fault/UI Aggregation Review — MCP23017 ×2 (U55 @0x20, U54 @0x21)

Sheet: `hardware/ntp-server-stm32/i2c-gpio.kicad_sch`. Netlist-verified against `ntp-server-stm32.net`. Canonical doc: `docs/sts1000_fault_aggregation.md`.

**Headline:** Wiring, addressing, single-pull-up-per-INT, reset topology, I²C pin orientation, and rail (3V3_STM) are all correct and match the doc. The legacy-R44 concern is **resolved** (R44 is an Ethernet PHY term, not on INA_ALERT_INT_N). **One hard defect:** three input signals are mapped onto the MCP23017 GPA7/GPB7 pins, which Microchip's own datasheet (Rev D, June 2022) and the article cited in this part's own symbol description say **must not be used as inputs** — an input edge during an I²C read can corrupt SDA and hang the shared housekeeping bus.

#### IC-by-IC

| RefDes | MPN | Function | Datasheet | Package | Symbol pinout verified | Footprint verified | Power/Gnd pins | Strap/EN/RST pins | Required passives | Layout-critical notes | Status | Confidence |
|---|---|---|---|---|---|---|---|---|---|---|---|---|
| U55 | MCP23017T-E/ML | 16-bit I²C GPIO expander — 8×PG + 2×EN-fault → `PG_INT_N` | DS20001952 (Rev D, 2022) | QFN-28 6×6mm 0.65mm, 1EP | Yes (28 pins + EP match) | WARNING — KiCad lib `QFN-28-1EP_6x6mm_P0.65mm_EP4.25x4.25mm`; EP nominal in datasheet C-rev drawing ~4.45mm, verify exact EP for ML variant | VDD(5)=3V3_STM, VSS(6)=GND, EP(29)=GND | A0/A1/A2(11/12/13)=GND→0x20; RESET(14)=EXP_RST_N | C168 0.1µF (3V3_STM); R200 10k pull-up on PG_INT_N; R198 10k pull-down on EXP_RST_N | INTA(16)+INTB(15) tied → single open-drain INT; MIRROR=1 in FW; GPA7=POE_PG is on a restricted pin (see findings) | FAIL | High |
| U54 | MCP23017T-E/ML | 16-bit I²C GPIO expander — 8 buttons+touch → `BTN_INT_N`; 8 INA228 ALERT → `INA_ALERT_INT_N` | DS20001952 (Rev D, 2022) | QFN-28 6×6mm 0.65mm, 1EP | Yes (28 pins + EP match) | WARNING — same EP caveat as U55 | VDD(5)=3V3_STM, VSS(6)=GND, EP(29)=GND | A0(11)=3V3_STM, A1/A2(12/13)=GND→0x21; RESET(14)=EXP_RST_N | C169 0.1µF (3V3_STM); R201 10k on BTN_INT_N; R199 10k on INA_ALERT_INT_N | INTA(16)/INTB(15) separate (MIRROR=0); GPA7=DISP_TOUCH_INT and GPB7=INA_ALERT_VCC_RB are inputs on restricted pins | FAIL | High |

#### Netlist findings

| Net | Connected pins | Expected | Observed issue | Risk | Fix | Status |
|---|---|---|---|---|---|---|
| INA_ALERT_INT_N | R199.2, U12 PC12(80), U54 INTB(15) | One pull-up + MCU EXTI + INTB | None — R44 is **not** here (R44 = 3V3_LAN↔TRD0_N PHY term). Single 10k pull-up. | None | None — close the "drop R44" open item; note is satisfied | PASS |
| PG_INT_N | R200.2, U12 PA10(69), U55 INTA(16)+INTB(15) | One pull-up + MCU EXTI + tied INTA/INTB | INTA+INTB both open-drain wire-OR onto one net; correct with IOCON.ODR=1 + MIRROR=1 | None (ODR=1 mandatory; push-pull would contend) | Ensure FW sets ODR=1 before INT enable | PASS |
| BTN_INT_N | R201.2, U12 PE0(97), U54 INTA(16) | One pull-up + MCU EXTI + INTA | None | None | None | PASS |
| EXP_RST_N | R198.1, U12 PC0(15), U54 RESET(14), U55 RESET(14) | Shared reset, pull-down default-asserted | Correct: R198 10k pull-down holds both in reset until PC0 driven high | RESET is active-low; held low at POR = both expanders reset until FW — intended | None | PASS |
| I2C_SCL | U54 SCK(8), U55 SCK(8), +19 bus nodes | SCL on pin 8 | Correct (pin 8 = SCL on MCP23017) | None | None | PASS |
| I2C_SDA | U54 SDA(9), U55 SDA(9), +19 bus nodes | SDA on pin 9 | Correct | None | None | PASS |
| (U54 GPA7 pin24) DISP_TOUCH_INT | U54.24, source touch INT | Input | **GPA7 is output-only per Microchip (input edge can corrupt SDA)** | HIGH — bus hang on shared housekeeping I²C; loses all monitoring | Move DISP_TOUCH_INT to a GPA0–6/GPB0–6 pin or an MCU EXTI; rebalance bits | FAIL |
| (U54 GPB7 pin4) INA_ALERT_VCC_RB | U54.4, INA228 #6 ALERT | Input | **GPB7 output-only — same hazard** | HIGH — Rb-rail ALERT can hang bus | Reassign to a non-7 bit | FAIL |
| (U55 GPA7 pin24) POE_PG | U55.24, PoE PG | Input | **GPA7 output-only — same hazard** | HIGH | Reassign to a free U55 GPB bit (GPB2–7 spare) | FAIL |
| NC pins 7,10 (both) | unconnected | NC | Correctly left unconnected (symbol marks hidden NC) | None | None | PASS |
| U55 GPB2–7 (pins 27,28,3,4 …) | unconnected | 6 spare | Spare inputs floating — acceptable for unused expander inputs but set IODIR=out or GPPU on; floating CMOS inputs raise Icc | Low | Enable internal pull-ups (GPPU) or config as outputs in FW | WARNING |

#### BOM validation

| RefDes | MPN | Datasheet found | Package | Footprint | Pkg-FP match | Pinout match | Rating match | Status | Notes |
|---|---|---|---|---|---|---|---|---|---|
| U54/U55 | MCP23017T-E/ML | Yes (DS20001952) | QFN-28 6×6 0.65mm 1EP | QFN-28-1EP_6x6mm_P0.65mm_EP4.25x4.25mm | Yes (body/pitch) | Yes | E-grade −40/+125 °C (exceeds −40/+85 enclosure) | WARNING | Verify EP land size vs datasheet drawing; T = tape&reel, /ML = QFN — correct. 1.8–5.5 V VDD covers 3V3. |
| R198 | 10k 0402 (ERJ-2RKF1002X) | Yes | 0402 | R_0402_1005Metric | Yes | n/a | 1/10W | PASS | EXP_RST_N pull-down — correct default-reset behavior |
| R199 | 10k 0402 | Yes | 0402 | R_0402 | Yes | n/a | — | PASS | Sole INA_ALERT_INT_N pull-up |
| R200 | 10k 0402 | Yes | 0402 | R_0402 | Yes | n/a | — | PASS | Sole PG_INT_N pull-up |
| R201 | 10k 0402 | Yes | 0402 | R_0402 | Yes | n/a | — | PASS | Sole BTN_INT_N pull-up |
| C168/C169 | 0.1µF 16V X7R 0402 (GRM155R71C104KA88J) | Yes | 0402 | C_0402 | Yes | n/a | 16V/X7R OK on 3.3V | PASS | One decoupler per expander VDD — adequate; consider adding bulk if needed |

> Note: R44 (3V3_LAN / TRD0_N) is **out of scope** for this block; verified only to confirm it is not on INA_ALERT_INT_N.

#### Symbol / footprint

| RefDes | MPN | Datasheet package | Symbol pin#s match | Assigned footprint | Pad#s match | Pin-1/orientation verified | Status |
|---|---|---|---|---|---|---|---|
| U54/U55 | MCP23017T-E/ML | QFN-28 6×6 0.65mm 1EP | Yes — GPB4-7(1-4), VDD(5), VSS(6), NC(7,10), SCK(8), SDA(9), A0-2(11-13), RESET(14), INTB(15), INTA(16), GPA0-7(17-24), GPB0-3(25-28), EP(29) | QFN-28-1EP_6x6mm_P0.65mm_EP4.25x4.25mm (KiCad std lib, not custom) | 29 (28+EP) | Verify pin-1 corner at layout (std lib OK) | WARNING (EP size confirm) |

#### Layout-critical constraints for this block

| Net/class | Current est | Width/impedance | Placement / return path | Evidence |
|---|---|---|---|---|
| VDD (C168/C169 decouple) | ~1 mA static, µA-class GPIO | standard | C168/C169 ≤2 mm from each VDD(5)/VSS(6); EP(29) to GND with via array | DS20001952 thermal/EP guidance |
| I²C_SCL/SDA (shared bus) | signaling | controlled length, Cb ≤ 400 kHz budget | ~21 nodes on bus behind LTC4311/PCA9517 — keep stub to U54/U55 short; this block adds 2 loads | net census above; doc §9 |
| INT lines (3× open-drain, _N) | µA | standard | route PG_INT_N/BTN_INT_N/INA_ALERT_INT_N to PA10/PE0/PC12; keep pull-ups (R198/R200/R201/R199) near MCU or expander, not split | netlist |
| EXP_RST_N | µA | standard | R198 pull-down near expanders for reliable POR-hold | netlist |
| EP thermal | low | — | EP→GND plane; not a hot part | — |

#### Design-intent mismatches

| Ref | Doc says | Schematic says | Severity |
|---|---|---|---|
| U54 GPA7 / GPB7, U55 GPA7 | Doc §1 maps DISP_TOUCH_INT (U54 GPA7), INA_ALERT_VCC_RB (U54 GPB7), POE_PG (U55 GPA7) as inputs; doc does **not** flag the GPA7/GPB7 input restriction anywhere | Same mapping (inputs on bit-7 pins) — violates Microchip restriction the symbol itself cites | HIGH |
| R44 / INA_ALERT_INT_N | Doc §10 open item: "Drop R44 at PC12 (or R199)…both = 5k" | R44 not on this net (it is 3V3_LAN/TRD0_N PHY term); only R199 present | Low (doc/open-item stale — close it) |
| U55 GPB2–7 spare | Doc §1: "GPB2–7 NC (6 spare)" | Unconnected (floating) | Low (set GPPU/IODIR in FW) |

### I2C1 bus + rise-time accelerator (U56 LTC4311)  —  _verdict: Ready (pre-layout) with open verifications_

## I2C1 Bus + Rise-Time Accelerator — Pre-Layout Review

Sheet: `hardware/ntp-server-stm32/i2c-buffer.kicad_sch`. Components on sheet: **U56** LTC4311ISC6-TRPBF (I2C active pull-up / rise-time accelerator), **R202/R203** 4.7k bus pull-ups, **C170** 0.1uF U56 decoupling. This sheet also instantiates the single global I2C1 bus (`I2C_SCL`=PB8/U12 pin95, `I2C_SDA`=PB9/U12 pin96) — note the net *labels* are `I2C_SCL`/`I2C_SDA` not the canonical `I2C1_SCL`/`I2C1_SDA`; see doc-mismatch table.

**Headline:** U56 is wired correctly — pinout, footprint, EN strap, and pull-up rail all verified. The accelerator does NOT isolate (confirmed: it is a 2-channel active pull-up on the *same* bus, exactly as CLAUDE.md states), so the back-powering concern is moot here because R202/R203 and U56 are all on always-on `3V3_STM`. The real open items are bus-loading budget (C_bus vs LTC4311 capability, single 4.7k pair for ~13 devices across the whole board) and minor net-naming drift.

#### IC-by-IC
| RefDes | MPN | Function | Datasheet | Package | Symbol pinout verified | Footprint verified | Power/Gnd pins | Strap/EN/RST pins | Required passives | Layout-critical notes | Status | Confidence |
|---|---|---|---|---|---|---|---|---|---|---|---|---|
| U56 | LTC4311ISC6-TRPBF | Dual I2C/SMBus active pull-up (rise-time accelerator), 1.6–5.5 V | analog.com 4311fa | SC70-6 (SC6) | YES — pin1 VCC, pin2 GND, pin3 ENABLE, pin4 BUS2, pin5 GND, pin6 BUS1 (matches lib sym & datasheet pin config) | YES — `SOT-6_SC_LIT.kicad_mod`, 6 pads 0.65 mm pitch, ~1.35×1.35 mm courtyard = SC70-6 | VCC=pin1→3V3_STM; GND=pin2 & pin5→GND (both grounded ✓) | ENABLE=pin3→3V3_STM (tied to VCC = always enabled, active-high) ✓ | C170 0.1uF VCC bypass; relies on R202/R203 as static pull-ups it augments | Place U56 + C170 close together; place U56 near the *electrical midpoint / far end* of the long multi-sheet I2C bus so it accelerates the highest-C node, not at the MCU. Keep BUS1/BUS2 stubs short. | PASS | High |

#### Netlist findings
| Net | Connected pins | Expected | Observed issue | Risk | Fix | Status |
|---|---|---|---|---|---|---|
| 3V3_STM | U56.1 (VCC), U56.3 (ENABLE), R202.1, R203.1, C170.1, U12 VDD ×5, all housekeeping VCCs | VCC+EN on always-on rail; pull-ups on always-on rail | None — correct. EN=VCC ✓, pull-ups on always-on rail ✓ (avoids ESD back-powering of gated devices) | — | — | PASS |
| I2C_SCL (BUS1) | U56.6, R202.2, U12.95 (PB8), + U10/U23/U26/U30/U31/U32/U37/U44/U54/U55/U57/U58/U59/U60/U61/U63 | One static pull-up + accelerator + all device SCL | ~16 device loads + long multi-sheet routing on ONE pull-up (4.7k). High C_bus is the *reason* U56 exists, but C_bus is not yet budgeted | Med — if total C_bus exceeds LTC4311 range or rise time still fails at 400 kHz, bus marginal | Budget C_bus (sum of all device pin C + trace C); confirm ≤ LTC4311 supported load at target SCL; keep 4.7k (good static value, ~0.7 mA sink @3.3 V) | WARNING (open verification) |
| I2C_SDA (BUS2) | U56.4, R203.2, U12.96 (PB9), + same device set SDA | Same as SCL | Same as above | Med | Same as SCL | WARNING (open verification) |
| GND | U56.2, U56.5 | Both GND pins grounded | None | — | — | PASS |

Note: BUS1↔SCL and BUS2↔SDA assignment is electrically irrelevant (the two channels are identical, independent active pull-ups); current mapping (pin6 BUS1→SCL, pin4 BUS2→SDA) is correct and consistent.

#### BOM validation
| RefDes | MPN | Datasheet found | Package | Footprint | Pkg-FP match | Pinout match | Rating match | Status | Notes |
|---|---|---|---|---|---|---|---|---|---|
| U56 | LTC4311ISC6-TRPBF | YES (4311fa) | SC70-6 | SOT-6_SC_LIT | YES | YES | VCC abs-max 5.5 V ≫ 3.3 V rail ✓; 1.6–5.5 V op ✓ | PASS | BOM "Footprint" column blank for U56 (line 525); footprint lives in symbol property only — populate CSV for completeness |
| R202 | ERJ-2RKF4701X (4.7k) | YES (Panasonic) | 0402 | R_0402_1005Metric | YES | N/A | 1/10 W, 1% ✓ | PASS | Sole SCL pull-up |
| R203 | ERJ-2RKF4701X (4.7k) | YES | 0402 | R_0402_1005Metric | YES | N/A | ✓ | PASS | Sole SDA pull-up |
| C170 | GRM155R71C104KA88J (0.1uF X7R 16V) | YES (Murata) | 0402 | C_0402_1005Metric | YES | N/A | 16 V ≫ 3.3 V ✓ | PASS | U56 decoupling; X7R fine here (not an OCXO Vc cap) |

#### Symbol/footprint
| RefDes | MPN | Datasheet package | Symbol pin#s match | Assigned footprint | Pad#s match | Pin-1/orientation verified | Status |
|---|---|---|---|---|---|---|---|
| U56 | LTC4311ISC6-TRPBF | SC70-6 | YES (1–6, names per datasheet) | SOT-6_SC_LIT.kicad_mod | YES (pads 1–6, CCW: 1/2/3 left, 6/5/4 right) | Pin-1 marker present (F.Fab arc + silk "*"), pin1 = top-left ✓ | PASS |

#### Layout-critical constraints for this block
| Net/class | Current est | Width/impedance | Placement / return path | Evidence |
|---|---|---|---|---|
| I2C_SCL / I2C_SDA | DC sink ≤ ~0.7 mA static (3.3 V/4.7k) + dynamic accel pulses from U56 | Standard signal width; not impedance-controlled, but minimize total capacitance (short, narrow, avoid long parallel runs over plane gaps) | Place U56 near the high-capacitance end of the bus, not at the MCU. Keep U56 BUS stubs short; keep C170 adjacent to U56 pin1/pin2. Continuous GND reference under the long bus | LTC4311 4311fa (active pull-up monitors edge rate); CLAUDE.md "LTC4311 does not isolate" |
| 3V3_STM (U56 VCC) | µA-class | local 0.1uF | C170 close-coupled to U56 | datasheet bypass guidance |

#### Design-intent mismatches
| Ref | Doc says | Schematic says | Severity |
|---|---|---|---|
| I2C net names | peripheral_map / naming doc reference `I2C1` (PB8/PB9 = I2C1) | Global labels are `I2C_SCL` / `I2C_SDA` (no `1`) | Low — consistent across all sheets, but drifts from canonical "I2C1_*"; confirm intended naming |
| U56 BOM Footprint field | BOM rules want explicit footprint per line | Line 525 U56 Footprint column empty (also Pkg/Pinout flags blank, status `MPN-FROM-VALUE`) | Low — populate before release |

### Connectors, USB-C console, panel UI, display IF (connectors.kicad_sch)  —  _verdict: Needs corrections_

## Pre-Layout Review — Connectors / USB Console / Panel UI / Display IF

Sheet: `hardware/ntp-server-stm32/connectors.kicad_sch`. All connectivity confirmed against `ntp-server-stm32.net`; symbols/footprints against `hardware/libraries/`; specs against vendor datasheets.

**Net-connectivity is largely clean.** The remaining gating items for layout hand-off are (a) missing/incorrect footprints on connectors, the 10 MHz ESD diodes, and a test point; (b) an unresolved TVS value on VCC_RB; (c) a display-flex pin-11 LCD-RST-vs-CTP-RST question; plus doc/schematic deltas.

#### IC / active-device-by-IC

| RefDes | MPN | Function | Datasheet | Package | Sym pinout verified | FP verified | Pwr/Gnd | Strap/EN/RST | Required passives | Layout-critical | Status | Conf |
|---|---|---|---|---|---|---|---|---|---|---|---|---|
| U18 | TPD4E05U06DQAR | Flow-through ESD: USB D+ (1/10), D− (2/9), VBUS (4/7); ch4 (5/6) open | TI tpd4e05u06 | USON-10 DQA (2.5×1.0) | Yes (1=D1+,2=D1−,3/8=GND,4=D2+,5=D2−,6/7/9/10 flow-thru) | DQA0010A 10-pad, pin-1 mark OK | 3,8→GND | none | none | Must physically flow-through, hard at J5; VRWM 5.5 V vs VBUS 5.25 V = 0.25 V margin (5 V-only OK) | PASS | High |
| U65 | TPD4E05U06DQAR | ESD on USB CC1 (1/10), CC2 (2/9); ch3/4 open | TI tpd4e05u06 | USON-10 DQA | Yes | DQA0010A | 3,8→GND | none | none | At J5; protects CC (doc §6 says CC unprotected — schematic is better) | PASS | High |
| U17 | TPD4E05U06DQAR | ESD: touch I²C SCL(1/10) 5 V, SDA(2/9) 5 V, touch INT(4/7) 3.3 V; ch (5/6) open | TI tpd4e05u06 | USON-10 DQA | Yes | DQA0010A | 3,8→GND | none | none | Must sit at display flex J4 (INT enters J4.13). Confirm locality | PASS | High |
| U15, U16, U19, U20 | TPD4E02B04DQAR | 3.3 V-class ESD: display ctrl lines (U15/U16), 7 buttons (U19 4ch + U20 3ch) + tamper (U20 ch4) | TI tpd4e02b04 | USON-10 DQA | Yes | DQA0010A | 3,8→GND | none | none | At each connector; 0.25 pF, VBR 5.5 V, clamp 8.8 V@5 A — correct for 3.3 V logic | PASS | High |
| D8, D9 | SZESD7410MXWT5G | Bidir ultra-low-C ESD on 10 MHz ref IN (D8/J8) and OUT (D9/J9), AC-coupled (C149/C160) | onsemi ESD7410 | X2DFNW2 | Sym OK (2-pin) | **NO FOOTPRINT ASSIGNED** | n/a | n/a | series DC-block cap | ~1 pF on 10 MHz = negligible; place at SMA. Part flagged "obsolete" at one distributor | FAIL | High |
| L10 | PGB1010603MR | Polymer ESD suppressor on GPS_RF_IN at SMA J7 (with bias-T L1 → U21) | Littelfuse PGB10603 | 0603 SMD | Yes (2-pin) | IND_PGB_0603_LTF (0603 2-pad) | n/a | n/a | none | 0.06 pF, 150 V, ±24 kV — meets Cj≤0.3 pF + bias-V GPS-SMA reqs. Outdoor run still needs separate coax GDT (deployment) | PASS | High |
| D6 | SMF5V0A | TVS on 5V_DISP rail at display connector | Vishay 85881 | SMF (DO-219AB) | OK (2-pin) | Diode_SMD:D_SMF | n/a | n/a | C40 1 µF + C41 0.1 µF local | **VRWM 5.0 V on a 5 V rail = ~0 margin**; clamps/leaks at rail upper tol. Use SMF5.5/6.0A unless 5V_DISP ≤5.0 V hard | WARNING | High |
| D7 | 1.5SMCxxA (placeholder) | TVS on VCC_RB at FE-5680A DE9 (J6) | Vishay 15smc | SMC (DO-214AB) | OK (2-pin) | Diode_SMD:D_SMC | n/a | n/a | C40? (5V_DISP, not this node) | **Value uncommitted ("xx"). VCC_RB = 5–24 V; must be 1.5SMCJ28A per Rb doc and coordinate w/ 26 V OV latch (standoff >26 V, < FE abs-max)** | FAIL | High |

#### Connector pinout / footprint inventory

| RefDes | Function | Value | Pinout verified | Footprint | Status | Notes |
|---|---|---|---|---|---|---|
| J5 | USB-C 2.0 console | USB4120-03-C | Yes: VBUS A4/A9/B4/B9; GND A1/A12/B1/B12; D+ A6/B6; D− A7/B7; CC1 A5; CC2 B5; SBU A8/B8 NC; SHIELD S1–4 | USB4120-03-C_REVA6:GCT_USB4120-03-C_REVA6 | PASS | Symbol↔netlist↔doc §3.1 all agree |
| J11 | 7-button panel header | Conn_01x08 (7 btn + GND) | Yes: BUTTON_1..7, pin8 GND | **EMPTY** | FAIL | Assign 1×08 header FP |
| J10 | Tamper switch | Conn_01x02 | Yes: 1=RTC_TAMPER, 2=GND | **EMPTY** | FAIL | Assign 1×02 FP |
| J4 | Display+touch flex | Conn_01x14 (MSP4030) | **Pin 11 = DISP_RST, but module pin 11 = CTP_RST** (see blockers); 9/14 NC | **EMPTY** | FAIL | Pinout question + FP |
| J7 | GPS antenna SMA | Conn_Coaxial | 1=GPS_RF_IN, 2=GND | **EMPTY** | FAIL | Assign SMA FP |
| J8 / J9 | 10 MHz ref IN / OUT SMA | Conn_Coaxial | 1=10MHz_RF_IN/OUT, 2=GND | **EMPTY** | FAIL | Assign SMA FP |
| J6 | FE-5680A control DE9 | DE9_Socket | 1=VCC_RB,2=GND,3=RB_LOCK_IN,5=GND,8=RB_RS232_TX,9=RB_RS232_RX,4/6/7 NC,SH=GND | **EMPTY** | FAIL | Assign DE9 FP; confirm FE Tx/Rx direction (J1-8/9) per variant |
| J2 | Fan | Conn_01x04 (5V,FAN_PWM,GND,FAN_TACH) | Yes | **EMPTY** | FAIL | Assign 1×04 FP. (No ESD — internal fan, acceptable) |
| J3 | SWD debug | Conn_01x06 | 3V3_STM,SWCLK,GND,SWDIO,MCU_NRST,SWO | Library:GCT_BG055-06A-…-L-D (6-pos) | PASS | Internal debug; FP matches 6 pins |
| TP1 | Test point on ETH_PPS_OUT | TestPoint | net OK | **DQA0010A (10-pin DFN ESD FP — WRONG)** | FAIL | Replace with a TestPoint pad FP |

#### Netlist findings

| Net | Connected pins | Expected | Observed | Risk | Fix | Status |
|---|---|---|---|---|---|---|
| USB_VBUS_SENSE | R68.1, R67.1, C43.1, U12 PE2 | Divider mid + filter to GPIO | R68 top (VBUS→sense), R67.2→GND bottom, C43.2→GND | None | Clear doc TODO (usb_console §8.1 line 178 wrongly suspects R67 wired to VBUS) | PASS |
| USB_DP / USB_DM | J5 A6/B6 & A7/B7, U12 PA12/PA11, U18 ch1/2 + flow-thru pads | 90 Ω pair, no series R / pull-up | As expected | Layout only | Route as physical flow-through, 90 Ω diff, short | PASS |
| USB_CC1 / USB_CC2 | J5 A5/B5, R66/R64.1 (→GND), U65 ch1/2 | Separate 5.1 kΩ Rd each | R64=5.1k, R66=5.1k, both .2→GND, not tied | None | — (doc says CC unprotected; U65 actually protects) | PASS |
| PG_INT_N | U55 INTA(16)+INTB(15), R200.2, U12 PA10 | MIRROR=1 wire-OR INT + pull-up | Correct (net renamed from PG_IN_N — fix done) | None | Update CLAUDE.md/peripheral-map checkbox to "done" | PASS |
| RTC_TAMPER | J10.1, C44(1nF).1, U20 ch4, U12 PC13 | TAMP input, internal precharge PU, 1 nF, no ext PU | As doc §3; no external pull-up | Depends on RM0481 TAMP config (precharge/filter) | FW verification (open item) | PASS |
| DISP_TOUCH_INT | J4.13, R208(10k→3V3_STM).2, U17 ch, U54 GPA7 | Single PU on 3V3_STM, no cap | Exactly one PU (R208); R167 not present | None | Duplicate-pull-up concern resolved | PASS |
| BUTTON_1..7 | J11.n, Cxxx(0.1µF).1, Rxxx(10k).2, U19/U20 ch + flow-thru, U54 GPA0–6 | PU 3V3_STM + 100 nF + TVS | All 7 correct | None | — | PASS |
| ETH_PPS_OUT | TP1 | Test point | TP1 FP = DQA0010A (wrong) | Build defect (10-pad land on a 1-pin TP) | Reassign TestPoint FP | FAIL |

#### Symbol / footprint cross-check

| RefDes | MPN | DS package | Sym pin#s match | Footprint | Pad#s match | Pin-1/orient | Status |
|---|---|---|---|---|---|---|---|
| U15–U20,U65,U17,U18 | TPD4E02B04 / TPD4E05U06 | USON-10 DQA 2.5×1.0 | Yes | DQA0010A | 10 pads, 0.5 pitch, pin-1 circle | Yes | PASS |
| J5 | USB4120-03-C | USB-C 2.0 16+4 SMT | Yes | GCT_USB4120-03-C_REVA6 | n/a (vendor) | vendor | PASS |
| L10 | PGB1010603MR | 0603 | Yes (2-pin) | IND_PGB_0603_LTF | 2 pads | n/a | PASS |
| D8,D9 | SZESD7410MXWT5G | X2DFNW2 | Yes | — none — | — | — | FAIL |
| TP1 | TestPoint | — | — | DQA0010A (wrong) | — | — | FAIL |

#### Layout-critical constraints for this block

| Net/class | Est current | Width/impedance | Placement / return | Evidence |
|---|---|---|---|---|
| USB_DP/DM | signal | 90 Ω diff, short, length-matched | U18 hard at J5, physical flow-through; both DP/DM also direct to PA12/PA11 | usb_console §5/§6 |
| USB_VBUS | sense only (~24 µA) | n/a | R68/R67/C43 near PE2; 100 k limits PE2 injection when MCU off | usb_console §8.1 |
| GPS_RF_IN | RF 1.5 GHz + 5 V bias | 50 Ω, L10 at SMA | L10 (0.06 pF) at J7 ahead of bias-T L1; outdoor run adds coax GDT | CLAUDE.md GPS-SMA rule; Littelfuse PGB |
| 10 MHz IN/OUT | RF | 50 Ω, AC-coupled | D8/D9 at J8/J9 ahead of C149/C160 | onsemi ESD7410 |
| All TVS arrays | ESD | short, low-Z GND vias on pins 3/8 | every array at its connector; flow-through routing | TI DQA flow-through |
| Tamper / buttons | logic | — | TVS at J10/J11 before PU node; clamp return to chassis | panel docs |

#### Design-intent mismatches

| Ref | Doc says | Schematic says | Severity |
|---|---|---|---|
| U65 / USB CC | usb_console §6.1: "CC1/CC2 are unprotected" | U65 TPD4E05U06 protects both CC lines | Low (schematic better; update doc) |
| R67 | usb_console §8.1 TODO suspects R67 wired USB_VBUS→GND | R67 correctly USB_VBUS_SENSE→GND | Low (clear stale TODO) |
| RTC net name | docs/peripheral-map use `RTC_TAMP` | net is `RTC_TAMPER` | Low (name drift vs naming doc) |
| J4 pin 11 | display doc implies LCD reset on PA8 (DISP_RST) | J4.11 (=MSP4030 CTP_RST) tied to DISP_RST | Medium/High (see blockers) |
| D7 | Rb supply doc: 1.5SMCJ28A on VCC_RB | D7 = 1.5SMCxxA placeholder | High (BOM/safety) |
| PG_INT_N | checklist open item "fix PG_IN_N→PG_INT_N" | already PG_INT_N | Low (mark done) |

### RGB status indicator (D5)  —  _verdict: Needs corrections_

## RGB Status Indicator (D5) — Pre-Layout Review

Topology is sound and the netlist matches the canonical doc exactly: common-anode RGB die (3 ballasts to always-on `5V`), low-side NPN (BC847W) per color, base resistor + 10 k pulldown per color, active-high GPIO drive on PD12/13/14. Electrical design is PASS. **One blocker prevents layout: D5's assigned footprint does not exist in the project** (no `fp-lib-table`, no `.kicad_mod`), and the symbol↔footprint pad mapping for the PLCC-6 therefore cannot be verified.

#### IC / active-device-by-IC

| RefDes | MPN | Function | Datasheet | Package | Symbol pinout verified | Footprint verified | Power/Gnd pins | Strap/EN/RST | Required passives | Layout-critical notes | Status | Confidence |
|---|---|---|---|---|---|---|---|---|---|---|---|---|
| D5 | Inolux IN-P55TATRGB | RGB LED, 6-die-pin PLCC-6 (3 anode / 3 cathode) | inolux-corp.com IN-P55TATRGB | PLCC-6 5.0×5.5 mm P1.8 | YES — symbol pins 1=KB,2=KR,3=KG,4=AG,5=AR,6=AB match doc §2/§6 pinout (internally consistent) | **NO — footprint missing** (see blocker) | none (passive LED) | none | R59/R60/R61 ballast; cathodes to Q collectors | Pin-1 orientation must be checked once footprint exists; place at front panel; verify local ambient ≤ ~25 °C for blue 24.8 mA point (§7) | FAIL (footprint) | High (symbol), Unknown (footprint) |
| Q8 | BC847W | NPN low-side switch, Blue (LED_B) | Nexperia/Infineon BC847 series | SOT-323 (SC-70) | YES — pin1=B,2=E,3=C confirmed vs Nexperia datasheet | YES — `Package_TO_SOT_SMD:SOT-323_SC-70` (KiCad std) matches | E(2)→GND | base 10 k pulldown R56 | R55 1k base, R56 10k pd | none | PASS | High |
| Q9 | BC847W | NPN low-side switch, Red (LED_R) | as above | SOT-323 | YES (1=B,2=E,3=C) | YES | E(2)→GND | R58 pulldown | R57 1.5k base, R58 10k pd | none | PASS | High |
| Q10 | BC847W | NPN low-side switch, Green (LED_G) | as above | SOT-323 | YES (1=B,2=E,3=C) | YES | E(2)→GND | R63 pulldown | R62 3.01k base, R63 10k pd | none | PASS | High |

BC847W pinout (pin1 B / pin2 E / pin3 C) confirmed against Nexperia BC847W (SOT-323) — matches the KiCad `Transistor_BJT:BC847W` symbol and the schematic mapping for all three.

#### Netlist findings

| Net | Connected pins | Expected | Observed | Risk | Fix | Status |
|---|---|---|---|---|---|---|
| LED_B | U12.61 (PD14), R55.2 | GPIO→base R→Q8.B | matches | none | — | PASS |
| LED_G | U12.60 (PD13), R62.2 | GPIO→base R→Q10.B | matches | none | — | PASS |
| LED_R | U12.59 (PD12), R57.2 | GPIO→base R→Q9.B | matches | none | — | PASS |
| Net-(Q8-B) | Q8.1, R55.1, R56.1 | base + pulldown | matches | none | — | PASS |
| Net-(Q9-B) | Q9.1, R57.1, R58.1 | base + pulldown | matches | none | — | PASS |
| Net-(Q10-B) | Q10.1, R62.1, R63.1 | base + pulldown | matches | none | — | PASS |
| Net-(D5-AB/AR/AG) | D5.6/5/4 ↔ R59/R60/R61.2 | anode ← ballast | matches (B=R59, R=R60, G=R61) | none | — | PASS |
| Net-(D5-KB/KR/KG) | D5.1/2/3 ↔ Q8/Q9/Q10.3 (C) | cathode → collector | matches | none | — | PASS |
| 5V | R59/R60/R61.1, U29/U33/U38 | always-on 5 V intermediate | `5V` feeds U33 RT9742 (which gates 5V_DISP downstream) → ballasts are on the un-gated rail | none — satisfies doc §10 | — | PASS |
| GND | Q8/Q9/Q10.2 (E), R56/R58/R63.2 | emitters + pulldowns to GND | matches | none | — | PASS |
| (D5 footprint) | n/a | `Library:LED_IN-P55TATRGB` resolvable | library "Library" has no fp-lib-table entry and no .kicad_mod in repo | layout cannot place D5; pad-map unverifiable | add footprint + fp-lib-table, OR revert to symbol default `LED_SMD:LED_Inolux_IN-P55TATRGB_PLCC6_5.0x5.5mm_P1.8mm` and verify pad numbering | FAIL |

#### BOM validation

| RefDes | MPN | Datasheet found | Package | Footprint | Pkg-FP match | Pinout match | Rating match | Status | Notes |
|---|---|---|---|---|---|---|---|---|---|
| D5 | IN-P55TATRGB | YES (Inolux/LCSC/DigiKey) | PLCC-6 5050 | Library:LED_IN-P55TATRGB (missing) | UNKNOWN | YES (symbol) | Vf R2.0/G3.2/B3.2 V, λ 624/520/468 nm confirmed | FAIL | Footprint missing; pad-map unverifiable |
| Q8/Q9/Q10 | BC847W | YES (Nexperia) | SOT-323 | SOT-323_SC-70 | YES | YES | 45 V/100 mA ≫ ~25 mA Ic, 5 mA base — fine | PASS | — |
| R55 | 1k (ERJ-2RKF1001X) | Panasonic | 0402 | R_0402 | YES | n/a | base R blue, Ib≈2.5 mA | PASS | doc §5 = 1.0 k ✓ |
| R57 | 1.5k (ERJ-2RKF1501X) | Panasonic | 0402 | R_0402 | YES | n/a | base R red | PASS | doc §5 = 1.5 k ✓ |
| R62 | 3.01k (ERJ-2RKF3011X) | Panasonic | 0402 | R_0402 | YES | n/a | base R green | PASS | doc §5 = 3.01 k ✓ |
| R56/R58/R63 | 10k (ERJ-2RKF1002X) | Panasonic | 0402 | R_0402 | YES | n/a | base pulldowns | PASS | doc §6 ✓ |
| R59 | 60.4 (ERJ-2RKF60R4X) | Panasonic | **0402** | R_0402 | YES | n/a | blue ballast 37 mW | WARNING | **doc §4/§10 specifies 0603 for ballasts; schematic uses 0402.** Power fine (37 mW ≪ 63 mW 0402 rating) but contradicts doc |
| R60 | 174 (ERJ-2RKF1740X) | Panasonic | **0402** | R_0402 | YES | n/a | red ballast 48 mW | WARNING | doc says 0603; 48 mW within 0402 rating but tighter margin |
| R61 | 221 (ERJ-2RKF2210X) | Panasonic | **0402** | R_0402 | YES | n/a | green ballast 16 mW | WARNING | doc says 0603; power fine |

#### Symbol / footprint

| RefDes | MPN | Datasheet package | Symbol pin#s | Assigned footprint | Pad#s match | Pin-1/orientation verified | Status |
|---|---|---|---|---|---|---|---|
| D5 | IN-P55TATRGB | PLCC-6 (1=KB,2=KR,3=KG,4=AG,5=AR,6=AB) | YES (symbol pin names = doc pinout) | Library:LED_IN-P55TATRGB (does not exist) | UNKNOWN | NO | FAIL |
| Q8/Q9/Q10 | BC847W | SOT-323 1=B,2=E,3=C | 1/2/3 = B/E/C | SOT-323_SC-70 | YES | YES (std KiCad fp) | PASS |
| R55–R63 | various | 0402 chip | 1,2 | R_0402_1005Metric | YES | n/a | PASS |

#### Layout-critical constraints for this block

| Net/class | Current est | Width/impedance | Placement / return path | Evidence |
|---|---|---|---|---|
| 5V → R59/R60/R61 → D5 anodes | ~50 mA total all-on (24.8 mA B + 16.7 mA R + 8.4 mA G), 0.25 W | default signal width OK (≤25 mA/branch) | front-panel placement; short ballast-to-anode | doc §6 |
| D5 cathodes → Q collectors → GND | per-color 8–25 mA | default width | keep cathode→collector→emitter→GND loop short | doc §1 |
| LED_R/G/B PD12-14 → bases | ~0.8–2.5 mA each, ~5 mA total | signal | route as ordinary GPIO; PWM 0.3–2 kHz | doc §5/§9 |
| D5 thermal | I_F derates to 0 at 80 °C T_OP; 24.8 mA blue point valid only if local ambient ≈ 25 °C | n/a | bench-confirm front-panel local ambient; default to I_blue=20 mA if uncharacterized | doc §7 |
| D5 ESD | front-panel-exposed optic | — | no ESD part fitted on LED lines (acceptable — die behind panel, GPIO-driven low side); consider if panel aperture exposes pins | observation |

#### Design-intent mismatches

| Ref | Doc says | Schematic says | Severity |
|---|---|---|---|
| D5 footprint | symbol default `LED_SMD:LED_Inolux_IN-P55TATRGB_PLCC6_5.0x5.5mm_P1.8mm`; doc §10 "verify pin#↔pad# vs PLCC-6 datasheet" | instance overrides to `Library:LED_IN-P55TATRGB` — library not in fp-lib-table, no .kicad_mod present | **Blocker** |
| R59/R60/R61 package | §4 + §10: "0603 (100 mW) on all… do not use 0402 on red/blue" | all three are 0402 | Medium (doc-vs-as-built; thermally OK but explicit doc rule violated) |
| 5V rail source | CLAUDE.md: "5V net = MIC28516 5 V intermediate" | `5V` net sourced by U29 (AP3441) per netlist; still always-on, gates 5V_DISP via U33 | Low (rail identity nuance; always-on requirement still met) |
| D5 LED pinout independent verification | doc cites pinout from datasheet | could not parse Inolux/LCSC PDF via fetch (binary); symbol is internally consistent with doc but pinout not independently re-confirmed from a machine-readable source | Low (open question) |

## 8. BOM validation

Per-line BOM checks are distributed in the §7 subsystem blocks (each agent validated the BOM lines for its sheet). BOM-level blockers/open items are consolidated in §4 and §14. See also C:/Users/tophe/Documents/repos/ntp-server-stm32/docs/sts1000_bom.md for sourcing-decision lines and C:/Users/tophe/Documents/repos/ntp-server-stm32/hardware/ntp-server-stm32/sts1000_bom.csv.

## 9. Symbol & footprint validation (custom library)

## Custom Symbol + Footprint Library Validation (pre-layout)

Scope: every `.kicad_sym` / `.kicad_mod` in `hardware/libraries/` plus the project-local symbol lib `hardware/libraries/ntp-server-stm32.kicad_sym`. Verified symbol pin **numbers** vs datasheet pinout and footprint pad **numbers/geometry** vs manufacturer land pattern. Datasheet pin tables confirmed by web for INA228-DGS, INA181-DBV, LTC4311-SC6, 74LVC1G157, TPD4E02B04-DQA, MCP41U83-TSSOP14, PGB1010603.

**Headline blockers:** (1) `MCP41U83` symbol (U43, Rb digipot) pin-number map for pins 1–7 disagrees with the Microchip datasheet — wrong pad mapping. (2) `MX25L25645GM2I-08G` symbol (U62 SPI-NOR) has a VCC pin with an empty pin number. (3) ST LGA-12 sensor footprints (U59/U61) and the e-compass need a pin-1-corner cross-check against the ST land-pattern figure. Three custom symbols (`AD5292BRUZ`, `AD5270BRMZ`, `ADCLK925BCPZ`) are orphans not used by the netlist; a stray `2026-06-14_01-24-03.kicad_sym` (`LIS2MDLTR`) is loose in the lib.

#### Symbol/footprint validation (RefDes | MPN | Datasheet package | Symbol pin#s match | Assigned footprint | Pad#s match | Pin-1/orientation verified | Status)

| RefDes | MPN | DS package | Symbol pin# match | Footprint | Pad# match | Pin-1/orient | Status |
|---|---|---|---|---|---|---|---|
| U10/23/26/30/31/32/37/44 | INA228AQDGSRQ1 | VSSOP-10 (DGS), no EP | YES — A1=1,A0=2,ALERT=3,SDA=4,SCL=5,VS=6,GND=7,VBUS=8,IN−=9,IN+=10 matches DS | VSSOP10_DGS_TEX | YES 1–5 left / 6–10 right, 0.5 mm pitch, no EP (correct) | CCW, plausible | PASS |
| U24 | INA181A1IDBVR | SOT-23-6 (DBV) | YES — OUT=1,GND=2,IN+=3,IN−=4,REF=5,V+=6 matches DS | DBV0006A_N | YES, 0.95 mm pitch | plausible | PASS |
| (lib) | INA181A3IDBVR | SOT-23-6 (DBV) | YES (same as A1) | DBV0006A_N | YES | plausible | PASS |
| U56 | LTC4311ISC6 | SC70-6 (SC6) | YES — VCC=1,GND=2,EN=3,BUS2=4,GND=5,BUS1=6 matches DS | SOT-6_SC_LIT | YES, 0.65 mm pitch | plausible | PASS |
| U52 | 74LVC1G157GW-Q100H | SC-74/SOT457-6 | LIKELY — I1=1,GND=2,I0=3,Y=4,VCC=5,S=6 (DS table not machine-read; standard '157 SOT457 order) | SC-74_TSOP6_SOT457_NEX | YES 6-pad dual-row | plausible | WARNING (confirm pin table vs Nexperia DS Table 3) |
| U63 | PCA9306DCTT | SOT-563/DCT-8 | YES — GND=1,VREF1=2,SCL1=3,SDA1=4,SDA2=5,SCL2=6,VREF2=7,EN=8 (standard PCA9306 DCT) | DCT8 | YES 8-pad, 0.5 mm pitch | plausible | PASS (Medium) |
| U15/16/19/20 | TPD4E02B04DQAR | USON-10 (DQA) | YES — channels on 1,2,4,5; GND on 3,8; NC 6,7,9,10 matches DS IO/GND map | DQA0010A | YES — pads 3 & 8 are wide (GND); CCW | pin-1 dot present | PASS |
| U17/18 | TPD4E05U06DQAR | USON-10 (DQA) | YES (same map as B04) | DQA0010A | YES | pin-1 dot | PASS |
| U34/35 | TPS61094DSSR | SON-13 (DSS), EP | YES — 12 signal + EP=13 | SON50P300X200X80-13N | YES 1–12 periph + pad13 EP (1.0×2.65) | plausible | PASS (EP paste window TBD at layout) |
| U39 | TPS7A5201QRGRRQ1 | VQFN-20 (RGR), EP | YES — 20 pins + EPAD=21 | RGR20_2P05X2P05_TEX | YES 1–20 periph + pad21 EP (2.05×2.05) | plausible | PASS (EP has F.Cu only, no paste — add stencil window) |
| U36/42 | OPA320AIDBVT | SOT-23-5 (DBV) | YES — OUT=1,V−=2,+IN=3,−IN=4,V+=5 (standard 5-pin opamp) | SOT95P280X145-5N | YES 5 pads | plausible | PASS |
| U46 | SN65C3221EPWR | TSSOP-16 (PW) | YES count (16↔16); names/numbers per TI (EN=1,C1+=2,V+=3,C1−=4,C2+=5,C2−=6,V−=7,RIN=8,ROUT=9,INVALID=10,DIN=11,FORCEON=12,DOUT=13,GND=14,VCC=15,FORCEOFF=16) | SOP65P640X120-16N | YES 16 pads, 0.65 mm | plausible | PASS (Medium) |
| U59 | LIS2DH12TR | LGA-12 (3×3) | YES — SCL=1…INT1=12 per ST | LGA-12_STM | self-consistent: 1–4 L, 5–6 bot, 7–10 R, 11–12 top | NOT confirmed vs DS fig | WARNING |
| U61 | IIS2MDCTR | LGA-12 (2×2×0.7) | YES — SCL=1,NC=2,CS=3,SDA=4,C1=5,GND=6,INT=7,GND=8,VDD=9,VDD_IO=10,NC=11/12 | LGA-12_2X2X0P7_STM | self-consistent same topology | NOT confirmed vs DS fig | WARNING |
| U11 | LAN8742AI-CZ-TR | QFN-24 + EP | YES count (25↔25) | QFN50P400X400X100-25N | YES 1–24 periph + pad25 EP (2.5×2.5) | CCW pin1 left | PASS (Medium) |
| U12 | STM32H563VIT6 | LQFP-100 | count 100↔100 (per-pin AF not re-audited here) | LQFP-100_STM | YES 100 pads, no EP (correct for LQFP) | plausible | PASS (Medium) |
| U21 | ZED-F9T-00B | 54-pin LGA module | count 102↔102 (incl. paste/GND pads) | MODULE_ZED-F9T-00B | count matches | NOT independently audited | WARNING (Low) |
| J5 | USB4120-03-C | USB-C mid-mount | YES — A1/A4–A9/A12, B1/B4–B9/B12, S1–S4 names match | GCT_USB4120-03-C_REVA6 | YES; A-row y−, B-row y+, mirrored (A1↔B12 etc.) correct USB-C | mirror correct | PASS |
| L?? | PGB1010603MR | 0603 2-term, bidirectional | YES (2-term, symmetric — polarity-agnostic) | IND_PGB_0603_LTF | 2 pads | N/A (symmetric) | PASS |
| (magjack) | ARJ-199 | RJ45+magnetics | 22 sym pins (not pin-audited) | ABRACON_ARJ-199 | not audited | — | WARNING (Low) |
| **U43** | **MCP41U83T-503E/ST** | **TSSOP-14** | **NO — pins 1–7 shuffled vs DS (see below)** | Package_SO:TSSOP-14 (stock) | stock FP OK | — | **FAIL** |
| **U62** | MX25L25645GM2I-08G | SOP/WSON-8 | **NO — VCC pin has empty pin number `""`** ; pins 1–5 named, rest unread | none assigned in BOM | — | — | **FAIL** |
| AD5292BRUZ-50 | (orphan) | TSSOP-14 (RU) | n/a not used | RU-14_ADI | — | — | N/A (orphan — remove or it confuses BOM/lib) |
| AD5270BRMZ-50 | (orphan) | MSOP-10 (RM) | n/a not used | RM_10_ADI | — | — | N/A (orphan) |
| ADCLK925BCPZ | (orphan) | LFCSP-16 (CP) | sym present, not in netlist | CP_16_3_ADI | EP=17 present | — | N/A (orphan — also: all pins typed `unspecified`, ERC-weak) |
| LIS2MDLTR | (stray file) | LGA-12 (2×2×1) | in `2026-06-14_01-24-03.kicad_sym`, not in sym-lib-table | LGA-12_2X2X1_STM | — | — | N/A (stray; delete or register) |

#### MCP41U83 (U43) symbol vs datasheet — pin-number conflict (Microchip DS20007000, TSSOP-14)

| Pin | Symbol (`ntp-server-stm32.kicad_sym`) | Datasheet | Match |
|---|---|---|---|
| 1 | VDD | CS/A0 | NO |
| 2 | SDO/A1 | SDI/SDA | NO |
| 3 | SCK/SCL | DGND | NO |
| 4 | SDI/SDA | SPI2C | NO |
| 5 | nCS/A0 | VDD | NO |
| 6 | SPI2C | SDO/A1 | NO |
| 7 | DGND | SCK/SCL | NO |
| 8–14 | P0B,P0W,P0A,VSS,NC,NC,NC | P0B,P0W,P0A,VSS,NC,NC,NC | YES |

Pins 8–14 agree; pins 1–7 are reordered. This is the digipot sitting in the Rb buck FB node — a wrong pad map mis-wires VDD/VSS/SPI/wiper-config and can drive VCC_RB out of the safe envelope. Must be corrected and re-verified against the datasheet pinout figure before layout. (This is exactly the open item flagged in `CLAUDE.md` / `hardware/CLAUDE.md`: "MCP41U83 pin numbers TBD".)

#### Layout-critical constraints for this block (net/class | est | width/impedance | placement | evidence)

| Item | Note | Evidence |
|---|---|---|
| INA228 VSSOP-10 | No exposed pad (correct); Kelvin IN+/IN− to shunt | VSSOP10_DGS_TEX has 10 pads, no EP; INA228-Q1 DS |
| TPS7A52 RGR EP (pad21) | EP is `F.Cu`-only, no paste aperture | RGR20…TEX.kicad_mod pad 21 |
| TPS61094 SON EP (pad13) | EP is `F.Cu`+`F.Mask`, no paste aperture | SON50P300…13N pad 13 |
| LAN8742 / MIC bucks QFN EP | EP pad 25 / thermal vias at layout | QFN50P400…25N pad 25 |
| ST LGA-12 sensors | confirm pin-1 corner + ST land dims; magnetometer needs current-free GND pour (hardware/CLAUDE.md) | LGA-12_STM / 2X2X0P7 |

#### Design-intent mismatches (Ref | Doc says | Schematic/lib says | Severity)

| Ref | Doc | Lib/BOM | Severity |
|---|---|---|---|
| U43 digipot | docs reference MCP41U83 (Rb digipot); AD5292/AD5270 are in sym-lib-table | AD5292BRUZ + AD5270BRMZ symbols exist but are orphan/unused | Low (housekeeping — remove unused libs to avoid the wrong part being placed) |
| Rb digipot pinout | CLAUDE.md open item: "MCP41U83 pin numbers TBD" | symbol pins 1–7 wrong | High |
| U62 SPI-NOR | software_spec requires SPI-NOR (Macronix MX25L) | symbol has empty pin number on VCC; no footprint in BOM | High |
| Magjack/ARJ-199, ZED module | authoritative parts | symbols present, pin/pad maps not independently audited here | Medium (audit before layout) |

## 10. Power-tree review

## Whole-Board Power-Tree Pre-Layout Review — STS1000 "Meridian"

Scope: PoE input → FDMQ8205A bridge → NCP1095 PD → 5 V intermediate buck → 3V3 main → per-rail LDOs/bucks (OCXO, Rb, GPS, RF island, display) → supercap backup. Evidence: `ntp-server-stm32.net` (flattened connectivity), `sts1000_bom.csv`, `docs/ntp_server_peripheral_map.md §6/§7`, vendor datasheets. Confidence tags inline.

### Power-tree table

| Rail | Source (designator) | Vnom | Vmin/max | Est max I | Loads | Enable ctrl | Sequencing | Decoupling | Protection | Layout notes | Status |
|---|---|---|---|---|---|---|---|---|---|---|---|
| **VOUT_P** (rectified PoE bus) | U7+U8 FDMQ8205A dual bridge (Mode A+B, all 4 pairs from magjack J1) → U9 NCP1095 pin1 VPORTP; hot-swap Q2 FDMC8622 in VOUT_N return | ~37–57 V | 37–57 V (802.3bt) | ~0.6–0.8 A peak @ 25–30 W | U28A (main buck), U40A (Rb buck), C75/C77/C80/C133/C134/C136 (2.2µF/100V X7T), C10 (10µF/100V) | NCP1095 PD gate (Q2) | classification then power-good | 100 V X7T bank present | **No HV bus TVS (SMAJ58A-class) found on VOUT_P** — see B1 | Kelvin RDET/RCLASS to U9; 57 V creepage; Q2 thermal | **WARNING** |
| **5V** (intermediate) | U28A MIC28516 buck from VOUT_P; L2 6.8µH/11.5A (SRP1265A) | 5.0 V | FB-set: 0.6×(1+15k/2.05k)=**5.0 V** | ~3–4 A (feeds 3V3 buck + OCXO buck + LDO refs + fan + 5V_DISP + ant bias) | U29 (3V3), U38 (OCXO pre), U13/U14/U45 refs, U27 (ant), U33 (disp), U2/U41/U42 comparators/buffers, J2 fan | always-on (POE_PG → U28 EN path) | comes up after PD power-good | C64/65/66/71/72 (47µF+10µF) | inrush via U28 SS (C63) | L2 saturation OK (11.5A vs ~4A); high-di/dt loop | **PASS** (verify I budget) |
| **3V3 (main/general)** | U29 AP3441 buck from **5V** | 3.33 V | 0.6×(1+10k/2.2k)=**3.33 V** | ~1.5–2 A | PHY 3V3_LAN(via FB1), all INA228 VS, Rb-IO, RS232 U46, OCXO INA, 3V3_CLK(via FB10), **3V3_STM via R106** | always-on | after 5V | C83/86/87 etc | — | **U29 input = 5.0 V vs AP3441 Vin abs-max 5.5 V → only 0.5 V margin (A1)** | **WARNING** |
| **3V3_STM** ("always-on" housekeeping) | **3V3 through R106 = 0.5 Ω sense shunt** (INA228 U31 across it) — NOT an independent regulator | 3.3 V − I·0.5Ω | tracks 3V3 | ~0.3–0.5 A | STM32 VDD (×5), both MCP23017, LTC4311, TMP117×2, IIS2MDC, LIS2DH12, ATECC608B, NOR U62, PCA9306, TPS3430 WDT, INT pull-ups | none (always = 3V3) | identical to 3V3 | C168–C181, C21–C25 | — | **0.5 Ω shunt on full STM rail → 250 mV drop @0.5 A; and "always-on" is a misnomer — it collapses with 3V3 (B2)** | **FAIL** |
| **3V3_CLK** | 3V3 via FB10 (600Ω ferrite) | 3.3 V | — | <0.1 A | U52 mux, U53 fanout buf | always-on | with 3V3 | C157/158/159 | ferrite isolation | quiet clock-VDD island | **PASS** |
| **3V3_LAN** | 3V3 via FB1 (600Ω ferrite) | 3.3 V | — | ~0.1 A | U11 LAN8742 VDDIO, magjack J1 12/6 | always-on | with 3V3 | C13/19/20/2 | ferrite | — | **PASS** |
| **OCXO 3.3 V** | U38 AP3441 (5V→**3.7 V**, FB 12.4k/2.4k) → U39 TPS7A52 LDO (3.7→3.33 V, FB 12.1k/3.83k, Vref 0.8) | 3.33 V | dropout 115 mV; have 370 mV | ~0.5–1.2 A (warm-up) | Y3 OH300 (OCXO_V via R122), U36 OPA320, INA228 U37 | always-on (low-noise) | first up (warm-up staging) | C102–C115 bank | TPS7A52 ULN LDO for phase noise | Vc-path caps must be C0G/film not X7R; 370 mV headroom OK | **PASS** |
| **VCC_RB** (Rb buck) | U40A MIC28516 from VOUT_P; **L7 spec'd 40µH but MPN = SRP1265A-6R8M = 6.8µH (C1)**; FB digipot-trimmed (R134/R147/R148 + U43 MCP41U83) | 5–24 V (set per Rb, +15 V typ) | bounded by fixed R; OV latch @26 V (U41 LMV393 + D7 TVS) | ~6–10 W steady, 15–20 W warm-up | J6 (FE-5680A), INA228 U44 | **RB_PWR_EN (PB7)** → Q18 → U40 EN | deferred until OCXO warm + supercaps charged | C126–C138 | autonomous 26 V OV latch; D7 TVS **value unspecified "1.5SMCxxA" (B3)** | high-Z FB node keep-out; L7 inductor wrong value blocks layout | **FAIL** (L7 + D7) |
| **3V3_GPS** | U22 LT3045 LDO (from 5V via FB3) | 3.3 V | — | ~0.2–0.4 A | U21 ZED-F9T VCC, INA228 U23, U24 | **GPS_PWR_EN (PC8)** → U22 EN | after 3V3 | C45/47/54/55/56 | LT3045 ULN | — | **PASS** |
| **3V0_RF** (RF island) | U51 LT3045 LDO (from 5V via FB9) | 3.0 V | — | <0.1 A | U49 TMUX, U50 LTC6752 slicer | 5V_PSU_PG-gated EN | with 5V | C156 | island clamp D20/D21 | analog island | **PASS** |
| **V_ANT** (antenna bias) | U27 RT9742 load switch from 5V → bias-T (L1 47nH) | 5 V | — | ~50–150 mA | active antenna via SMA | **ANT_BIAS_EN (PC9)** | runtime | C61/62 | foldback Q12 + R77 sense; INA228 U26 | RF + bias ESD at SMA (separate review) | **PASS** |
| **5V_DISP** | U33 RT9742 load switch from 5V → INA228 U32 (R107 shunt) → FB7 → J4 | 5 V | — | ~0.3–0.5 A (backlight) | LCDwiki MSP4030 module, FT6336U via PCA9306 U63 | **DISP_EN (PC11)**, R104 pull-down default-off | runtime | C40/41 | D6 SMF5V0A TVS at connector | RT9742 inrush vs I_LIM open item | **PASS** |
| **GPS_VBAT / V_BCKP** | U34 TPS61094 (VIN=3V3, VOUT=GPS_VBAT); supercap C90 (DSF305Q3R0 3F) on SUP pin | ~3.3 V bypass / boost from supercap | supercap ≤2.55 V charge | µA holdover | ZED-F9T V_BCKP (pin36) | strapped EN=1/MODE=1 (R108/R110 to VOUT) auto buck/boost | autonomous | C92/94/96 | — | supercap ≤75 °C; **SUP node → ADC PA6 directly, no divider, contradicts §7 (B4)** | **WARNING** |
| **STM_VBAT** | U35 TPS61094 (VIN=3V3, VOUT=STM_VBAT); supercap C91 (3F) on SUP | ~3.3 V | supercap ≤2.55 V | µA | STM32 VBAT (pin6) | strapped EN/MODE auto | autonomous | C93/95/97/33/35 | — | SUP→ADC PB1 direct (B4) | **WARNING** |

### Netlist findings

| Net | Connected pins | Expected | Observed issue | Risk | Fix | Status |
|---|---|---|---|---|---|---|
| 3V3_STM | R106.2 (0.5Ω from 3V3), U12 VDD×5, all housekeeping ICs, J3.1 | Independently-powered always-on rail (per docs) | Fed from 3V3 only via **R106 = 0.5 Ω sense shunt**; no separate regulator | "Always-on 3V3_STM" collapses with 3V3; 0.5 Ω × ~0.5 A = 250 mV IR drop into STM32 VDD; shunt over a 0.5 A rail dissipates ~125 mW and degrades VDD regulation | Either accept that 3V3_STM≡3V3 (update docs to stop implying independence) **and** drop shunt to ~10–25 mΩ; or give 3V3_STM its own LDO if true always-on independence is intended | **FAIL** |
| VOUT_P | U7/U8 (bridge), U9.1, U28 PVDD/SVIN, U40 PVDD/SVIN, 100V caps | Rectified 37–57 V PD bus with surge clamp | No HV TVS (SMAJ58A / SMCJ58A) on the bus; only D2/D3 (5VWM) on signal pairs | PoE surge/transient (IEC 61000-4-5, cable transients) can exceed 100 V cap rating and stress U28/U40/Q2 | Add bus TVS (e.g. SMAJ58A) VOUT_P→VOUT_N at PD front end per NCP1095 app note | **WARNING** |
| BKP_GPS_SOC_V / BKP_STM_SOC_V | U34.6/U35.6 (SUP), C90/C91, U12.31/U12.36 (ADC), L4/L5 | Supercap SoC sense to ADC | SUP (live switching supercap node) wired **directly** to ADC; §7 specifies "/2 divider" (absent) | Switching noise on ADC; supercap node is fine ≤VDDA but no series R/filter; doc mismatch | Add series R (1–10 k) + filter cap to ADC; reconcile §7 (no divider needed since ≤2.55 V, but add RC) | **WARNING** |
| Net-(U28A-FB)=5V, U29.3 input | U29 VIN on 5.0 V | AP3441 Vin ≤5.5 V abs-max | 5.0 V nominal leaves 0.5 V to abs-max; 5V rail overshoot/ripple eats margin | Marginal abs-max on 3V3 and OCXO bucks (U29, U38) | Verify 5V transient ≤5.5 V, or drop 5V to 4.8–5.0 V w/ tight tolerance; confirm AP3441 OK at 5.0 V | **WARNING** |
| POE_PG | U9.14, U28.24 (EN), U55.24, R20.2 | PD power-good → main buck EN | OK — NCP1095 PG gates U28 enable | none | — | **PASS** |
| RB_PWR_EN | U12.93 (PB7), R156→Q18→U40.24 EN, R160/R164 pull-down, U46.16 | Rb buck EN + warm-up staging | Also drives U46 (SN65C3221 FORCEOFF?) pin16 — confirm intended dual use | Low | Verify PB7 fanout to U46.16 is intentional (RS232 enable tied to Rb power) | **PASS (verify)** |
| GBR | D1.3, U9.11 | NCP1095 gate-of-bridge / aux | D1 = BAV70 (dual diode) on GBR | none obvious | confirm GBR usage per NCP1095 | **PASS** |

### BOM validation (power-tree parts)

| RefDes | MPN | Datasheet found | Package | Footprint | Pkg-FP match | Pinout match | Rating match | Status | Notes |
|---|---|---|---|---|---|---|---|---|---|
| U7/U8 | FDMQ8205A | Y (onsemi GreenBridge) | DFN/QFN dual | matches | Y | per net (12-16 taps) | 100 V, OK for 57 V bus | PASS | dual = Mode A+B |
| U9 | NCP1095DBR2 | Y | 16-TSSOP | 16-TSSOP | Y | Y | 802.3bt PD | PASS | RDET=R15 26.1k ✓, RCLASS R13=232/R14=909 (verify class) |
| U28/U40 | MIC28516T-E/PHA | Y (Vfb 0.6 V, 4.5–70 V) | 36-VQFN | matches | Y | Y | 70 V in OK | PASS | main + Rb buck |
| U29/U38 | AP3441SHE-7B | Y (Vfb 0.6 V, **Vin 2.7–5.5 V**) | TSOT | matches | Y | Y | **5.0 V in vs 5.5 V max = tight** | WARNING | A1 |
| U39 | TPS7A5201QRGRRQ1 | Y (Vref 0.8 V, Vin≤6.5 V, dropout 115 mV) | VQFN-20 | matches | Y | Y | OK | PASS | OCXO ULN LDO |
| U13/U22/U51 | LT3045 | Y | DFN | matches | Y | Y | OK | PASS | VDDA/GPS/RF LDOs |
| U34/U35 | TPS61094DSSR | Y (buck/boost + supercap mgr) | SON | matches | Y | EN/MODE strapped =1/1 ✓ | OK | PASS | backup managers |
| U27/U33 | RT9742VGJ5 | Y (load switch) | TSOT-25 | matches | Y | Y | 5 V | PASS | ant bias / disp |
| L2 | SRP1265A-6R8M 6.8µH/11.5A | Y | — | KEEP | Y | n/a | OK for ~4 A | PASS | main buck |
| L3/L6 | DR73-2R2-R 2.2µH/4.15A | Y | — | KEEP | Y | n/a | OK | PASS | 3V3 / OCXO pre |
| **L7** | "40µH" value but MPN **SRP1265A-6R8M (=6.8µH)** | mismatch | — | KEEP | **N** | n/a | wrong value | **FAIL** | C1 — Rb buck inductor value/MPN contradict |
| L4/L5 | 2.2µH (no MPN) | — | — | SELECT | unk | n/a | unk | UNKNOWN | backup buck inductors unspecified |
| **D7** | "1.5SMCxxA" (VCC_RB TVS) | placeholder | SMC | D_SMC | Y | n/a | **clamp V not chosen** | **FAIL** | B3 — must pick standoff vs Rb Vmax + 26 V OV |
| D2/D3 | DF6A6.8FUT (5VWM TVS) | Y | SOT363 | matches | Y | n/a | signal-pair only | PASS | not the HV bus clamp |
| D4 | "12V" zener (VAUX) | generic | — | — | unk | n/a | NCP1095 VAUX clamp | WARNING | assign real PN |
| R106 | 500mΩ "shunt TBD" on 3V3_STM | — | 0805 | 0805 | Y | n/a | **0.5 Ω too high for full STM rail** | FAIL | B2 |
| R16/R30/R159 | 25m/150m/20m shunts (TBD) | — | 0805 | 0805 | Y | n/a | per-rail TBD | REVIEW | INA228 shunt sizing open |

### Design-intent mismatches

| Ref | Doc says | Schematic says | Severity |
|---|---|---|---|
| 3V3_STM | "always-on 3V3_STM (independent of gated rails); back-power-safe by being on always-on rail" (peripheral_map §4/§6) | 3V3_STM = 3V3 through R106 0.5 Ω shunt; same regulator, collapses together | **High** — the "independence" premise is false; only meaningful if 3V3 is itself always-on (it is, U29). Wording overstates separation; shunt value wrong |
| Backup SoC sense | §7: "PA6/PB1 /2 divider" | SUP node direct to ADC, no divider | Medium (functionally OK ≤2.55 V; add RC) |
| L7 Rb inductor | docs §5: "L7 40 µH" | MPN SRP1265A-6R8M = 6.8 µH | High (C1) |
| OCXO supply | peripheral_map §2: "10 MHz CMOS → PH0; 3.3 V" / "Vc 0.30–3.00 V" | OCXO rail = TPS7A52 3.33 V ✓; pre-reg U38 3.7 V | Low (consistent) |
| PoE class | "Type 2 min / Type 3 margin" | RCLA=232/RCLB=909 dual-resistor (bt-capable) | Low — verify exact class maps to ≥Type 2 |

### Layout-critical constraints for this block

| Net/class | Current est | Width/impedance | Placement / return-path | Evidence |
|---|---|---|---|---|
| VOUT_P 57 V bus | 0.6–0.8 A | wide, 57 V creepage/clearance | bridge U7/U8 → U28/U40 short; HV caps at buck inputs; Kelvin to U9 RDET/RCLASS | NCP1095 app note; net dump |
| U28A SW (L2), U29 LX (L3), U38 LX (L6) | 4 A / 3 A / 1 A | tight hot-loop, min area | input cap–FET–inductor loop minimal; SW copper minimized | MIC28516/AP3441 layout guidance |
| 3V3_STM shunt R106 | ~0.5 A | Kelvin sense to U31 IN+/IN- | shunt close to INA228 U31; **resize value** | net dump (R106 0.5Ω) |
| OCXO Vc loop-filter caps | n/a | — | C0G/NP0 only (X7R microphonics); short Vc trace PA4→Y3.1 | CLAUDE.md, peripheral_map §2 |
| Rb buck FB node (R134/R147/R148/U43) | high-Z | keep wiper/SPI noise off FB | digipot U43 + buffer U42 close; guard FB | sts1000_vcc_rb_supply.md |
| Supercap C90/C91 | charge/boost | thermal ≤75 °C | away from OCXO oven/Rb/bucks; 2.55 V derate | CLAUDE.md |
| TPS61094 SW (L4/L5) | backup current | min loop | near U34/U35; isolate SUP→ADC with RC | net dump |

### Summary
PoE input → bridge → NCP1095 → 5 V → 3V3 → per-rail LDOs/bucks is topologically sound and FB dividers compute to correct nominals (5.0 V, 3.33 V, OCXO 3.33 V). Backup managers are correctly strapped autonomous (EN/MODE=1/1). **Blocking issues before layout:** (1) L7 Rb inductor value/MPN contradiction; (2) 3V3_STM is the same rail as 3V3 via a 0.5 Ω shunt — both the value and the "independent always-on" doc premise are wrong; (3) D7 Rb TVS clamp voltage unspecified. **Strong warnings:** missing HV bus TVS on the 57 V rail; AP3441 5.0 V-in vs 5.5 V abs-max margin; supercap SUP node tied to ADC without RC/divider (doc says /2 divider). PoE classification uses correct dual-resistor bt scheme but exact class needs datasheet confirmation against Type 2/3 target.

## 11. Interface review

## Interface-by-Interface Pre-Layout Review — STS1000 "Meridian"

Scope: the 13 buses/interfaces in `docs/ntp_server_peripheral_map.md`. Connectivity verified against `ntp-server-stm32.net` (KiCad 10, 551 comps / 442 nets); external facts verified against vendor datasheets where noted. Reference is by designator+pin.

### Master interface table

| Interface | Nets / key designators | Voltage domain | Termination | Pull-ups/downs | Protection/ESD | Impedance | Length matching | Connector notes | Layout notes | Status |
|---|---|---|---|---|---|---|---|---|---|---|
| **I²C1 (PB8/PB9)** | `I2C_SCL`/`I2C_SDA`; U12.95/96; bus nodes U10,U23,U26,U30,U31,U32,U37,U44,U54,U55,U56,U57,U58,U59,U60,U61,U63 | 3V3_STM (all nodes on always-on rail per doc) | none (open-drain) | R202/R203 = 4.7k → 3V3_STM (single main pair, correct) | none on-board (internal); LTC4311 U56 accelerator | n/a (≤400 kHz) | n/a | n/a | LTC4311 U56 EN(pin3) **hard-tied 3V3_STM** | **WARNING** — see B1 |
| **SPI4 (NOR/disp/digipot)** | `SPI_SCK` PE12, `SPI_MISO` PE13, `SPI_MOSI` PE14, `SPI_NSS` PE11; U62 NOR, U43 digipot, display via R210/R211 | 3V3 (U62,U43 VDD=3V3) | R210/R211 22Ω series on display SCK/MOSI stub (good) | NOR nWP R207 10k, NSS R212 10k, NOR_RST R205 10k, DPOT_CS R135 10k | U15/U16 TPD4E02B04 at J4 (disp branch) | ~50Ω single-ended at 20–40 MHz | none required (short on-board) | display stub at J4 | display MISO NC (write-only) — correct | **PASS** |
| **USART3 (GNSS)** | `GPS_RX` PD8→U21.43(RXD), `GPS_TX` PD9→U21.42(TXD) | 3V3_GPS / 3V3 | none | none on UART | none (internal) | n/a | n/a | n/a | net names from GPS-side (PD8 *drives* F9T RXD — correct) | **PASS** |
| **UART4 (GPS corr.)** | `GPS_RXD2` PD1→U21.26, `GPS_TXD2` PD0→U21.27 | 3V3 | none | none | none | n/a | n/a | n/a | optional RTCM path | **PASS** |
| **RS-232 (FE-5680A)** | U46 SN65C3221, K1 G6K-2F-Y relay, U48 opto; `RB_TX` PE7, `RB_RX` PB4, `RB_LOCK` PB13 | 3V3 logic + RS-232 charge-pump; opto-isolated lock | n/a | RB_LOCK R173 22k pull-up + C148 filter; RB_RS232_RX R171 4.7k (opto LED limit) | U47 PESD15VL2BT at J6; opto U48 isolates lock | n/a | n/a | J6 (FE-5680A housekeeping, DB9-class) **no footprint assigned** | U46 ~FORCEOFF←RB_PWR_EN (power-coupled, OK); relay coil via Q21/D15 flyback | **WARNING** — see B6 |
| **RMII / Eth+PTP** | U11 LAN8742; RMII PA1/PC1/PA2/PC4/PC5/PA5/PA7/PB10/PB12/PB15; MDI TRD0/TRD1; ETH_PPS_OUT PB5 | 3V3 / 3V3_LAN | R31–34 100Ω series on RX/MODE; MDI R42–45 49.9Ω→3V3_LAN (datasheet-correct) | RBIAS R37 12.1k✓; MDIO R36 1.5k✓ | U1 TPD4EUSB30 on MDI | RMII 50Ω SE; MDI 100Ω diff | **TX/RX RMII group + MDI pairs must be length-matched** | J1 0826-1X1T magjack, **no footprint** | strap latch risk on MODE/PHYAD | **FAIL** — see B2 |
| **PoE** | J1 VC1–4 (TR0–3_TAP)→U7/U8 FDMQ8205A bridge→U9 NCP1095; POE_KILL PE15 | 48 V PoE / PD rail | bridge + PD per NCP1095 | POE_KILL R17 pulldown (default-RUN)✓ | center-tap caps; TVS in PoE sheet (not audited here) | high-V isolation/creepage | n/a | magjack VC pins (4-pair) | classify Type 2 min / Type 3 margin | **PASS (cond.)** — see O-PoE |
| **USB-C console** | J5 GCT USB4120; PA11/PA12; `USB_VBUS_SENSE` PE2 | 3V3 logic, 5 V VBUS sense | n/a | CC1/CC2 R66/R64 = **5.1k Rd**✓ (UFP sink); VBUS div R67 121k/R68 100k | U18 TPD4E05U06 (D±,VBUS); U65 ESD on CC | 90Ω diff (USB2.0 FS) | DP/DM pair match | D1±/D2± tied (reversible)✓; SHIELD via C42/R65 to GND✓ | self-powered, DP pull-up gated by PE2 | **PASS** |
| **RF: GPS SMA** | J7→L1 47nH bias-T + L10 **PGB1010603MR polymer ESD**→U21.2 RF_IN; ANT_DETECT/OFF/SHORT supervisor | RF + 5 V ant bias | bias-T (L1) | supervisor R79/R84/R87 | L10 polymer ESD (Cj≈0.3pF)✓; **no on-board coaxial GDT** | 50Ω 1.5 GHz | n/a | J7 SMA **no footprint** | keep RF island; GDT at antenna entry (off-board) | **WARNING** — see B5 |
| **RF: ext 10 MHz SMA** | J8→C149 AC-couple + D8 SZESD7410→U49 TMUX1101 (term, REF_TERM_EN PC10)→U50 LTC6752xS5→R184 33Ω→mux I1 + PB14 | 3V0_RF island | switched 50Ω (U49) | self-bias slicer | D8 ESD on SMA; D21 VCC guard on U50 | 50Ω at 10 MHz (low) | n/a | J8 SMA **no footprint** | PB14 taps slicer out as EXTREF_MON | **WARNING** — see B3 (net naming) |
| **Display + touch** | ST7796 SPI (PE9 CS, PB0 DC, PA8 RST, PE6 BL); touch via U63 PCA9306; rail 5V_DISP (U33 RT9742, DISP_EN PC11) | 5V_DISP gated; logic 3V3 | R210/R211 22Ω series | DISP_EN R104 pulldown (default-off)✓ | U15/U16/U19/U20 TPD4E02B04 (ctrl/SPI 3.3V); U17/U18 TPD4E05U06 (5 V touch) | SPI ≤40 MHz | n/a | J4 (display FFC/header) | PCA9306 VREF1=3V3_STM/VREF2=5V_DISP/EN=DISP_EN✓ | **PASS** |
| **ADC analog senses** | PA3 OCXO_V (Vc), PA6 BKP_GPS_SOC_V, PB1 BKP_STM_SOC_V | VDDA 3V3 | n/a | SOC /2 dividers (per doc) | n/a | n/a | n/a | n/a | Vc no divider (≤3.0 V); keep Vc-sense away from switchers | **PASS** |
| **DAC (OCXO steer)** | PA4 OCXO_VC → loop filter → Y3 Vc; OCXO out Y3.4→R123 22Ω→mux I0 | VDDA / 3V3_CLK | R123 22Ω source term at driver✓ | Vc bias to ~1.65 V (loop filter) | n/a | n/a | n/a | n/a | **Vc-path caps must be C0G/film, never X7R** — audit in OCXO sheet | **PASS (cond.)** — see O-OCXO |

### Netlist findings

| Net | Connected pins | Expected | Observed issue | Risk | Fix | Status |
|---|---|---|---|---|---|---|
| `WDT_EN` | U12.68 (PA9), U64.6 (SET1), R213 | doc §4/§8: PA9 = `I2C_BUF_EN` → LTC4311 EN | **PA9 reassigned to WDT_EN; LTC4311 EN tied to 3V3_STM** | Med — loses firmware I²C bus-recovery; doc/sch disagree | Reconcile: keep PA9=WDT_EN and update docs, OR free a pin for I2C_BUF_EN | FAIL (doc mismatch) |
| `Net-(U11-RXD0/MODE0)` etc. (U11 pins 7,8,10,11) | only R31–34 (to MCU RMII) + U11 strap pins | strap latched at reset by a dedicated pull at the PHY pin | **MODE0/1/2, PHYAD0, RXER straps have NO pull at PHY**; only 100Ω series to high-Z MCU RMII pins | High — PHY mode/address undefined at reset | Add strap pulls (e.g. 10k) at U11 pins 7/8/10/11 to set RMII/100/PHYAD per checklist | FAIL |
| `10MHz_CLK_OUT` | U12.53 (PB14), U52.1 (mux I1), R184 | doc: PB14 = `EXTREF_MON` watching mux input B | Connectivity correct (PB14 taps slicer→I1) but **net name implies an output**, not the EXTREF_MON capture input | Low — naming/clarity defect | Rename net to `EXT_REF_IN`/`EXTREF_MON` | WARNING |
| `CLK_OUT` (PH0) | U12.12 (PH0), R187, mux Y | PH0 = `OSC_IN`/HSE-bypass input | net named `CLK_OUT` for an oscillator **input** | Low — naming defect | Rename to `OSC_IN` | WARNING |
| `R44` = 49.9Ω on TRD0_N | J1.10, R44, U1.2, U11.20 | per CLAUDE.md TODO "drop legacy R44 at PC12 (double pull-up)" | **R44 is now an Ethernet MDI 49.9Ω term**, NOT an INA_ALERT pull-up | Info — stale action | Close the "drop R44" action; INA_ALERT pull-up is R199 only | RESOLVED |
| `INA_ALERT_INT_N` | U12.80 (PC12), U54.15 (INTB), R199 | single 10k pull-up | exactly R199 present; no R44 conflict | none | none | PASS |
| `EXP_RST_N` | U12.15 (PC0), U54.14, U55.14, R198 | shared expander /RESET + pull | correct (R198 pulldown) | none | none | PASS |
| `GPS_RST_N`/`GPS_SAFEBOOT_N` | PD11/PD15 + U21 only | module inputs deasserted at MCU reset | **no external pulls**; relies on F9T internal pull-ups | Low | Confirm F9T internal pulls hold reset/safeboot deasserted while MCU high-Z | WARNING |
| `Net-(J5-SHIELD)` | J5.S1–4, C42, R65 (1M) | chassis bleed RC | OK (C42 + 1M to GND) | none | none | PASS |

### BOM / part validation (interface ICs)

| RefDes | MPN | Datasheet found | Package | Footprint | Pkg-FP match | Pinout match | Rating match | Status | Notes |
|---|---|---|---|---|---|---|---|---|---|
| U11 | LAN8742AI-CZ-TR | yes (Microchip) | QFN-24 | QFN50P400X400X100-25N (custom) | yes | yes | AEC? industrial -40/85 | PASS | MDI 49.9Ω→VDD, RBIAS 12.1k confirmed vs checklist |
| U12 | STM32H563VIT6 | yes | LQFP-100 | LQFP-100_STM | yes | yes | -40/85 | PASS | PE1/PB11 not bonded — confirm unused |
| U21 | ZED-F9T-00B | yes | module | MODULE_ZED-F9T-00B | yes | yes | — | PASS | V_USB→GND (USB off)✓; VCC_RF pin7 NC — verify |
| U46 | SN65C3221EPWR | yes (TI) | TSSOP-16 | SOP65P640X120-16N | yes | yes | — | PASS | FORCEOFF←RB_PWR_EN |
| U50 | LTC6752xS5 | yes (ADI) | TSOT-23-5 | TSOT-23-5 | yes | yes | 3.6 V abs-max (base) → D21 guard | PASS | confirm exact variant suffix |
| U56 | LTC4311ISC6 | yes (ADI) | SC-6 (SOT-23-6) | SOT-6_SC_LIT | yes | yes (EN tie-to-VCC valid) | — | PASS-W | always-enabled; see B1 |
| U62 | MX25L25645GM2I | yes (Macronix, TW) | SOP-8 | **none assigned** | n/a | yes | — | WARNING | sourcing OK; **footprint missing** |
| U63 | PCA9306DCTT | yes (TI) | SOT-23-8/DCT | DCT8 (custom) | yes | yes | — | PASS | — |
| U43 | MCP41U83T-503E/ST | yes (Microchip) | TSSOP-14 | TSSOP-14_4.4x5 | yes | yes (SPI: SPI2C→GND) | — | PASS-W | confirm wiper opcode/POR per open item |
| J1 | 0826-1X1T-HS-F (Halo) | yes | RJ45 magjack | **none assigned** | n/a | 4-pair PoE taps VC1–4 | — | WARNING | footprint missing |
| J5 | GCT USB4120-03-C | yes | USB-C 16P | GCT_USB4120-03-C | yes | yes | 5 V/3 A | PASS | — |
| J7/J8/J9 | Conn_Coaxial (generic) | — | SMA? | **none assigned** | n/a | n/a | RF | WARNING | pick real SMA PNs + footprints before layout |
| U1 | TPD4EUSB30 | yes (TI) | USON-10 | 10-USON | yes | yes | low-Cj | PASS | repurposed for MDI ESD — acceptable Cj |

### Design-intent mismatches

| Ref | Doc says | Schematic says | Severity |
|---|---|---|---|
| PA9 | §4/§8: PA9 = `I2C_BUF_EN`, LTC4311 EN driven for bus recovery | PA9 = `WDT_EN`→U64.SET1; LTC4311 EN = 3V3_STM | High |
| PHY straps | §1/§14: MODE/PHYAD/nINTSEL strapped at reset | MODE/PHYAD/RXER float through 100Ω to high-Z MCU; no PHY-pin pulls | High |
| PB14 | §2.1: `EXTREF_MON` (TIM12 capture of input B) | net `10MHz_CLK_OUT` (correct node, wrong/misleading name) | Low |
| PH0 | `OSC_IN` | net `CLK_OUT` | Low |
| PE4 | §6: `RB_SER_MODE` | net `RB_RS232_CMOS_SW` (same function) | Info |
| R44/PC12 | CLAUDE.md TODO: drop R44 (double pull-up) | R44 is Ethernet MDI 49.9Ω term; action stale | Info (close it) |

### Layout-critical constraints for these interfaces

| Net/class | Current est | Width/impedance | Placement / return path | Evidence |
|---|---|---|---|---|
| MDI TRD0/TRD1 pairs | signal | 100Ω diff, tight match | PHY↔J1 short, ground moat under magjack, R42–45+bypass near PHY | Microchip LAN8742A QFN checklist |
| RMII bus (REF_CLK + 8 sig) | signal | 50Ω SE, group-matched, REF_CLK guarded | PHY↔MCU, 50 MHz; series R31–34 near PHY | doc §1 |
| OCXO out→mux I0 (R123) | signal | 50Ω, source-term at Y3 | series term at driver; no rx-end R; C0G/film only on Vc path | CLAUDE.md, doc §2 |
| ext-ref 10 MHz island (3V0_RF) | signal | 50Ω to slicer | isolate RF island; D8/U49/U50 near SMA J8 | RF doc |
| GPS RF (1.5 GHz) | RF + 5 V bias | 50Ω | polymer ESD (L10) + bias-T (L1) at J7; GDT off-board | doc §3, gnss_antenna_bias doc |
| USB DP/DM | FS | 90Ω diff | short, ESD U18 at J5 | USB2.0 |
| PoE 48 V (VC taps→bridge) | up to ~0.6 A | wide, creepage | isolation/clearance per 802.3bt | doc §6 |

### Verified-good highlights
- I²C addressing straps correct: INA228 A0/A1 4-level on bus lines; U54=0x21 (A0→VS), U55=0x20 (A0→GND); INT pull-ups R199/R200/R201 + R198 EXP_RST present.
- USB-C is a correct UFP/sink: CC1/CC2 5.1k Rd, VBUS sense divider, reversible D± tie, shield RC.
- GNSS UART/PPS/control mapping matches doc 1:1 (PD8/PD9, PA0, PC6, PD11, PD15, PD7, PD6, PD5); V_USB grounded.
- LAN8742 MDI 49.9Ω→VDD and RBIAS 12.1k match the Microchip reference (initial "series-R-in-MDI" concern dismissed).
- Clock chain: Y3→R123→mux I0; slicer→R184→mux I1+PB14; mux Y→R187→PH0 and →U53 buffer→bench fanout. Topology sound.

Sources: [LAN8742A QFN Schematic Checklist (Microchip)](https://ww1.microchip.com/downloads/en/DeviceDoc/LAN8742A%20QFN%20Rev%20A%20Schematic%20Checklist.pdf), [LTC4311 datasheet (Analog Devices)](https://www.analog.com/media/en/technical-documentation/data-sheets/4311fa.pdf)

## 12–13. Pre-layout constraint package & KiCad rule suggestions

## Pre-Layout Constraint Package + KiCad Net-Class / Rule Suggestions — STS1000 "Meridian"

Scope: ready-for-layout constraints, not fab-ready. Currents are estimates from `peripheral_map §6` and subsystem docs; impedance/length-match targets need a board-house/field-solver pass once the stackup is fixed. Defaults assumed: 1 oz ext / 0.5 oz int Cu, 10–20 °C rise, FR-4, **stackup TBD**. Every Z, diff-pair geometry, and minimum-width-for-rise number below is flagged where it depends on copper weight / stackup that is not yet committed.

Evidence basis: `docs/ntp_server_peripheral_map.md §1–9`, `docs/sts1000_clock_mux.md §7`, `docs/ntp_server_rf_frontend.md §7`, `docs/gnss_antenna_bias_supervisor.md §3,10`, `docs/sts1000_vcc_rb_supply.md §1–4`, `hardware/CLAUDE.md` (layout-critical rules), netlist `ntp-server-stm32.net` (VOUT_P/VOUT_N/V_POE topology).

---

### 1) Net-class / constraint table

| Net / class | Function | Voltage | Est current | Min width | Clearance | Impedance | Length match | Return path | Layer pref | Placement / routing notes | Evidence / assumption |
|---|---|---|---|---|---|---|---|---|---|---|---|
| **POE_HV (VOUT_P, VOUT_N, V_POE)** | PoE PD output / intermediate rail into U28 MIC28516 main buck, U29, Rb buck, U10 INA228 IN+ | ~37–57 V (PD), VOUT_P after bridge | up to ~0.7 A in (25–30 W peak / ~48 V) | **≥0.4–0.5 mm** pour/poly, prefer plane fill | **≥0.5 mm air, ≥1.0 mm to LV/SELV nets** | n/a | n/a | adjacent plane, tight loop | Keep VOUT_P↔VOUT_N hot loop tiny; bulk caps C6/C7/C9/C11 (VOUT_N) + C8/C10/C75/C77/C80 (VOUT_P) at the bridge/PD; route as poured copper not traces | net `VOUT_P`/`VOUT_N` topology in netlist; `peripheral_map §6`; clearance is mains-adjacent practice (Low confidence on exact creepage — see blockers) |
| **PoE_MAGJACK_PAIRS (RMII MDI / center taps)** | 4 twisted pairs from RJ45 magjack center taps (Mode A+B) to FDMQ8205A bridges U7/U8 | PoE common-mode | per pair share of PD current | ≥0.3 mm | **isolation barrier: ≥1.5 mm primary-secondary, follow magjack pinout** | 100 Ω diff (MDI side) | match within pair | continuous plane under MDI; **plane cutout under the isolation gap only** | Bob Smith termination + common-mode caps at magjack; keep chassis/earth gap under the magjack | `checklist §8/§9`; isolation is standard Ethernet-PoE practice (Medium) |
| **BUCK_HOTLOOP_MAIN (U28 SW→L→Cout, Cin loop)** | MIC28516 main buck switching node | up to ~24 V swing | several A | wide poly, short | keep SW copper minimal | n/a | n/a | dedicated power-GND under loop | **Smallest possible Cin→FET→GND loop**; SW node small copper (EMI vs thermal trade); Cout close to inductor; boot cap C124-equiv at the pin | `checklist §9`, MIC28516 is a sync buck (Medium) |
| **BUCK_HOTLOOP_RB (U40A MIC28516 SW→L7→COUT)** | VCC_RB adjustable buck, 5–24 V @ ~1.5 A | up to 24 V | ~1.5 A steady, surge on Rb warm-up | wide poly | **VCC_RB rated ≥100 V parts; 0.5 mm clearance** | n/a | n/a | tight loop | COUT bank C126/C127/C128 (≥63 V); L7 40 µH; keep wiper/SPI noise off FB node (high-Z) | `vcc_rb_supply.md §1,2`; FB-node rule = `hardware/CLAUDE.md` (High) |
| **VCC_RB_OUTPUT** | Rb supply to FE-5680A connector | 5–24 V (15 V nom) | ~1.5 A | ≥0.5 mm | **0.5 mm; TVS D7 1.5SMCJ28A at connector** | n/a | n/a | adjacent GND | OV latch (U41A) trip @26 V autonomous; D7 at connector pads; R159 shunt Kelvin (see below) | `vcc_rb_supply.md §1,4` (High) |
| **SHUNT_KELVIN (INA228 ×8, INA181)** | current-sense shunts R16/R126 25 m, R72/R106 500 m, R89/R107 100 m, R30 150 m, R102 75 m, R159 20 m; R77 3.3 Ω (INA181) | per rail | per rail | **wide power in/out; Kelvin sense traces thin** | std | n/a | match the two sense traces | **4-terminal Kelvin: IN+/IN− tap the pads symmetrically, never the power copper**; INA181 IN+ on V_ANT/upstream side of R77, IN− load side (reversed = reads 0) | `bom.md` SHUNT-REVIEW list; INA181 orientation = `antenna_supervisor §10` (High) |
| **RMII_BUS (RXD0/1, TXD0/1, TX_EN, CRS_DV, REF_CLK, MDC, MDIO)** | LAN8742 ↔ STM32 RMII, AF11 | 3.3 V | logic | ≥0.15 mm | std | ~50 Ω single-ended (TBD stackup) | **REF_CLK is the critical net; group-match TXD/RXD/CRS_DV to within ~±25 mm of REF_CLK** | continuous GND under all RMII | inner/adjacent-to-plane | Keep REF_CLK (PA1) short, single load; MDIO 1.5 kΩ pull-up to VDDIO; PB10 RXER/PHYAD0 strap kept high-Z thru reset | `peripheral_map §1`; RMII is source-synchronous so loose match OK (Medium) |
| **USB_DP/DM (PA11/PA12)** | USB-FS device console | 3.3 V diff | logic | per 90 Ω geom | std + guard | **90 Ω differential** (TBD stackup) | **intra-pair ≤ ~5 mm** | continuous GND, no split | Short stub, ESD array at connector, away from switchers; series Rs only if host needs | `peripheral_map §10`; 90 Ω USB std (High intent / Medium geometry) |
| **GPS_RF (SMA → bias-T → ZED-F9T RF_IN)** | 1.575 GHz GNSS RF + 5 V DC bias | RF + 5 V | RF + ≤180 mA bias | **50 Ω geometry** | guard ring | **50 Ω single-ended** (TBD stackup) | n/a | **continuous unbroken GND, via-fence the trace** | L1 56 nH bias-T choke (>500 Ω @ L1 band); ESD must be **Cj ≤0.2–0.3 pF polymer + separate coaxial GDT for outdoor run** (standard clock-line ESD fails RF+bias) | `antenna_supervisor §3`; ESD = `hardware/CLAUDE.md` (High) |
| **REF_RF_10M (10MHz_RF_IN SMA → N1 → comparator)** | external 10 MHz reference, sine/CMOS | ≤±7 Vpk transient | µA–mA | 50 Ω geom | guard | **50 Ω SMA→N1** (TBD) | n/a | **one continuous plane SMA→comparator→mux, NO split / star / bridge** | R177 close to N1; D11 (SZESD7410) at SMA pads; C149 immediately after; stitch GND vias along the 50 Ω trace and around U50 | `rf_frontend.md §7` (High) |
| **CLK_PH0 (mux Y → R187 → PH0)** | HSE-bypass clock into STM32 OSC_IN | 3.3 V CMOS 10 MHz | logic | ≥0.15 mm | guard | controlled, short | n/a | **continuous GND under CLK_OUT to STM32** | U52 adjacent to PH0; keep Y→R187→PH0 short & direct; U52 GND = pin 2 only | `clock_mux.md §7` (High) |
| **REF_CLK_NODES (OCXO_CLK_OUT, 10MHz_CLK_OUT, mux Y node)** | OCXO & ext-ref squares into mux | 3.0 V CMOS | logic | ≥0.15 mm | guard | source-term at driver (R98/R123 22 Ω, R144 33 Ω) | n/a | continuous plane | **No receiver-end series R** (term at driver only); keep input stubs short | `clock_mux.md §2,7`; `hardware/CLAUDE.md` (High) |
| **BENCH_10M_OUT (U53 → R189 → C160 → SMA)** | 50 Ω bench fanout | 3.3 V CMOS | 50 Ω load | 50 Ω geom | guard | **50 Ω** | n/a | continuous GND, steer away from PH0 | D16 SZESD7410 at SMA pads; isolated buffer U53 so SMA load never reaches PH0 | `clock_mux.md §3.3,7` (High) |
| **OCXO_VC (PA4 DAC → loop filter → Vc pin1; PA3 sense)** | OCXO steering voltage, ultra-sensitive analog | 0.3–3.0 V (center 1.65 V) | µA | ≥0.2 mm | **guard / quiet analog region** | n/a | n/a | quiet analog GND, away from SW nodes | **Vc-path caps C0G/NP0 or film — NEVER X7R** (microphonic FM); never leave Vc floating; keep loop filter away from bucks/digital | `peripheral_map §2`; `hardware/CLAUDE.md` (High) |
| **RB_FB_NODE (U40A FB: R147/R148/R144/C125/R134)** | Rb buck feedback, high-impedance | ~0.6 V | µA | thin, short | guard | n/a | n/a | quiet GND | **Keep digipot wiper / SPI switching noise off this node**; fixed bounding R147/R148 set absolute V envelope; place R147/R148/R134/C125 tight to FB pin | `vcc_rb_supply.md §1,2`; `hardware/CLAUDE.md` (High) |
| **LSE_XTAL (PC14/PC15, Y2 32.768 kHz)** | RTC crystal | low | µA | short, guard ring | **guard ring + GND island under xtal** | n/a | match the two legs | local guarded GND, no signals under | Load caps tight; keep away from switchers and clock nets | `checklist §1` (High) |
| **HSE_XTAL_PHY (Y1 25 MHz @ U11)** | PHY reference crystal | 3.3 V | µA | short | guard ring | n/a | match legs | local GND island | Load caps at xtal pins; short legs | `checklist §8` (Medium) |
| **NOISY_SW / FAN / BL_PWM (FAN_PWM PE5, DISP_BL PE6, RGB PD12-14)** | PWM / switching control | 3.3 V | logic | ≥0.15 mm | std | n/a | n/a | keep off sensitive analog | Route FAN_PWM, BL PWM away from OCXO_VC / REF_VMID / ADC sense nets | `peripheral_map §8` (Medium) |
| **ADC_SENSE (PA6, PB1 SOC; PA3 Vc)** | supercap SOC + Vc analog inputs | ≤3.3 V | µA | ≥0.2 mm | guard | n/a | n/a | quiet analog GND | /2 dividers near MCU; keep away from SW/PWM; star to AGND if used | `peripheral_map §7` (High) |
| **I2C1_BUS (PB8 SCL / PB9 SDA, ~15 nodes)** | housekeeping I²C, 400 kHz | 3.3 V | logic | ≥0.15 mm | std | n/a | n/a | continuous GND | LTC4311 accelerator (U56) + single pull-up pair; keep total Cb in budget; route as a spine, short stubs to each device | `peripheral_map §4` (High) |
| **SPI4_BUS (PE11-14 + CS PE9/PD2/PE11, ~20–40 MHz)** | NOR + TFT + digipot | 3.3 V | logic | ≥0.15 mm | std | controlled if long | group SCK/MOSI loosely | continuous GND | TFT branch gets R210/R211 22 Ω series; keep SCK clean to NOR; digipot CS noise off FB | `peripheral_map §5`, `checklist §13` (Medium) |
| **MAG_GNDPOUR (under U61 IIS2MDC)** | magnetometer keep-out | n/a | **no DC current** | n/a | n/a | n/a | n/a | **continuous current-free GND pour, NO void, NO routed return** | Balanced go+return only; place U61 far from Rb/OCXO/bucks/PoE magnetics/fan; board edge/corner or external puck | `peripheral_map §4`; `hardware/CLAUDE.md` (High) |
| **SUPERCAP_THERMAL (DSF305Q3R0 ×2)** | backup energy | 2.55 V peak | charge/discharge A | wide | std | n/a | n/a | adjacent GND | **Placement ≤ ~75 °C** (2.5 V/85 °C derate at 2.55 V); keep away from Rb/OCXO ovens, bucks, bridge | `hardware/CLAUDE.md`; `peripheral_map §14` (High) |
| **PROG_DEBUG (PA13 SWDIO, PA14 SWCLK, PB3 SWO, NRST)** | SWD/trace header | 3.3 V | logic | ≥0.2 mm | std | SWCLK short | n/a | GND adjacent, ground pin on header | Place header accessibly; series R / pull on SWCLK optional; NRST cap | `peripheral_map §10` (High) |
| **TEST_POINTS (per subsystem docs)** | bring-up taps | various | n/a | n/a | n/a | n/a | n/a | n/a | RF: N1, N2, REF_VMID, 3V0_RF, U50 VCC, 10MHz_CLK_OUT (`rf_frontend §7`); mux: Y, CLK_OUT, 10MHz_RF_OUT, 3V3_CLK (`clock_mux §7`) | docs (High) |

---

### 2) Decoupling / placement-critical table

| RefDes | Related IC / net | Purpose | Must be close to | Max distance | Priority | Notes |
|---|---|---|---|---|---|---|
| C158 | U52 74LVC1G157 VCC pin5 | mux supply decouple | U52 pin 5 | <2 mm | High | `clock_mux §3.5` |
| C159 | U53 74LVC1G34 VCC pin5 | fanout buf decouple | U53 pin 5 | <2 mm | High | `clock_mux §3.5` |
| C157 + FB10 | 3V3_CLK rail entry | bulk + isolation | FB10 output | <5 mm | High | VDD-domain only, ≤VDD so PH0 not over-driven |
| C134/C137, FB9 | U51 LT3045 (RF island) Cin/Cout | low-noise island | U51 in/out pins | <3 mm | High | `rf_frontend §4.7` |
| R186, R185 (Kelvin GND) | U51 LT3045 SET/ILIM | reference accuracy | route GND back to U51 GND pin | device-level | High | LT3045 Kelvin requirement, same plane (`rf_frontend §7`) |
| 0.1 µF + 1 µF | U50 LTC6752 VCC pin5 (+ R143/D14) | comparator supply | U50 pin 5 | <2 mm | High | abs-max guard tight to pin (`rf_frontend §4.6`) |
| REF_VMID 0.1 µF | U50 −IN / R142 | threshold bias | U50 | <3 mm | High | `rf_frontend §4.6` |
| C149 | 10MHz_RF_IN | DC block | immediately after SMA/D11 | <3 mm | High | `rf_frontend §7` |
| C52, C61, FB4 | bias-T node A / V_ANT | RF return + decouple | L1 / antenna feed node | <3 mm | High | `antenna_supervisor §3` |
| OCXO Vc caps | PA4 loop filter / Vc | steering integrity | OCXO Vc pin | <5 mm | Critical | C0G/NP0/film only, never X7R (`hardware/CLAUDE.md`) |
| C115 (2.2 µF), C120 | U45 MCP1502-40 ref out / OV ref node | ref stability | U45 OUT / OV (−) node | <3 mm | High | `vcc_rb_supply §2,4` |
| C124 (boot), Cin | U40A MIC28516 BST / VIN | buck operation | U40A pins | <2 mm | High | hot-loop critical (`vcc_rb_supply §2`) |
| C126/127/128 | VCC_RB COUT | output bulk | L7 output | <5 mm | High | ≥63 V, DC-bias derate |
| Cin/Cout banks | U28/U29 main bucks | hot loop | FET/inductor | <2 mm | Critical | smallest Cin→FET→GND loop |
| INA228 ×8 0.1 µF (VS) | each INA228 VS pin | sensor supply | each INA pin | <2 mm | Medium | all on 3V3_STM |
| C28–C31 bank | U24 INA181 / U25 LMV393 | supervisor decouple | each V+ pin | <2 mm | Medium | `antenna_supervisor §11` |
| Load caps | Y2 LSE 32.768 kHz | xtal stability | PC14/PC15 pins | <3 mm | High | guard ring + GND island |
| Load caps | Y1 PHY 25 MHz | xtal stability | U11 xtal pins | <3 mm | High | short legs |
| VDD/VDDA + VREF+ caps | U12 STM32 each supply pin | MCU decouple | each VDD/VDDA pin | <2 mm | Critical | one cap per supply pin + bulk |
| C160 | bench fanout | DC block | after R189 → SMA | <5 mm | Medium | `clock_mux §3.3` |
| U56 LTC4311 | I2C1 SCL/SDA | rise-time accel | near bus midpoint/load | placement | Medium | `peripheral_map §4` |

---

### 3) Suggested KiCad net classes + custom rules

| Net class | Nets (examples) | Width | Clearance | Via | DiffPair W/G | Z target | Length match | Notes |
|---|---|---|---|---|---|---|---|---|
| `PoE_HV` | VOUT_P, VOUT_N, V_POE | ≥0.5 mm (poly/plane) | **≥0.5 mm air; ≥1.0 mm to SELV** | large / multiple | — | — | — | **Needs creepage confirmation (PD output voltage class) + Cu weight for current.** Stackup-dependent. |
| `PoE_ISO` | magjack center-tap pairs, primary side of FDMQ8205A | ≥0.3 mm | **isolation barrier per magjack pinout (≥1.5 mm)** | — | 100 Ω | within pair | — | **Mechanical/creepage confirmation required.** |
| `Power_Buck` | SW nodes, VCC_RB out, 5V, 3V3 mains | ≥0.4 mm (current-dependent) | 0.3 mm | thermal/multiple | — | — | — | **Width needs Cu weight + 10–20 °C rise calc once stackup set.** |
| `Shunt_Kelvin` | INA228/INA181 IN+/IN− sense pairs | thin sense, wide power | std | — | route as pair | — | match sense legs | Kelvin tap at pad, not power copper. Shunt values still **SHUNT-REVIEW (TBD)**. |
| `RF_50` | 10MHz_RF_IN, 10MHz_RF_OUT, GPS_RF_IN | per 50 Ω geom | guard | via-fence | — | **50 Ω SE** | — | **Z needs field-solver + stackup.** Continuous unbroken GND. |
| `DiffPair_USB` | USB_DP/DM | per geom | guard | — | per 90 Ω | **90 Ω diff** | intra-pair ≤5 mm | **Geometry needs stackup.** |
| `DiffPair_MDI` | RMII MDI pairs (magjack side) | per geom | std | — | per 100 Ω | **100 Ω diff** | within pair | **Geometry needs stackup.** |
| `Clk_CMOS` | OCXO_CLK_OUT, 10MHz_CLK_OUT, CLK_OUT, mux Y | ≥0.15 mm | guard | — | — | source-term @ driver | — | No receiver-end series R; short; continuous GND. |
| `Clk_RMII` | RMII_REF_CLK (PA1) + RMII data group | ≥0.15 mm | std | — | — | ~50 Ω | group ±25 mm to REF_CLK | Source-synchronous; loose match OK. |
| `Analog_Quiet` | OCXO_VC, RB_FB, REF_VMID, ADC sense (PA3/PA6/PB1) | ≥0.2 mm | guard | — | — | — | — | Away from SW/PWM; quiet AGND; Vc caps C0G/film only. |
| `Xtal` | LSE (PC14/15), PHY 25 MHz | short | guard ring | — | — | — | match legs | GND island under, no signals beneath. |
| `I2C_400k` | I2C1 SCL/SDA | ≥0.15 mm | std | — | — | — | — | LTC4311 + single pull-up pair; bus spine. |
| `Debug` | SWDIO/SWCLK/SWO/NRST | ≥0.2 mm | std | — | — | — | — | SWCLK short; accessible header. |
| `Default` | everything else | ≥0.15 mm | 0.15 mm | std | — | — | — | Baseline. |

**Rules that explicitly need confirmation before they can be finalized:**
- **All impedance targets** (`RF_50`, `DiffPair_USB`, `DiffPair_MDI`, `Clk_RMII`) — require committed **stackup + field-solver / board-house** numbers. Geometry placeholder only.
- **All current-driven widths** (`PoE_HV`, `Power_Buck`) — require committed **copper weight** + the 10–20 °C rise target to compute via IPC-2152.
- **`PoE_HV` / `PoE_ISO` clearance & creepage** — require the **PD-side voltage class and isolation/safety requirement** (is the PD front end isolated? `peripheral_map §14` open item: NCL/NCM/LCF direction & "digital isolator required only if PD front end is isolated"). This drives both the magjack isolation gap and the HV net clearance.
- **Magnetometer keep-out geometry** (`B = (μ₀/2π)·I/r`) — needs the worst-case adjacent DC-rail current and the acceptable field at the sensor to size the keep-out radius.

---

### Design-intent mismatches (doc-vs-doc / doc-vs-schematic to resolve before layout)

| Ref | Doc says | Schematic / other doc says | Severity |
|---|---|---|---|
| OCXO source term | `clock_mux.md` cites **R98** (and "R123" in one place) as OCXO 22 Ω source term; `hardware/CLAUDE.md` & `checklist §2` say **R123** | Designator collision unresolved (TODO marker in clock_mux) | Medium — confirm the real refdes before placing the term resistor |
| Bias-T choke | `antenna_supervisor §3` body says **L1 = 56 nH**; `checklist §7` and `hardware/CLAUDE.md` say **L1 47 nH** | Value mismatch (56 nH gives the cited 554 Ω @ 1.575 GHz; 47 nH does not) | High — wrong value changes RF isolation; resolve before layout |
| RF front-end designators | `rf_frontend.md` carries an explicit unresolved old→new designator remap (C133–C137, R134–R147, D11–D15) | Re-annotated schematic refs not confirmed 1:1 | Medium — refdes ambiguity blocks placement/BOM cross-check |
| R44 at PC12 | `peripheral_map §4` / checklist: "drop legacy R44 (double pull-up)" | `hardware/CLAUDE.md` TODO: "R44 is now a 49.9 Ω Ethernet PHY term; only R199 remains" | Low — verify R44 is not a stray second INA_ALERT pull-up |
| PG_IN_N net label | checklist/peripheral_map: fix `PG_IN_N`→`PG_INT_N` (one-pin net otherwise) | `hardware/CLAUDE.md` TODO marks it already `PG_INT_N` | Low — confirm in netlist |
| INA_ALERT_N dangling | `net_naming.md`: `INA_ALERT_N` is a **1-pin dangling net** defect on the MCU, should merge into `INA_ALERT_INT_N` | present in netlist | Medium — a 1-pin net = missing connection; fix before layout |

This is a constraint/rule package; it does not re-verify every IC pinout (that is the IC-by-IC review's job). The blockers below are the items that must be answered before net classes can be turned into final DRC rules.
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
