rcldesign/ntp-server-stm32/docs/sts1000_net_naming.md

# STS1000 Net / Rail Naming Convention

Canonical naming rules for schematic net labels (KiCad **global labels**) and power
rails (KiCad **power-symbol Value**). Net names in firmware/devicetree and in every doc
**must** match these. A net that drifts from this convention is a defect.

---

## Rules

| Class | Rule | Examples |
|---|---|---|
| **Supply rails** | Voltage-first, **no `+`**, **no decimal point** (`3V3`, `3V0`, `5V`). Optional `_<domain>` suffix. | `3V3`, `3V3_STM`, `3V0_RF`, `5V`, `5V_DISP` |
| **Functional rails** | Keep the functional name where the rail is a distinct domain, not a generic logic supply. | `VCC_RB`, `V_ANT`, `V_POE`, `VDDA`, `VAUX`, `VREF_3V0`, `VREF_3V3`, `GPS_VBAT`, `STM_VBAT`, `OCXO_V`, `OCXO_VC`, `VOUT_P/N`, `GND` |
| **Active-low** | `_N` **suffix** (never `n`-prefix, never `~{}`), applied where the part datasheet defines the pin active-low. STM32 core reset keeps the ST name `MCU_NRST`. | `GPS_RST_N`, `LAN_RST_N`, `NOR_RST_N`, `GPS_SAFEBOOT_N`, `WDO_N`, `MCU_NRST` — **but see the RT9742 nFLG deviation below** |
| **Reset** | `RST`, not `RESET`. | `GPS_RST_N`, `LAN_RST_N`, `NOR_RST_N` |
| **Power-good** | `<rail>[_<stage>]_PG`. Keep the `_PSU_` (switcher) / `_LDO_` (linear) stage qualifier **only** where a rail has two distinct PG nets. | `3V3_PSU_PG`, `5V_PSU_PG`, `OCXO_PSU_PG`, `OCXO_LDO_PG`, `3V3_GPS_LDO_PG`, `3V0_RF_LDO_PG`, `RB_PSU_PG`, `POE_PG` |
| **INA228 alert** | `INA_ALERT_<rail>` using the unified rail name; **no `_N` suffix** (deliberate). Each INA228 alert lands on its own MCU GPIO — there is **no** wire-OR aggregate net. | `INA_ALERT_3V3`, `INA_ALERT_3V3_STM`, `INA_ALERT_5V_DISP`, `INA_ALERT_5V_PANEL`, `INA_ALERT_OCXO`, `INA_ALERT_VCC_RB`, `INA_ALERT_V_ANT`, `INA_ALERT_V_POE`, `INA_ALERT_3V3_GPS` |
| **Differential / split pairs** | `_P` / `_N` suffix. | `TRD0_P/N`, `TRD1_P/N`, `VOUT_P/N` |
| **Bus prefixes** | Subsystem prefix retained. | `RMII_*`, `SPI_*`, `I2C_*`, `GPS_*`, `RB_RS232_*`, `DISP_*`, `POE_*`, `WDT_*` |

---

## Conventions in practice — exceptions and near-collisions

These are the deliberate departures from a naive reading of the rules; each is intentional
and must be preserved:
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
