rcldesign/ntp-server-stm32/docs/sts1000_panel_controls.md

# STS1000 "Meridian" — Front-Panel Controls (7 buttons + optical encoder)

**Subsystem design record.** Defines the front-panel human-input set: one **optical incremental
encoder** (quadrature A/B + integral push switch) and **seven momentary buttons**. The
capacitive touchscreen (FT6336U) remains the **primary** interaction and wake surface; the
physical controls are the **no-look / dead-screen / dark-site** path and must remain useful when
the panel is blanked or the touch layer has failed.

**Canonical authority:** `ntp_server_peripheral_map.md` §8 (UI pins/rails) and §6 (power domains)
are authoritative; fault/UI aggregation is a direct-GPIO scan per `sts1000_fault_aggregation.md`.
This record holds the control-map decisions and rationale.

**Design intent:** no buzzer exists in the BOM — all alarming is **visual** (RGB status LED, PD12–
PD14 / TIM4) plus network (SNMP). No "silence" function is assigned. Holdover-force and reference-
source override are **not** front-panel functions; they live in the touchscreen menu and web UI
only, leaving **RESET** as the sole timing-perturbing physical control.

---
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
