rcldesign/ntp-server-stm32/hardware/ntp-server-stm32/ntp-server-stm32.kicad_pcb

## KiCad design hardware/ntp-server-stm32/ntp-server-stm32.kicad_pcb (2026-08-06)

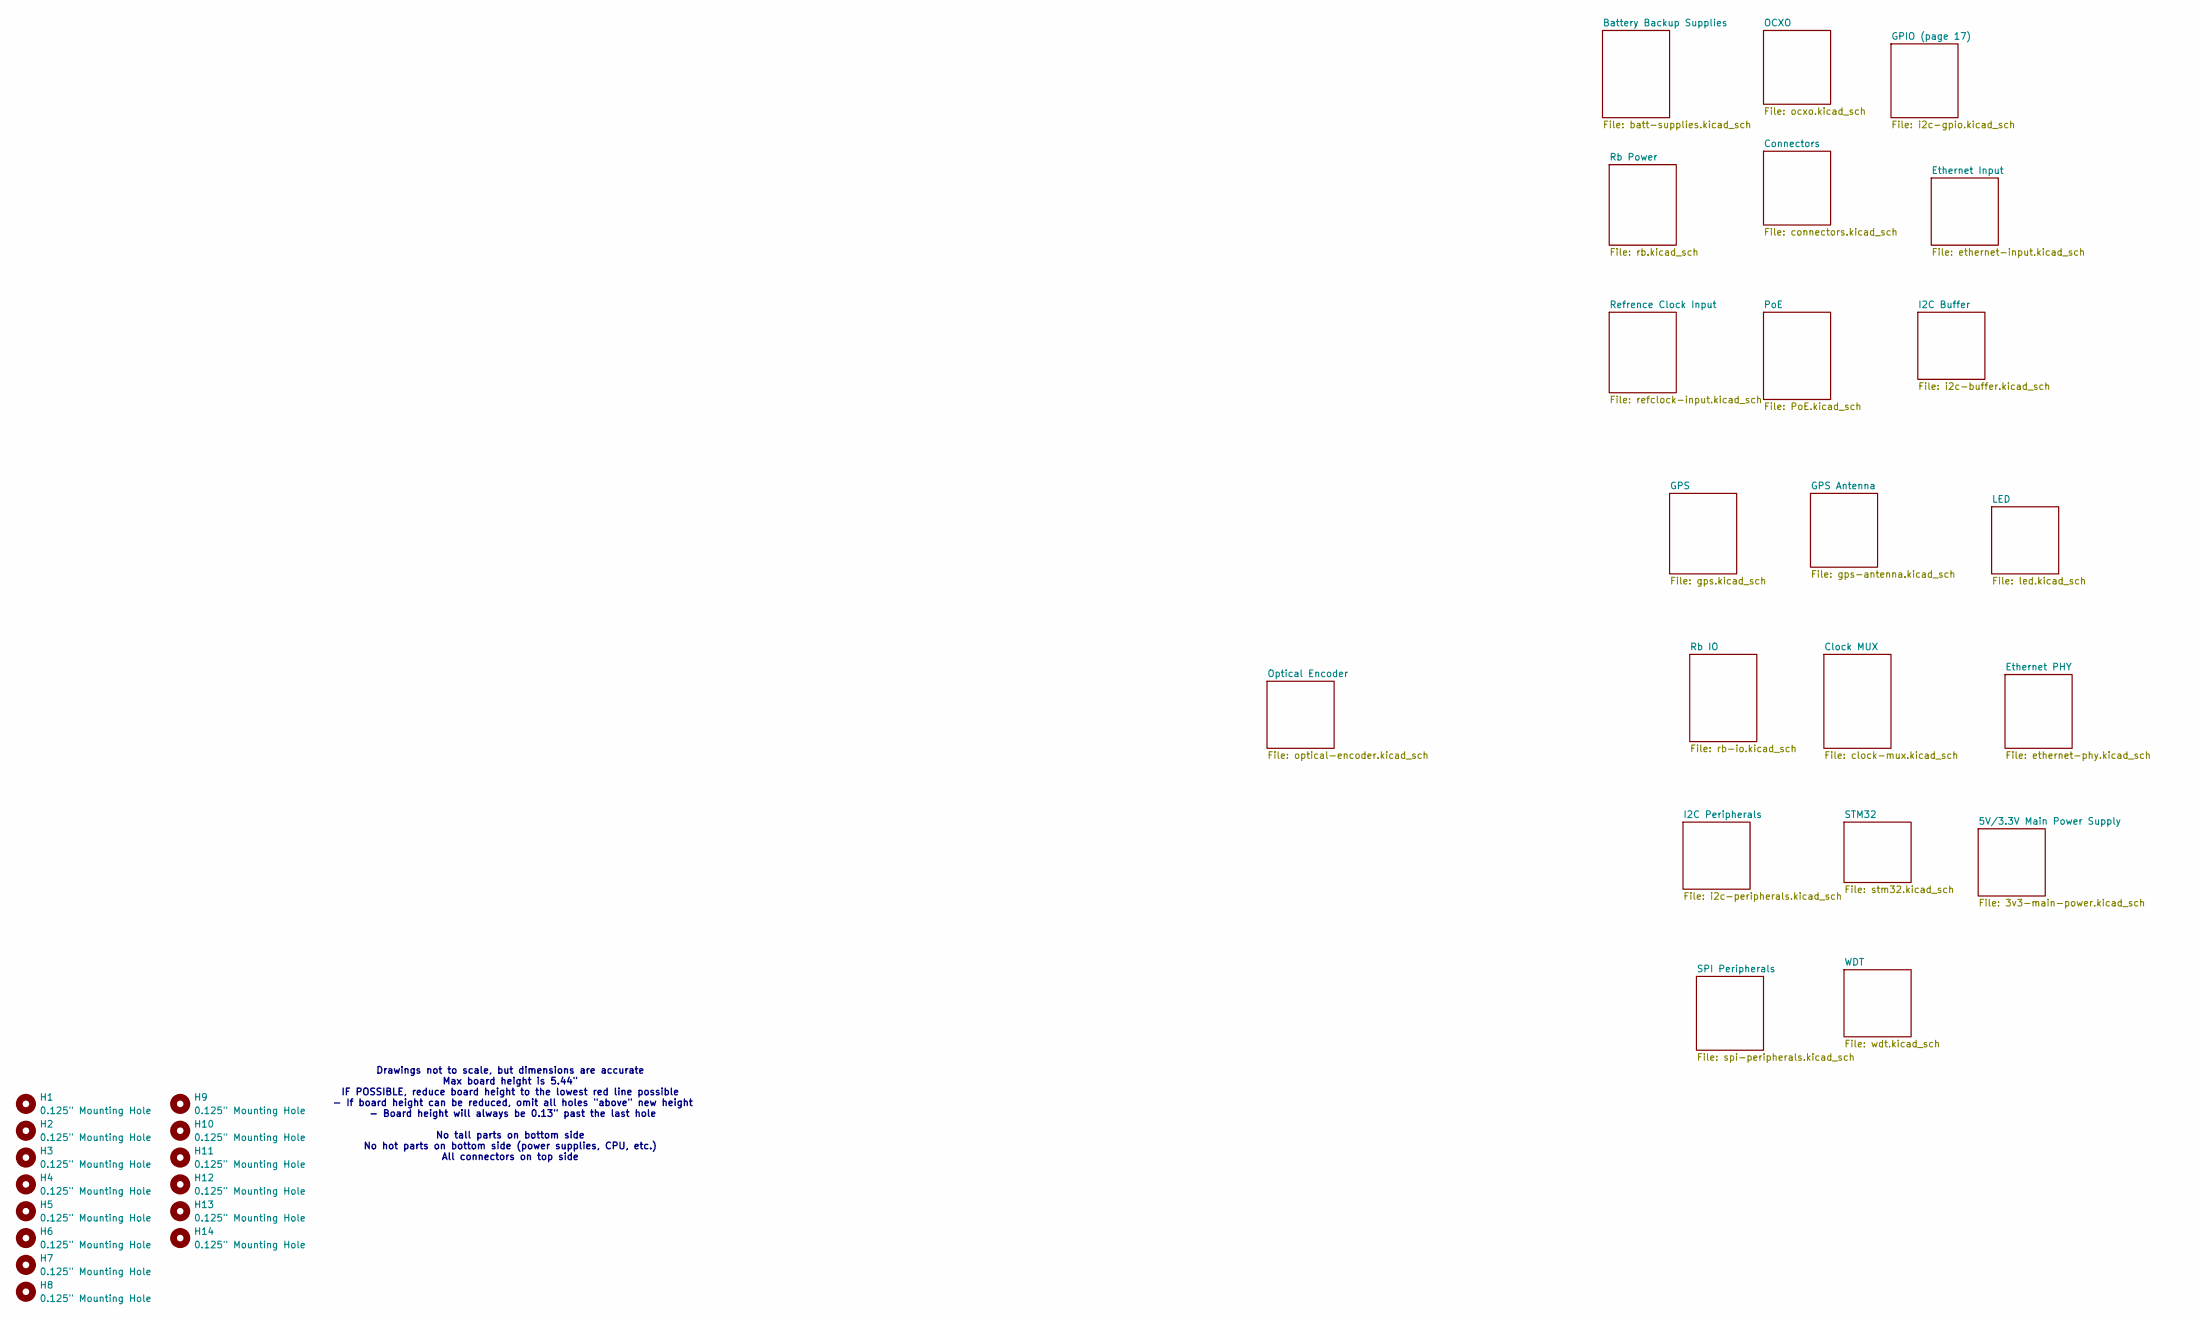
[picture p1: schematic ntp-server-stm32.kicad_sch]

Parts:
H1, H2, H3, H4, H5, H6, H7, H8, H9, H10, H11, H12, H13, H14: 0.125" Mounting Hole; MountingHole_3.2mm_M3

Connections:
GND: H1.1; also elsewhere on the board

Notes on the sheet:
Drawings not to scale, but dimensions are accurate Max board height is 5.44" IF POSSIBLE, reduce board height to the lowest red line possible - If board height can be reduced, omit all holes "above" new height - Board height will always be 0.13" past the last hole No tall parts on bottom side No ho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

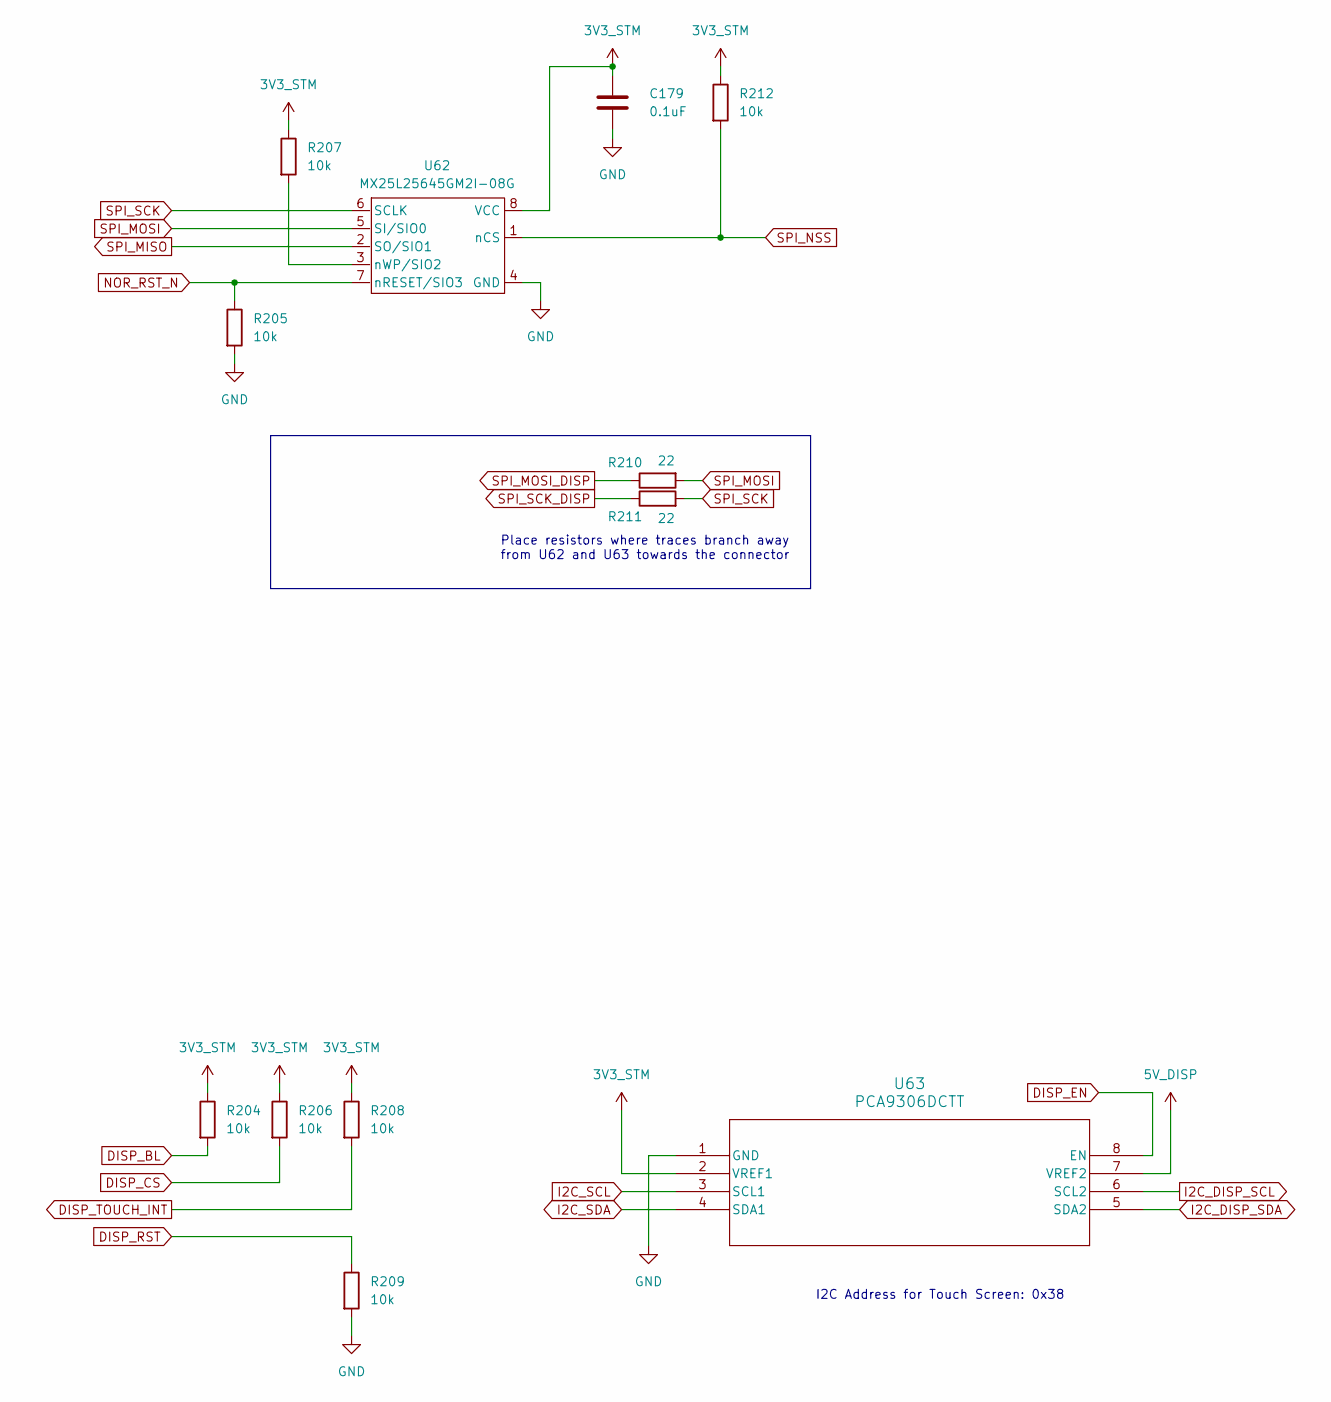
[picture p2: schematic spi-peripherals.kicad_sch]

Parts:
C179: 0.1uF; C_0402_1005Metric; TOLERANCE 10%; VOLTAGE 16V; MANUFACTURER_PART_NUMBER GCM155R71C104KA55D; DIGIKEY_PART_NUMBER 490-4759-1-ND
R204, R205, R206, R207, R208, R209, R212: 10k; R_0402_1005Metric; TOLERANCE 1%; MANUFACTURER_PART_NUMBER ERJ-2RKF1002X; DIGIKEY_PART_NUMBER P10.0KLCT-ND
R210, R211: 22; R_0402_1005Metric; TOLERANCE 1%; MANUFACTURER_PART_NUMBER ERJ-2RKF22R0X; DIGIKEY_PART_NUMBER P22.0LCT-ND
U62: MX25L25645GM2I-08G; SOIC-8_3.9x4.9mm_P1.27mm; MANUFACTURER_PART_NUMBER MX25L25645GM2I-08G; DIGIKEY_PART_NUMBER 1092-1234-ND
U63: PCA9306DCTT; DCT8; MANUFACTURER_PART_NUMBER PCA9306DCTT; DIGIKEY_PART_NUMBER 296-32200-1-ND

Connections:
3V3_STM: C179.1, R204.1, R206.1, R207.1, R208.1, R212.1, U62.8 (VCC), U63.2 (VREF1); also elsewhere on the board
5V_DISP: U63.7 (VREF2); also elsewhere on the board
DISP_BL: R204.2; also elsewhere on the board
DISP_CS: R206.2; also elsewhere on the board
DISP_EN: U63.8 (EN); also elsewhere on the board
DISP_RST: R209.1; also elsewhere on the board
DISP_TOUCH_INT: R208.2; also elsewhere on the board
GND: C179.2, R205.2, R209.2, U62.4 (GND), U63.1 (GND); also elsewhere on the board
I2C_DISP_SCL: U63.6 (SCL2); also elsewhere on the board
I2C_DISP_SDA: U63.5 (SDA2); also elsewhere on the board
I2C_SCL: U63.3 (SCL1); also elsewhere on the board
I2C_SDA: U63.4 (SDA1); also elsewhere on the board
NOR_RST_N: R205.1, U62.7 (nRESET/SIO3); also elsewhere on the board
unnamed: R207.2, U62.3 (nWP/SIO2)
SPI_MISO: U62.2 (SO/SIO1); also elsewhere on the board
SPI_MOSI: R210.2, U62.5 (SI/SIO0); also elsewhere on the board
SPI_MOSI_DISP: R210.1; also elsewhere on the board
SPI_NSS: R212.2, U62.1 (nCS); also elsewhere on the board
SPI_SCK: R211.2, U62.6 (SCLK); also elsewhere on the board
SPI_SCK_DISP: R211.1; also elsewhere on the board

Notes on the sheet:
Place resistors where traces branch away from U62 and U63 towards the connector
I2C Address for Touch Screen: 0x38

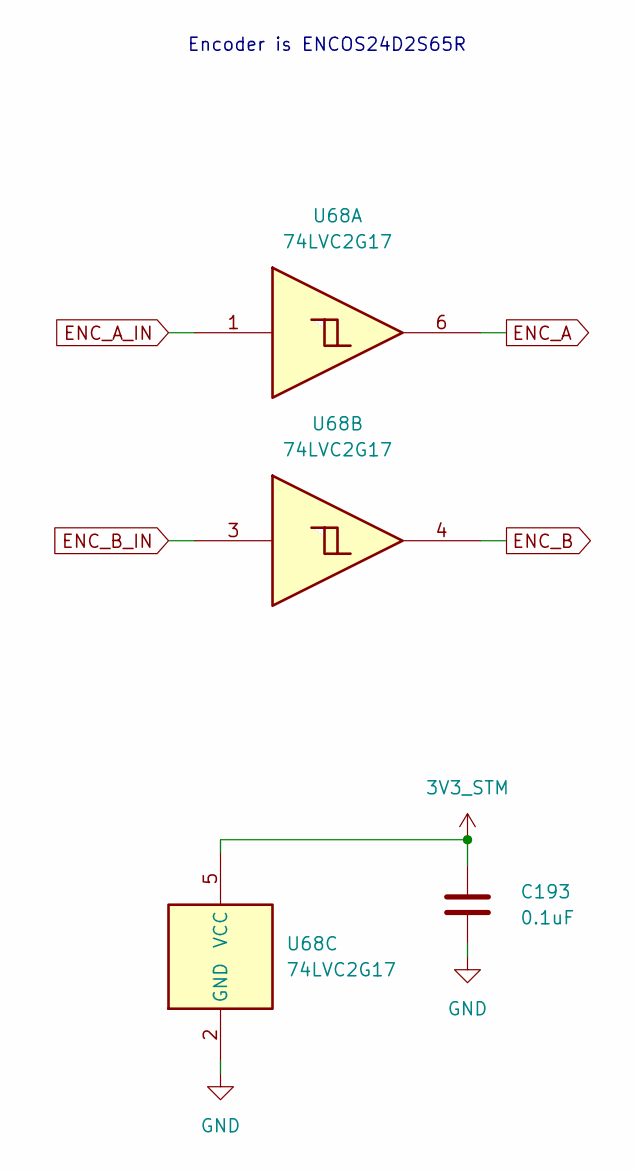
[picture p3: schematic optical-encoder.kicad_sch]

Parts:
C193: 0.1uF; C_0402_1005Metric; TOLERANCE 10%; VOLTAGE 16V; MANUFACTURER_PART_NUMBER GCM155R71C104KA55D; DIGIKEY_PART_NUMBER 490-4759-1-ND
U68: 74LVC2G17; 74LVC2G17GW,125; MANUFACTURER_PART_NUMBER 74LVC2G17GW,125; DIGIKEY_PART_NUMBER 1727-4218-1-ND

Connections:
3V3_STM: C193.1, U68.5 (VCC); also elsewhere on the board
ENC_A: U68.6; also elsewhere on the board
ENC_A_IN: U68.1; also elsewhere on the board
ENC_B: U68.4; also elsewhere on the board
ENC_B_IN: U68.3; also elsewhere on the board
GND: C193.2, U68.2 (GND); also elsewhere on the board

Notes on the sheet:
Encoder is ENCOS24D2S65R

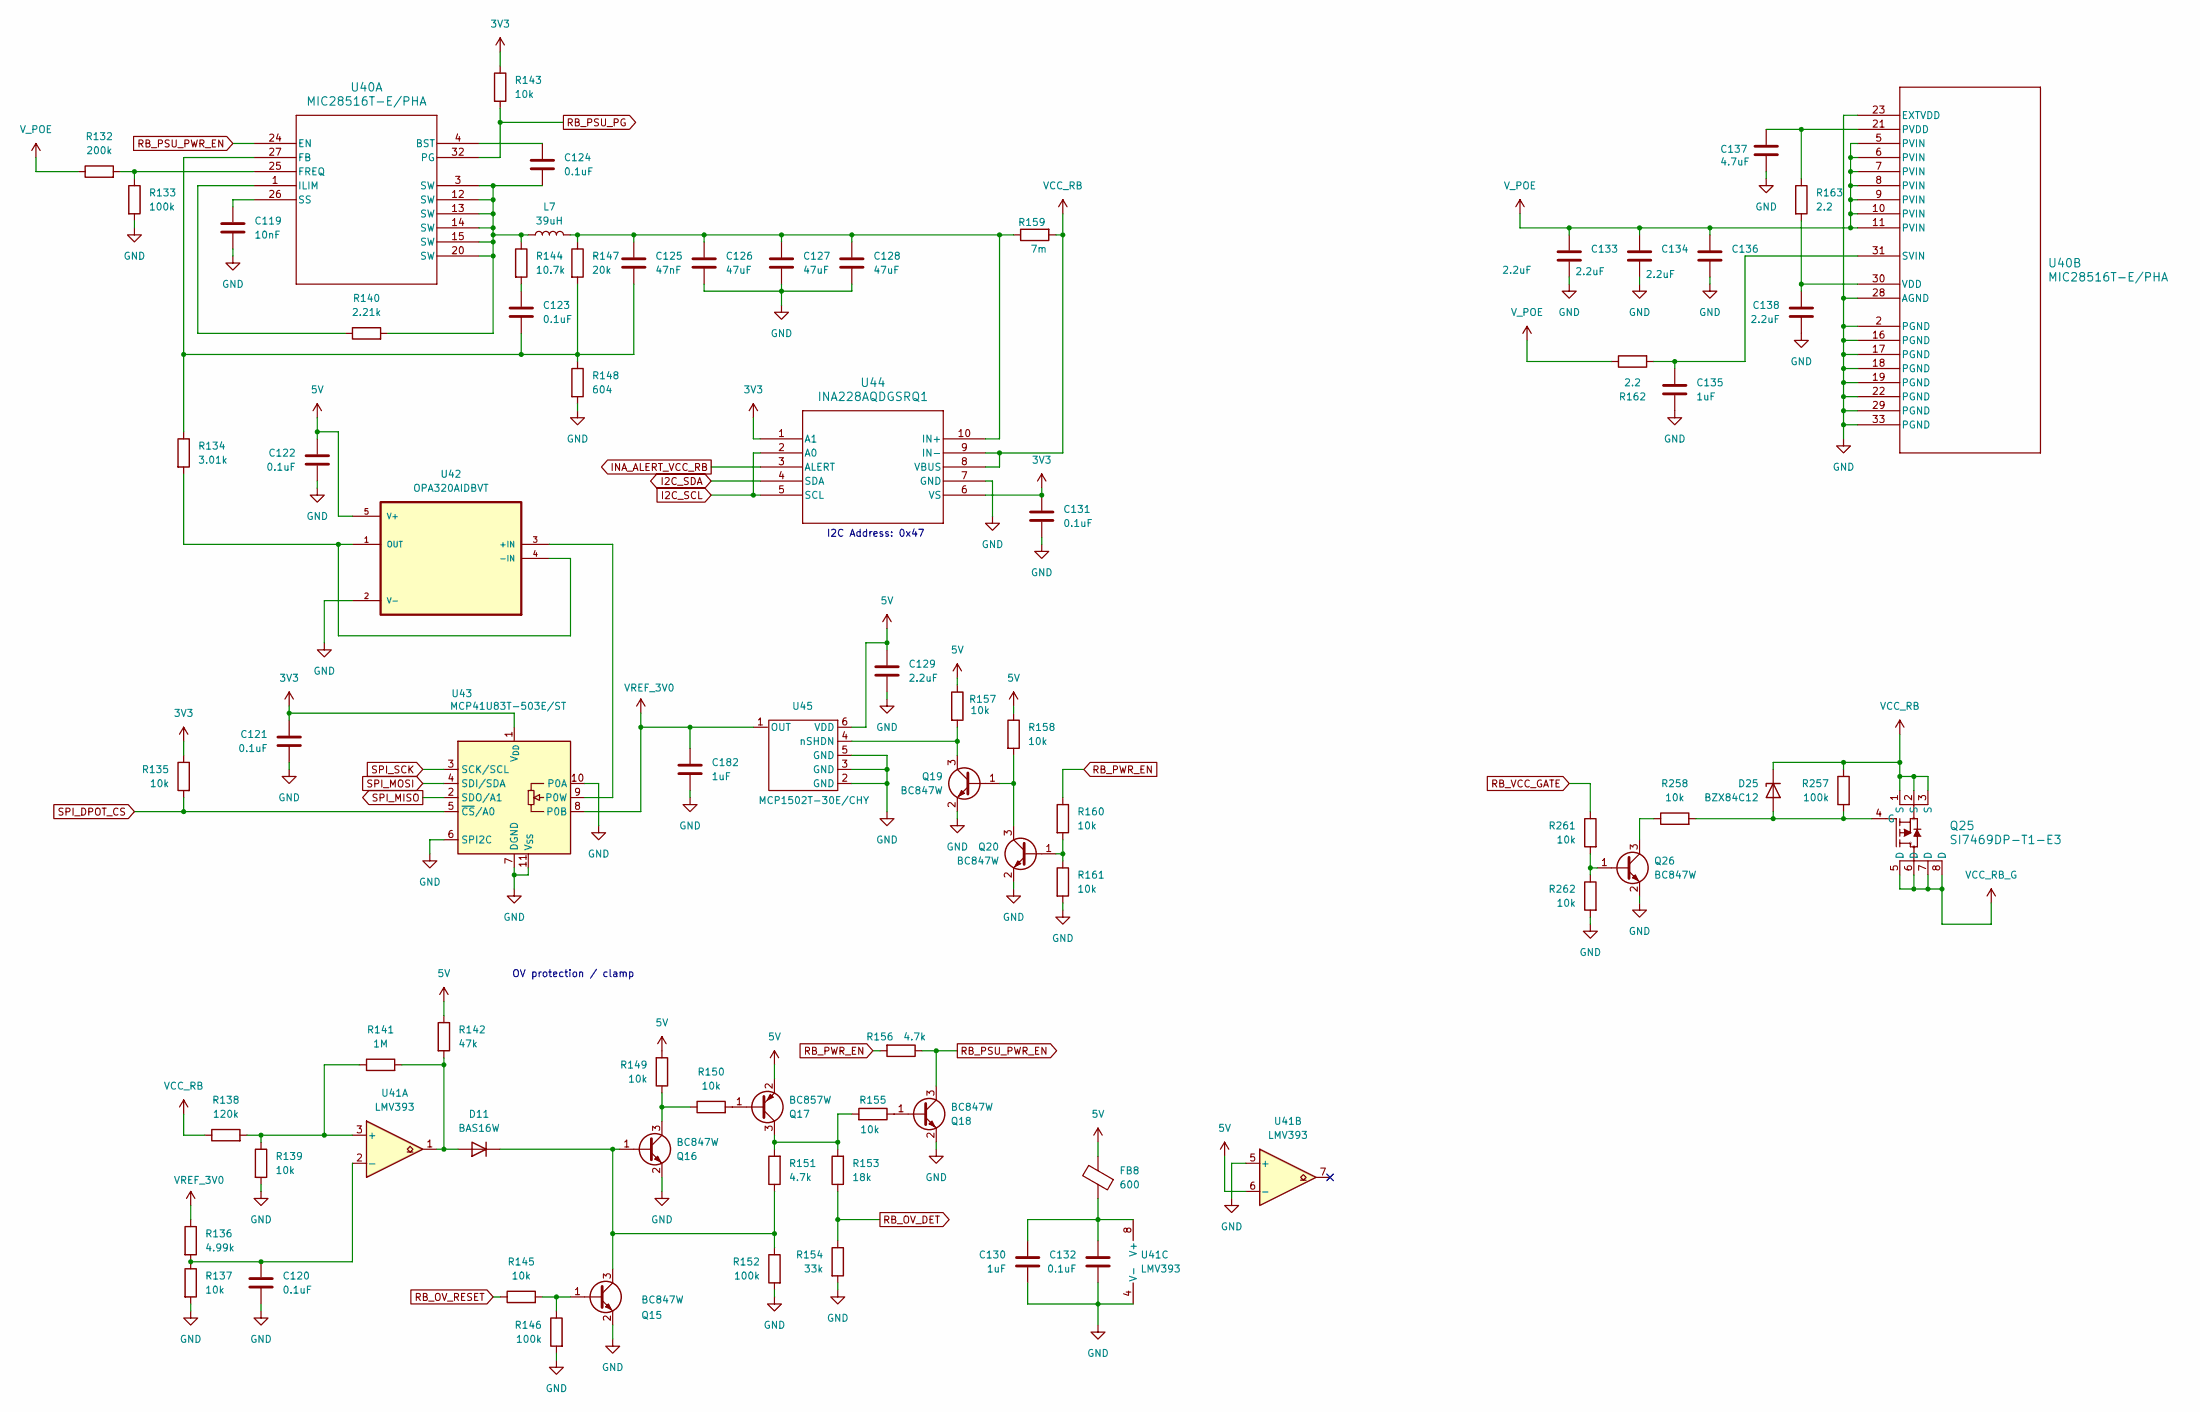
[picture p4: schematic rb.kicad_sch]

Parts:
C119: 10nF; C_0402_1005Metric; TOLERANCE 10%; VOLTAGE 16V; MANUFACTURER_PART_NUMBER GRT155R71C103KE01J; DIGIKEY_PART_NUMBER 490-GRT155R71C103KE01JCT-ND
C120, C121, C122, C123, C124, C131, C132: 0.1uF; C_0402_1005Metric; TOLERANCE 10%; VOLTAGE 16V; MANUFACTURER_PART_NUMBER GCM155R71C104KA55D; DIGIKEY_PART_NUMBER 490-4759-1-ND
C125: 47nF; C_0402_1005Metric; TOLERANCE 10%; VOLTAGE 50V; MANUFACTURER_PART_NUMBER GCM155R71H473KE02J; DIGIKEY_PART_NUMBER 490-14515-1-ND
C126, C127, C128: 47uF; KCM55WR71H476MH13L; TOLERANCE 10%; VOLTAGE 50V; MANUFACTURER_PART_NUMBER KCM55WR71H476MH13L; DIGIKEY_PART_NUMBER 490-KCM55WR71H476MH13LCT-ND
C129, C138: 2.2uF; C_0805_2012Metric; TOLERANCE 10%; VOLTAGE 16V; MANUFACTURER_PART_NUMBER GRT21BR71C225KE01L; DIGIKEY_PART_NUMBER 490-GRT21BR71C225KE01LCT-ND
C130, C182: 1uF; C_0603_1608Metric; TOLERANCE 10%; VOLTAGE 16V; MANUFACTURER_PART_NUMBER C0603C105K4RACAUTO; DIGIKEY_PART_NUMBER 399-17704-1-ND
C133, C134, C136: 2.2uF; C_2220_5750Metric; TOLERANCE 10%; VOLTAGE 100V; MANUFACTURER_PART_NUMBER CGA9P3X7T2E225K250KA; DIGIKEY_PART_NUMBER 445-7950-1-ND
C135: 1uF; C_0805_2012Metric; TOLERANCE 10%; VOLTAGE 100V; MANUFACTURER_PART_NUMBER 08051C105K4T2A; DIGIKEY_PART_NUMBER 478-KAM21KR72A105KUCT-ND
C137: 4.7uF; C_0805_2012Metric; TOLERANCE 10%; VOLTAGE 16V; MANUFACTURER_PART_NUMBER GRT21BR71C475KE13K; DIGIKEY_PART_NUMBER 490-GRT21BR71C475KE13KCT-ND
D11: BAS16W; SOD-123; MANUFACTURER_PART_NUMBER BAS16WHE3-TP; DIGIKEY_PART_NUMBER 353-BAS16WHE3-TPCT-ND
D25: BZX84C12; SOT-23-3; MANUFACTURER_PART_NUMBER BZX84C12LT1G; DIGIKEY_PART_NUMBER BZX84C12LT1GOSCT-ND
FB8: 600; 1206; MANUFACTURER_PART_NUMBER BLM31PG601SN1L; DIGIKEY_PART_NUMBER 490-16533-1-ND
L7: 39uH; 7447709390; MANUFACTURER_PART_NUMBER 7447709390; DIGIKEY_PART_NUMBER 732-7447709390CT-ND
Q15, Q16, Q18, Q19, Q20, Q26: BC847W; SOT-323_SC-70; MANUFACTURER_PART_NUMBER BC847W,135; DIGIKEY_PART_NUMBER 1727-BC847W,135CT-ND
Q17: BC857W; SOT-323_SC-70; MANUFACTURER_PART_NUMBER BC857W,135; DIGIKEY_PART_NUMBER 1727-BC857W,135CT-ND
Q25: SI7469DP-T1-E3; PowerPAKÂ® SO-8; MANUFACTURER_PART_NUMBER SI7469DP-T1-E3; DIGIKEY_PART_NUMBER SI7469DP-T1-E3CT-ND
R132: 200k; R_0402_1005Metric; TOLERANCE 1%; MANUFACTURER_PART_NUMBER ERJ-2RKF2003X; DIGIKEY_PART_NUMBER P200KLCT-ND
R133, R146, R152, R257: 100k; R_0402_1005Metric; TOLERANCE 1%; MANUFACTURER_PART_NUMBER ERJ-2RKF1003X; DIGIKEY_PART_NUMBER P100KLCT-ND
R134: 3.01k; R_0402_1005Metric; TOLERANCE 1%; MANUFACTURER_PART_NUMBER RK73H1ETTP3011F; DIGIKEY_PART_NUMBER 2019-RK73H1ETTP3011FCT-ND
R135, R137, R139, R143, R145, R149, R150, R155, R157, R158, R160, R161, R258, R261, R262: 10k; R_0402_1005Metric; TOLERANCE 1%; MANUFACTURER_PART_NUMBER ERJ-2RKF1002X; DIGIKEY_PART_NUMBER P10.0KLCT-ND
R136: 4.99k; R_0402_1005Metric; TOLERANCE 1%; MANUFACTURER_PART_NUMBER ERJ-2RKF4991X; DIGIKEY_PART_NUMBER P4.99KLCT-ND
R138: 120k; R_0402_1005Metric; TOLERANCE 1%; MANUFACTURER_PART_NUMBER ERJ-2RKF1203X; DIGIKEY_PART_NUMBER P120KLCT-ND
R140: 2.21k; R_0402_1005Metric; TOLERANCE 1%; MANUFACTURER_PART_NUMBER ERJ-2RKF2211X; DIGIKEY_PART_NUMBER P2.21KLCT-ND
R141: 1M; R_0402_1005Metric; TOLERANCE 1%; MANUFACTURER_PART_NUMBER ERJ-2RKF1004X; DIGIKEY_PART_NUMBER P1.00MLCT-ND
R142: 47k; R_0402_1005Metric; TOLERANCE 1%; MANUFACTURER_PART_NUMBER ERJ-2RKF4702X; DIGIKEY_PART_NUMBER P47.0KLCT-ND
R144: 10.7k; R_0402_1005Metric; TOLERANCE 1%; MANUFACTURER_PART_NUMBER ERJ-2RKF1072X; DIGIKEY_PART_NUMBER P10.7KLCT-ND
R147: 20k; R_0402_1005Metric; TOLERANCE 1%; MANUFACTURER_PART_NUMBER ERJ-H2RD2002X; DIGIKEY_PART_NUMBER 10-ERJ-H2RD2002XCT-ND
R148: 604; R_0402_1005Metric; TOLERANCE 1%; MANUFACTURER_PART_NUMBER ERJ-2RKF6040X; DIGIKEY_PART_NUMBER P604LCT-ND
R151, R156: 4.7k; R_0402_1005Metric; TOLERANCE 1%; MANUFACTURER_PART_NUMBER ERJ-2RKF4701X; DIGIKEY_PART_NUMBER P4.70KLCT-ND
R153: 18k; R_0402_1005Metric; TOLERANCE 1%; MANUFACTURER_PART_NUMBER ERJ-2RKF1802X; DIGIKEY_PART_NUMBER P18.0KLCT-ND
R154: 33k; R_0402_1005Metric; TOLERANCE 1%; MANUFACTURER_PART_NUMBER ERJ-2RKF3302X; DIGIKEY_PART_NUMBER P33.0KLCT-ND
R159: 7m; R_2512_6332Metric; TOLERANCE 0.5%; MANUFACTURER_PART_NUMBER WSL25127L000FEA; DIGIKEY_PART_NUMBER WSLG-.007CT-ND
R162, R163: 2.2; R_0402_1005Metric; TOLERANCE 1%; MANUFACTURER_PART_NUMBER ERJ-U02F2R20X; DIGIKEY_PART_NUMBER 10-ERJ-U02F2R20XTR-ND
U40: MIC28516T-E/PHA; MIC28516T-EPHA; MANUFACTURER_PART_NUMBER MIC28516T-E/PHA; DIGIKEY_PART_NUMBER 150-MIC28516T-E/PHATR-ND
U41: LMV393; MANUFACTURER_PART_NUMBER LMV393IDGKR; DIGIKEY_PART_NUMBER 296-13993-1-ND
U42: OPA320AIDBVT; SOT95P280X145-5N; MANUFACTURER_PART_NUMBER OPA320AIDBVT; DIGIKEY_PART_NUMBER 296-29510-1-ND
U43: MCP41U83T-503E/ST; TSSOP-14_4.4x5mm_P0.65mm; MANUFACTURER_PART_NUMBER MCP41U83T-503E/ST; DIGIKEY_PART_NUMBER 150-MCP41U83T-503E/STCT-ND
U44: INA228AQDGSRQ1; VSSOP10_DGS_TEX; MANUFACTURER_PART_NUMBER INA228AQDGSRQ1; DIGIKEY_PART_NUMBER 296-INA228AQDGSRQ1CT-ND
U45: MCP1502T-30E/CHY; SOT-23-6; MANUFACTURER_PART_NUMBER MCP1502T-30E/CHY; DIGIKEY_PART_NUMBER 150-MCP1502T-30E/CHYCT-ND

Connections:
3V3: C121.1, C131.1, R135.1, R143.1, U43.1 (V_{DD}), U44.1 (A1), U44.6 (VS); also elsewhere on the board
5V: C122.1, C129.1, FB8.2, Q17.2 (E), R142.1, R149.2, R157.1, R158.1, U41.6 (-), U42.5 (V+), U45.6 (VDD); also elsewhere on the board
GND: C119.2, C120.2, C121.2, C122.2, C126.2, C127.2, C128.2, C129.2, C130.2, C131.2, C132.2, C133.2, C134.2, C135.2, C136.2, C137.2, C138.2, C182.2, Q15.2 (E), Q16.2 (E), Q18.2 (E), Q19.2 (E), Q20.2 (E), Q26.2 (E), R133.2, R137.2, R139.2, R146.2, R148.2, R152.2, R154.2, R161.2, R262.2, U40.2 (PGND), U40.16 (PGND), U40.17 (PGND), U40.18 (PGND), U40.19 (PGND), U40.22 (PGND), U40.23 (EXTVDD), U40.28 (AGND), U40.29 (PGND), U40.33 (PGND), U41.4 (V-), U41.5 (+), U42.2 (V-), U43.6 (SPI2C), U43.7 (DGND), U43.10 (P0A), U43.11 (V_{SS}), U44.7 (GND), U45.2 (GND), U45.3 (GND), U45.5 (GND); also elsewhere on the board
I2C_SCL: U44.2 (A0), U44.5 (SCL); also elsewhere on the board
I2C_SDA: U44.4 (SDA); also elsewhere on the board
INA_ALERT_VCC_RB: U44.3 (ALERT); also elsewhere on the board
unnamed: C123.1, R144.2
unnamed: C124.2, L7.1, R140.2, R144.1, U40.3 (SW), U40.12 (SW), U40.13 (SW), U40.14 (SW), U40.15 (SW), U40.20 (SW)
unnamed: D11.1 (A), R141.2, R142.2, U41.1
unnamed: D11.3 (K), Q15.3 (C), Q16.1 (B), R151.1, R152.1
unnamed: D25.2 (A), Q25.4 (G), R257.2, R258.2
unnamed: Q15.1 (B), R145.2, R146.1
unnamed: Q16.3 (C), R149.1, R150.1
unnamed: Q17.1 (B), R150.2
unnamed: Q17.3 (C), R151.2, R153.2, R155.2
unnamed: Q18.1 (B), R155.1
unnamed: Q19.1 (B), Q20.3 (C), R158.2
unnamed: Q19.3 (C), R157.2, U45.4 (nSHDN)
unnamed: Q20.1 (B), R160.2, R161.1
unnamed: Q26.1 (B), R261.2, R262.1
unnamed: Q26.3 (C), R258.1
unnamed: C124.1, U40.4 (BST)
unnamed: C123.2, C125.2, R134.1, R147.2, R148.1, U40.27 (FB)
unnamed: R132.2, R133.1, U40.25 (FREQ)
unnamed: R140.1, U40.1 (ILIM)
unnamed: C119.1, U40.26 (SS)
unnamed: C137.1, R163.1, U40.21 (PVDD)
unnamed: C135.1, R162.2, U40.31 (SVIN)
unnamed: C138.1, R163.2, U40.30 (VDD)
unnamed: R138.2, R139.1, R141.1, U41.3 (+)
unnamed: C120.1, R136.2, R137.1, U41.2 (-)
unnamed: C130.1, C132.1, FB8.1, U41.8 (V+)
unnamed: U42.3 (+IN), U43.9 (P0W)
unnamed: R134.2, U42.1 (OUT), U42.4 (-IN)
unnamed: C125.1, C126.1, C127.1, C128.1, L7.2, R147.1, R159.1, U44.10 (IN+)
RB_OV_DET: R153.1, R154.1; also elsewhere on the board
RB_OV_RESET: R145.1; also elsewhere on the board
RB_PSU_PG: R143.2, U40.32 (PG); also elsewhere on the board
RB_PSU_PWR_EN: Q18.3 (C), R156.1, U40.24 (EN)
RB_PWR_EN: R156.2, R160.1; also elsewhere on the board
RB_VCC_GATE: R261.1; also elsewhere on the board
SPI_DPOT_CS: R135.2, U43.5 (~CS/A0); also elsewhere on the board
SPI_MISO: U43.2 (SDO/A1); also elsewhere on the board
SPI_MOSI: U43.4 (SDI/SDA); also elsewhere on the board
SPI_SCK: U43.3 (SCK/SCL); also elsewhere on the board
VCC_RB: D25.1 (K), Q25.1 (S), Q25.2 (S), Q25.3 (S), R138.1, R159.2, R257.1, U44.8 (VBUS), U44.9 (IN-)
VCC_RB_G: Q25.5 (D), Q25.6 (D), Q25.7 (D), Q25.8 (D); also elsewhere on the board
VREF_3V0: C182.1, R136.1, U43.8 (P0B), U45.1 (OUT)
V_POE: C133.1, C134.1, C136.1, R132.1, R162.1, U40.5 (PVIN), U40.6 (PVIN), U40.7 (PVIN), U40.8 (PVIN), U40.9 (PVIN), U40.10 (PVIN), U40.11 (PVIN); also elsewhere on the board

Notes on the sheet:
I2C Address: 0x47
OV protection / clamp

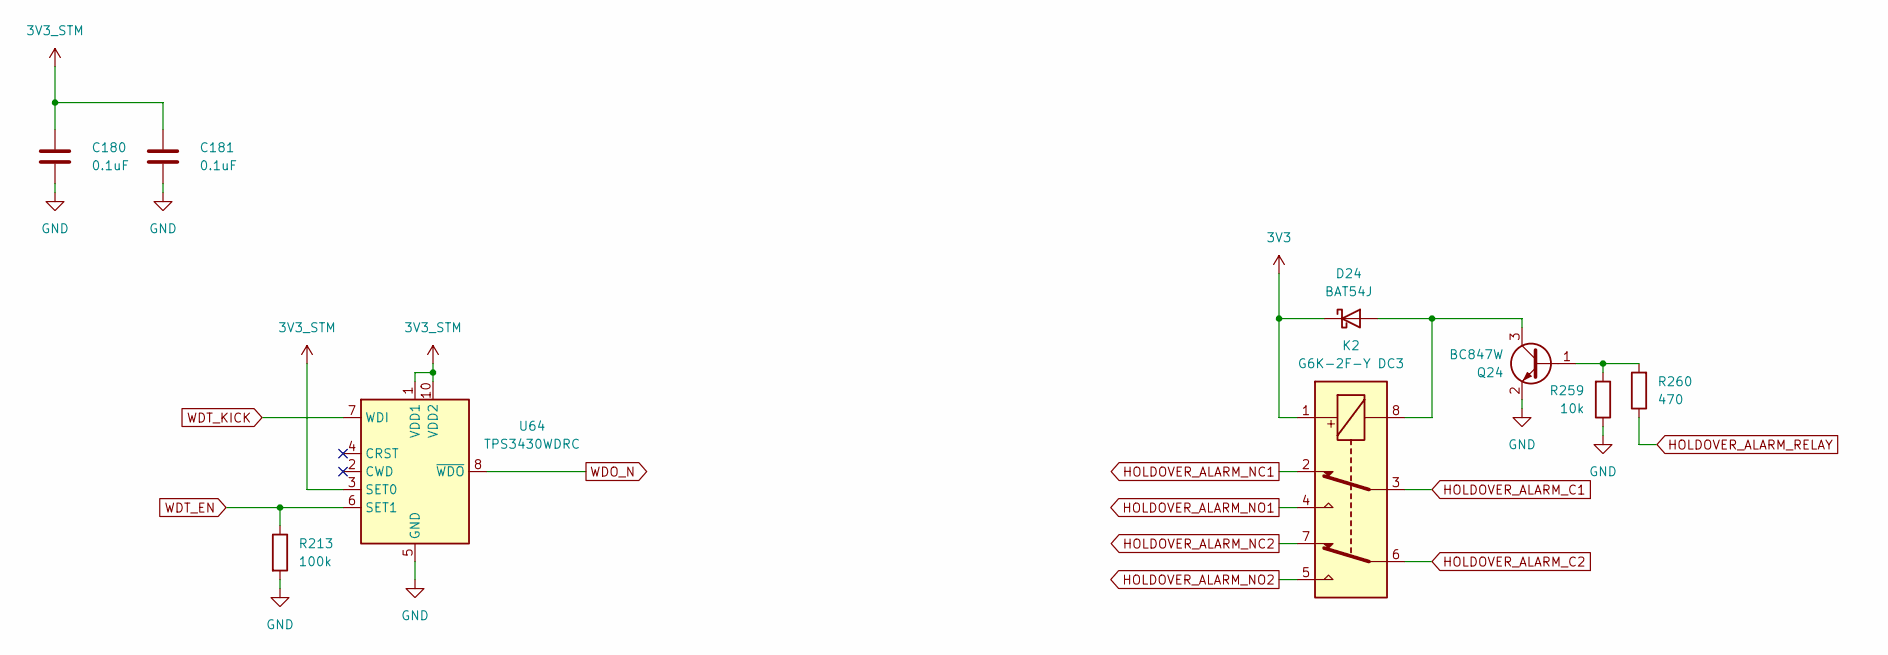
[picture p5: schematic wdt.kicad_sch]

Parts:
C180, C181: 0.1uF; C_0402_1005Metric; TOLERANCE 10%; VOLTAGE 16V; MANUFACTURER_PART_NUMBER GCM155R71C104KA55D; DIGIKEY_PART_NUMBER 490-4759-1-ND
D24: BAT54J; D_SOD-323F; MANUFACTURER_PART_NUMBER BAT54J-QX; DIGIKEY_PART_NUMBER 1727-BAT54J-QXCT-ND
K2: G6K-2F-Y DC3; MANUFACTURER_PART_NUMBER G6K-2F-Y DC3; DIGIKEY_PART_NUMBER 39-G6K-2F-YDC3-ND
Q24: BC847W; SOT-323_SC-70; MANUFACTURER_PART_NUMBER BC847W,135; DIGIKEY_PART_NUMBER 1727-BC847W,135CT-ND
R213: 100k; R_0402_1005Metric; TOLERANCE 1%; MANUFACTURER_PART_NUMBER ERJ-2RKF1003X; DIGIKEY_PART_NUMBER P100KLCT-ND
R259: 10k; R_0402_1005Metric; TOLERANCE 1%; MANUFACTURER_PART_NUMBER ERJ-2RKF1002X; DIGIKEY_PART_NUMBER P10.0KLCT-ND
R260: 470; R_0402_1005Metric; TOLERANCE 1%; MANUFACTURER_PART_NUMBER ERJ-2RKF4700X; DIGIKEY_PART_NUMBER P470LCT-ND
U64: TPS3430WDRC; VSON-10-1EP_3x3mm_P0.5mm_EP1.65x2.4mm; MANUFACTURER_PART_NUMBER TPS3430WDRC; DIGIKEY_PART_NUMBER 296-51907-1-ND

Connections:
3V3: D24.1 (K), K2.1; also elsewhere on the board
3V3_STM: C180.1, C181.1, U64.1 (VDD1), U64.3 (SET0), U64.10 (VDD2); also elsewhere on the board
GND: C180.2, C181.2, Q24.2 (E), R213.2, R259.1, U64.5 (GND), U64.11 (GND); also elsewhere on the board
HOLDOVER_ALARM_C1: K2.3; also elsewhere on the board
HOLDOVER_ALARM_C2: K2.6; also elsewhere on the board
HOLDOVER_ALARM_NC1: K2.2; also elsewhere on the board
HOLDOVER_ALARM_NC2: K2.7; also elsewhere on the board
HOLDOVER_ALARM_NO1: K2.4; also elsewhere on the board
HOLDOVER_ALARM_NO2: K2.5; also elsewhere on the board
HOLDOVER_ALARM_RELAY: R260.1; also elsewhere on the board
unnamed: D24.2 (A), K2.8, Q24.3 (C)
unnamed: Q24.1 (B), R259.2, R260.2
WDO_N: U64.8 (~WDO); also elsewhere on the board
WDT_EN: R213.1, U64.6 (SET1); also elsewhere on the board
WDT_KICK: U64.7 (WDI); also elsewhere on the board

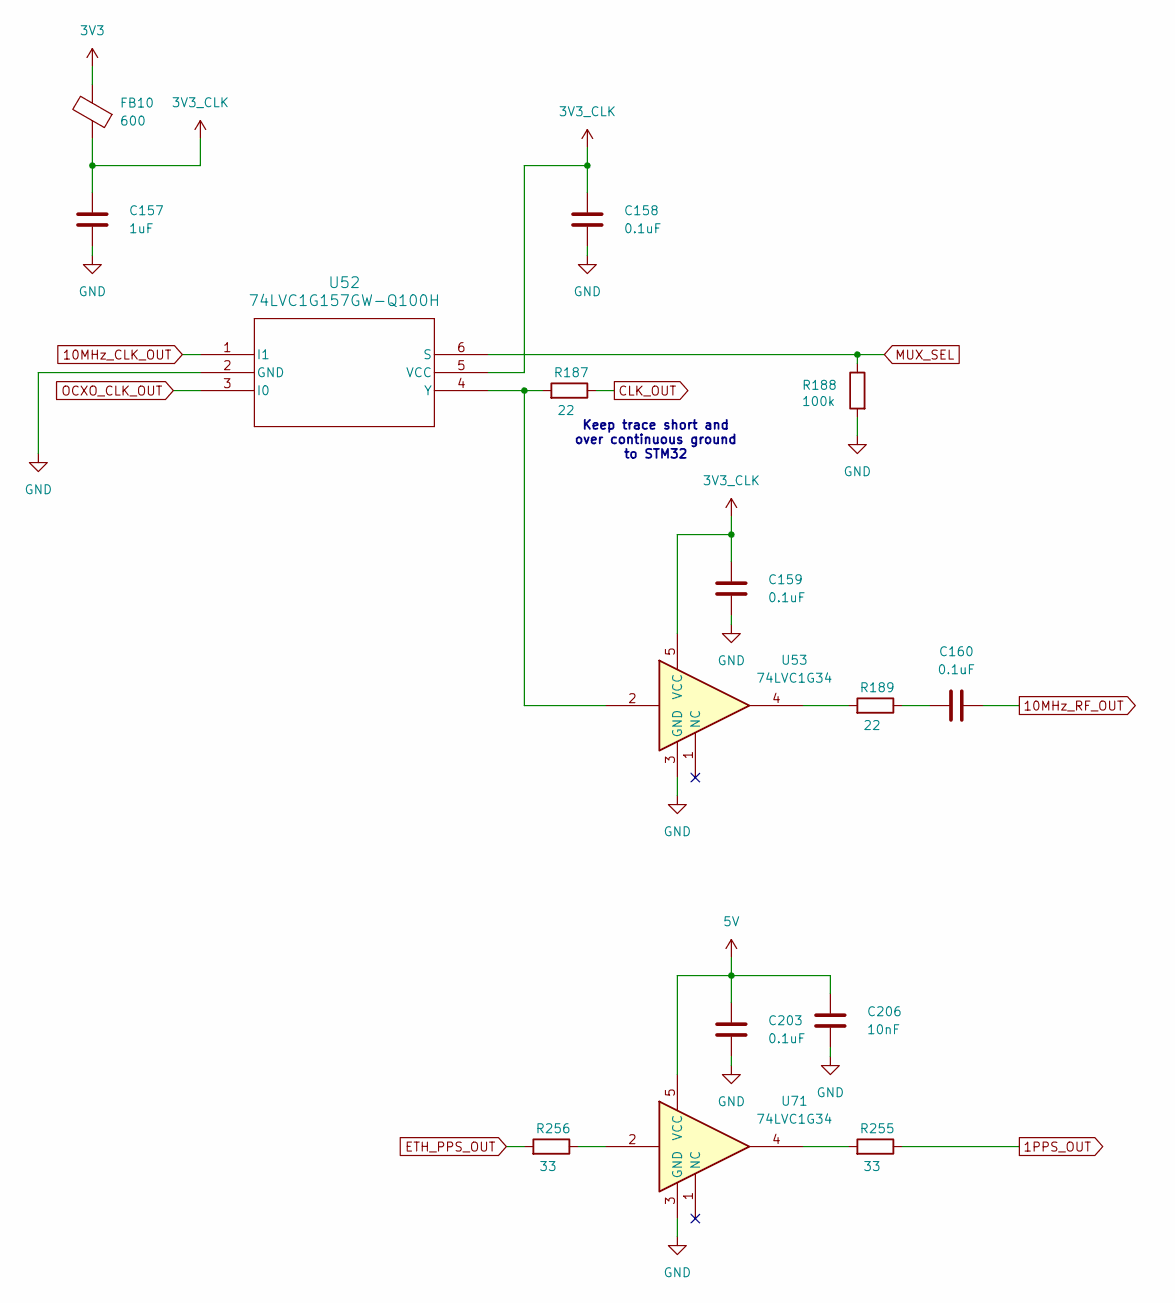
[picture p6: schematic clock-mux.kicad_sch]

Parts:
C157: 1uF; C_0603_1608Metric; TOLERANCE 10%; VOLTAGE 16V; MANUFACTURER_PART_NUMBER C0603C105K4RACAUTO; DIGIKEY_PART_NUMBER 399-17704-1-ND
C158, C159, C160, C203: 0.1uF; C_0402_1005Metric; TOLERANCE 10%; VOLTAGE 16V; MANUFACTURER_PART_NUMBER GCM155R71C104KA55D; DIGIKEY_PART_NUMBER 490-4759-1-ND
C206: 10nF; C_0402_1005Metric; TOLERANCE 10%; VOLTAGE 16V; MANUFACTURER_PART_NUMBER GRT155R71C103KE01J; DIGIKEY_PART_NUMBER 490-GRT155R71C103KE01JCT-ND
FB10: 600; 1206; MANUFACTURER_PART_NUMBER BLM31PG601SN1L; DIGIKEY_PART_NUMBER 490-16533-1-ND
R187, R189: 22; R_0402_1005Metric; TOLERANCE 1%; MANUFACTURER_PART_NUMBER ERJ-2RKF22R0X; DIGIKEY_PART_NUMBER P22.0LCT-ND
R188: 100k; R_0402_1005Metric; TOLERANCE 1%; MANUFACTURER_PART_NUMBER ERJ-2RKF1003X; DIGIKEY_PART_NUMBER P100KLCT-ND
R255, R256: 33; R_0402_1005Metric; TOLERANCE 1%; MANUFACTURER_PART_NUMBER ERJ-2RKF33R0X; DIGIKEY_PART_NUMBER P33.0LCT-ND
U52: 74LVC1G157GW-Q100H; SC-74_TSOP6_SOT457_NEX; MANUFACTURER_PART_NUMBER 74LVC1G157GW-Q100H; DIGIKEY_PART_NUMBER 1727-74LVC1G157GW-Q100HCT-ND
U53, U71: 74LVC1G34; 74LVC1G34GW_125; MANUFACTURER_PART_NUMBER 74LVC1G34GW,125; DIGIKEY_PART_NUMBER 1727-6074-1-ND

Connections:
1PPS_OUT: R255.1; also elsewhere on the board
3V3: FB10.2; also elsewhere on the board
3V3_CLK: C157.1, C158.1, C159.1, FB10.1, U52.5 (VCC), U53.5 (VCC)
5V: C203.1, C206.1, U71.5 (VCC); also elsewhere on the board
10MHz_CLK_OUT: U52.1 (I1); also elsewhere on the board
10MHz_RF_OUT: C160.2; also elsewhere on the board
CLK_OUT: R187.1; also elsewhere on the board
ETH_PPS_OUT: R256.2; also elsewhere on the board
GND: C157.2, C158.2, C159.2, C203.2, C206.2, R188.2, U52.2 (GND), U53.3 (GND), U71.3 (GND); also elsewhere on the board
MUX_SEL: R188.1, U52.6 (S); also elsewhere on the board
unnamed: C160.1, R189.1
unnamed: R189.2, U53.4
unnamed: R255.2, U71.4
unnamed: R256.1, U71.2
unnamed: R187.2, U52.4 (Y), U53.2
OCXO_CLK_OUT: U52.3 (I0); also elsewhere on the board

Notes on the sheet:
Keep trace short and over continuous ground to STM32
