rcldesign/ntp-server-stm32/hardware/ntp-server-stm32/ntp-server-stm32.kicad_pcb

## KiCad design hardware/ntp-server-stm32/ntp-server-stm32.kicad_pcb (continued)

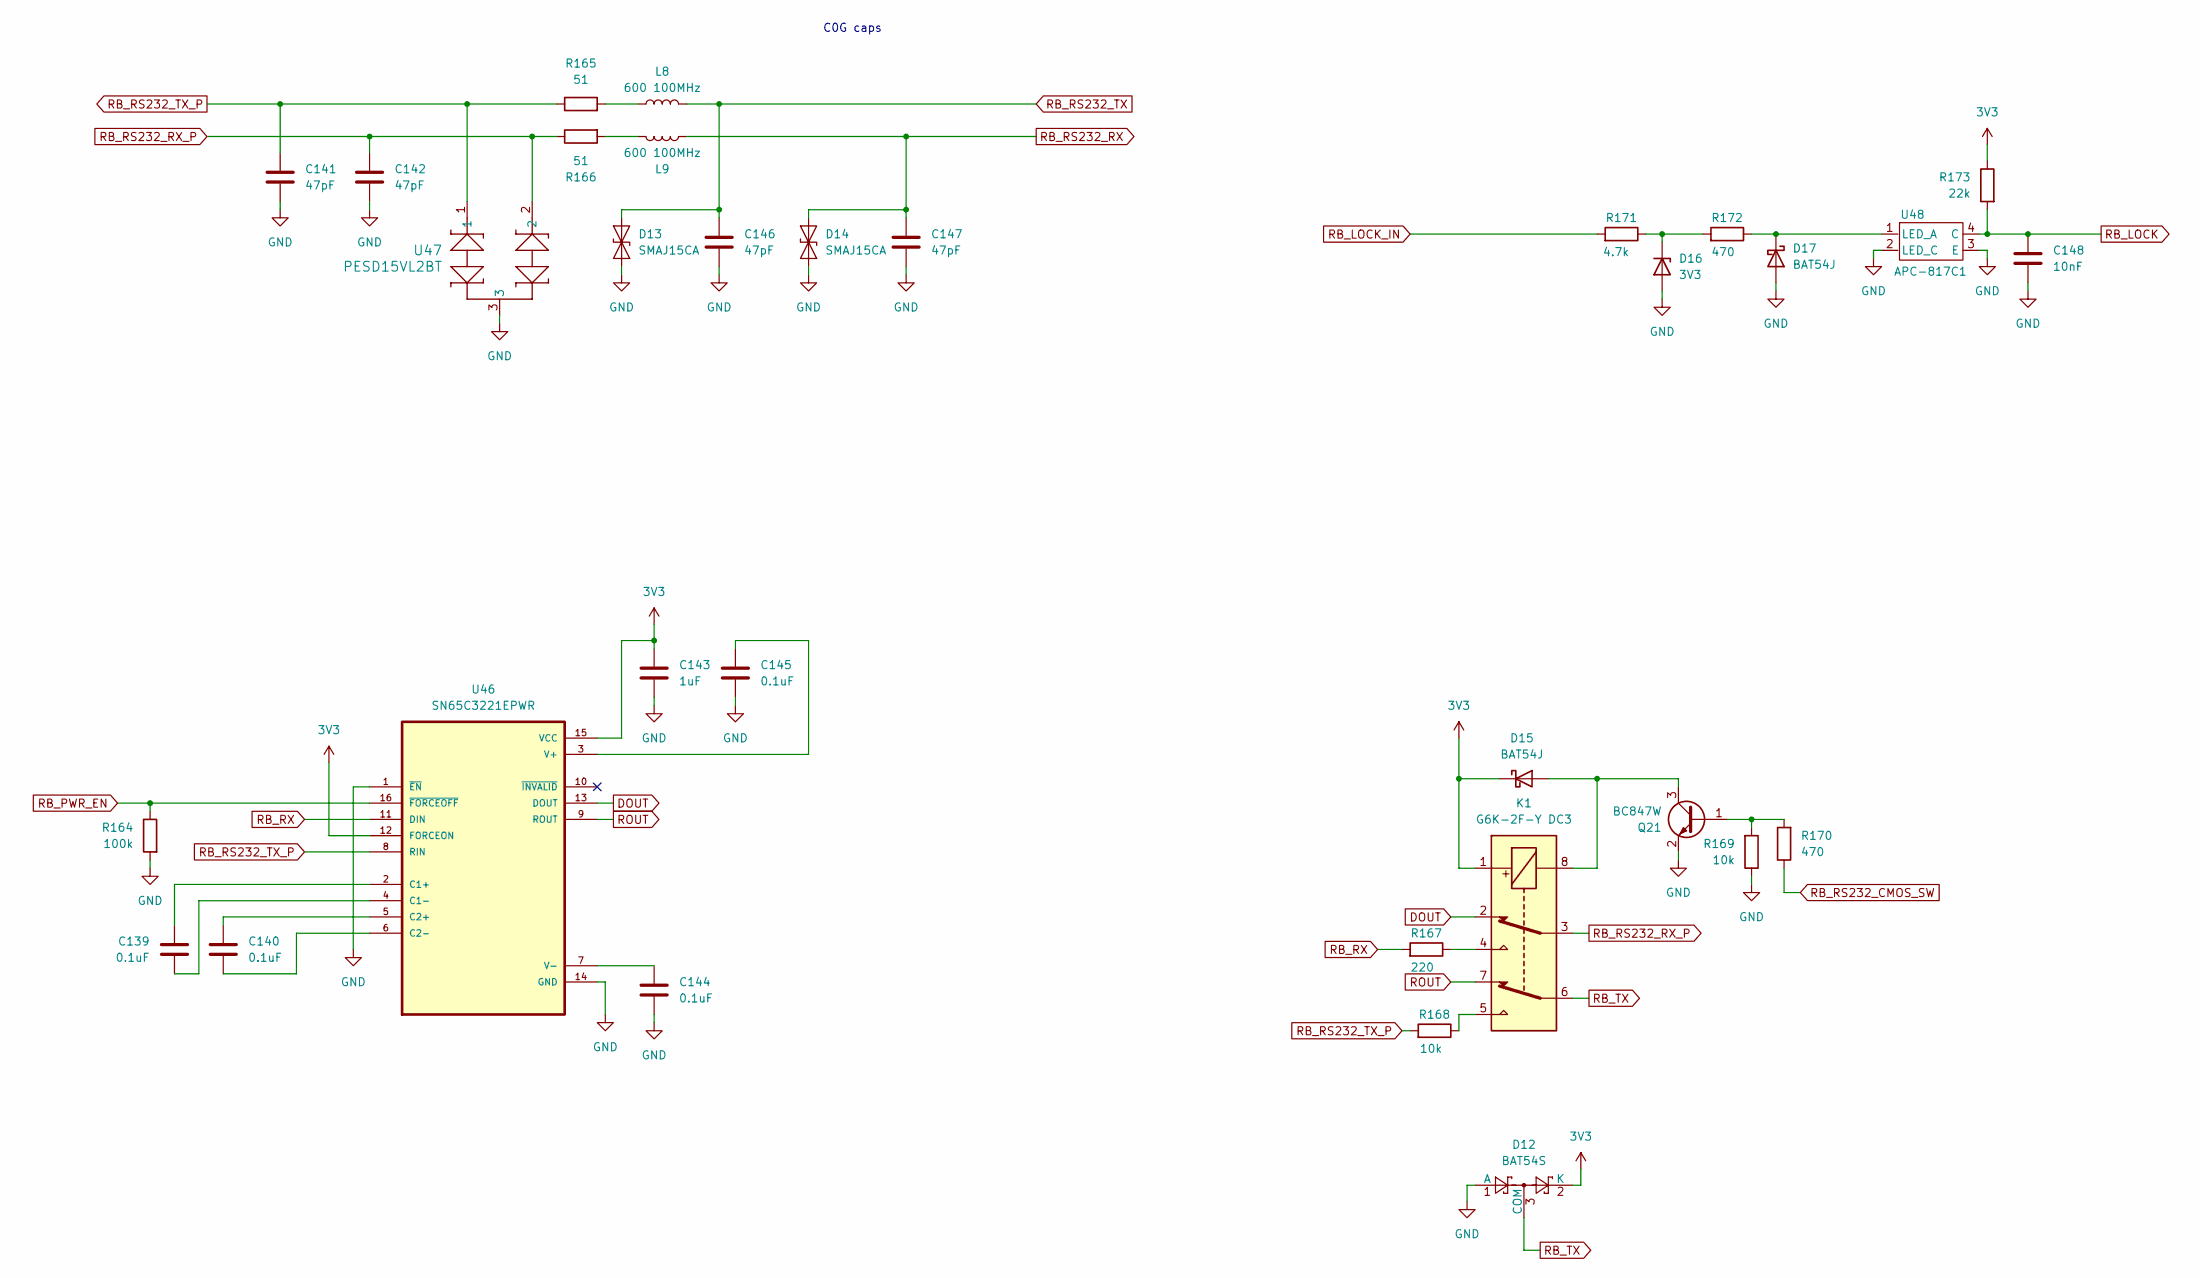
[picture p7: schematic rb-io.kicad_sch]

Parts:
C139, C140, C144, C145: 0.1uF; C_0402_1005Metric; TOLERANCE 10%; VOLTAGE 16V; MANUFACTURER_PART_NUMBER GCM155R71C104KA55D; DIGIKEY_PART_NUMBER 490-4759-1-ND
C141, C142, C146, C147: 47pF; C_0402_1005Metric; TOLERANCE 5%; VOLTAGE 50V; MANUFACTURER_PART_NUMBER GCM1555C1H470FA16D; DIGIKEY_PART_NUMBER 490-16445-1-ND
C143: 1uF; C_0603_1608Metric; TOLERANCE 10%; VOLTAGE 16V; MANUFACTURER_PART_NUMBER C0603C105K4RACAUTO; DIGIKEY_PART_NUMBER 399-17704-1-ND
C148: 10nF; C_0402_1005Metric; TOLERANCE 10%; VOLTAGE 16V; MANUFACTURER_PART_NUMBER GRT155R71C103KE01J; DIGIKEY_PART_NUMBER 490-GRT155R71C103KE01JCT-ND
D12: BAT54S; SOT-23-3; MANUFACTURER_PART_NUMBER BAT54S; DIGIKEY_PART_NUMBER 4878-BAT54SCT-ND
D13, D14: SMAJ15CA; DO-214AC; MANUFACTURER_PART_NUMBER SMAJ15CA; DIGIKEY_PART_NUMBER 732-SMAJ15CATR-ND
D15, D17: BAT54J; D_SOD-323F; MANUFACTURER_PART_NUMBER BAT54J-QX; DIGIKEY_PART_NUMBER 1727-BAT54J-QXCT-ND
D16: 3V3; SOT-23-3; MANUFACTURER_PART_NUMBER BZX84C3V3LT1G; DIGIKEY_PART_NUMBER BZX84C3V3LT1GOSCT-ND
K1: G6K-2F-Y DC3; MANUFACTURER_PART_NUMBER G6K-2F-Y DC3; DIGIKEY_PART_NUMBER 39-G6K-2F-YDC3-ND
L8, L9: 600 100MHz; L_0805_2012Metric; MANUFACTURER_PART_NUMBER 2508056017Y2; DIGIKEY_PART_NUMBER 1934-1487-2-ND
Q21: BC847W; SOT-323_SC-70; MANUFACTURER_PART_NUMBER BC847W,135; DIGIKEY_PART_NUMBER 1727-BC847W,135CT-ND
R164: 100k; R_0402_1005Metric; TOLERANCE 1%; MANUFACTURER_PART_NUMBER ERJ-2RKF1003X; DIGIKEY_PART_NUMBER P100KLCT-ND
R165, R166: 51; R_0402_1005Metric; TOLERANCE 1%; MANUFACTURER_PART_NUMBER ERJ-2RKF51R0X; DIGIKEY_PART_NUMBER P51.0LCT-ND
R167: 220; R_0402_1005Metric; TOLERANCE 1%; MANUFACTURER_PART_NUMBER ERJ-2RKF2200X; DIGIKEY_PART_NUMBER P220LCT-ND
R168, R169: 10k; R_0402_1005Metric; TOLERANCE 1%; MANUFACTURER_PART_NUMBER ERJ-2RKF1002X; DIGIKEY_PART_NUMBER P10.0KLCT-ND
R170, R172: 470; R_0402_1005Metric; TOLERANCE 1%; MANUFACTURER_PART_NUMBER ERJ-2RKF4700X; DIGIKEY_PART_NUMBER P470LCT-ND
R171: 4.7k; R_0402_1005Metric; TOLERANCE 1%; MANUFACTURER_PART_NUMBER ERJ-2RKF4701X; DIGIKEY_PART_NUMBER P4.70KLCT-ND
R173: 22k; R_0402_1005Metric; TOLERANCE 1%; MANUFACTURER_PART_NUMBER ERJ-2RKF2202X; DIGIKEY_PART_NUMBER P22.0KLCT-ND
U46: SN65C3221EPWR; SOP65P640X120-16N; MANUFACTURER_PART_NUMBER SN65C3221EPWR; DIGIKEY_PART_NUMBER 296-20992-1-ND
U47: PESD15VL2BT; TSOT-23; MANUFACTURER_PART_NUMBER PESD15VL2BT,215; DIGIKEY_PART_NUMBER 1727-3813-1-ND
U48: APC-817C1; APC817C1SL; MANUFACTURER_PART_NUMBER APC-817C1-SL; DIGIKEY_PART_NUMBER 2007-APC-817C1-SLCT-ND

Connections:
3V3: C143.1, D12.2 (K), D15.1 (K), K1.1, R173.1, U46.12 (FORCEON), U46.15 (VCC); also elsewhere on the board
DOUT: K1.2, U46.13 (DOUT)
GND: C141.2, C142.2, C143.2, C144.2, C145.2, C146.2, C147.2, C148.2, D12.1 (A), D13.1 (A1), D14.1 (A1), D16.2 (A), D17.2 (A), Q21.2 (E), R164.2, R169.1, U46.1 (~EN), U46.14 (GND), U47.3, U48.2 (LED_C), U48.3 (E); also elsewhere on the board
unnamed: D15.2 (A), K1.8, Q21.3 (C)
unnamed: D16.1 (K), R171.1, R172.2
unnamed: D17.1 (K), R172.1, U48.1 (LED_A)
unnamed: K1.4, R167.1
unnamed: K1.5, R168.1
unnamed: L8.1, R165.2
unnamed: L9.1, R166.2
unnamed: Q21.1 (B), R169.2, R170.2
unnamed: C139.1, U46.2 (C1+)
unnamed: C139.2, U46.4 (C1-)
unnamed: C140.1, U46.5 (C2+)
unnamed: C140.2, U46.6 (C2-)
unnamed: C145.1, U46.3 (V+)
unnamed: C144.1, U46.7 (V-)
RB_LOCK: C148.1, R173.2, U48.4 (C); also elsewhere on the board
RB_LOCK_IN: R171.2; also elsewhere on the board
RB_PWR_EN: R164.1, U46.16 (~FORCEOFF); also elsewhere on the board
RB_RS232_CMOS_SW: R170.1; also elsewhere on the board
RB_RS232_RX: C147.1, D14.2 (A2), L9.2; also elsewhere on the board
RB_RS232_RX_P: C142.1, K1.3, R166.1, U47.2
RB_RS232_TX: C146.1, D13.2 (A2), L8.2; also elsewhere on the board
RB_RS232_TX_P: C141.1, R165.1, R168.2, U46.8 (RIN), U47.1
RB_RX: R167.2, U46.11 (DIN); also elsewhere on the board
RB_TX: D12.3 (COM), K1.6; also elsewhere on the board
ROUT: K1.7, U46.9 (ROUT)

Notes on the sheet:
C0G caps

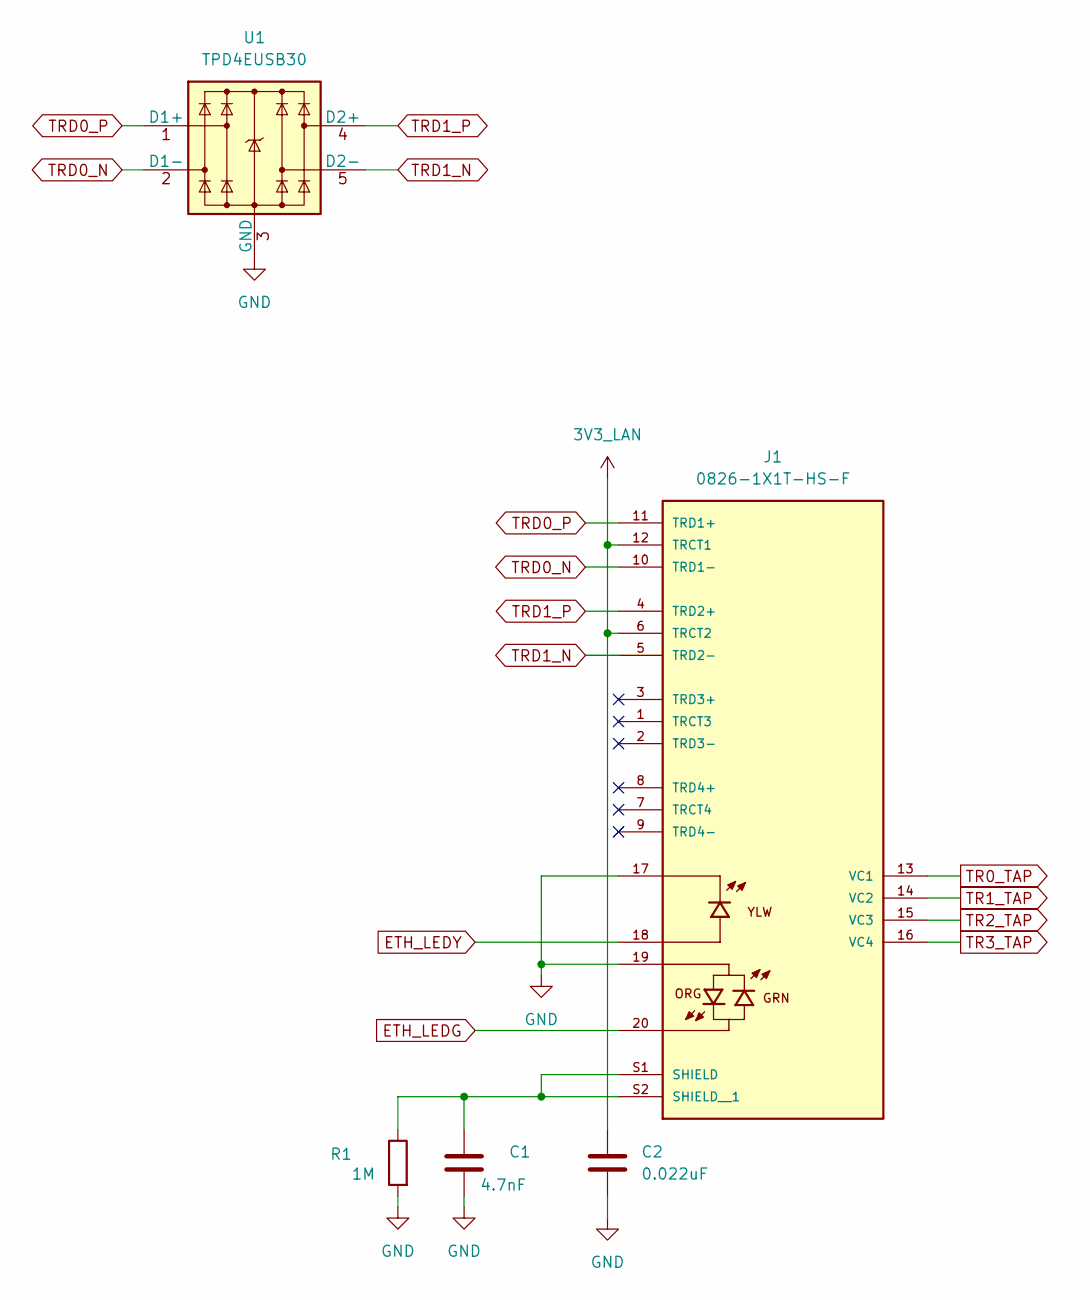
[picture p8: schematic ethernet-input.kicad_sch]

Parts:
C1: 4.7nF; C_1812_4532Metric; TOLERANCE 10%; VOLTAGE 2kV; MANUFACTURER_PART_NUMBER C1812C472KGRACAUTO; DIGIKEY_PART_NUMBER 399-16791-1-ND
C2: 0.022uF; C_0402_1005Metric; TOLERANCE 10%; VOLTAGE 50V; MANUFACTURER_PART_NUMBER C0402C223J5RACAUTO; DIGIKEY_PART_NUMBER 399-C0402C223J5RACAUTOCT-ND
J1: 0826-1X1T-HS-F; BEL_0826-1X1T-GH-F; PARTREV D; DIGIKEY_PART_NUMBER 507-2168-ND
R1: 1M; R_0402_1005Metric; TOLERANCE 1%; MANUFACTURER_PART_NUMBER ERJ-2RKF1004X; DIGIKEY_PART_NUMBER P1.00MLCT-ND
U1: TPD4EUSB30; TPD4E02B04DQAR; MANUFACTURER_PART_NUMBER TPD4EUSB30DQAR; DIGIKEY_PART_NUMBER 296-28063-1-ND

Connections:
3V3_LAN: C2.1, J1.6 (TRCT2), J1.12 (TRCT1); also elsewhere on the board
ETH_LEDG: J1.20; also elsewhere on the board
ETH_LEDY: J1.18; also elsewhere on the board
GND: C1.2, C2.2, J1.17, J1.19, R1.2, U1.3 (GND), U1.8 (GND); also elsewhere on the board
unnamed: C1.1, J1.S1 (SHIELD), J1.S2 (SHIELD__1), R1.1
TR0_TAP: J1.13 (VC1); also elsewhere on the board
TR1_TAP: J1.14 (VC2); also elsewhere on the board
TR2_TAP: J1.15 (VC3); also elsewhere on the board
TR3_TAP: J1.16 (VC4); also elsewhere on the board
TRD0_N: J1.10 (TRD1-), U1.2 (D1-), U1.9; also elsewhere on the board
TRD0_P: J1.11 (TRD1+), U1.1 (D1+), U1.10; also elsewhere on the board
TRD1_N: J1.5 (TRD2-), U1.5 (D2-), U1.6; also elsewhere on the board
TRD1_P: J1.4 (TRD2+), U1.4 (D2+), U1.7; also elsewhere on the board

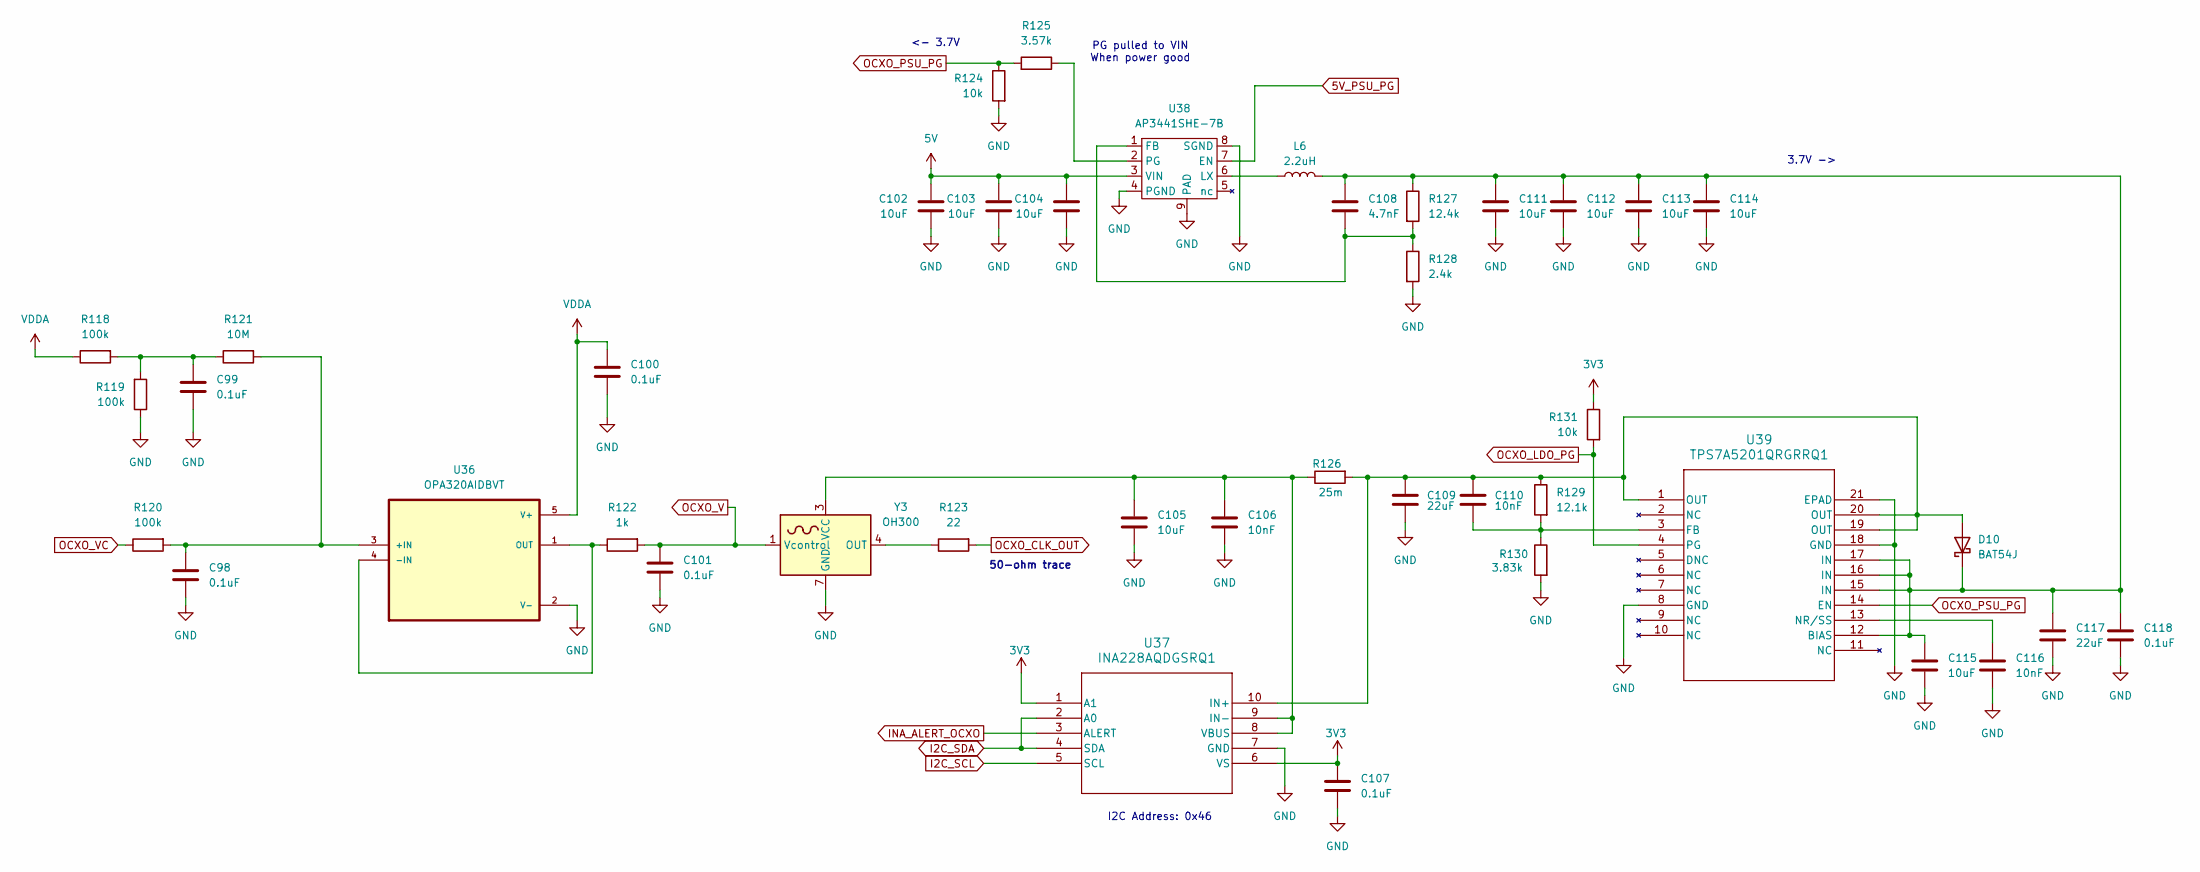
[picture p9: schematic ocxo.kicad_sch]

Parts:
C98, C99, C101: 0.1uF; C_1210_3225Metric; TOLERANCE 5%; VOLTAGE 16V; MANUFACTURER_PART_NUMBER C1210C104J5GACAUTO; DIGIKEY_PART_NUMBER 399-15804-1-ND
C100, C107, C118: 0.1uF; C_0402_1005Metric; TOLERANCE 10%; VOLTAGE 16V; MANUFACTURER_PART_NUMBER GCM155R71C104KA55D; DIGIKEY_PART_NUMBER 490-4759-1-ND
C102, C103, C104, C105, C111, C112, C113, C114, C115: 10uF; C_1206_3216Metric; TOLERANCE 10%; VOLTAGE 16V; MANUFACTURER_PART_NUMBER CL31B106KOHVPNE; DIGIKEY_PART_NUMBER 1276-6797-1-ND
C106, C110, C116: 10nF; C_0402_1005Metric; TOLERANCE 10%; VOLTAGE 16V; MANUFACTURER_PART_NUMBER GRT155R71C103KE01J; DIGIKEY_PART_NUMBER 490-GRT155R71C103KE01JCT-ND
C108: 4.7nF; C_0402_1005Metric; TOLERANCE 10%; VOLTAGE 16V; MANUFACTURER_PART_NUMBER C0402C472K4RECAUTO; DIGIKEY_PART_NUMBER 399-17875-1-ND
C109, C117: 22uF; C_0805_2012Metric; TOLERANCE 10%; VOLTAGE 16V; MANUFACTURER_PART_NUMBER GRT21BR61C226ME13K; DIGIKEY_PART_NUMBER 490-GRT21BR61C226ME13KCT-ND
D10: BAT54J; D_SOD-323F; MANUFACTURER_PART_NUMBER BAT54J-QX; DIGIKEY_PART_NUMBER 1727-BAT54J-QXCT-ND
L6: 2.2uH; DR73-2R2-R; MANUFACTURER_PART_NUMBER DR73-2R2-R; DIGIKEY_PART_NUMBER 283-DR73-2R2-RTR-ND
R118, R119, R120: 100k; R_0402_1005Metric; TOLERANCE 1%; MANUFACTURER_PART_NUMBER ERJ-2RKF1003X; DIGIKEY_PART_NUMBER P100KLCT-ND
R121: 10M; R_0402_1005Metric; TOLERANCE 1%; MANUFACTURER_PART_NUMBER RK73H1ETTP1005F; DIGIKEY_PART_NUMBER 2019-RK73H1ETTP1005FCT-ND
R122: 1k; R_0402_1005Metric; TOLERANCE 1%; MANUFACTURER_PART_NUMBER ERJ-2RKF1001X; DIGIKEY_PART_NUMBER P1.00KLCT-ND
R123: 22; R_0402_1005Metric; TOLERANCE 1%; MANUFACTURER_PART_NUMBER ERJ-2RKF22R0X; DIGIKEY_PART_NUMBER P22.0LCT-ND
R124, R131: 10k; R_0402_1005Metric; TOLERANCE 1%; MANUFACTURER_PART_NUMBER ERJ-2RKF1002X; DIGIKEY_PART_NUMBER P10.0KLCT-ND
R125: 3.57k; R_0402_1005Metric; TOLERANCE 1%; MANUFACTURER_PART_NUMBER ERJ-2RKF3571X; DIGIKEY_PART_NUMBER P3.57KLCT-ND
R126: 25m; R_1206_3216Metric; TOLERANCE 0.5%; MANUFACTURER_PART_NUMBER WSL1206R0250FEA; DIGIKEY_PART_NUMBER WSLC-.025CT-ND
R127: 12.4k; R_0402_1005Metric; TOLERANCE 1%; MANUFACTURER_PART_NUMBER ERJ-2RKF1242X; DIGIKEY_PART_NUMBER P12.4KLCT-ND
R128: 2.4k; R_0402_1005Metric; TOLERANCE 1%; MANUFACTURER_PART_NUMBER ERJ-2RKF2401X; DIGIKEY_PART_NUMBER P12.4KLCT-ND
R129: 12.1k; R_0603_1608Metric; TOLERANCE 0.1%; MANUFACTURER_PART_NUMBER RQ73C1J12K1BTD; DIGIKEY_PART_NUMBER A140146CT-ND
R130: 3.83k; R_0603_1608Metric; TOLERANCE 0.1%; MANUFACTURER_PART_NUMBER RQ73C1J3K83BTD; DIGIKEY_PART_NUMBER A140873CT-ND
U36: OPA320AIDBVT; SOT95P280X145-5N; MANUFACTURER_PART_NUMBER OPA320AIDBVT; DIGIKEY_PART_NUMBER 296-29510-1-ND
U37: INA228AQDGSRQ1; VSSOP10_DGS_TEX; MANUFACTURER_PART_NUMBER INA228AQDGSRQ1; DIGIKEY_PART_NUMBER 296-INA228AQDGSRQ1CT-ND
U38: AP3441SHE-7B; AP3441SHE-7B_DIO-M; MANUFACTURER_PART_NUMBER AP3441SHE-7B; DIGIKEY_PART_NUMBER AP3441SHE-7BDITR-ND
U39: TPS7A5201QRGRRQ1; RGR20_2P05X2P05_TEX; MANUFACTURER_PART_NUMBER TPS7A5201QRGRRQ1; DIGIKEY_PART_NUMBER 296-50505-1-ND
Y3: OH300; Oscillator_SMD_OCXO_ConnorWinfield_OH300; MANUFACTURER_PART_NUMBER OH300-61003CV-010.0M; DIGIKEY_PART_NUMBER CW752CT-ND

Connections:
3V3: C107.1, R131.1, U37.1 (A1), U37.6 (VS); also elsewhere on the board
5V: C102.1, C103.1, C104.1, U38.3 (VIN); also elsewhere on the board
5V_PSU_PG: U38.7 (EN); also elsewhere on the board
GND: C98.2, C99.2, C100.2, C101.2, C102.2, C103.2, C104.2, C105.2, C106.2, C107.2, C109.2, C111.2, C112.2, C113.2, C114.2, C115.2, C116.2, C117.2, C118.2, R119.1, R124.2, R128.2, R130.2, U36.2 (V-), U37.7 (GND), U38.4 (PGND), U38.8 (SGND), U38.9 (PAD), U39.8 (GND), U39.18 (GND), U39.21 (EPAD), Y3.7 (GND); also elsewhere on the board
I2C_SCL: U37.5 (SCL); also elsewhere on the board
I2C_SDA: U37.2 (A0), U37.4 (SDA); also elsewhere on the board
INA_ALERT_OCXO: U37.3 (ALERT); also elsewhere on the board
unnamed: C99.1, R118.2, R119.2, R121.1
unnamed: C109.1, C110.1, D10.2 (A), R126.2, R129.1, U37.10 (IN+), U39.1 (OUT), U39.19 (OUT), U39.20 (OUT)
unnamed: C108.1, C111.1, C112.1, C113.1, C114.1, C115.1, C117.1, C118.1, D10.1 (K), L6.2, R127.1, U39.12 (BIAS), U39.15 (IN), U39.16 (IN), U39.17 (IN)
unnamed: C98.1, R120.2, R121.2, U36.3 (+IN)
unnamed: R122.1, U36.1 (OUT), U36.4 (-IN)
unnamed: C105.1, C106.1, R126.1, U37.8 (VBUS), U37.9 (IN-), Y3.3 (VCC)
unnamed: C108.2, R127.2, R128.1, U38.1 (FB)
unnamed: L6.1, U38.6 (LX)
unnamed: R125.1, U38.2 (PG)
unnamed: C110.2, R129.2, R130.1, U39.3 (FB)
unnamed: C116.1, U39.13 (NR/SS)
unnamed: R123.1, Y3.4 (OUT)
OCXO_CLK_OUT: R123.2; also elsewhere on the board
OCXO_LDO_PG: R131.2, U39.4 (PG); also elsewhere on the board
OCXO_PSU_PG: R124.1, R125.2, U39.14 (EN); also elsewhere on the board
OCXO_V: C101.1, R122.2, Y3.1 (Vcontrol); also elsewhere on the board
OCXO_VC: R120.1; also elsewhere on the board
VDDA: C100.1, R118.1, U36.5 (V+); also elsewhere on the board

Notes on the sheet:
3.7V ->
<- 3.7V
PG pulled to VIN When power good
I2C Address: 0x46
50-ohm trace

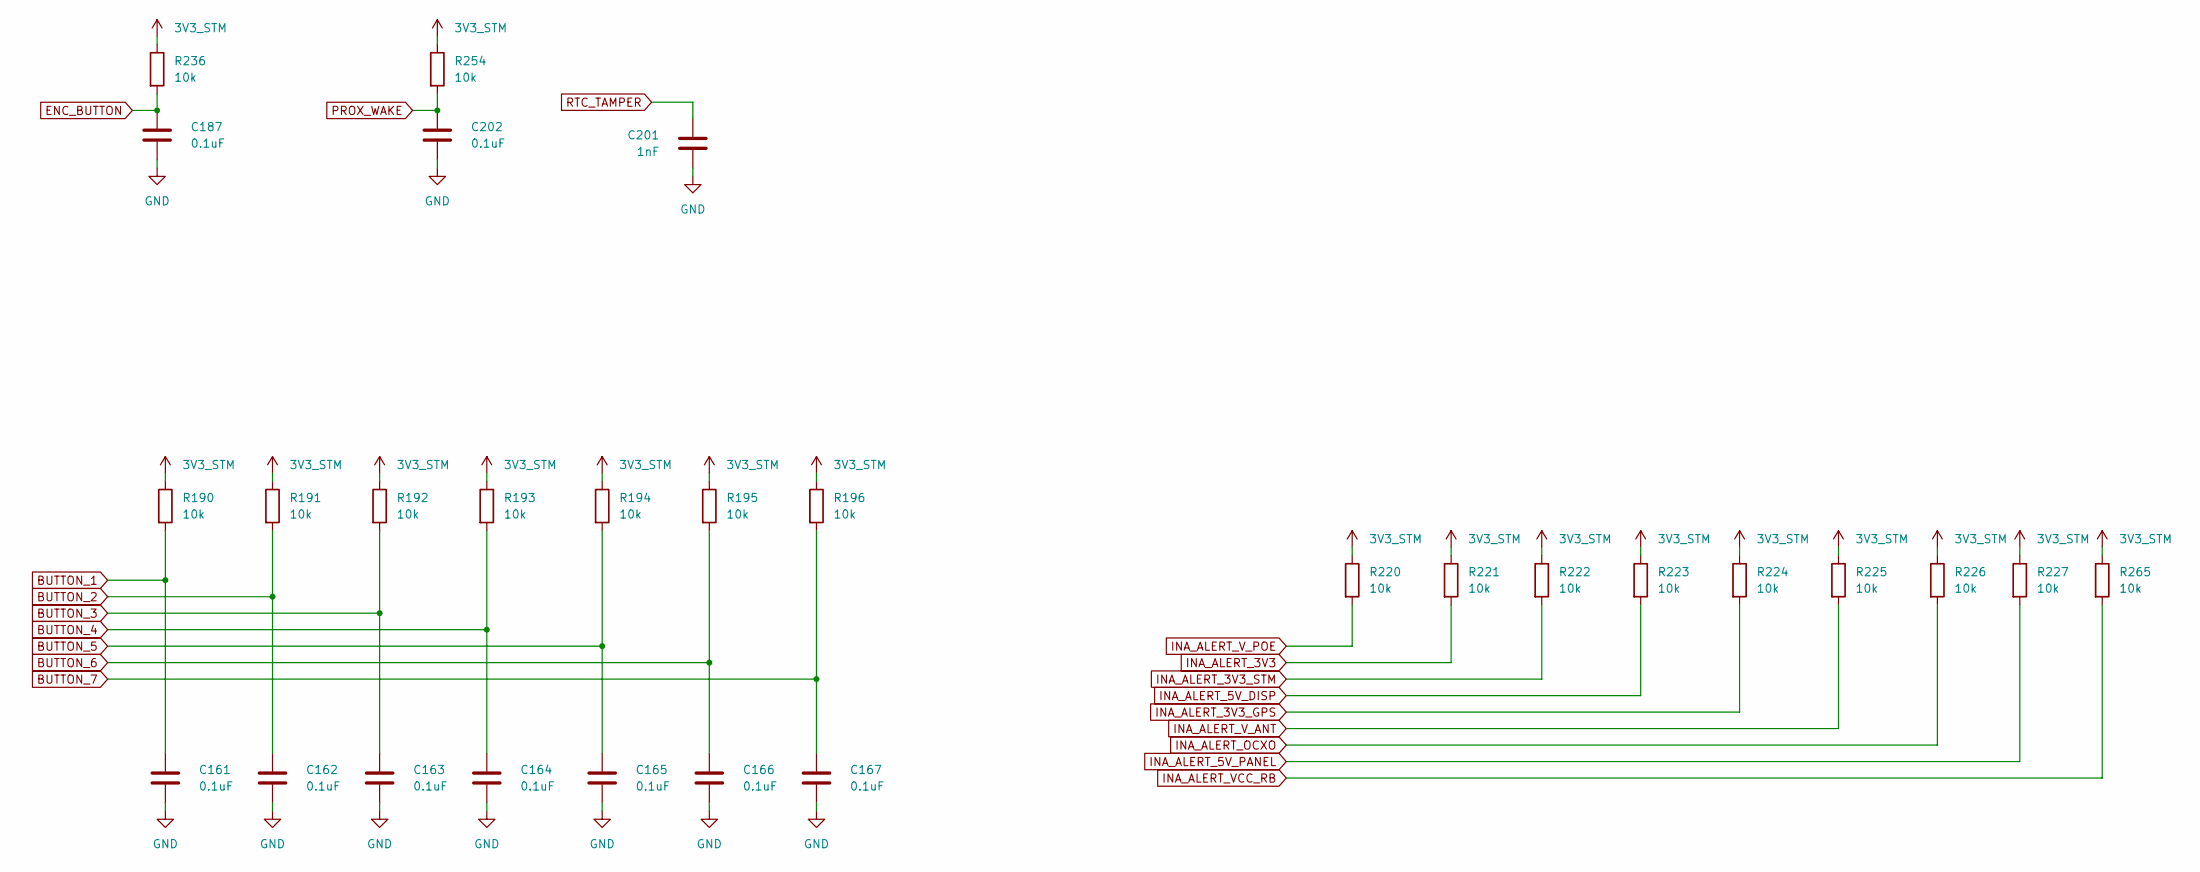
[picture p10: schematic i2c-gpio.kicad_sch]

Parts:
C161, C162, C163, C164, C165, C166, C167, C187, C202: 0.1uF; C_0402_1005Metric; TOLERANCE 10%; VOLTAGE 16V; MANUFACTURER_PART_NUMBER GCM155R71C104KA55D; DIGIKEY_PART_NUMBER 490-4759-1-ND
C201: 1nF; C_0402_1005Metric; TOLERANCE 5%; VOLTAGE 50V; MANUFACTURER_PART_NUMBER C0402C102J5GECAUTO; DIGIKEY_PART_NUMBER 399-C0402C102J5GECAUTOCT-ND
R190, R191, R192, R193, R194, R195, R196, R220, R221, R222, R223, R224, R225, R226, R227, R236, R254, R265: 10k; R_0402_1005Metric; TOLERANCE 1%; MANUFACTURER_PART_NUMBER ERJ-2RKF1002X; DIGIKEY_PART_NUMBER P10.0KLCT-ND

Connections:
3V3_STM: R190.1, R191.1, R192.1, R193.1, R194.1, R195.1, R196.1, R220.1, R221.1, R222.1, R223.1, R224.1, R225.1, R226.1, R227.1, R236.1, R254.1, R265.1; also elsewhere on the board
BUTTON_1: C161.1, R190.2; also elsewhere on the board
BUTTON_2: C162.1, R191.2; also elsewhere on the board
BUTTON_3: C163.1, R192.2; also elsewhere on the board
BUTTON_4: C164.1, R193.2; also elsewhere on the board
BUTTON_5: C165.1, R194.2; also elsewhere on the board
BUTTON_6: C166.1, R195.2; also elsewhere on the board
BUTTON_7: C167.1, R196.2; also elsewhere on the board
ENC_BUTTON: C187.1, R236.2; also elsewhere on the board
GND: C161.2, C162.2, C163.2, C164.2, C165.2, C166.2, C167.2, C187.2, C201.2, C202.2; also elsewhere on the board
INA_ALERT_3V3: R221.2; also elsewhere on the board
INA_ALERT_3V3_GPS: R224.2; also elsewhere on the board
INA_ALERT_3V3_STM: R222.2; also elsewhere on the board
INA_ALERT_5V_DISP: R223.2; also elsewhere on the board
INA_ALERT_5V_PANEL: R227.2; also elsewhere on the board
INA_ALERT_OCXO: R226.2; also elsewhere on the board
INA_ALERT_VCC_RB: R265.2; also elsewhere on the board
INA_ALERT_V_ANT: R225.2; also elsewhere on the board
INA_ALERT_V_POE: R220.2; also elsewhere on the board
PROX_WAKE: C202.1, R254.2; also elsewhere on the board
RTC_TAMPER: C201.1; also elsewhere on the board

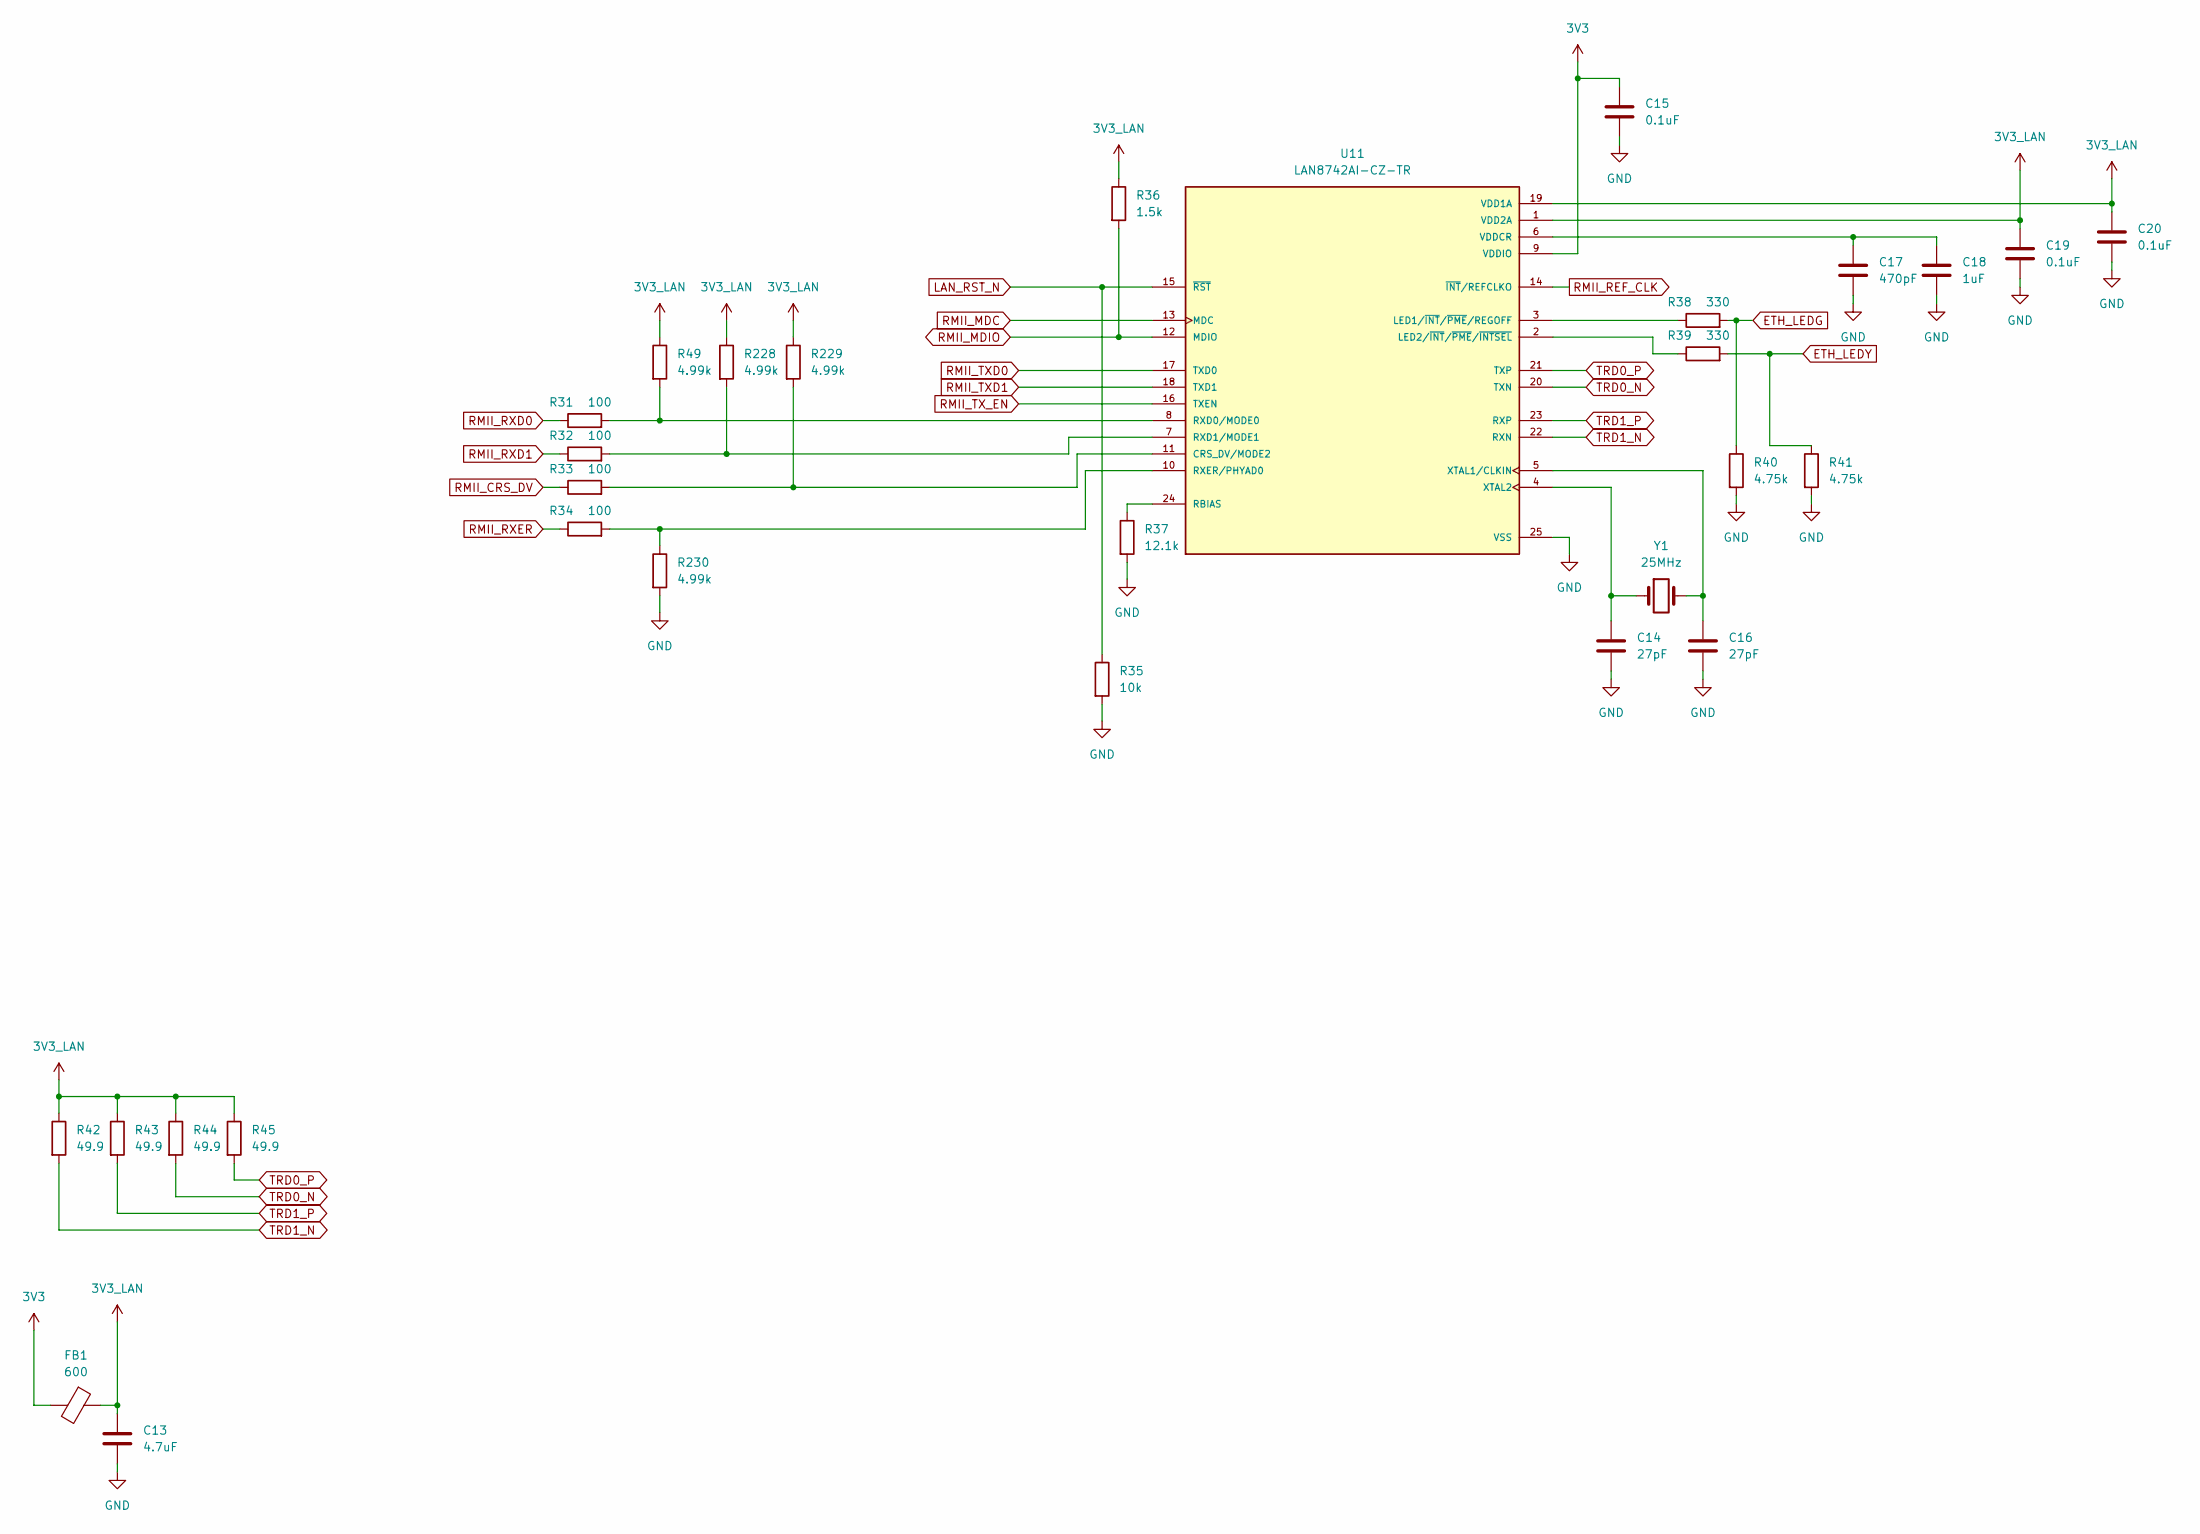
[picture p11: schematic ethernet-phy.kicad_sch]

Parts:
C13: 4.7uF; C_0805_2012Metric; TOLERANCE 10%; VOLTAGE 16V; MANUFACTURER_PART_NUMBER GRT21BR71C475KE13K; DIGIKEY_PART_NUMBER 490-GRT21BR71C475KE13KCT-ND
C14, C16: 27pF; C_0402_1005Metric; TOLERANCE 5%; VOLTAGE 50V; MANUFACTURER_PART_NUMBER GCM1555C1H270JA16D; DIGIKEY_PART_NUMBER 490-12651-1-ND
C15, C19, C20: 0.1uF; C_0402_1005Metric; TOLERANCE 10%; VOLTAGE 16V; MANUFACTURER_PART_NUMBER GCM155R71C104KA55D; DIGIKEY_PART_NUMBER 490-4759-1-ND
C17: 470pF; C_0402_1005Metric; TOLERANCE 5%; VOLTAGE 50V; MANUFACTURER_PART_NUMBER GCM1555C1H471FA16D; DIGIKEY_PART_NUMBER 490-GCM1555C1H471FA16DCT-ND
C18: 1uF; C_0603_1608Metric; TOLERANCE 10%; VOLTAGE 16V; MANUFACTURER_PART_NUMBER C0603C105K4RACAUTO; DIGIKEY_PART_NUMBER 399-17704-1-ND
FB1: 600; 1206; MANUFACTURER_PART_NUMBER BLM31PG601SN1L; DIGIKEY_PART_NUMBER 490-16533-1-ND
R31, R32, R33, R34: 100; R_0402_1005Metric; TOLERANCE 1%; MANUFACTURER_PART_NUMBER ERJ-2RKF1000X; DIGIKEY_PART_NUMBER P100LCT-ND
R35: 10k; R_0402_1005Metric; TOLERANCE 1%; MANUFACTURER_PART_NUMBER ERJ-2RKF1002X; DIGIKEY_PART_NUMBER P10.0KLCT-ND
R36: 1.5k; R_0402_1005Metric; TOLERANCE 1%; MANUFACTURER_PART_NUMBER ERJ-2RKF1501X; DIGIKEY_PART_NUMBER P1.50KLCT-ND
R37: 12.1k; R_0402_1005Metric; TOLERANCE 1%; MANUFACTURER_PART_NUMBER ERJ-2RKF1212X; DIGIKEY_PART_NUMBER P12.1KLCT-ND
R38, R39: 330; R_0402_1005Metric; TOLERANCE 1%; MANUFACTURER_PART_NUMBER ERJ-2RKF3300X; DIGIKEY_PART_NUMBER P330LCT-ND
R40, R41: 4.75k; R_0402_1005Metric; TOLERANCE 1%; MANUFACTURER_PART_NUMBER RK73H1ERTTP4751F; DIGIKEY_PART_NUMBER 2019-RK73H1ERTTP4751FCT-ND
R42, R43, R44, R45: 49.9; R_0402_1005Metric; TOLERANCE 1%; MANUFACTURER_PART_NUMBER ERJ-2RKF49R9X; DIGIKEY_PART_NUMBER P49.9LCT-ND
R49, R228, R229, R230: 4.99k; R_0402_1005Metric; TOLERANCE 1%; MANUFACTURER_PART_NUMBER ERJ-2RKF4991X; DIGIKEY_PART_NUMBER P4.99KLCT-ND
U11: LAN8742AI-CZ-TR; QFN50P400X400X100-25N; MANUFACTURER_PART_NUMBER LAN8742AI-CZ-TR; DIGIKEY_PART_NUMBER LAN8742AI-CZ-CT-ND
Y1: 25MHz; 445I23E25M00000; MANUFACTURER_PART_NUMBER 445I23E25M00000; DIGIKEY_PART_NUMBER 110-445I23E25M00000CT-ND

Connections:
3V3: C15.1, FB1.2, U11.9 (VDDIO); also elsewhere on the board
3V3_LAN: C13.1, C19.1, C20.1, FB1.1, R36.1, R42.1, R43.1, R44.1, R45.1, R49.1, R228.1, R229.1, U11.1 (VDD2A), U11.19 (VDD1A); also elsewhere on the board
ETH_LEDG: R38.2, R40.1; also elsewhere on the board
ETH_LEDY: R39.2, R41.1; also elsewhere on the board
GND: C13.2, C14.2, C15.2, C16.2, C17.2, C18.2, C19.2, C20.2, R35.2, R37.2, R40.2, R41.2, R230.2, U11.25 (VSS); also elsewhere on the board
LAN_RST_N: R35.1, U11.15 (~RST); also elsewhere on the board
unnamed: R33.2, R229.2, U11.11 (CRS_DV/MODE2)
unnamed: R38.1, U11.3 (LED1/~INT/~PME/REGOFF)
unnamed: R39.1, U11.2 (LED2/~INT/~PME/~INTSEL)
unnamed: R37.1, U11.24 (RBIAS)
unnamed: R31.2, R49.2, U11.8 (RXD0/MODE0)
unnamed: R32.2, R228.2, U11.7 (RXD1/MODE1)
unnamed: R34.2, R230.1, U11.10 (RXER/PHYAD0)
unnamed: C17.1, C18.1, U11.6 (VDDCR)
unnamed: C16.1, U11.5 (XTAL1/CLKIN), Y1.2
unnamed: C14.1, U11.4 (XTAL2), Y1.1
RMII_CRS_DV: R33.1; also elsewhere on the board
RMII_MDC: U11.13 (MDC); also elsewhere on the board
RMII_MDIO: R36.2, U11.12 (MDIO); also elsewhere on the board
RMII_REF_CLK: U11.14 (~INT/REFCLKO); also elsewhere on the board
RMII_RXD0: R31.1; also elsewhere on the board
RMII_RXD1: R32.1; also elsewhere on the board
RMII_RXER: R34.1; also elsewhere on the board
RMII_TXD0: U11.17 (TXD0); also elsewhere on the board
RMII_TXD1: U11.18 (TXD1); also elsewhere on the board
RMII_TX_EN: U11.16 (TXEN); also elsewhere on the board
TRD0_N: R44.2, U11.20 (TXN); also elsewhere on the board
TRD0_P: R45.2, U11.21 (TXP); also elsewhere on the board
TRD1_N: R42.2, U11.22 (RXN); also elsewhere on the board
TRD1_P: R43.2, U11.23 (RXP); also elsewhere on the board
