rcldesign/ntp-server-stm32/hardware/ntp-server-stm32/ntp-server-stm32.kicad_pcb

## KiCad design hardware/ntp-server-stm32/ntp-server-stm32.kicad_pcb (continued)

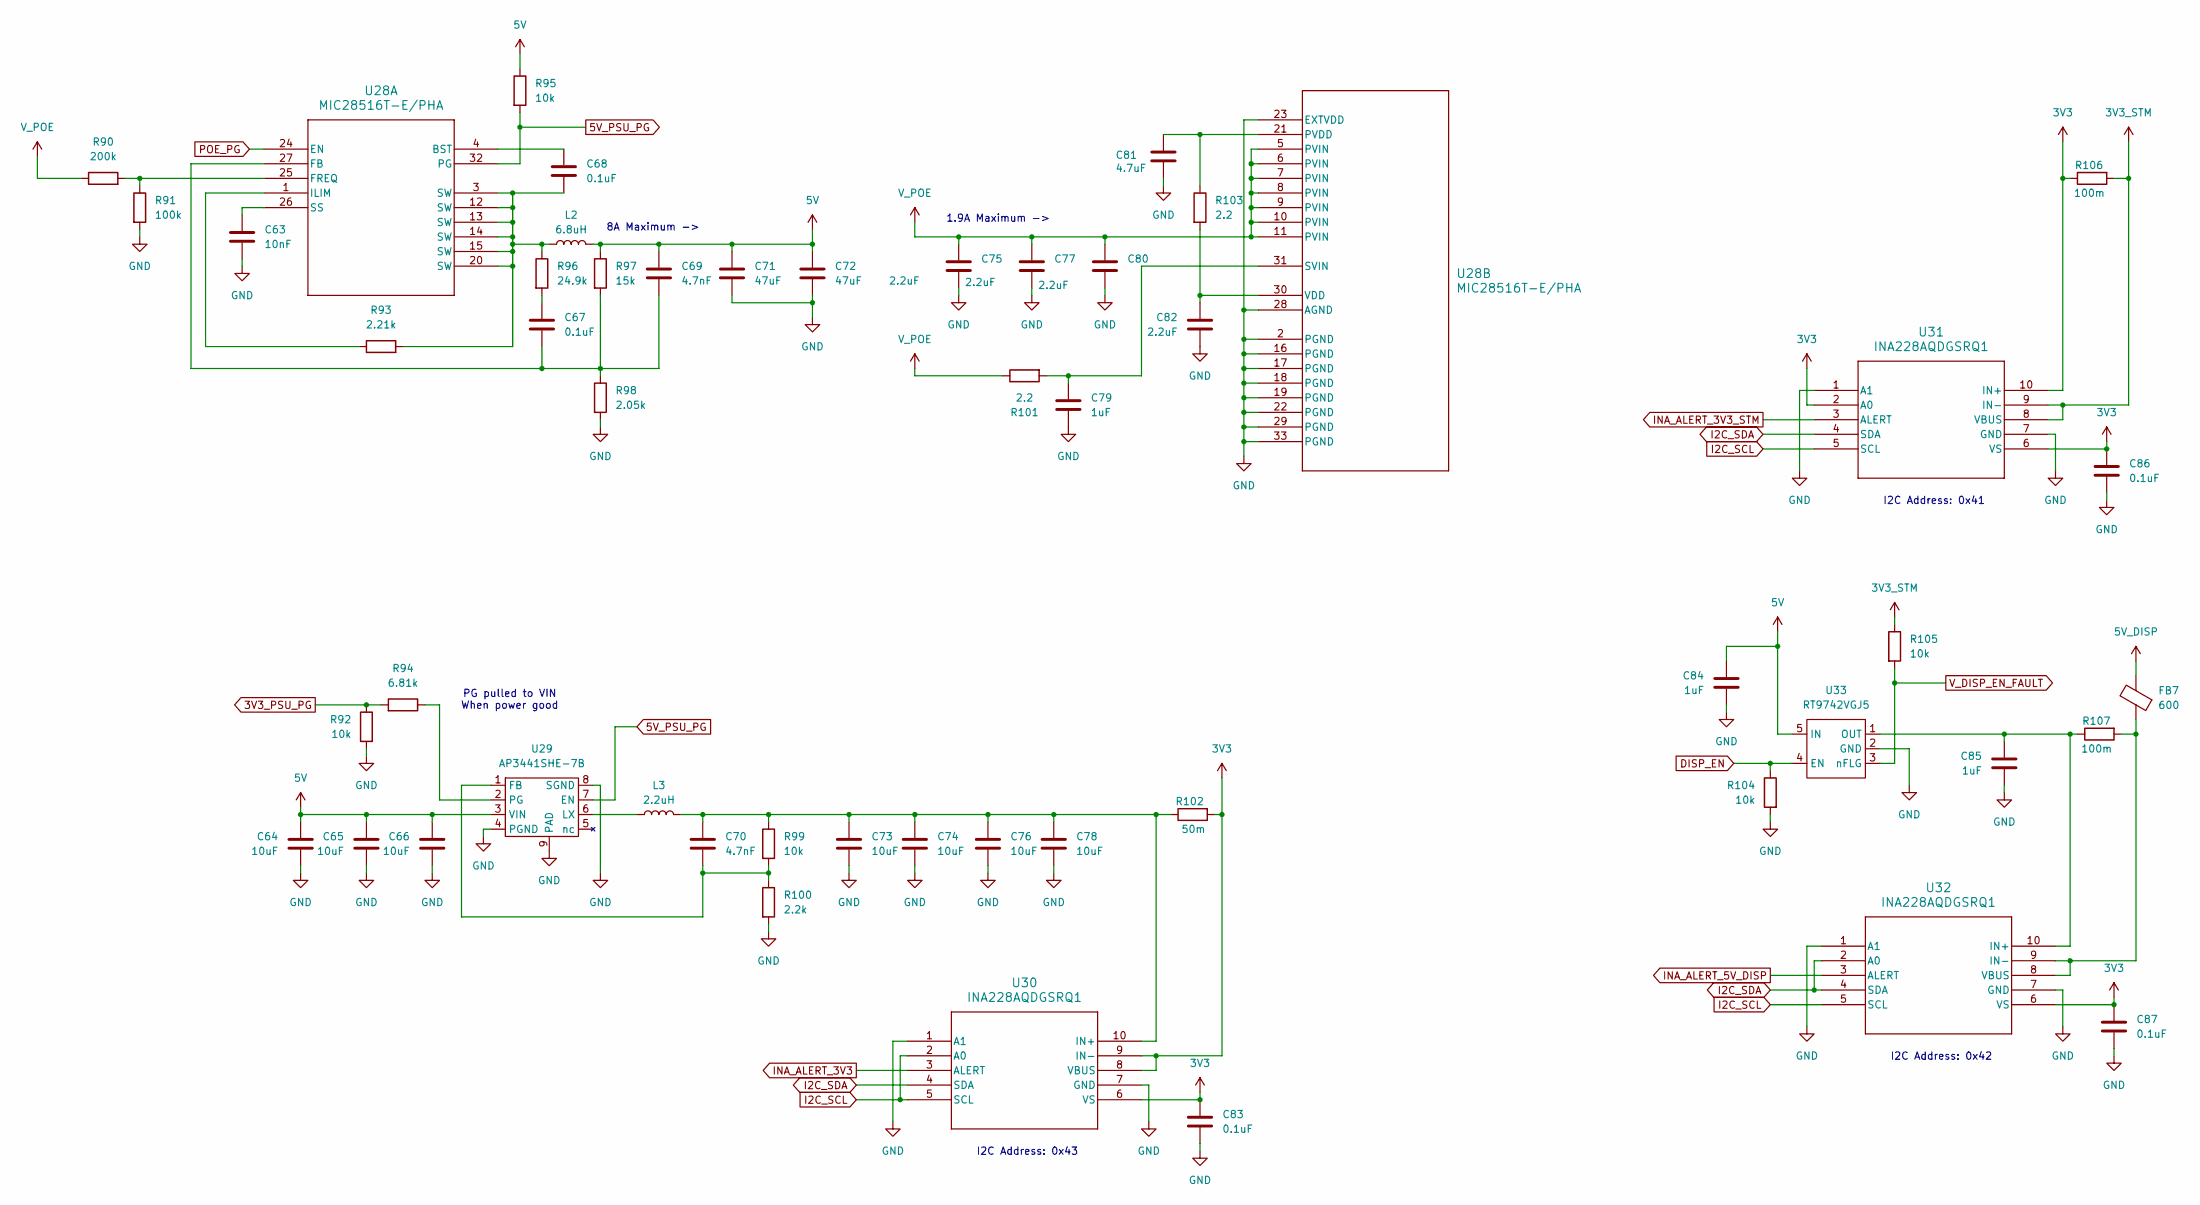
[picture p12: schematic 3v3-main-power.kicad_sch]

Parts:
C63: 10nF; C_0402_1005Metric; TOLERANCE 10%; VOLTAGE 16V; MANUFACTURER_PART_NUMBER GRT155R71C103KE01J; DIGIKEY_PART_NUMBER 490-GRT155R71C103KE01JCT-ND
C64, C65, C66, C73, C74, C76, C78: 10uF; C_1206_3216Metric; TOLERANCE 10%; VOLTAGE 16V; MANUFACTURER_PART_NUMBER CL31B106KOHVPNE; DIGIKEY_PART_NUMBER 1276-6797-1-ND
C67, C68, C83, C86, C87: 0.1uF; C_0402_1005Metric; TOLERANCE 10%; VOLTAGE 16V; MANUFACTURER_PART_NUMBER GCM155R71C104KA55D; DIGIKEY_PART_NUMBER 490-4759-1-ND
C69, C70: 4.7nF; C_0402_1005Metric; TOLERANCE 10%; VOLTAGE 16V; MANUFACTURER_PART_NUMBER C0402C472K4RECAUTO; DIGIKEY_PART_NUMBER 399-17875-1-ND
C71, C72: 47uF; C_1210_3225Metric; TOLERANCE 10%; VOLTAGE 16V; MANUFACTURER_PART_NUMBER GRT32EC81C476KE13L; DIGIKEY_PART_NUMBER 490-12494-1-ND
C75, C77, C80: 2.2uF; C_2220_5750Metric; TOLERANCE 10%; VOLTAGE 100V; MANUFACTURER_PART_NUMBER CGA9P3X7T2E225K250KA; DIGIKEY_PART_NUMBER 445-7950-1-ND
C79: 1uF; C_0805_2012Metric; TOLERANCE 10%; VOLTAGE 100V; MANUFACTURER_PART_NUMBER 08051C105K4T2A; DIGIKEY_PART_NUMBER 478-KAM21KR72A105KUCT-ND
C81: 4.7uF; C_0805_2012Metric; TOLERANCE 10%; VOLTAGE 16V; MANUFACTURER_PART_NUMBER GRT21BR71C475KE13K; DIGIKEY_PART_NUMBER 490-GRT21BR71C475KE13KCT-ND
C82: 2.2uF; C_0805_2012Metric; TOLERANCE 10%; VOLTAGE 16V; MANUFACTURER_PART_NUMBER GRT21BR71C225KE01L; DIGIKEY_PART_NUMBER 490-GRT21BR71C225KE01LCT-ND
C84, C85: 1uF; C_0603_1608Metric; TOLERANCE 10%; VOLTAGE 16V; MANUFACTURER_PART_NUMBER C0603C105K4RACAUTO; DIGIKEY_PART_NUMBER 399-17704-1-ND
FB7: 600; 1206; MANUFACTURER_PART_NUMBER BLM31PG601SN1L; DIGIKEY_PART_NUMBER 490-16533-1-ND
L2: 6.8uH; SRP1265A-6R8M; MANUFACTURER_PART_NUMBER SRP1265A-6R8M; DIGIKEY_PART_NUMBER SRP1265A-6R8MTR-ND
L3: 2.2uH; DR73-2R2-R; MANUFACTURER_PART_NUMBER DR73-2R2-R; DIGIKEY_PART_NUMBER 283-DR73-2R2-RTR-ND
R90: 200k; R_0402_1005Metric; TOLERANCE 1%; MANUFACTURER_PART_NUMBER ERJ-2RKF2003X; DIGIKEY_PART_NUMBER P200KLCT-ND
R91: 100k; R_0402_1005Metric; TOLERANCE 1%; MANUFACTURER_PART_NUMBER ERJ-2RKF1003X; DIGIKEY_PART_NUMBER P100KLCT-ND
R92, R95, R99, R104, R105: 10k; R_0402_1005Metric; TOLERANCE 1%; MANUFACTURER_PART_NUMBER ERJ-2RKF1002X; DIGIKEY_PART_NUMBER P10.0KLCT-ND
R93: 2.21k; R_0402_1005Metric; TOLERANCE 1%; MANUFACTURER_PART_NUMBER ERJ-2RKF2211X; DIGIKEY_PART_NUMBER P2.21KLCT-ND
R94: 6.81k; R_0402_1005Metric; TOLERANCE 1%; MANUFACTURER_PART_NUMBER ERJ-2RKF6811X; DIGIKEY_PART_NUMBER P6.81KLTR-ND
R96: 24.9k; R_0402_1005Metric; TOLERANCE 1%; MANUFACTURER_PART_NUMBER ERJ-2RKF2492X; DIGIKEY_PART_NUMBER P24.9KLCT-ND
R97: 15k; R_0402_1005Metric; TOLERANCE 1%; MANUFACTURER_PART_NUMBER RK73H1ETTP1502F; DIGIKEY_PART_NUMBER 2019-RK73H1ETTP1502FCT-ND
R98: 2.05k; R_0402_1005Metric; TOLERANCE 1%; MANUFACTURER_PART_NUMBER ERJ-2RKF2051X; DIGIKEY_PART_NUMBER P2.05KLTR-ND
R100: 2.2k; R_0402_1005Metric; TOLERANCE 1%; MANUFACTURER_PART_NUMBER ERJ-2RKF2201X; DIGIKEY_PART_NUMBER P2.20KLCT-ND
R101, R103: 2.2; R_0402_1005Metric; TOLERANCE 1%; MANUFACTURER_PART_NUMBER ERJ-U02F2R20X; DIGIKEY_PART_NUMBER 10-ERJ-U02F2R20XTR-ND
R102: 50m; R_1206_3216Metric; TOLERANCE 0.5%; MANUFACTURER_PART_NUMBER WSL1206R0500FEA; DIGIKEY_PART_NUMBER WSLC-.05CT-ND
R106, R107: 100m; R_1206_3216Metric; TOLERANCE 0.5%; MANUFACTURER_PART_NUMBER WSL1206R1000FEA; DIGIKEY_PART_NUMBER WSLC-.10CT-ND
U28: MIC28516T-E/PHA; MIC28516T-EPHA; MANUFACTURER_PART_NUMBER MIC28516T-E/PHA; DIGIKEY_PART_NUMBER 150-MIC28516T-E/PHATR-ND
U29: AP3441SHE-7B; AP3441SHE-7B_DIO-M; MANUFACTURER_PART_NUMBER AP3441SHE-7B; DIGIKEY_PART_NUMBER AP3441SHE-7BDITR-ND
U30, U31, U32: INA228AQDGSRQ1; VSSOP10_DGS_TEX; MANUFACTURER_PART_NUMBER INA228AQDGSRQ1; DIGIKEY_PART_NUMBER 296-INA228AQDGSRQ1CT-ND
U33: RT9742VGJ5; TSOT-23-5; MANUFACTURER_PART_NUMBER RT9742VGJ5; DIGIKEY_PART_NUMBER 1028-RT9742VGJ5TR-ND

Connections:
3V3: C83.1, C86.1, C87.1, R102.2, R106.1, U30.6 (VS), U30.8 (VBUS), U30.9 (IN-), U31.2 (A0), U31.6 (VS), U31.10 (IN+), U32.6 (VS); also elsewhere on the board
3V3_PSU_PG: R92.1, R94.2; also elsewhere on the board
3V3_STM: R105.1, R106.2, U31.8 (VBUS), U31.9 (IN-); also elsewhere on the board
5V: C64.1, C65.1, C66.1, C69.1, C71.1, C72.1, C84.1, L2.2, R95.1, R97.1, U29.3 (VIN), U33.5 (IN); also elsewhere on the board
5V_DISP: FB7.2; also elsewhere on the board
5V_PSU_PG: R95.2, U28.32 (PG), U29.7 (EN); also elsewhere on the board
DISP_EN: R104.1, U33.4 (EN); also elsewhere on the board
GND: C63.2, C64.2, C65.2, C66.2, C71.2, C72.2, C73.2, C74.2, C75.2, C76.2, C77.2, C78.2, C79.2, C80.2, C81.2, C82.2, C83.2, C84.2, C85.2, C86.2, C87.2, R91.2, R92.2, R98.2, R100.2, R104.2, U28.2 (PGND), U28.16 (PGND), U28.17 (PGND), U28.18 (PGND), U28.19 (PGND), U28.22 (PGND), U28.23 (EXTVDD), U28.28 (AGND), U28.29 (PGND), U28.33 (PGND), U29.4 (PGND), U29.8 (SGND), U29.9 (PAD), U30.1 (A1), U30.7 (GND), U31.1 (A1), U31.7 (GND), U32.1 (A1), U32.7 (GND), U33.2 (GND); also elsewhere on the board
I2C_SCL: U30.2 (A0), U30.5 (SCL), U31.5 (SCL), U32.5 (SCL); also elsewhere on the board
I2C_SDA: U30.4 (SDA), U31.4 (SDA), U32.2 (A0), U32.4 (SDA); also elsewhere on the board
INA_ALERT_3V3: U30.3 (ALERT); also elsewhere on the board
INA_ALERT_3V3_STM: U31.3 (ALERT); also elsewhere on the board
INA_ALERT_5V_DISP: U32.3 (ALERT); also elsewhere on the board
unnamed: C67.1, R96.2
unnamed: C68.2, L2.1, R93.2, R96.1, U28.3 (SW), U28.12 (SW), U28.13 (SW), U28.14 (SW), U28.15 (SW), U28.20 (SW)
unnamed: C68.1, U28.4 (BST)
unnamed: C67.2, C69.2, R97.2, R98.1, U28.27 (FB)
unnamed: R90.2, R91.1, U28.25 (FREQ)
unnamed: R93.1, U28.1 (ILIM)
unnamed: C63.1, U28.26 (SS)
unnamed: C81.1, R103.1, U28.21 (PVDD)
unnamed: C79.1, R101.2, U28.31 (SVIN)
unnamed: C82.1, R103.2, U28.30 (VDD)
unnamed: C70.2, R99.2, R100.1, U29.1 (FB)
unnamed: L3.1, U29.6 (LX)
unnamed: R94.1, U29.2 (PG)
unnamed: C70.1, C73.1, C74.1, C76.1, C78.1, L3.2, R99.1, R102.1, U30.10 (IN+)
unnamed: C85.1, R107.1, U32.10 (IN+), U33.1 (OUT)
unnamed: FB7.1, R107.2, U32.8 (VBUS), U32.9 (IN-)
POE_PG: U28.24 (EN); also elsewhere on the board
V_DISP_EN_FAULT: R105.2, U33.3 (nFLG); also elsewhere on the board
V_POE: C75.1, C77.1, C80.1, R90.1, R101.1, U28.5 (PVIN), U28.6 (PVIN), U28.7 (PVIN), U28.8 (PVIN), U28.9 (PVIN), U28.10 (PVIN), U28.11 (PVIN); also elsewhere on the board

Notes on the sheet:
I2C Address: 0x41
1.9A Maximum ->
PG pulled to VIN When power good
I2C Address: 0x42
I2C Address: 0x43
8A Maximum ->

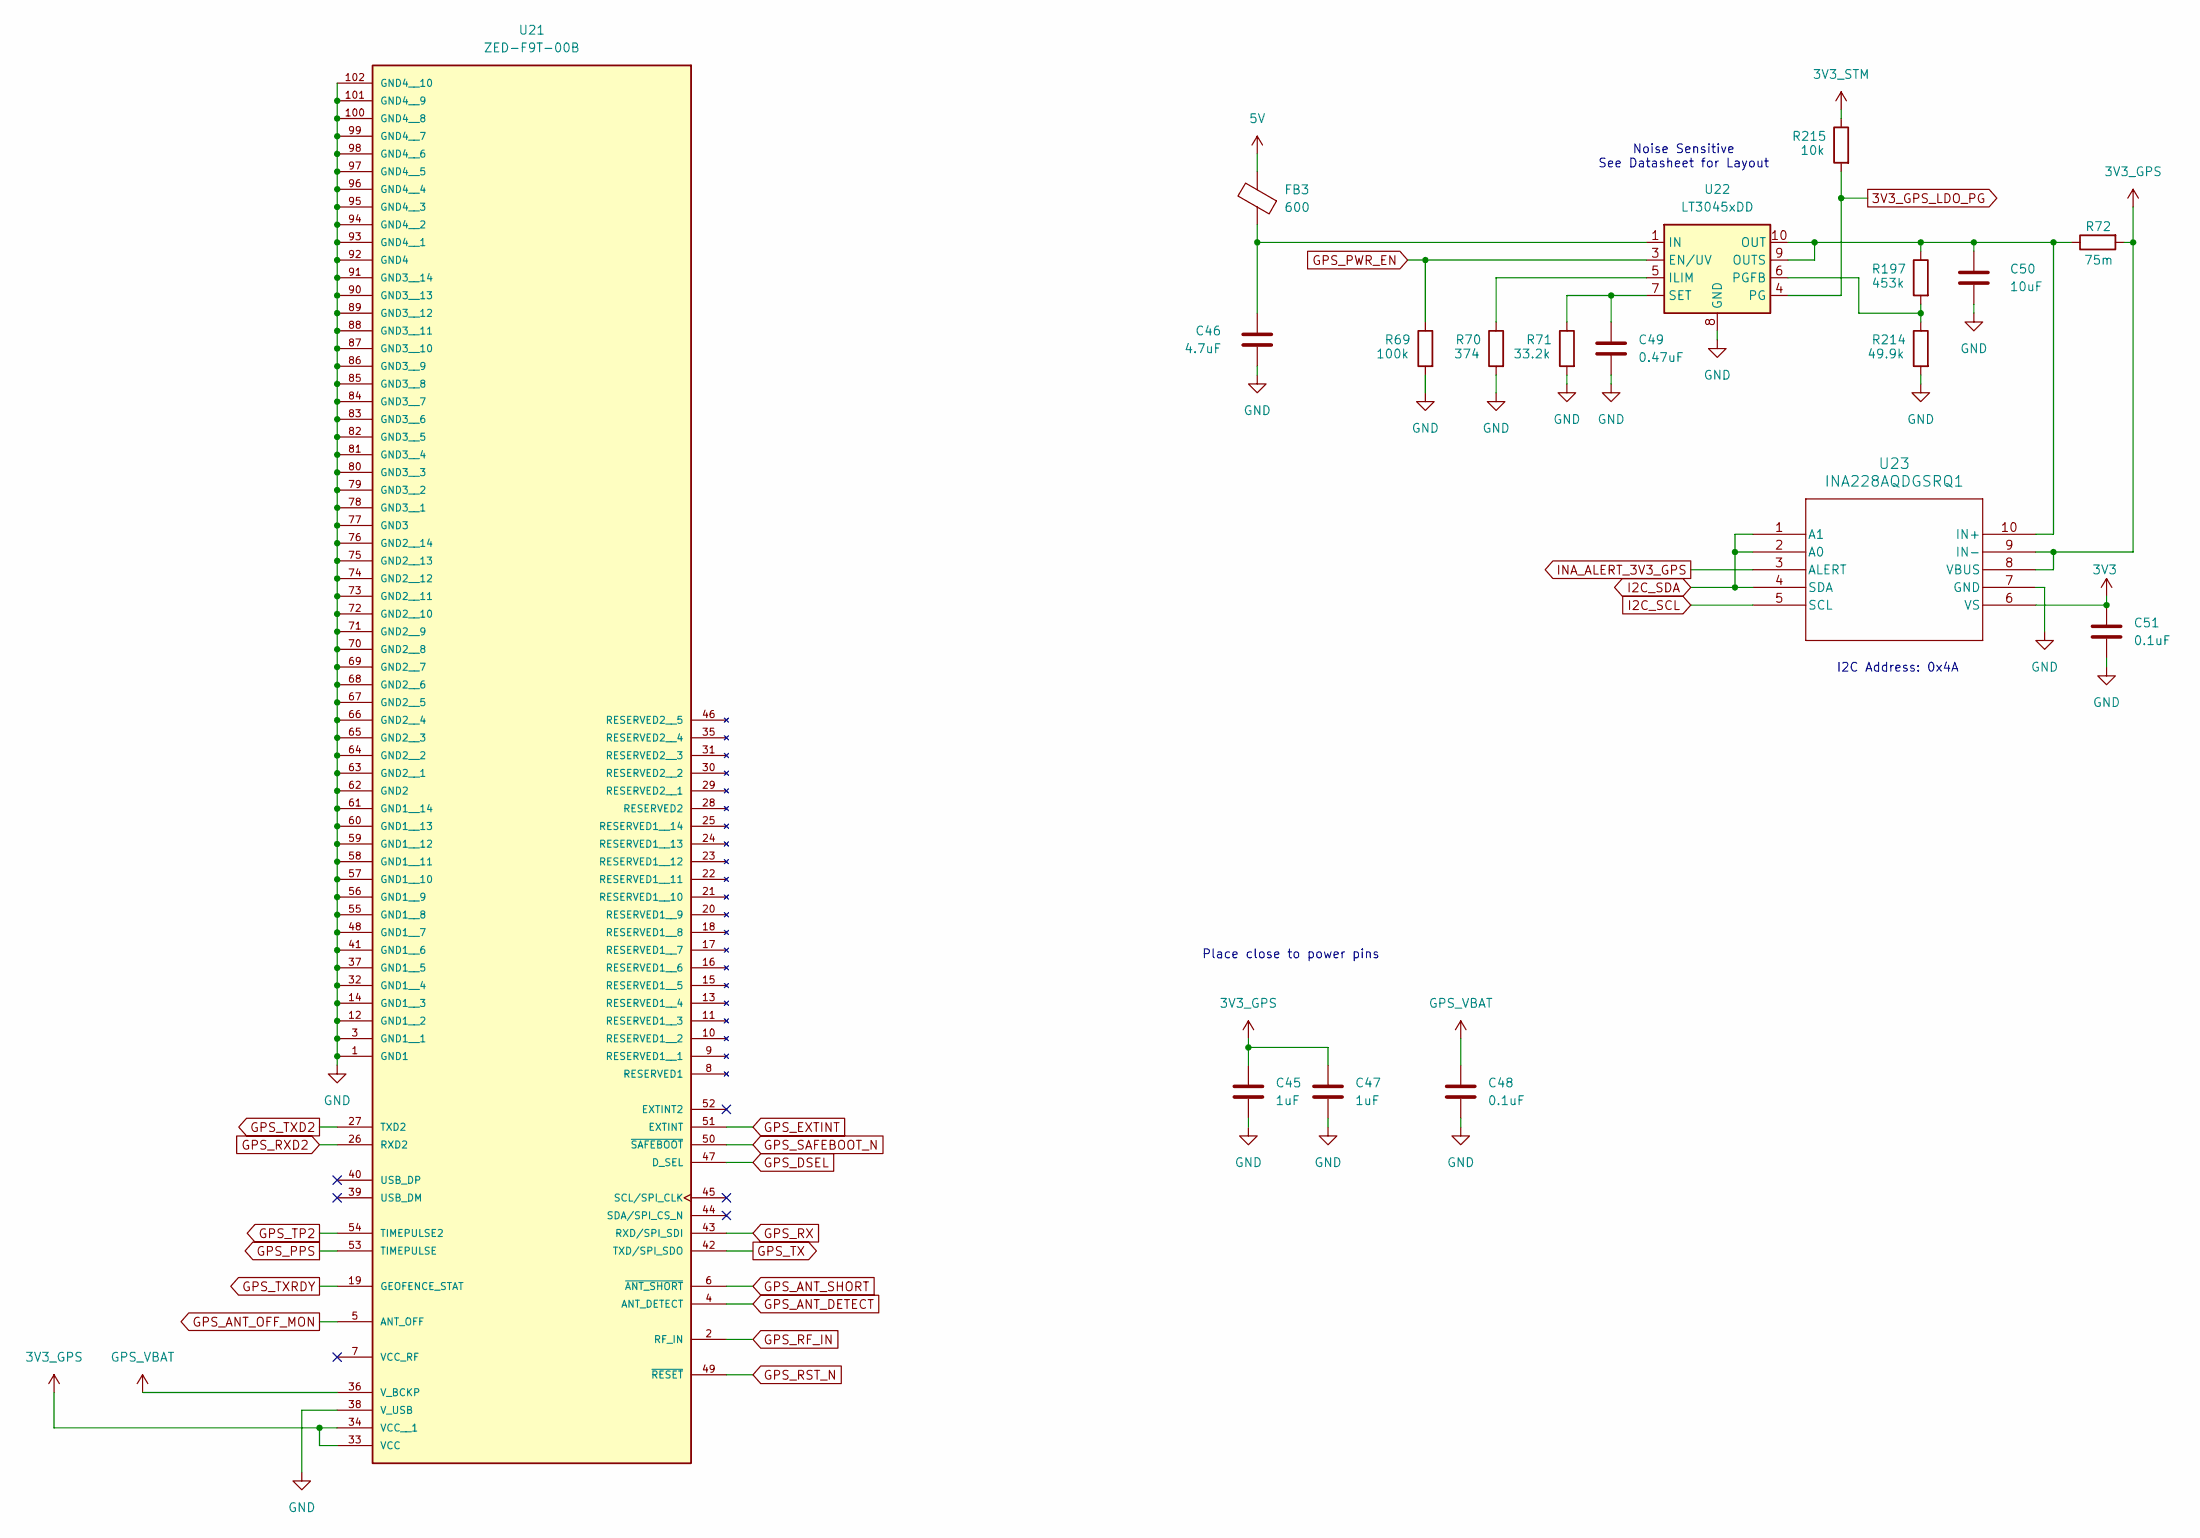
[picture p13: schematic gps.kicad_sch]

Parts:
C45, C47: 1uF; C_0603_1608Metric; TOLERANCE 10%; VOLTAGE 16V; MANUFACTURER_PART_NUMBER C0603C105K4RACAUTO; DIGIKEY_PART_NUMBER 399-17704-1-ND
C46: 4.7uF; C_0805_2012Metric; TOLERANCE 10%; VOLTAGE 16V; MANUFACTURER_PART_NUMBER GRT21BR71C475KE13K; DIGIKEY_PART_NUMBER 490-GRT21BR71C475KE13KCT-ND
C48, C51: 0.1uF; C_0402_1005Metric; TOLERANCE 10%; VOLTAGE 16V; MANUFACTURER_PART_NUMBER GCM155R71C104KA55D; DIGIKEY_PART_NUMBER 490-4759-1-ND
C49: 0.47uF; C_0603_1608Metric; TOLERANCE 10%; VOLTAGE 16V; MANUFACTURER_PART_NUMBER GRT188R71C474KE01D; DIGIKEY_PART_NUMBER 490-GRT188R71C474KE01DCT-ND
C50: 10uF; C_1206_3216Metric; TOLERANCE 10%; VOLTAGE 16V; MANUFACTURER_PART_NUMBER CL31B106KOHVPNE; DIGIKEY_PART_NUMBER 1276-6797-1-ND
FB3: 600; 1206; MANUFACTURER_PART_NUMBER BLM31PG601SN1L; DIGIKEY_PART_NUMBER 490-16533-1-ND
R69: 100k; R_0402_1005Metric; TOLERANCE 1%; MANUFACTURER_PART_NUMBER ERJ-2RKF1003X; DIGIKEY_PART_NUMBER P100KLCT-ND
R70: 374; R_0402_1005Metric; TOLERANCE 1%; MANUFACTURER_PART_NUMBER ERJ-2RKF3740X; DIGIKEY_PART_NUMBER P374LCT-ND
R71: 33.2k; R_0402_1005Metric; TOLERANCE 1%; MANUFACTURER_PART_NUMBER ERJ-2RKF3322X; DIGIKEY_PART_NUMBER P33.2KLCT-ND
R72: 75m; R_1206_3216Metric; TOLERANCE 0.5%; MANUFACTURER_PART_NUMBER WSL1206R0750FEA; DIGIKEY_PART_NUMBER 541-10064-1-ND
R197: 453k; R_0402_1005Metric; TOLERANCE 1%; MANUFACTURER_PART_NUMBER ERJ-2RKF4533X; DIGIKEY_PART_NUMBER P453KLCT-ND
R214: 49.9k; R_0402_1005Metric; TOLERANCE 1%; MANUFACTURER_PART_NUMBER ERJ-2RKF4992X; DIGIKEY_PART_NUMBER P49.9KLCT-ND
R215: 10k; R_0402_1005Metric; TOLERANCE 1%; MANUFACTURER_PART_NUMBER ERJ-2RKF1002X; DIGIKEY_PART_NUMBER P10.0KLCT-ND
U21: ZED-F9T-00B; MODULE_ZED-F9T-00B; MANUFACTURER_PART_NUMBER ZED-F9T-00B; DIGIKEY_PART_NUMBER 672-1197-1-ND
U22: LT3045xDD; DFN-10-1EP_3x3mm_P0.5mm_EP1.65x2.38mm; MANUFACTURER_PART_NUMBER LT3045EDD#TRPBF; DIGIKEY_PART_NUMBER 505-LT3045EDD#TRPBFCT-ND
U23: INA228AQDGSRQ1; VSSOP10_DGS_TEX; MANUFACTURER_PART_NUMBER INA228AQDGSRQ1; DIGIKEY_PART_NUMBER 296-INA228AQDGSRQ1CT-ND

Connections:
3V3: C51.1, U23.6 (VS); also elsewhere on the board
3V3_GPS: C45.1, C47.1, R72.2, U21.33 (VCC), U21.34 (VCC__1), U23.8 (VBUS), U23.9 (IN-); also elsewhere on the board
3V3_GPS_LDO_PG: R215.2, U22.4 (PG); also elsewhere on the board
3V3_STM: R215.1; also elsewhere on the board
5V: FB3.2; also elsewhere on the board
GND: C45.2, C46.2, C47.2, C48.2, C49.2, C50.2, C51.2, R69.2, R70.2, R71.2, R214.2, U21.1 (GND1), U21.3 (GND1__1), U21.12 (GND1__2), U21.14 (GND1__3), U21.32 (GND1__4), U21.37 (GND1__5), U21.38 (V_USB), U21.41 (GND1__6), U21.48 (GND1__7), U21.55 (GND1__8), U21.56 (GND1__9), U21.57 (GND1__10), U21.58 (GND1__11), U21.59 (GND1__12), U21.60 (GND1__13), U21.61 (GND1__14), U21.62 (GND2), U21.63 (GND2__1), U21.64 (GND2__2), U21.65 (GND2__3), U21.66 (GND2__4), U21.67 (GND2__5), U21.68 (GND2__6), U21.69 (GND2__7), U21.70 (GND2__8), U21.71 (GND2__9), U21.72 (GND2__10), U21.73 (GND2__11), U21.74 (GND2__12), U21.75 (GND2__13), U21.76 (GND2__14), U21.77 (GND3), U21.78 (GND3__1), U21.79 (GND3__2), U21.80 (GND3__3), U21.81 (GND3__4), U21.82 (GND3__5), U21.83 (GND3__6), U21.84 (GND3__7), U21.85 (GND3__8), U21.86 (GND3__9), U21.87 (GND3__10), U21.88 (GND3__11), U21.89 (GND3__12), U21.90 (GND3__13), U21.91 (GND3__14), U21.92 (GND4), U21.93 (GND4__1), U21.94 (GND4__2), U21.95 (GND4__3), U21.96 (GND4__4), U21.97 (GND4__5), U21.98 (GND4__6), U21.99 (GND4__7), U21.100 (GND4__8), U21.101 (GND4__9), U21.102 (GND4__10), U22.8 (GND), U22.11 (GND), U23.7 (GND); also elsewhere on the board
GPS_ANT_DETECT: U21.4 (ANT_DETECT); also elsewhere on the board
GPS_ANT_OFF_MON: U21.5 (ANT_OFF); also elsewhere on the board
GPS_ANT_SHORT: U21.6 (~ANT_SHORT); also elsewhere on the board
GPS_DSEL: U21.47 (D_SEL); also elsewhere on the board
GPS_EXTINT: U21.51 (EXTINT); also elsewhere on the board
GPS_PPS: U21.53 (TIMEPULSE); also elsewhere on the board
GPS_PWR_EN: R69.1, U22.3 (EN/UV); also elsewhere on the board
GPS_RF_IN: U21.2 (RF_IN); also elsewhere on the board
GPS_RST_N: U21.49 (~RESET); also elsewhere on the board
GPS_RX: U21.43 (RXD/SPI_SDI); also elsewhere on the board
GPS_RXD2: U21.26 (RXD2); also elsewhere on the board
GPS_SAFEBOOT_N: U21.50 (~SAFEBOOT); also elsewhere on the board
GPS_TP2: U21.54 (TIMEPULSE2); also elsewhere on the board
GPS_TX: U21.42 (TXD/SPI_SDO); also elsewhere on the board
GPS_TXD2: U21.27 (TXD2); also elsewhere on the board
GPS_TXRDY: U21.19 (GEOFENCE_STAT); also elsewhere on the board
GPS_VBAT: C48.1, U21.36 (V_BCKP); also elsewhere on the board
I2C_SCL: U23.5 (SCL); also elsewhere on the board
I2C_SDA: U23.1 (A1), U23.2 (A0), U23.4 (SDA); also elsewhere on the board
INA_ALERT_3V3_GPS: U23.3 (ALERT); also elsewhere on the board
unnamed: C46.1, FB3.1, U22.1 (IN), U22.2 (IN)
unnamed: R70.1, U22.5 (ILIM)
unnamed: C50.1, R72.1, R197.1, U22.9 (OUTS), U22.10 (OUT), U23.10 (IN+)
unnamed: R197.2, R214.1, U22.6 (PGFB)
unnamed: C49.1, R71.1, U22.7 (SET)

Notes on the sheet:
Place close to power pins
Noise Sensitive See Datasheet for Layout
I2C Address: 0x4A

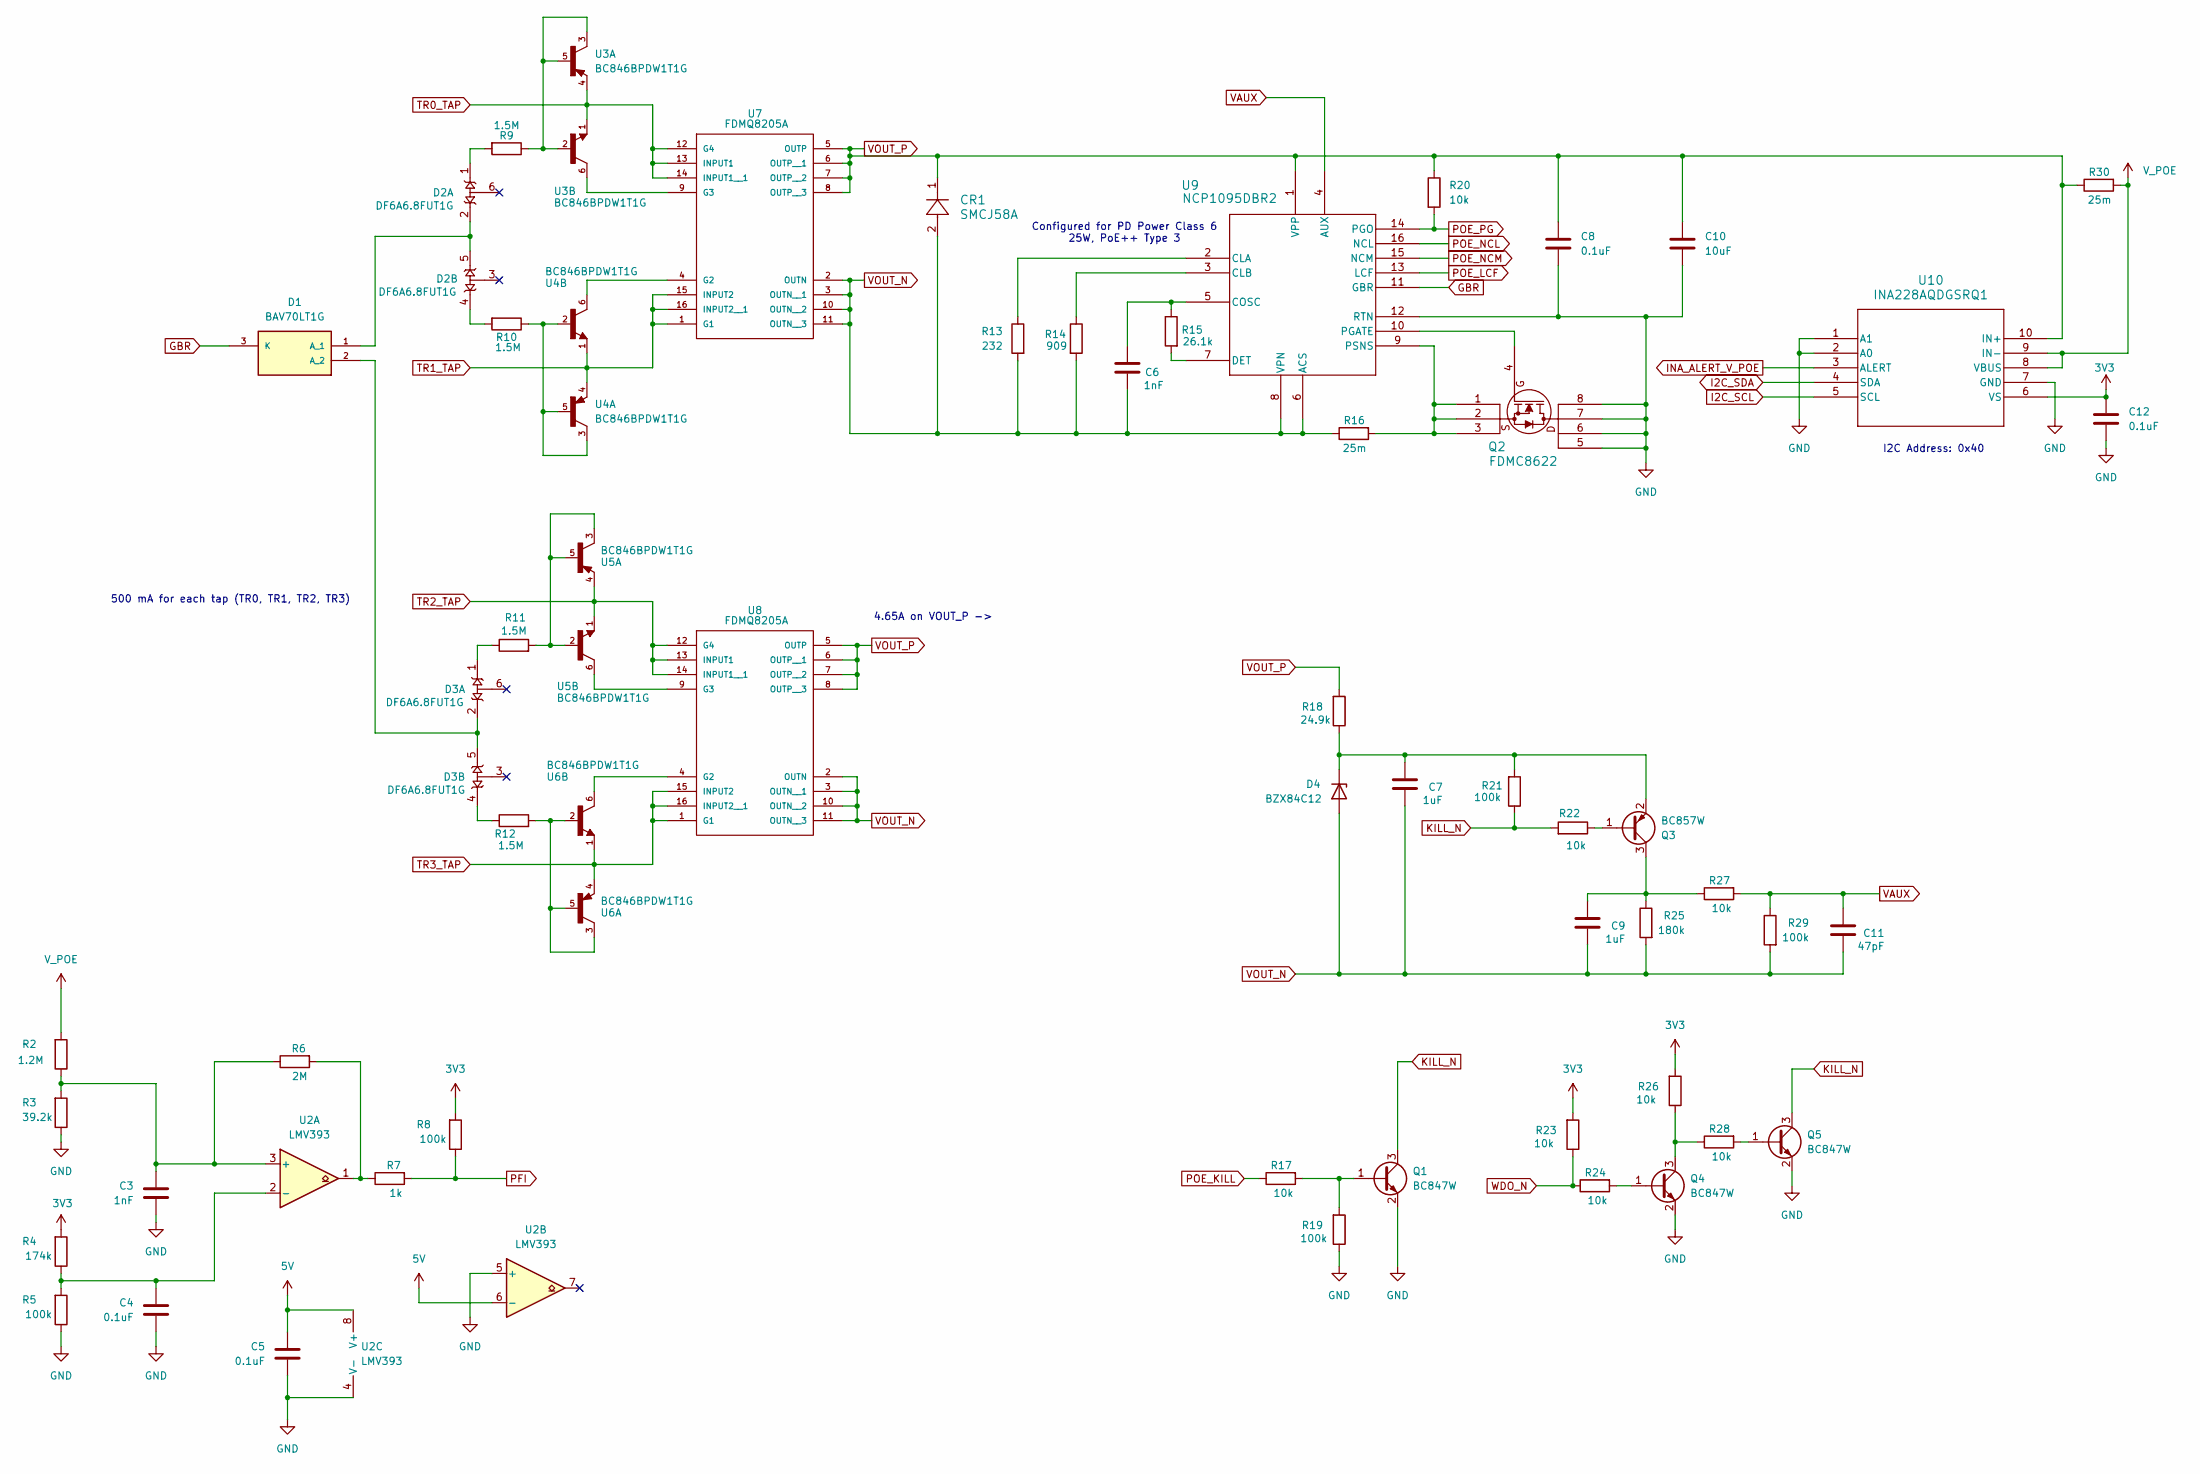
[picture p14: schematic PoE.kicad_sch]

Parts:
C3: 1nF; C_0402_1005Metric; TOLERANCE 5%; VOLTAGE 50V; MANUFACTURER_PART_NUMBER C0402C102J5GECAUTO; DIGIKEY_PART_NUMBER 399-C0402C102J5GECAUTOCT-ND
C4, C5, C12: 0.1uF; C_0402_1005Metric; TOLERANCE 10%; VOLTAGE 16V; MANUFACTURER_PART_NUMBER GCM155R71C104KA55D; DIGIKEY_PART_NUMBER 490-4759-1-ND
C6: 1nF; C_0402_1005Metric; TOLERANCE 5%; VOLTAGE 100V; MANUFACTURER_PART_NUMBER C0402C102K1GECAUTO; DIGIKEY_PART_NUMBER 399-17168-1-ND
C7, C9: 1uF; C_0805_2012Metric; TOLERANCE 10%; VOLTAGE 100V; MANUFACTURER_PART_NUMBER 08051C105K4T2A; DIGIKEY_PART_NUMBER 478-KAM21KR72A105KUCT-ND
C8: 0.1uF; C_0603_1608Metric; TOLERANCE 10%; VOLTAGE 100V; MANUFACTURER_PART_NUMBER GCJ188R72A104KA01D; DIGIKEY_PART_NUMBER 490-13420-1-ND
C10: 10uF; KCM55QR72A106KH01L; TOLERANCE 10%; VOLTAGE 100V; MANUFACTURER_PART_NUMBER KCM55QR72A106KH01L; DIGIKEY_PART_NUMBER 490-KCM55QR72A106KH01LCT-ND
C11: 47pF; C_0402_1005Metric; TOLERANCE 5%; VOLTAGE 100V; MANUFACTURER_PART_NUMBER GA0402A470JXBAP31G; DIGIKEY_PART_NUMBER 720-GA0402A470JXBAP31GCT-ND
CR1: SMCJ58A; DO214AC_LTF; MANUFACTURER_PART_NUMBER SMCJ58A; DIGIKEY_PART_NUMBER SMCJ58ALFCT-ND
D1: BAV70LT1G; SOT-23-3; MOUSER_PART_NUMBER 863-BAV70LT1G
D2, D3: DF6A6.8FUT1G; SOT-363_SC-70-6; MANUFACTURER_PART_NUMBER DF6A6.8FUT1G; DIGIKEY_PART_NUMBER DF6A6.8FUT1GOSCT-ND
D4: BZX84C12; SOT-23-3; MANUFACTURER_PART_NUMBER BZX84C12LT1G; DIGIKEY_PART_NUMBER BZX84C12LT1GOSCT-ND
Q1, Q4, Q5: BC847W; SOT-323_SC-70; MANUFACTURER_PART_NUMBER BC847W,135; DIGIKEY_PART_NUMBER 1727-BC847W,135CT-ND
Q2: FDMC8622; 8-PowerWDFN; MANUFACTURER_PART_NUMBER FDMC8622; DIGIKEY_PART_NUMBER FDMC8622CT-ND
Q3: BC857W; SOT-323_SC-70; MANUFACTURER_PART_NUMBER BC857W,135; DIGIKEY_PART_NUMBER 1727-BC857W,135CT-ND
R2: 1.2M; R_1206_3216Metric; TOLERANCE 1%; MANUFACTURER_PART_NUMBER ERJ-8ENF1204V; DIGIKEY_PART_NUMBER P1.20MFCT-ND
R3: 39.2k; R_0402_1005Metric; TOLERANCE 1%; MANUFACTURER_PART_NUMBER ERJ-2RKF3922X; DIGIKEY_PART_NUMBER P39.2KLCT-ND
R4: 174k; R_0402_1005Metric; TOLERANCE 1%; MANUFACTURER_PART_NUMBER ERJ-2RKF1743X; DIGIKEY_PART_NUMBER P174KLCT-ND
R5, R8, R19, R21, R29: 100k; R_0402_1005Metric; TOLERANCE 1%; MANUFACTURER_PART_NUMBER ERJ-2RKF1003X; DIGIKEY_PART_NUMBER P100KLCT-ND
R6: 2M; R_0402_1005Metric; TOLERANCE 1%; MANUFACTURER_PART_NUMBER ERJ-U02F2004X; DIGIKEY_PART_NUMBER 10-ERJ-U02F2004XCT-ND
R7: 1k; R_0402_1005Metric; TOLERANCE 1%; MANUFACTURER_PART_NUMBER ERJ-2RKF1001X; DIGIKEY_PART_NUMBER P1.00KLCT-ND
R9, R10, R11, R12: 1.5M; R_0402_1005Metric; TOLERANCE 1%; MANUFACTURER_PART_NUMBER ERJ-2GEJ155X; DIGIKEY_PART_NUMBER P1.5MJCT-ND
R13: 232; R_0402_1005Metric; TOLERANCE 1%; MANUFACTURER_PART_NUMBER ERJ-2RKF2320X; DIGIKEY_PART_NUMBER P232LCT-ND
R14: 909; R_0402_1005Metric; TOLERANCE 1%; MANUFACTURER_PART_NUMBER ERJ-2RKF9090X; DIGIKEY_PART_NUMBER P909LCT-ND
R15: 26.1k; R_0402_1005Metric; TOLERANCE 1%; MANUFACTURER_PART_NUMBER ERJ-2RKF2612X; DIGIKEY_PART_NUMBER P26.1KLCT-ND
R16: 25m; R_1206_3216Metric; TOLERANCE 0.5%; MANUFACTURER_PART_NUMBER MCS1632R025DER; DIGIKEY_PART_NUMBER 273-MCS1632R025DERCT-ND
R17, R22, R23, R24, R26, R27, R28: 10k; R_0402_1005Metric; TOLERANCE 1%; MANUFACTURER_PART_NUMBER ERJ-2RKF1002X; DIGIKEY_PART_NUMBER P10.0KLCT-ND
R18: 24.9k; R_0402_1005Metric; TOLERANCE 1%; MANUFACTURER_PART_NUMBER ERJ-2RKF2492X; DIGIKEY_PART_NUMBER P24.9KLCT-ND
R20: 10k; R_1210_3225Metric; TOLERANCE 1%; MANUFACTURER_PART_NUMBER ERJ-14NF1002U; DIGIKEY_PART_NUMBER P10.0KAACT-ND
R25: 180k; R_0402_1005Metric; TOLERANCE 1%; MANUFACTURER_PART_NUMBER ERJ-2RKF1803X; DIGIKEY_PART_NUMBER P180KLCT-ND
R30: 25m; R_1206_3216Metric; TOLERANCE 0.5%; MANUFACTURER_PART_NUMBER WSL1206R0250FEA; DIGIKEY_PART_NUMBER WSLC-.025CT-ND
U2: LMV393; MANUFACTURER_PART_NUMBER LMV393IDGKR; DIGIKEY_PART_NUMBER 296-13993-1-ND
U3, U4, U5, U6: BC846BPDW1T1G; SOT-363_SC-70-6; PARTREV 12; DIGIKEY_PART_NUMBER BC846BPDW1T1GOSTR-ND
U7, U8: FDMQ8205A; IC_FDMQ8205A; PARTREV 1.0; DIGIKEY_PART_NUMBER FDMQ8205AOSTR-ND
U9: NCP1095DBR2; TSSOP-16_948F-01_OSI; MANUFACTURER_PART_NUMBER NCP1095DBR2; DIGIKEY_PART_NUMBER NCP1095DBR2OSTR-ND
U10: INA228AQDGSRQ1; VSSOP10_DGS_TEX; MANUFACTURER_PART_NUMBER INA228AQDGSRQ1; DIGIKEY_PART_NUMBER 296-INA228AQDGSRQ1CT-ND

Connections:
3V3: C12.1, R4.2, R8.2, R23.2, R26.2, U10.6 (VS); also elsewhere on the board
5V: C5.1, U2.6 (-), U2.8 (V+); also elsewhere on the board
GBR: D1.3 (K), U9.11 (GBR)
GND: C3.2, C4.2, C5.2, C8.2, C10.2, C12.2, Q1.2 (E), Q2.5, Q2.6, Q2.7, Q2.8 (D), Q4.2 (E), Q5.2 (E), R3.1, R5.1, R19.1, U2.4 (V-), U2.5 (+), U9.12 (RTN), U10.1 (A1), U10.2 (A0), U10.7 (GND); also elsewhere on the board
I2C_SCL: U10.5 (SCL); also elsewhere on the board
I2C_SDA: U10.4 (SDA); also elsewhere on the board
INA_ALERT_V_POE: U10.3 (ALERT); also elsewhere on the board
KILL_N: Q1.3 (C), Q5.3 (C), R21.1, R22.2
unnamed: D1.1 (A_1), D2.2, D2.5
unnamed: D1.2 (A_2), D3.2, D3.5
unnamed: D2.1, R9.2
unnamed: D2.4, R10.2
unnamed: D3.1, R11.1
unnamed: D3.4, R12.1
unnamed: C7.2, D4.1 (K), Q3.2 (E), R18.1, R21.2
unnamed: Q1.1 (B), R17.2, R19.2
unnamed: Q2.4 (G), U9.10 (PGATE)
unnamed: Q2.1 (S), Q2.2, Q2.3, R16.2, U9.9 (PSNS)
unnamed: Q3.1 (B), R22.1
unnamed: C9.2, Q3.3 (C), R25.1, R27.1
unnamed: Q4.1 (B), R24.2
unnamed: Q4.3 (C), R26.1, R28.1
unnamed: Q5.1 (B), R28.2
unnamed: R6.2, R7.1, U2.1
unnamed: R9.1, U3.2, U3.3, U3.5
unnamed: R10.1, U4.2, U4.3, U4.5
unnamed: R11.2, U5.2, U5.3, U5.5
unnamed: R12.2, U6.2, U6.3, U6.5
unnamed: C3.1, R2.1, R3.2, R6.1, U2.3 (+)
unnamed: C4.1, R4.1, R5.2, U2.2 (-)
unnamed: U4.6, U7.4 (G2)
unnamed: U3.6, U7.9 (G3)
unnamed: U6.6, U8.4 (G2)
unnamed: U5.6, U8.9 (G3)
unnamed: R13.1, U9.2 (CLA)
unnamed: R14.1, U9.3 (CLB)
unnamed: C6.2, R15.1, U9.5 (COSC)
unnamed: R15.2, U9.7 (DET)
PFI: R7.2, R8.1; also elsewhere on the board
POE_KILL: R17.1; also elsewhere on the board
POE_LCF: U9.13 (LCF); also elsewhere on the board
POE_NCL: U9.16 (NCL); also elsewhere on the board
POE_NCM: U9.15 (NCM); also elsewhere on the board
POE_PG: R20.2, U9.14 (PGO); also elsewhere on the board
TR0_TAP: U3.1, U3.4, U7.12 (G4), U7.13 (INPUT1), U7.14 (INPUT1__1); also elsewhere on the board
TR1_TAP: U4.1, U4.4, U7.1 (G1), U7.15 (INPUT2), U7.16 (INPUT2__1); also elsewhere on the board
TR2_TAP: U5.1, U5.4, U8.12 (G4), U8.13 (INPUT1), U8.14 (INPUT1__1); also elsewhere on the board
TR3_TAP: U6.1, U6.4, U8.1 (G1), U8.15 (INPUT2), U8.16 (INPUT2__1); also elsewhere on the board
VAUX: C11.2, R27.2, R29.1, U9.4 (AUX)
VOUT_N: C6.1, C7.1, C9.1, C11.1, CR1.2, D4.2 (A), R13.2, R14.2, R16.1, R25.2, R29.2, U7.2 (OUTN), U7.3 (OUTN__1), U7.10 (OUTN__2), U7.11 (OUTN__3), U8.2 (OUTN), U8.3 (OUTN__1), U8.10 (OUTN__2), U8.11 (OUTN__3), U9.6 (ACS), U9.8 (VPN)
VOUT_P: C8.1, C10.1, CR1.1, R18.2, R20.1, R30.1, U7.5 (OUTP), U7.6 (OUTP__1), U7.7 (OUTP__2), U7.8 (OUTP__3), U8.5 (OUTP), U8.6 (OUTP__1), U8.7 (OUTP__2), U8.8 (OUTP__3), U9.1 (VPP), U10.10 (IN+)
V_POE: R2.2, R30.2, U10.8 (VBUS), U10.9 (IN-); also elsewhere on the board
WDO_N: R23.1, R24.1; also elsewhere on the board

Notes on the sheet:
4.65A on VOUT_P ->
500 mA for each tap (TR0, TR1, TR2, TR3)
I2C Address: 0x40
Configured for PD Power Class 6 25W, PoE++ Type 3
