rcldesign/ntp-server-stm32/hardware/ntp-server-stm32/ntp-server-stm32.kicad_pcb

## KiCad design hardware/ntp-server-stm32/ntp-server-stm32.kicad_pcb (continued)

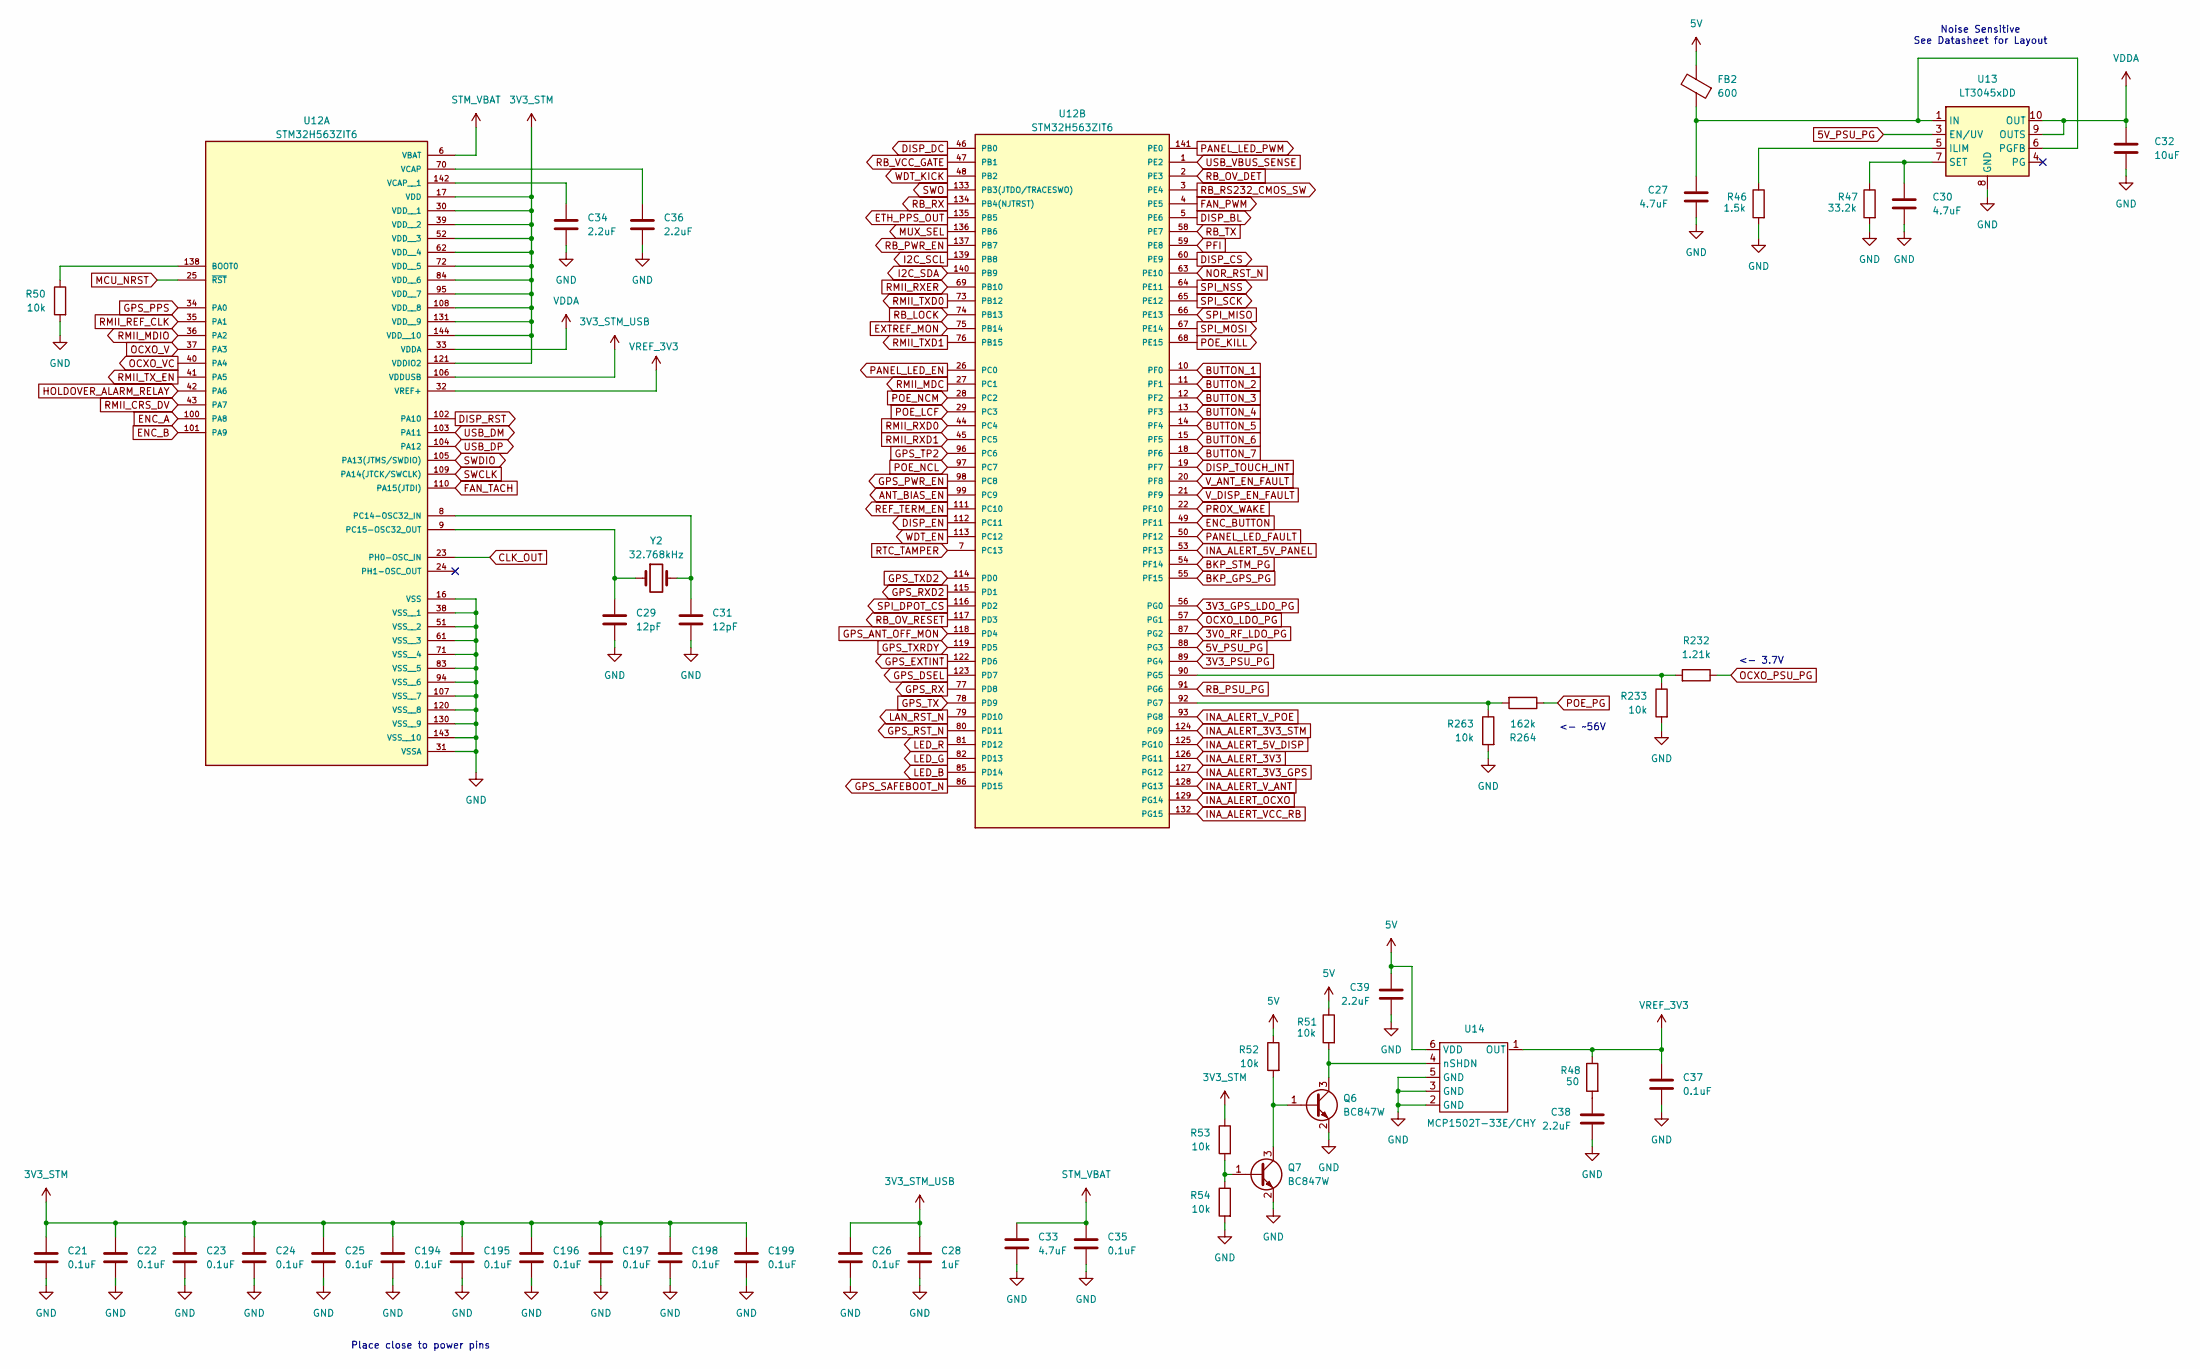
[picture p19: schematic stm32.kicad_sch]

Parts:
C21, C22, C23, C24, C25, C26, C35, C194, C195, C196, C197, C198, C199: 0.1uF; C_0402_1005Metric; TOLERANCE 10%; VOLTAGE 16V; MANUFACTURER_PART_NUMBER GCM155R71C104KA55D; DIGIKEY_PART_NUMBER 490-4759-1-ND
C27, C30, C33: 4.7uF; C_0805_2012Metric; TOLERANCE 10%; VOLTAGE 16V; MANUFACTURER_PART_NUMBER GRT21BR71C475KE13K; DIGIKEY_PART_NUMBER 490-GRT21BR71C475KE13KCT-ND
C28: 1uF; C_0603_1608Metric; TOLERANCE 10%; VOLTAGE 16V; MANUFACTURER_PART_NUMBER C0603C105K4RACAUTO; DIGIKEY_PART_NUMBER 399-17704-1-ND
C29, C31: 12pF; C_0402_1005Metric; TOLERANCE 5%; VOLTAGE 50V; MANUFACTURER_PART_NUMBER GCM1555C1H120FA16D; DIGIKEY_PART_NUMBER 490-16460-1-ND
C32: 10uF; C_1206_3216Metric; TOLERANCE 10%; VOLTAGE 16V; MANUFACTURER_PART_NUMBER CL31B106KOHVPNE; DIGIKEY_PART_NUMBER 1276-6797-1-ND
C34, C36, C38, C39: 2.2uF; C_0805_2012Metric; TOLERANCE 10%; VOLTAGE 16V; MANUFACTURER_PART_NUMBER GRT21BR71C225KE01L; DIGIKEY_PART_NUMBER 490-GRT21BR71C225KE01LCT-ND
C37: 0.1uF; C_1210_3225Metric; TOLERANCE 5%; VOLTAGE 50V; MANUFACTURER_PART_NUMBER C1210C104J5GACAUTO; DIGIKEY_PART_NUMBER 399-15804-1-ND
FB2: 600; 1206; MANUFACTURER_PART_NUMBER BLM31PG601SN1L; DIGIKEY_PART_NUMBER 490-16533-1-ND
Q6, Q7: BC847W; SOT-323_SC-70; MANUFACTURER_PART_NUMBER BC847W,135; DIGIKEY_PART_NUMBER 1727-BC847W,135CT-ND
R46: 1.5k; R_0402_1005Metric; TOLERANCE 1%; MANUFACTURER_PART_NUMBER ERJ-2RKF1501X; DIGIKEY_PART_NUMBER P1.50KLCT-ND
R47: 33.2k; R_0402_1005Metric; TOLERANCE 1%; MANUFACTURER_PART_NUMBER ERJ-2RKF3322X; DIGIKEY_PART_NUMBER P33.2KLCT-ND
R48: 50; R_0603_1608Metric; TOLERANCE 1%; MANUFACTURER_PART_NUMBER CRCW060350R0FKEA; DIGIKEY_PART_NUMBER 541-3318-1-ND
R50, R51, R52, R53, R54, R233, R263: 10k; R_0402_1005Metric; TOLERANCE 1%; MANUFACTURER_PART_NUMBER ERJ-2RKF1002X; DIGIKEY_PART_NUMBER P10.0KLCT-ND
R232: 1.21k; R_0402_1005Metric; TOLERANCE 1%; MANUFACTURER_PART_NUMBER ERJ-2RKF1211X; DIGIKEY_PART_NUMBER P1.21KLCT-ND
R264: 162k; R_1206_3216Metric; TOLERANCE 1%; MANUFACTURER_PART_NUMBER ERJ-8ENF1623V; DIGIKEY_PART_NUMBER P162KFCT-ND
U12: STM32H563ZIT6; QFP50P2200X2200X160-144N; MANUFACTURER_PART_NUMBER STM32H563ZIT6; DIGIKEY_PART_NUMBER 497-STM32H563ZIT6-ND
U13: LT3045xDD; DFN-10-1EP_3x3mm_P0.5mm_EP1.65x2.38mm; MANUFACTURER_PART_NUMBER LT3045EDD#TRPBF; DIGIKEY_PART_NUMBER 505-LT3045EDD#TRPBFCT-ND
U14: MCP1502T-33E/CHY; SOT-23-6; MANUFACTURER_PART_NUMBER MCP1502T-33E/CHY; DIGIKEY_PART_NUMBER 150-MCP1502T-33E/CHYCT-ND
Y2: 32.768kHz; ABS07-32.768KHZ-1-T; MANUFACTURER_PART_NUMBER ABS07-32.768KHZ-T; DIGIKEY_PART_NUMBER 535-9542-1-ND

Connections:
3V0_RF_LDO_PG: U12.87 (PG2); also elsewhere on the board
3V3_GPS_LDO_PG: U12.56 (PG0); also elsewhere on the board
3V3_PSU_PG: U12.89 (PG4); also elsewhere on the board
3V3_STM: C21.1, C22.1, C23.1, C24.1, C25.1, C194.1, C195.1, C196.1, C197.1, C198.1, C199.1, R53.1, U12.17 (VDD), U12.30 (VDD__1), U12.39 (VDD__2), U12.52 (VDD__3), U12.62 (VDD__4), U12.72 (VDD__5), U12.84 (VDD__6), U12.95 (VDD__7), U12.108 (VDD__8), U12.121 (VDDIO2), U12.131 (VDD__9), U12.144 (VDD__10); also elsewhere on the board
3V3_STM_USB: C26.1, C28.1, U12.106 (VDDUSB)
5V: C39.1, FB2.2, R51.1, R52.1, U14.6 (VDD); also elsewhere on the board
5V_PSU_PG: U12.88 (PG3), U13.3 (EN/UV); also elsewhere on the board
10MHz_CLK_OUT: U12.75 (PB14); also elsewhere on the board
ANT_BIAS_EN: U12.99 (PC9); also elsewhere on the board
BKP_GPS_PG: U12.55 (PF15); also elsewhere on the board
BKP_STM_PG: U12.54 (PF14); also elsewhere on the board
BUTTON_1: U12.10 (PF0); also elsewhere on the board
BUTTON_2: U12.11 (PF1); also elsewhere on the board
BUTTON_3: U12.12 (PF2); also elsewhere on the board
BUTTON_4: U12.13 (PF3); also elsewhere on the board
BUTTON_5: U12.14 (PF4); also elsewhere on the board
BUTTON_6: U12.15 (PF5); also elsewhere on the board
BUTTON_7: U12.18 (PF6); also elsewhere on the board
CLK_OUT: U12.23 (PH0-OSC_IN); also elsewhere on the board
DISP_BL: U12.5 (PE6); also elsewhere on the board
DISP_CS: U12.60 (PE9); also elsewhere on the board
DISP_DC: U12.46 (PB0); also elsewhere on the board
DISP_EN: U12.112 (PC11); also elsewhere on the board
DISP_RST: U12.102 (PA10); also elsewhere on the board
DISP_TOUCH_INT: U12.19 (PF7); also elsewhere on the board
ENC_A: U12.100 (PA8); also elsewhere on the board
ENC_B: U12.101 (PA9); also elsewhere on the board
ENC_BUTTON: U12.49 (PF11); also elsewhere on the board
ETH_PPS_OUT: U12.135 (PB5); also elsewhere on the board
FAN_PWM: U12.4 (PE5); also elsewhere on the board
FAN_TACH: U12.110 (PA15(JTDI)); also elsewhere on the board
GND: C21.2, C22.2, C23.2, C24.2, C25.2, C26.2, C27.2, C28.2, C29.2, C30.2, C31.2, C32.2, C33.2, C34.2, C35.2, C36.2, C37.2, C38.2, C39.2, C194.2, C195.2, C196.2, C197.2, C198.2, C199.2, Q6.2 (E), Q7.2 (E), R46.2, R47.2, R50.2, R54.2, R233.2, R263.2, U12.16 (VSS), U12.31 (VSSA), U12.38 (VSS__1), U12.51 (VSS__2), U12.61 (VSS__3), U12.71 (VSS__4), U12.83 (VSS__5), U12.94 (VSS__6), U12.107 (VSS__7), U12.120 (VSS__8), U12.130 (VSS__9), U12.143 (VSS__10), U13.8 (GND), U13.11 (GND), U14.2 (GND), U14.3 (GND), U14.5 (GND); also elsewhere on the board
GPS_ANT_OFF_MON: U12.118 (PD4); also elsewhere on the board
GPS_DSEL: U12.123 (PD7); also elsewhere on the board
GPS_EXTINT: U12.122 (PD6); also elsewhere on the board
GPS_PPS: U12.34 (PA0); also elsewhere on the board
GPS_PWR_EN: U12.98 (PC8); also elsewhere on the board
GPS_RST_N: U12.80 (PD11); also elsewhere on the board
GPS_RX: U12.77 (PD8); also elsewhere on the board
GPS_RXD2: U12.115 (PD1); also elsewhere on the board
GPS_SAFEBOOT_N: U12.86 (PD15); also elsewhere on the board
GPS_TP2: U12.96 (PC6); also elsewhere on the board
GPS_TX: U12.78 (PD9); also elsewhere on the board
GPS_TXD2: U12.114 (PD0); also elsewhere on the board
GPS_TXRDY: U12.119 (PD5); also elsewhere on the board
HOLDOVER_ALARM_RELAY: U12.42 (PA6); also elsewhere on the board
I2C_SCL: U12.139 (PB8); also elsewhere on the board
I2C_SDA: U12.140 (PB9); also elsewhere on the board
INA_ALERT_3V3: U12.126 (PG11); also elsewhere on the board
INA_ALERT_3V3_GPS: U12.127 (PG12); also elsewhere on the board
INA_ALERT_3V3_STM: U12.124 (PG9); also elsewhere on the board
INA_ALERT_5V_DISP: U12.125 (PG10); also elsewhere on the board
INA_ALERT_5V_PANEL: U12.53 (PF13); also elsewhere on the board
INA_ALERT_OCXO: U12.129 (PG14); also elsewhere on the board
INA_ALERT_VCC_RB: U12.132 (PG15); also elsewhere on the board
INA_ALERT_V_ANT: U12.128 (PG13); also elsewhere on the board
INA_ALERT_V_POE: U12.93 (PG8); also elsewhere on the board
LAN_RST_N: U12.79 (PD10); also elsewhere on the board
LED_B: U12.85 (PD14); also elsewhere on the board
LED_G: U12.82 (PD13); also elsewhere on the board
LED_R: U12.81 (PD12); also elsewhere on the board
MCU_NRST: U12.25 (~RST); also elsewhere on the board
MUX_SEL: U12.136 (PB6); also elsewhere on the board
NOR_RST_N: U12.63 (PE10); also elsewhere on the board
unnamed: C38.1, R48.2
unnamed: Q6.1 (B), Q7.3 (C), R52.2
unnamed: Q6.3 (C), R51.2, U14.4 (nSHDN)
unnamed: Q7.1 (B), R53.2, R54.1
unnamed: R50.1, U12.138 (BOOT0)
unnamed: C31.1, U12.8 (PC14-OSC32_IN), Y2.2
unnamed: C29.1, U12.9 (PC15-OSC32_OUT), Y2.1
unnamed: C36.1, U12.70 (VCAP)
unnamed: C34.1, U12.142 (VCAP__1)
unnamed: R232.2, R233.1, U12.90 (PG5)
unnamed: R263.1, R264.2, U12.92 (PG7)
unnamed: R46.1, U13.5 (ILIM)
unnamed: C27.1, FB2.1, U13.1 (IN), U13.2 (IN), U13.6 (PGFB)
unnamed: C30.1, R47.1, U13.7 (SET)
OCXO_LDO_PG: U12.57 (PG1); also elsewhere on the board
OCXO_PSU_PG: R232.1; also elsewhere on the board
OCXO_V: U12.37 (PA3); also elsewhere on the board
OCXO_VC: U12.40 (PA4); also elsewhere on the board
PANEL_LED_EN: U12.26 (PC0); also elsewhere on the board
PANEL_LED_FAULT: U12.50 (PF12); also elsewhere on the board
PANEL_LED_PWM: U12.141 (PE0); also elsewhere on the board
PFI: U12.59 (PE8); also elsewhere on the board
POE_KILL: U12.68 (PE15); also elsewhere on the board
POE_LCF: U12.29 (PC3); also elsewhere on the board
POE_NCL: U12.97 (PC7); also elsewhere on the board
POE_NCM: U12.28 (PC2); also elsewhere on the board
POE_PG: R264.1; also elsewhere on the board
PROX_WAKE: U12.22 (PF10); also elsewhere on the board
RB_LOCK: U12.74 (PB13); also elsewhere on the board
RB_OV_DET: U12.2 (PE3); also elsewhere on the board
RB_OV_RESET: U12.117 (PD3); also elsewhere on the board
RB_PSU_PG: U12.91 (PG6); also elsewhere on the board
RB_PWR_EN: U12.137 (PB7); also elsewhere on the board
RB_RS232_CMOS_SW: U12.3 (PE4); also elsewhere on the board
RB_RX: U12.134 (PB4(NJTRST)); also elsewhere on the board
RB_TX: U12.58 (PE7); also elsewhere on the board
RB_VCC_GATE: U12.47 (PB1); also elsewhere on the board
REF_TERM_EN: U12.111 (PC10); also elsewhere on the board
RMII_CRS_DV: U12.43 (PA7); also elsewhere on the board
RMII_MDC: U12.27 (PC1); also elsewhere on the board
RMII_MDIO: U12.36 (PA2); also elsewhere on the board
RMII_REF_CLK: U12.35 (PA1); also elsewhere on the board
RMII_RXD0: U12.44 (PC4); also elsewhere on the board
RMII_RXD1: U12.45 (PC5); also elsewhere on the board
RMII_RXER: U12.69 (PB10); also elsewhere on the board
RMII_TXD0: U12.73 (PB12); also elsewhere on the board
RMII_TXD1: U12.76 (PB15); also elsewhere on the board
RMII_TX_EN: U12.41 (PA5); also elsewhere on the board
RTC_TAMPER: U12.7 (PC13); also elsewhere on the board
SPI_DPOT_CS: U12.116 (PD2); also elsewhere on the board
SPI_MISO: U12.66 (PE13); also elsewhere on the board
SPI_MOSI: U12.67 (PE14); also elsewhere on the board
SPI_NSS: U12.64 (PE11); also elsewhere on the board
SPI_SCK: U12.65 (PE12); also elsewhere on the board
STM_VBAT: C33.1, C35.1, U12.6 (VBAT); also elsewhere on the board
SWCLK: U12.109 (PA14(JTCK/SWCLK)); also elsewhere on the board
SWDIO: U12.105 (PA13(JTMS/SWDIO)); also elsewhere on the board
SWO: U12.133 (PB3(JTDO/TRACESWO)); also elsewhere on the board
USB_D+: U12.104 (PA12); also elsewhere on the board
USB_D-: U12.103 (PA11); also elsewhere on the board
USB_VBUS_SENSE: U12.1 (PE2); also elsewhere on the board
VDDA: C32.1, U12.33 (VDDA), U13.9 (OUTS), U13.10 (OUT); also elsewhere on the board
VREF_3V3: C37.1, R48.1, U12.32 (VREF+), U14.1 (OUT)
V_ANT_EN_FAULT: U12.20 (PF8); also elsewhere on the board
V_DISP_EN_FAULT: U12.21 (PF9); also elsewhere on the board
WDT_EN: U12.113 (PC12); also elsewhere on the board
WDT_KICK: U12.48 (PB2); also elsewhere on the board

Notes on the sheet:
<- 3.7V
<- ~56V
Place close to power pins
Noise Sensitive See Datasheet for Layout

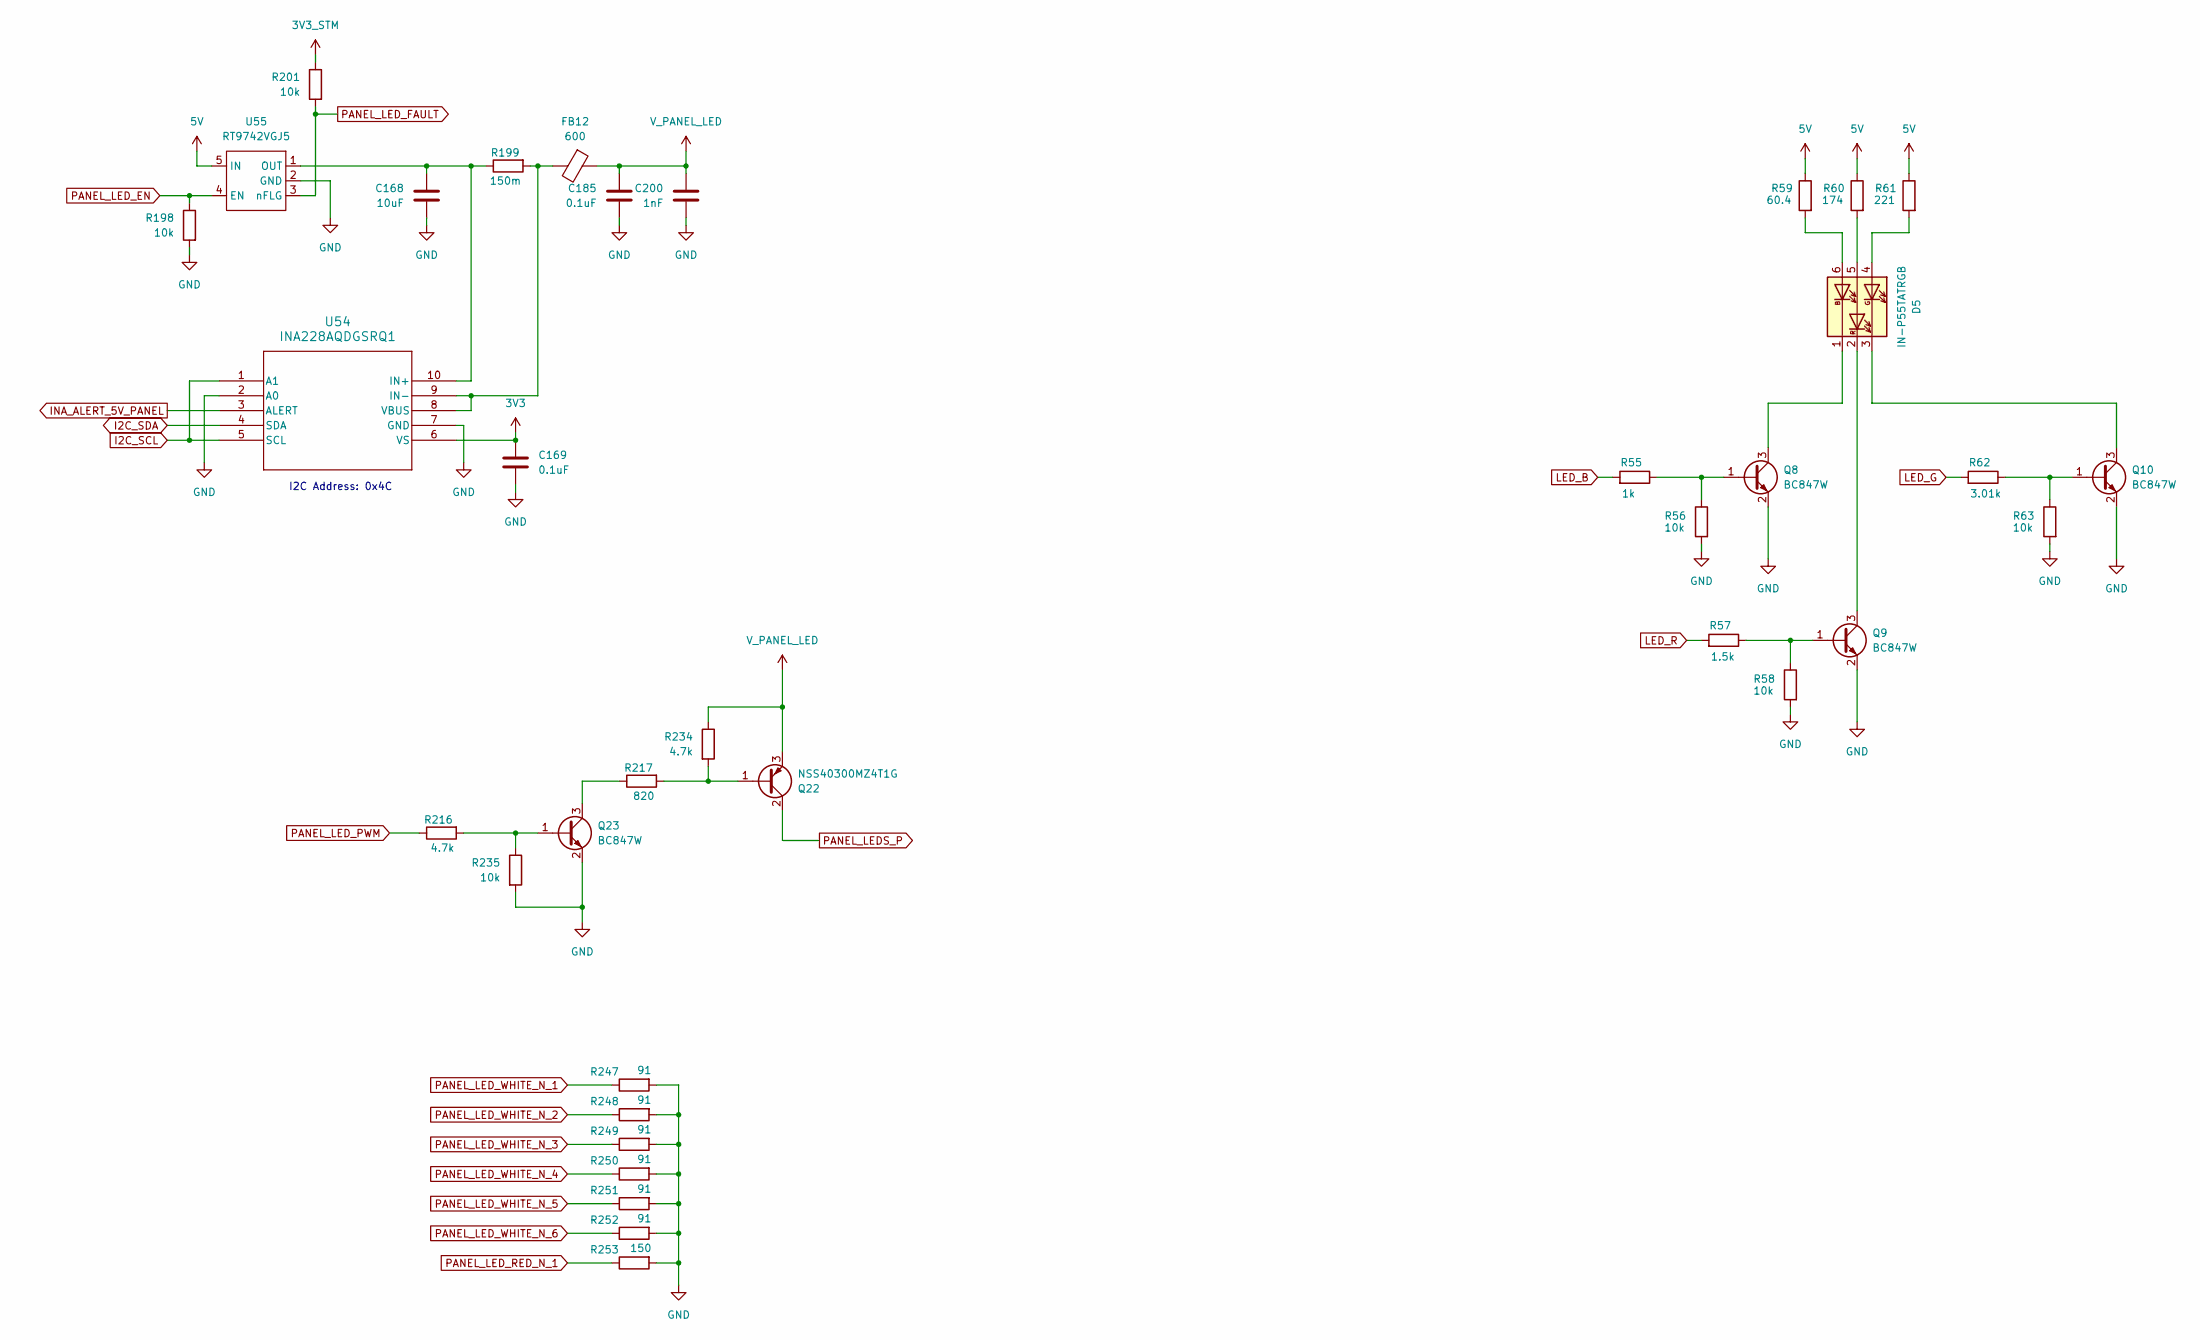
[picture p20: schematic led.kicad_sch]

Parts:
C168: 10uF; C_1206_3216Metric; TOLERANCE 10%; VOLTAGE 16V; MANUFACTURER_PART_NUMBER CL31B106KOHVPNE; DIGIKEY_PART_NUMBER 1276-6797-1-ND
C169, C185: 0.1uF; C_0402_1005Metric; TOLERANCE 10%; VOLTAGE 16V; MANUFACTURER_PART_NUMBER GCM155R71C104KA55D; DIGIKEY_PART_NUMBER 490-4759-1-ND
C200: 1nF; C_0402_1005Metric; TOLERANCE 5%; VOLTAGE 50V; MANUFACTURER_PART_NUMBER C0402C102J5GECAUTO; DIGIKEY_PART_NUMBER 399-C0402C102J5GECAUTOCT-ND
D5: IN-P55TATRGB; LED_IN-P55TATRGB; MANUFACTURER_PART_NUMBER IN-P55TATRGB; DIGIKEY_PART_NUMBER 1830-1098-1-ND
FB12: 600; 1206; MANUFACTURER_PART_NUMBER BLM31PG601SN1L; DIGIKEY_PART_NUMBER 490-16533-1-ND
Q8, Q9, Q10, Q23: BC847W; SOT-323_SC-70; MANUFACTURER_PART_NUMBER BC847W,135; DIGIKEY_PART_NUMBER 1727-BC847W,135CT-ND
Q22: NSS40300MZ4T1G; SOT-223; MANUFACTURER_PART_NUMBER NSS40300MZ4T1G; DIGIKEY_PART_NUMBER NSS40300MZ4T1GOSCT-ND
R55: 1k; R_0402_1005Metric; TOLERANCE 1%; MANUFACTURER_PART_NUMBER ERJ-2RKF1001X; DIGIKEY_PART_NUMBER P1.00KLCT-ND
R56, R58, R63, R198, R201, R235: 10k; R_0402_1005Metric; TOLERANCE 1%; MANUFACTURER_PART_NUMBER ERJ-2RKF1002X; DIGIKEY_PART_NUMBER P10.0KLCT-ND
R57: 1.5k; R_0402_1005Metric; TOLERANCE 1%; MANUFACTURER_PART_NUMBER ERJ-2RKF1501X; DIGIKEY_PART_NUMBER P1.50KLCT-ND
R59: 60.4; R_0402_1005Metric; TOLERANCE 1%; MANUFACTURER_PART_NUMBER RK73H1ETTP60R4F; DIGIKEY_PART_NUMBER 2019-RK73H1ETTP60R4FCT-ND
R60: 174; R_0402_1005Metric; TOLERANCE 1%; MANUFACTURER_PART_NUMBER ERJ-2RKF1740X; DIGIKEY_PART_NUMBER P174LCT-ND
R61: 221; R_0402_1005Metric; TOLERANCE 1%; MANUFACTURER_PART_NUMBER RK73H1ETTP2210F; DIGIKEY_PART_NUMBER 2019-RK73H1ETTP2210FCT-ND
R62: 3.01k; R_0402_1005Metric; TOLERANCE 1%; MANUFACTURER_PART_NUMBER RK73H1ETTP3011F; DIGIKEY_PART_NUMBER 2019-RK73H1ETTP3011FCT-ND
R199: 150m; R_1206_3216Metric; TOLERANCE 0.5%; MANUFACTURER_PART_NUMBER WSL1206R1500FEA; DIGIKEY_PART_NUMBER WSLC-.15CT-ND
R216: 4.7k; R_0805_2012Metric; TOLERANCE 1%; MANUFACTURER_PART_NUMBER ERJ-6ENF4701V; DIGIKEY_PART_NUMBER P4.70KCCT-ND
R217: 820; R_0805_2012Metric; TOLERANCE 1%; MANUFACTURER_PART_NUMBER ERJ-6ENF8200V; DIGIKEY_PART_NUMBER P820CCT-ND
R234: 4.7k; R_0402_1005Metric; TOLERANCE 1%; MANUFACTURER_PART_NUMBER ERJ-2RKF4701X; DIGIKEY_PART_NUMBER P4.70KLCT-ND
R247, R248, R249, R250, R251, R252: 91; R_0805_2012Metric; TOLERANCE 1%; MANUFACTURER_PART_NUMBER ERJ-6ENF91R0V; DIGIKEY_PART_NUMBER P91.0CCT-ND
R253: 150; R_0805_2012Metric; TOLERANCE 1%; MANUFACTURER_PART_NUMBER ERJ-6ENF1500V; DIGIKEY_PART_NUMBER P150CCT-ND
U54: INA228AQDGSRQ1; VSSOP10_DGS_TEX; MANUFACTURER_PART_NUMBER INA228AQDGSRQ1; DIGIKEY_PART_NUMBER 296-INA228AQDGSRQ1CT-ND
U55: RT9742VGJ5; TSOT-23-5; MANUFACTURER_PART_NUMBER RT9742VGJ5; DIGIKEY_PART_NUMBER 1028-RT9742VGJ5TR-ND

Connections:
3V3: C169.1, U54.6 (VS); also elsewhere on the board
3V3_STM: R201.1; also elsewhere on the board
5V: R59.1, R60.1, R61.1, U55.5 (IN); also elsewhere on the board
GND: C168.2, C169.2, C185.2, C200.2, Q8.2 (E), Q9.2 (E), Q10.2 (E), Q23.2 (E), R56.2, R58.2, R63.2, R198.2, R235.2, R247.2, R248.2, R249.2, R250.2, R251.2, R252.2, R253.2, U54.2 (A0), U54.7 (GND), U55.2 (GND); also elsewhere on the board
I2C_SCL: U54.1 (A1), U54.5 (SCL); also elsewhere on the board
I2C_SDA: U54.4 (SDA); also elsewhere on the board
INA_ALERT_5V_PANEL: U54.3 (ALERT); also elsewhere on the board
LED_B: R55.2; also elsewhere on the board
LED_G: R62.2; also elsewhere on the board
LED_R: R57.2; also elsewhere on the board
unnamed: D5.6 (AB), R59.2
unnamed: D5.4 (AG), R61.2
unnamed: D5.5 (AR), R60.2
unnamed: D5.1 (KB), Q8.3 (C)
unnamed: D5.3 (KG), Q10.3 (C)
unnamed: D5.2 (KR), Q9.3 (C)
unnamed: Q8.1 (B), R55.1, R56.1
unnamed: Q9.1 (B), R57.1, R58.1
unnamed: Q10.1 (B), R62.1, R63.1
unnamed: Q22.1 (B), R217.2, R234.2
unnamed: Q23.1 (B), R216.2, R235.1
unnamed: Q23.3 (C), R217.1
unnamed: C168.1, R199.1, U54.10 (IN+), U55.1 (OUT)
unnamed: FB12.2, R199.2, U54.8 (VBUS), U54.9 (IN-)
PANEL_LEDS_P: Q22.2 (C); also elsewhere on the board
PANEL_LED_EN: R198.1, U55.4 (EN); also elsewhere on the board
PANEL_LED_FAULT: R201.2, U55.3 (nFLG); also elsewhere on the board
PANEL_LED_PWM: R216.1; also elsewhere on the board
PANEL_LED_RED_N_1: R253.1; also elsewhere on the board
PANEL_LED_WHITE_N_1: R247.1; also elsewhere on the board
PANEL_LED_WHITE_N_2: R248.1; also elsewhere on the board
PANEL_LED_WHITE_N_3: R249.1; also elsewhere on the board
PANEL_LED_WHITE_N_4: R250.1; also elsewhere on the board
PANEL_LED_WHITE_N_5: R251.1; also elsewhere on the board
PANEL_LED_WHITE_N_6: R252.1; also elsewhere on the board
V_PANEL_LED: C185.1, C200.1, FB12.1, Q22.3 (E), R234.1

Notes on the sheet:
I2C Address: 0x4C

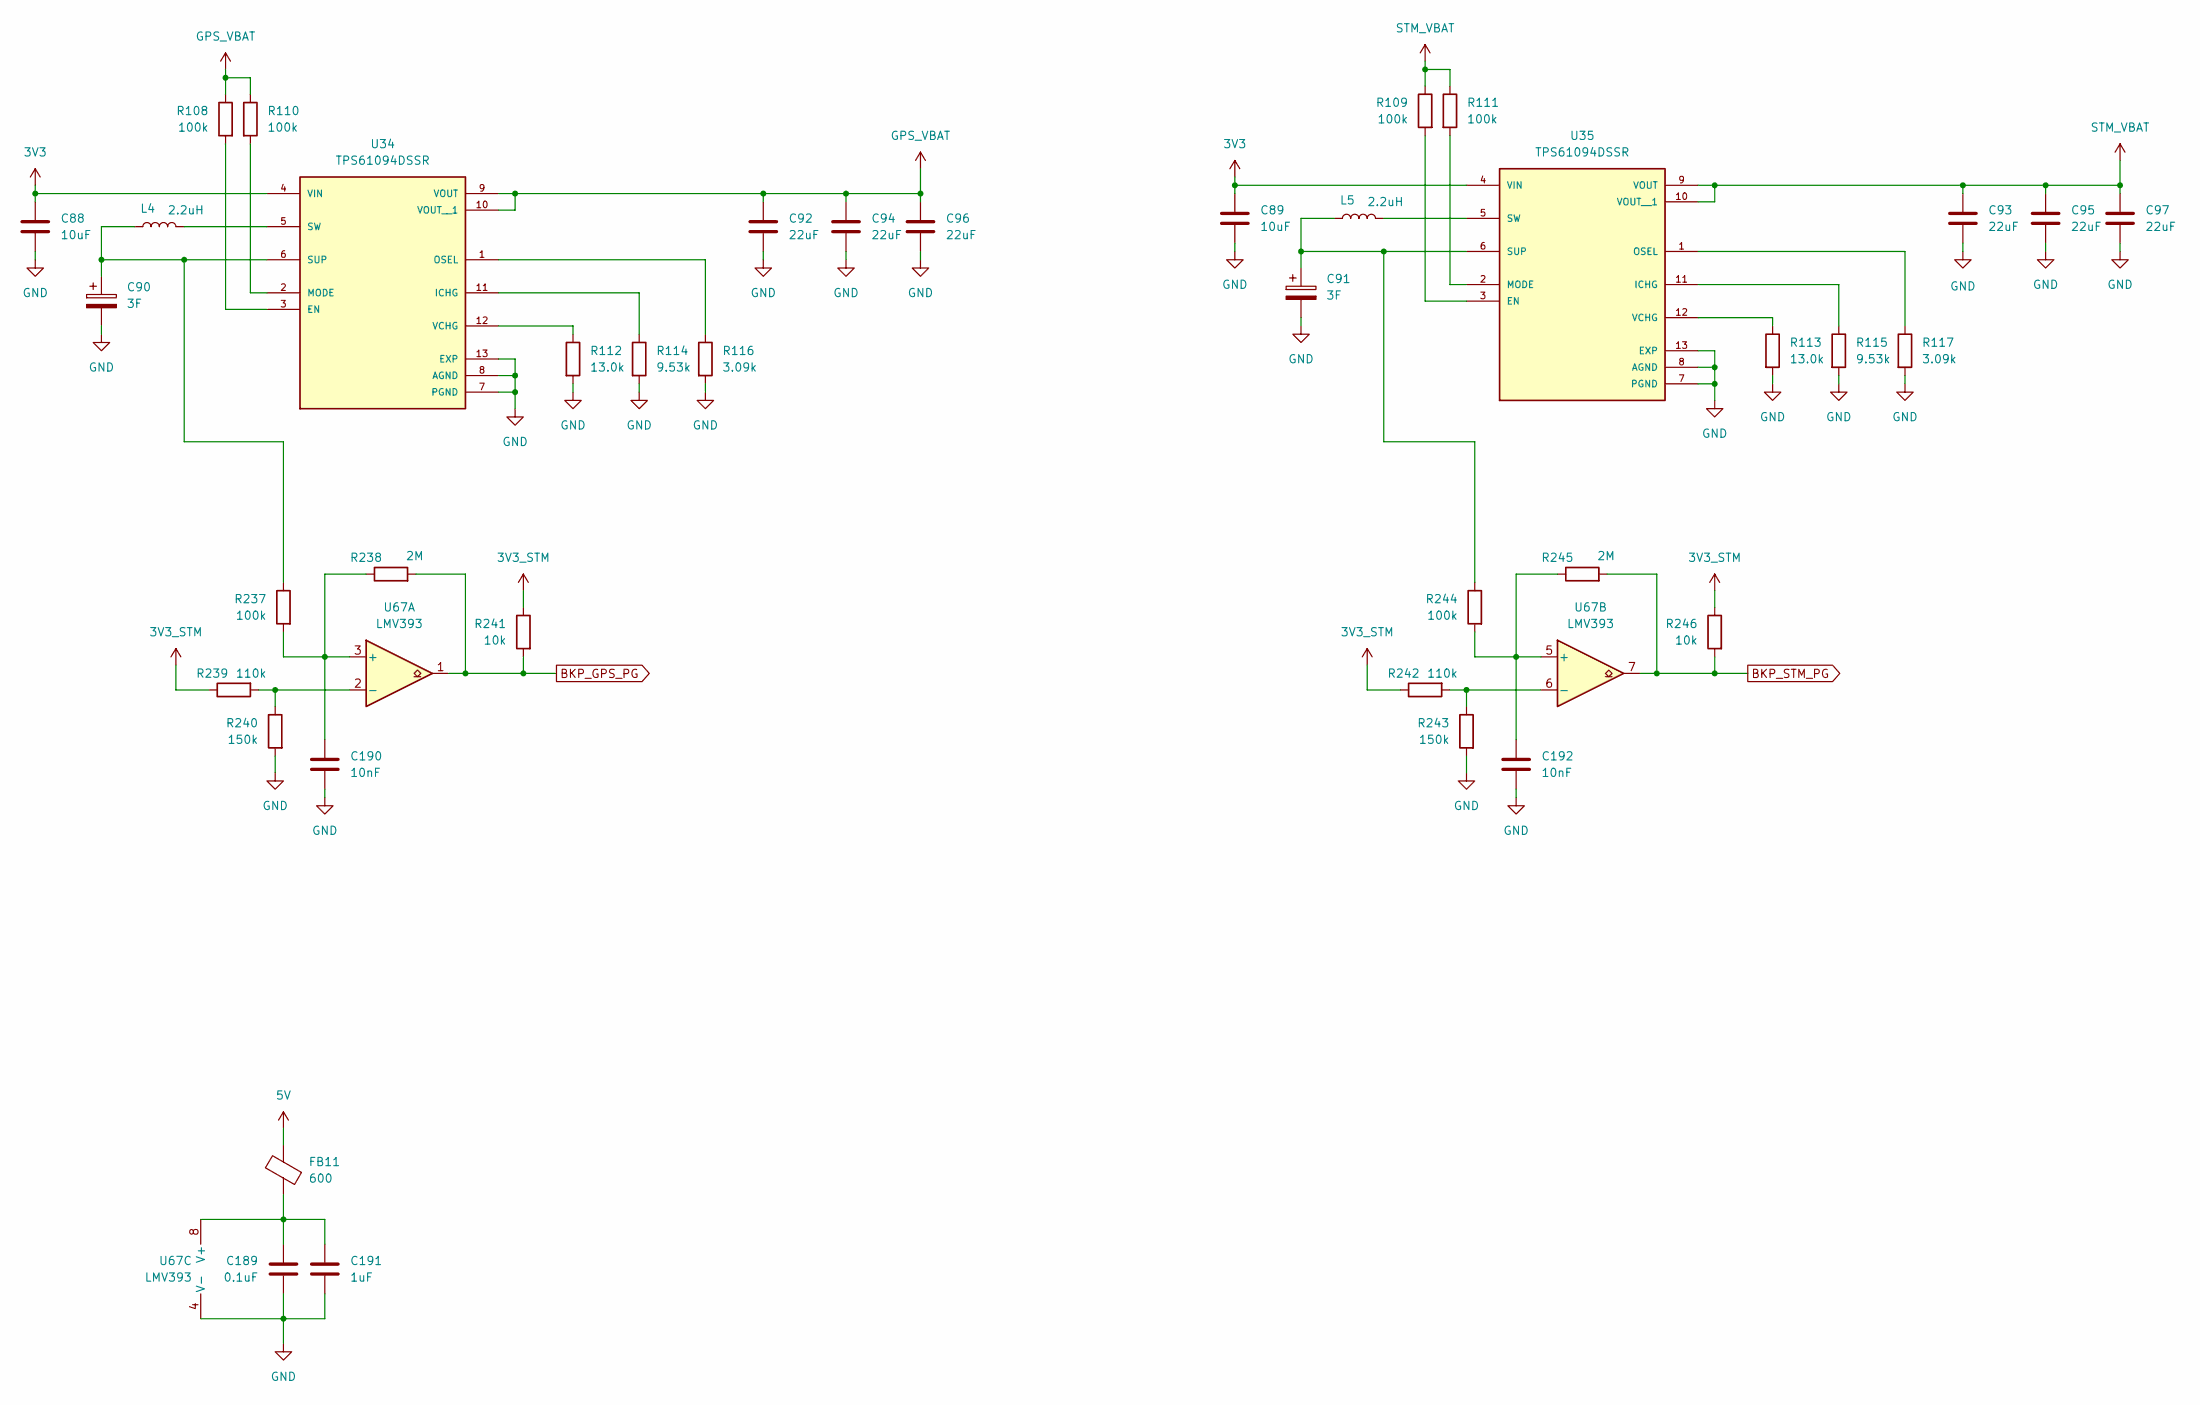
[picture p21: schematic batt-supplies.kicad_sch]

Parts:
C88, C89: 10uF; C_1206_3216Metric; TOLERANCE 10%; VOLTAGE 16V; MANUFACTURER_PART_NUMBER CL31B106KOHVPNE; DIGIKEY_PART_NUMBER 1276-6797-1-ND
C90, C91: 3F; DSF305Q3R0; TOLERANCE 5%; VOLTAGE 3V; MANUFACTURER_PART_NUMBER DSF305Q3R0; DIGIKEY_PART_NUMBER 338-DSF305Q3R0-ND
C92, C93, C94, C95, C96, C97: 22uF; C_0805_2012Metric; TOLERANCE 10%; VOLTAGE 16V; MANUFACTURER_PART_NUMBER GRT21BR61C226ME13K; DIGIKEY_PART_NUMBER 490-GRT21BR61C226ME13KCT-ND
C189: 0.1uF; C_0402_1005Metric; TOLERANCE 10%; VOLTAGE 16V; MANUFACTURER_PART_NUMBER GCM155R71C104KA55D; DIGIKEY_PART_NUMBER 490-4759-1-ND
C190, C192: 10nF; C_0402_1005Metric; TOLERANCE 10%; VOLTAGE 50V; MANUFACTURER_PART_NUMBER GCM155R71H103KA55D; DIGIKEY_PART_NUMBER 490-4762-1-ND
C191: 1uF; C_0603_1608Metric; TOLERANCE 10%; VOLTAGE 16V; MANUFACTURER_PART_NUMBER C0603C105K4RACAUTO; DIGIKEY_PART_NUMBER 399-17704-1-ND
FB11: 600; 1206; MANUFACTURER_PART_NUMBER BLM31PG601SN1L; DIGIKEY_PART_NUMBER 490-16533-1-ND
L4, L5: 2.2uH; DR73-2R2-R; MANUFACTURER_PART_NUMBER DR73-2R2-R; DIGIKEY_PART_NUMBER 283-DR73-2R2-RTR-ND
R108, R109, R110, R111, R237, R244: 100k; R_0402_1005Metric; TOLERANCE 1%; MANUFACTURER_PART_NUMBER ERJ-2RKF1003X; DIGIKEY_PART_NUMBER P100KLCT-ND
R112, R113: 13.0k; R_0402_1005Metric; TOLERANCE 1%; MANUFACTURER_PART_NUMBER ERJ-2RKF1302X; DIGIKEY_PART_NUMBER P13.0KLCT-ND
R114, R115: 9.53k; R_0402_1005Metric; TOLERANCE 1%; MANUFACTURER_PART_NUMBER ERJ-2RKF9531X; DIGIKEY_PART_NUMBER P9.53KLCT-ND
R116, R117: 3.09k; R_0402_1005Metric; TOLERANCE 1%; MANUFACTURER_PART_NUMBER ERJ-2RKF3091X; DIGIKEY_PART_NUMBER P3.09KLCT-ND
R238, R245: 2M; R_0402_1005Metric; TOLERANCE 1%; MANUFACTURER_PART_NUMBER ERJ-U02F2004X; DIGIKEY_PART_NUMBER 10-ERJ-U02F2004XCT-ND
R239, R242: 110k; R_0402_1005Metric; TOLERANCE 1%; MANUFACTURER_PART_NUMBER ERJ-2RKF1103X; DIGIKEY_PART_NUMBER P110KLCT-ND
R240, R243: 150k; R_0402_1005Metric; TOLERANCE 1%; MANUFACTURER_PART_NUMBER ERJ-2RKF1503X; DIGIKEY_PART_NUMBER P150KLCT-ND
R241, R246: 10k; R_0402_1005Metric; TOLERANCE 1%; MANUFACTURER_PART_NUMBER ERJ-2RKF1002X; DIGIKEY_PART_NUMBER P10.0KLCT-ND
U34, U35: TPS61094DSSR; SON50P300X200X80-13N; MANUFACTURER_PART_NUMBER TPS61094DSSR; DIGIKEY_PART_NUMBER 296-TPS61094DSSRCT-ND
U67: LMV393; MANUFACTURER_PART_NUMBER LMV393IDGKR; DIGIKEY_PART_NUMBER 296-13993-1-ND

Connections:
3V3: C88.1, C89.1, U34.4 (VIN), U35.4 (VIN); also elsewhere on the board
3V3_STM: R239.1, R241.1, R242.1, R246.1; also elsewhere on the board
5V: FB11.2; also elsewhere on the board
BKP_GPS_PG: R238.2, R241.2, U67.1; also elsewhere on the board
BKP_STM_PG: R245.2, R246.2, U67.7; also elsewhere on the board
GND: C88.2, C89.2, C90.2, C91.2, C92.2, C93.2, C94.2, C95.2, C96.2, C97.2, C189.2, C190.2, C191.2, C192.2, R112.2, R113.2, R114.2, R115.2, R116.2, R117.2, R240.2, R243.2, U34.7 (PGND), U34.8 (AGND), U34.13 (EXP), U35.7 (PGND), U35.8 (AGND), U35.13 (EXP), U67.4 (V-); also elsewhere on the board
GPS_VBAT: C92.1, C94.1, C96.1, R108.1, R110.1, U34.9 (VOUT), U34.10 (VOUT__1); also elsewhere on the board
unnamed: R108.2, U34.3 (EN)
unnamed: R114.1, U34.11 (ICHG)
unnamed: R110.2, U34.2 (MODE)
unnamed: R116.1, U34.1 (OSEL)
unnamed: C90.1, L4.2, R237.1, U34.6 (SUP)
unnamed: L4.1, U34.5 (SW)
unnamed: R112.1, U34.12 (VCHG)
unnamed: R109.2, U35.3 (EN)
unnamed: R115.1, U35.11 (ICHG)
unnamed: R111.2, U35.2 (MODE)
unnamed: R117.1, U35.1 (OSEL)
unnamed: C91.1, L5.2, R244.1, U35.6 (SUP)
unnamed: L5.1, U35.5 (SW)
unnamed: R113.1, U35.12 (VCHG)
unnamed: C190.1, R237.2, R238.1, U67.3 (+)
unnamed: R239.2, R240.1, U67.2 (-)
unnamed: C192.1, R244.2, R245.1, U67.5 (+)
unnamed: R242.2, R243.1, U67.6 (-)
unnamed: C189.1, C191.1, FB11.1, U67.8 (V+)
STM_VBAT: C93.1, C95.1, C97.1, R109.1, R111.1, U35.9 (VOUT), U35.10 (VOUT__1); also elsewhere on the board

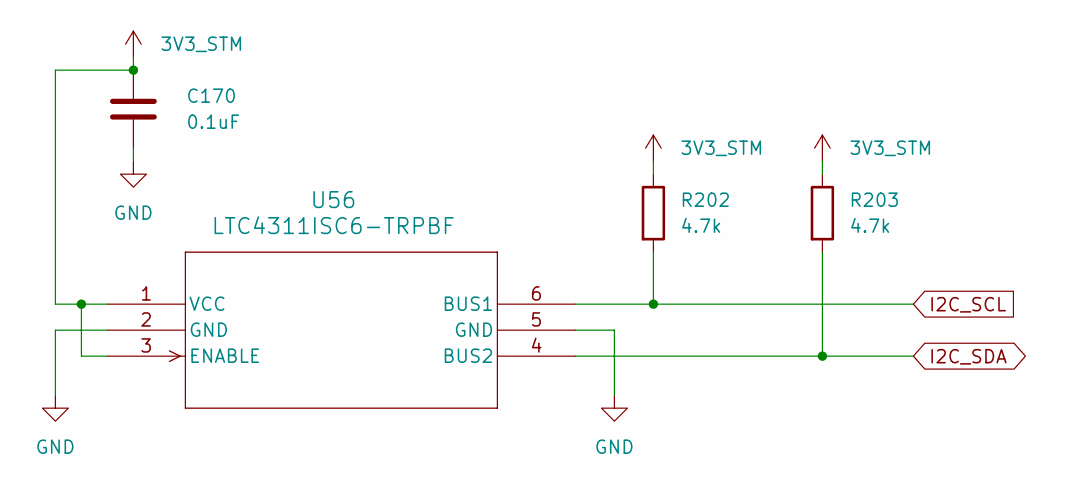
[picture p22: schematic i2c-buffer.kicad_sch]

Parts:
C170: 0.1uF; C_0402_1005Metric; TOLERANCE 10%; VOLTAGE 16V; MANUFACTURER_PART_NUMBER GCM155R71C104KA55D; DIGIKEY_PART_NUMBER 490-4759-1-ND
R202, R203: 4.7k; R_0402_1005Metric; TOLERANCE 1%; MANUFACTURER_PART_NUMBER ERJ-2RKF4701X; DIGIKEY_PART_NUMBER P4.70KLCT-ND
U56: LTC4311ISC6-TRPBF; SOT-6_SC_LIT; MANUFACTURER_PART_NUMBER LTC4311ISC6#TRPBF; DIGIKEY_PART_NUMBER LTC4311ISC6#TRPBFCT-ND

Connections:
3V3_STM: C170.1, R202.1, R203.1, U56.1 (VCC), U56.3 (ENABLE); also elsewhere on the board
GND: C170.2, U56.2 (GND), U56.5 (GND); also elsewhere on the board
I2C_SCL: R202.2, U56.6 (BUS1); also elsewhere on the board
I2C_SDA: R203.2, U56.4 (BUS2); also elsewhere on the board

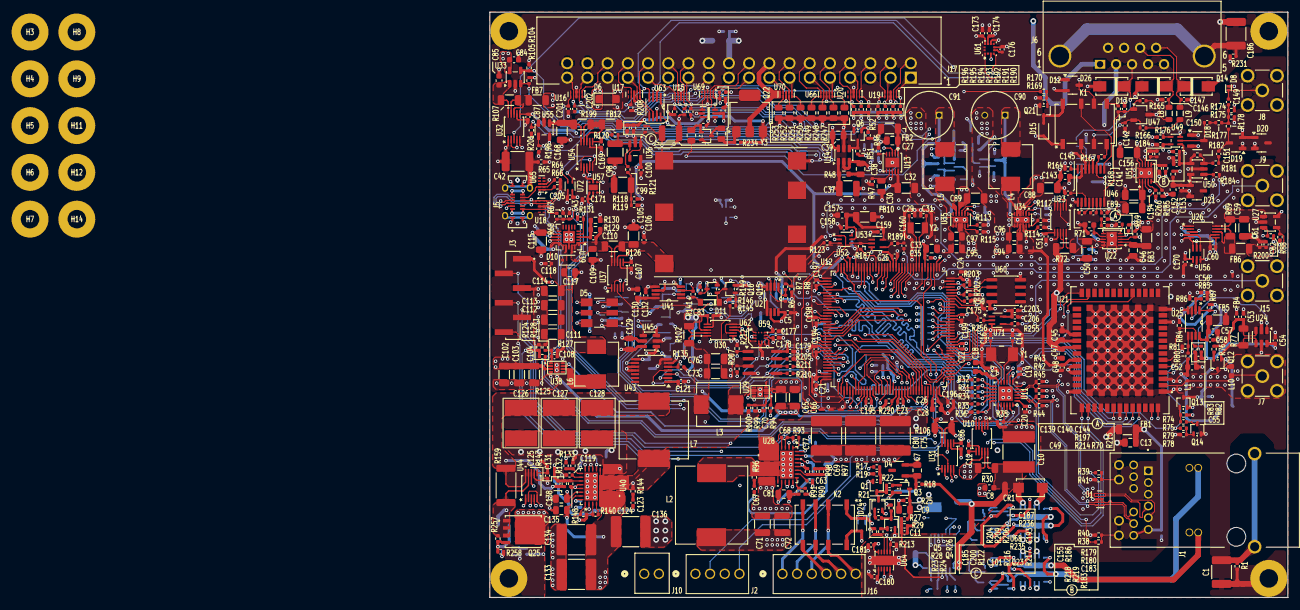
[picture p23: board ntp-server-stm32.kicad_pcb from above]

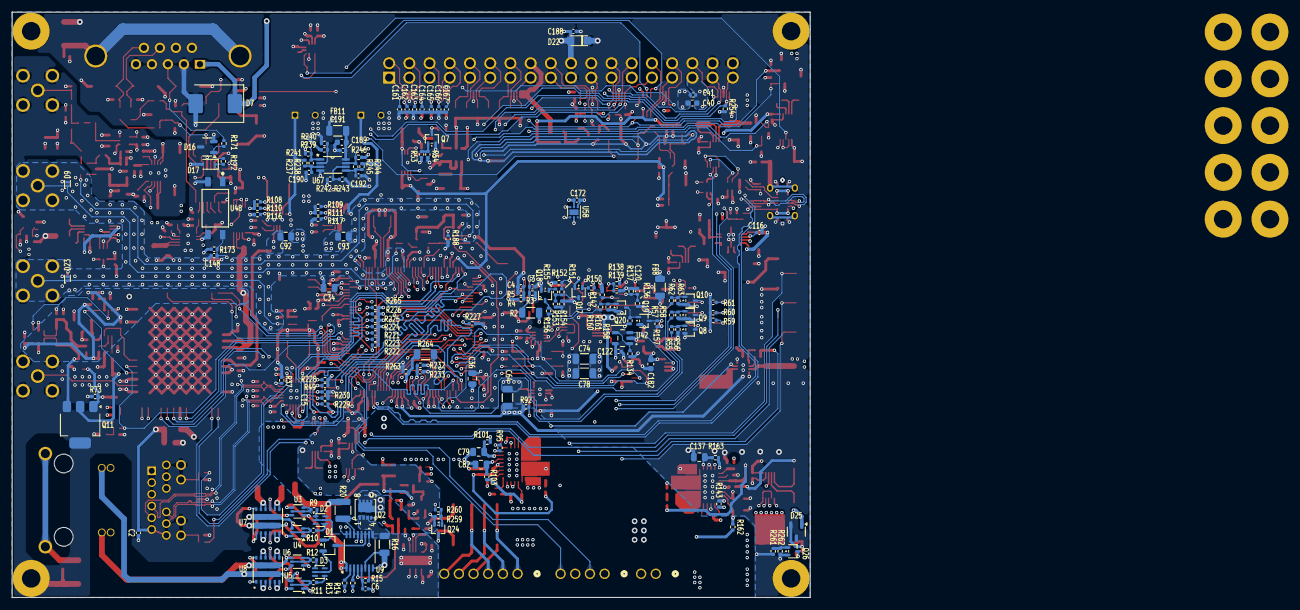
[picture p24: board ntp-server-stm32.kicad_pcb from below]

Board: 6 copper layers, 138.2 x 101.3 mm, 648 parts (161 on the bottom side), 387 nets.
