rcldesign/ntp-server-stm32/(commit log)

2026-06-21 initial schematic
    [3v3-main-power.kicad_sch, PoE.kicad_sch, batt-supplies.kicad_sch, clock-mux.kicad_sch, connectors.kicad_sch, ethernet-input.kicad_sch, ethernet-phy.kicad_sch, gps-antenna.kicad_sch]
2026-06-21 Standardize net/rail names: plain 3V3 style, _N active-low, voltage-format PG/alerts
    22 net renames applied across all sheets and verified: removed/added net-name
    sets match intent exactly and all node connectivity is preserved (kicad-cli
    netlist re-parse).
    [3v3-main-power.kicad_sch, PoE.kicad_sch, batt-supplies.kicad_sch, clock-mux.kicad_sch, connectors.kicad_sch, ethernet-input.kicad_sch, ethernet-phy.kicad_sch, gps-antenna.kicad_sch]
2026-06-21 Standardize + complete BOM; write fields back into KiCad symbols
    - New sts1000_bom.csv: rebuilt from authoritative Value field (source MPN/footprint/
    description were corrupted by copy-paste). 338 standardized, 78 MPN-from-value,
    50 kept, ~64 flagged (SELECT/REVIEW-HV/SHUNT-REVIEW) each with full spec.
    - Resistors -> deterministic Panasonic ERJ-2RKF 0402 1% 1/10W (consolidated 1 part/value).
    - Caps -> verified Murata GRM parts where value matches; clean spec + footprint otherwise.
    - 1633 symbol field updates (Value/Footprint/Description/MPN/Mfr/Digikey) written to
    .kicad_sch; netlist re-parse confirms connectivity byte-identical.
    - Add docs/sts1000_net_naming.md naming reference.
    Co-A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
    [3v3-main-power.kicad_sch, PoE.kicad_sch, batt-supplies.kicad_sch, clock-mux.kicad_sch, connectors.kicad_sch, ethernet-input.kicad_sch, ethernet-phy.kicad_sch, gps-antenna.kicad_sch]
2026-06-21 BOM: fix precision/sense resistor detection; add BOM status doc
    Detect precision/sense resistors by value-tag + MPN series instead of the
    corrupted Description field (R210/R211 22-ohm series resistors were false-flagged).
    Add docs/sts1000_bom.md with standardization rules + sourcing-decision list.
    [PoE.kicad_sch, spi-peripherals.kicad_sch, sts1000_bom.csv]
2026-06-21 Update subsystem docs to current designators + standardized net names
    clock-mux, rf-frontend, gnss-antenna, vcc-rb, rb-rs232, fault-aggregation,
    3v3p-i2c-peripherals, external-wdt, usb-console, panel-switch/ui-esd, poe-kill,
    power-fail, rgb-indicator. Designators remapped by netlist connectivity; net/rail
    names standardized. Ambiguous passives flagged with TODO comments.
2026-06-21 Update master docs (peripheral_map, software_spec, checklist, CLAUDE.md x3)
    Current designators + standardized net names. Corrects MCP23017 mapping per
    netlist straps: U54=0x21/MIRROR=0 (buttons/INA-alert/touch), U55=0x20/MIRROR=1
    (power-good). INA228 address map annotated with designators.
2026-06-21 Add schematic error/consistency review; index new docs
    Netlist-verified findings: INA_ALERT_N dangling (MCU blind to alert wire-OR),
    USB VBUS sense divider mis-wired (~5V into 3V3 ADC), duplicate DISP_TOUCH_INT
    pull-up, GPS SMA missing ESD vs house TPD-array style, plus doc-vs-as-built
    deltas and reliability items. Index net-naming/BOM/error-review docs in CLAUDE.md.
2026-07-26 bom updates
    [ocxo.kicad_sch, rb.kicad_sch, refclock-input.kicad_sch]
2026-07-27 Add files via upload
    We are doing collect footprint. We make outline board. We sent current pcb
    [ntp-server-stm32.kicad_pcb]
2026-07-29 Add files via upload
    current placement
    [ntp-server-stm32.kicad_pcb]
2026-07-30 Add files via upload
    Updated, completed placement
    [3v3-main-power.kicad_sch, PoE.kicad_sch, batt-supplies.kicad_sch, clock-mux.kicad_sch, connectors.kicad_sch, ethernet-input.kicad_sch, ethernet-phy.kicad_sch, gps-antenna.kicad_sch]
2026-08-06 Add files via upload
    Completed PCB
    [ntp-server-stm32.kicad_pcb]
2026-08-07 PCB / 3D updates
    [3v3-main-power.kicad_sch, clock-mux.kicad_sch, connectors.kicad_sch, ntp-server-stm32.kicad_sch]
